2AMLogic/gf180-tmds-tx/signoff/README.md

# Signoff — the block's graded T1 verdict of record

This directory is this repo's **machine-graded** answer to "what is the gap
to T1", produced by `klt signoff --manifest` against the
[klayout-tools design-evidence tier ladder](https://github.com/2AMLogic/klayout-tools/blob/main/docs/design-evidence-tiers.md).
It replaces the hand-maintained checkbox list that used to live in gap-to-T1
tracker issue #17: that issue now points here, and the manifest graded in
`signoff/signoff.json` is the **verdict of record**. Per
`CLAUDE.md`'s evidence rule ("no claim without a testbench"), a prose
checklist nobody re-reads is not a verdict; this is.

## The current verdict (don't hand-transcribe — read the record)

`signoff/signoff.json` is the byte-for-byte stdout of

```bash
klt signoff --manifest signoff/manifest.json --format json
```

as emitted by the graded build pinned below. Exit code `3` is the tool's
documented "rendered but not T1" signal, not an error: `tier` is `null`
until every T1 item is met, which is the honest state for this block today.
As of this commit the grade is **17/22 T1 items met** (per-partition rows,
11 checklist items × `kind: mixed-signal`'s two partitions):

| met | why (the record's own reason, where unmet) |
| --- | --- |
| #3 DRC clean — analog + digital | `klt drc` `status: clean`, layout hash pinned, on both partitions |
| #4 LVS clean — analog + digital | `klt lvs` `status: match` (regenerated 2026-09-21 under the pinned build; identical 0-error verdicts), layout-hash pinned, `input_verified: true` |
| #8 characterization report — analog + digital | the hand-rolled `kind: "generic"` wrapper over `measurements/characterization.md`, its `content_hash` pinned in both the manifest and the envelope |
| #11 power delivery — analog | **`met`** (issue #210, after #207's `unmet` / `supply_not_continuous`). `11.analog` = `layout/erc_reports/gf180_tmds_pad_ring_assembly.erc.json` + the item-4 LVS report, both pinned to the assembly GDS hash. The DVDD ring strap now carries a `VDD` label at two Nwell taps and is tied to real devices (a `diode_pd2nw_06v0` VDD-side clamp per output pad); the ERC report has zero findings, `VDD` and `VSS` each one island, and both `nwell_vdd_tap` and `substrate_vss_tap` checked (none skipped); the LVS reference carries `VDD` and the report pairs it in `net_correspondence`. `VDD` stayed declared throughout — it was neither omitted nor relabelled to turn the row green; the row moved because the geometry and the reference now carry the supply. The ERC reports were produced by a newer `klt` than the pin (the pin cannot produce `well_layer: null` specs) and read by the pinned build; see `../layout/README.md`, "T1 item 11 (analog)" |
| #11 power delivery — digital | **`met`** (issue #206). `klt erc` on `layout/erc-supply-spec.json` now declares both well ties: `erc_finding_count 0`, `erc.missing_tie` for `nwell_vdd_tap` and `lvpwell_vss_tap` both checked and none skipped, pinned to the committed GDS hash. Branch that graded it: **no place-and-route citation, so the PDN branch is not selected** (`power_delivery.pdn: false`; this block's P&R is `flow/pnr_tmds_encoder.py` driving OpenROAD directly and has no `klt place-and-route` response to cite, and none is fabricated). The grader instead takes the ERC + LVS pair: the cited LVS report is the SPICE-reference `layout/lvs_reports/tmds_encoder.lvs.json` (`power_connectivity: unchecked`, but its reference carries `VDD`/`VSS`, `supply_nets` `["VDD","VSS"]`), which suffices on that branch. The gate-level `tmds_encoder_gate.lvs.json` (`match`) is not the cited report |
| #1 design sources — analog + digital | **`met`** via `klt signoff --attest 1` envelopes (`envelopes/item1-{analog,digital}.json`) pinning versioned inventories (`attest/item1-*.json`): each source is present and each derived netlist passes its freshness check. Analog: the xschem schematics/symbols and `design/netlist/*.spice`, stamped after `klt netlist --check` (xschem 3.4.4) matched. **Digital is weaker, and says so:** the encoder RTL and its `.synth.v`/`.pnr.v` netlists are hash-stamped, but Yosys/OpenROAD were *not* re-run (std-cell library absent on the stamping host); the pins rest on flow record `20260817-110611-37e197a`. `rtl/tmds_serializer.v`/`tmds_tx_lane.v` are listed sources with no synthesized netlist (DR-0014). See "Item 1 freshness" below |
| #2 layout — analog + digital | **`met`** via artifact-anchored generic envelopes bound to the committed GDS (`envelopes/item2-{analog,digital}.json`); the row stays `met` only while the stream re-hashes to its pin. **No regeneration claim is made** for either: re-running `gen_pad_ring_assembly.py` gives a different file hash (the GDS header carries a write timestamp) but an empty per-layer XOR; the digital merge step was not re-run (provenance is `layout/README.md`'s documented P&R determinism). The envelopes disclose this |
| #9 testbenches — analog + digital | **`met`** via `klt signoff --attest 9` (`envelopes/item9-{analog,digital}.json`): every `sim/*/testbench` fragment (resp. `verification/*` bench and negative control) is present, the cold-start command exits 0, and the PDK (`gf180mcuD` @ open_pdks `c6d73a35…`) and tool versions are pinned. The analog cold start is `sim/run_corners.py --list` (manifests load); the PVT sweeps need the PDK and ngspice and are **not** re-run — their results are the append-only `sim/*/records/` |
| #10 repo hygiene — analog + digital | **`met`** via `klt signoff --attest 10` (`envelopes/item10.json`, cited for both partitions): README, spec, LICENSE and CI workflow present; `lint.sh` (shellcheck + append-only required) and the two unit-test suites exit 0 |
| #5 corner verification — digital | **`met`** (issue #228). `flow/tmds_encoder/klt_sta.json` is one `klt sta` response over the committed routed DEF + post-route SPEF at all five 3.3 V corners (`pdk.corners`), 720p60 clock (13.4680 ns), zero I/O delay: every corner `timing_status: "constrained"`, setup WNS from +0.281 ns (`ss_125C_3v00`) up, hold WNS from +0.403 ns (`ff_n40C_3v60`) up, `input_verified: true`. Regenerate with `flow/klt_sta_tmds_encoder.py` (its docstring states the one path normalisation applied). Three disclosed limits: (1) `klt sta` cannot express `set_propagated_clock`, `set_driving_cell` or `set_load`, so it does not reproduce `flow/sta_tmds_encoder.py`'s full SDC; the slowest-corner setup slack nonetheless lands within 2 ps of that flow's record (+0.2799 ns); (2) its `spef_annotation` reports `annotation_complete: false` (0 of 377 design nets matched by name) — read the numbers with that in mind; (3) under `klt` 0.8.0 the grader takes several citations for item 5 and requires both kinds, so the zero-delay functional run (`flow/tmds_encoder/klt_fv_zero_delay.json`, 3/3 pass, generated by `flow/klt_fv_tmds_encoder.py`) is now cited alongside the `sta` report (it records no input hash, so the manifest pins its file only). Tool gaps filed as klayout-tools#3741 (one citation) and #3742 (sta constraints / annotation) |
| #7 post-layout — digital | `no_evidence`. `klt functional-verification` with `options.sdf` aborts `vvp` (`NULL handle passed to vpi_scan`) on this netlist + post-route SDF (zero-delay run of the same sources passes; the repo's own `$sdf_annotate` loader in `flow/gate_level_sim_tmds_encoder.py` also passes, but its Markdown record is not a `klt` envelope). Filed as klayout-tools#3740; nothing fabricated to fill the row |
| #6 statistical claims — digital | **`not_applicable`** (issue #296), not `met`: the digital partition has no statistical spec row. `klt` 0.8.0's recorded `not_applicable` form cites `signoff/digital-spec.json` (ratified rows from `spec/tmds-tx.md` §1, DR-0003, DR-0008/DR-0009 and DR-0016) and the statement `signoff/item6-digital-na.json` (one `{id, class, reason}` entry per row), both content-hash pinned in the manifest's `6.digital` entry. The grader's statistical scan passed without any row being reworded. Corner-bounded rows point at item 5.digital; functional rows at `verification/tmds_encoder`. Counted as `t1_not_applicable_count: 1`; `t1_met_count` unchanged |
| #5 (analog), #6 (analog), #7 (analog) | `no_evidence` — the analog corner/Monte-Carlo/post-layout evidence in `sim/` and `flow/` is committed as this repo's own Markdown evidence records, which are not `klt sim`/`klt yield`/`klt pex` JSON envelopes and are rejected by the grader regardless of how sound they are. The grading gap (not the engineering gap) is real and named: see "Why some genuinely-passed work grades unmet" below |

## Partition boundary (the `kind: "mixed-signal"` declaration)

Per `design-evidence-tiers.md`'s "Block kind" subsection, a mixed-signal
claim must state explicitly which silicon each partition's evidence covers:

- **analog partition** — the full-custom CML line driver and the pad ring:
  the driver core (xschem `design/cml_driver.sch` →
  `layout/gds/cml_driver_core.gds`) assembled with the production pad cells
  and `diode_nd2ps_06v0` / `diode_pd2nw_06v0` ESD clamps into
  `layout/gds/gf180_tmds_pad_ring_assembly.gds` — the artifact the
  `*.analog` citations grade. Per-cell signoffs (DRC/LVS/extract report
  pairs with negative controls) and the analog measurement records
  (`sim/cml-driver-*`, `sim/esd-*`) live under `layout/` and `sim/` as
  before.
- **digital partition (RTL flow)** — the synthesized `tmds_encoder`:
  `rtl/tmds_encoder.v` → Yosys → OpenROAD P&R →
  `layout/gds/tmds_encoder.gds`, verified by `verification/tmds_encoder/`
  and `flow/tmds_encoder/` — the artifact the `*.digital` citations grade.
  The `rtl/tmds_serializer.v` reduction stage is RTL in the same flow, with
  its own cocotb bench (`verification/tmds_serializer/`).
- **full-custom digital sub-case** — `tmds_final_mux` (DR-0003's custom
  final 2:1 DDR multiplexer) is *not* synthesized RTL: it is captured as a
  schematic and hand-composed GDS (`design/tmds_final_mux.sch` →
  `layout/gds/tmds_final_mux.gds`), exactly the "Full-custom digital
  sub-case" `design-evidence-tiers.md` defines — its artifacts satisfy the
  analog *column*'s shapes (schematic + GDS + DRC/LVS pairs with negative
  controls) while its silicon belongs to the digital side of the signal
  chain. The manifest's per-partition citations name each partition's
  top-level artifact (the assembled analog signal path, the routed
  encoder); the final mux's own committed signoff pair remains under
  `layout/` and — like every drawn cell's — is machine-checked by the lint
  job's `check_lvs_signoff.py` step on every push.

The partition boundary in the signal chain is the serializer → final-mux →
CML-driver handoff into the pad ring's OUTP/OUTN pair;
`spec/tmds-tx.md`'s decision records (DR-0009, DR-0003, DR-0002) are the
authoritative signal-path description. This manifest's job is narrower:
to state which committed evidence covers which silicon.

## Files

| file | what it is |
| --- | --- |
| `manifest.json` | The block manifest: `block` (fleet-rollup identity for 2AMLogic/2am#956, which consumes exactly this file), required `kind: "mixed-signal"`, and the per-item `evidence` citations with pinned `content_hash` on every one |
| `signoff.json` | The committed evidence record — `klt signoff --format json` output, byte-for-byte as the graded build emitted it |
| `characterization-envelope.json` | Item 8's `kind: "generic"` wrapper (the only T1 item with no `klt` verb), asserting `measurements/characterization.md`'s own verdict — **generated** by `gen_characterization_envelope.py`, never hand-edited |
| `attest/item{1,9}-{analog,digital}.json`, `attest/item10.json` | The versioned attestation inventories `klt signoff --attest` reads (schema `t1-attestation-inventory`); the envelope pins each inventory's raw-byte hash |
| `envelopes/item{1,9,10}*.json` | **Tool-produced** attestation envelopes (`klt signoff --attest N --inventory … -o …`). Never hand-edit |
| `envelopes/item2-{analog,digital}.json` | Artifact-anchored generic envelopes bound to each partition's committed GDS (no producer verb for item 2; written by hand, graded by re-hashing the stream) |
| `derived_stamps.py`, `derived-stamps.json` | The toolchain-free item-1 freshness tripwire (below) |
| `gen_characterization_envelope.py` | Regenerates that envelope deterministically from the committed report; `--check` is the CI mode (the same convention lint step 4 uses for generated DUTs) |
| `../layout/erc-supply-spec.json`, `../layout/drc_reports/`, `../layout/lvs_reports/`, `../layout/erc_reports/` | The cited envelopes. Every manifest citation pins the envelope's own recorded input `content_hash`, and the grader re-hashes the artifact where the envelope names a path (`input_verified: true` on the regenerated LVS citations) |

## The pinned grading build

`klt signoff --manifest`'s grading rules come from the running `klt`
binary, and the eleven-item checklist (item 11, "Power delivery
(structural)", was added 2026-09-17 by klayout-tools#2025) is only graded by
builds newer than the PyPI `0.5.0` release (`0.8.0` grades it). The record's `build` block names
the exact grading code, so the pin is auditable:

- **pin**: `klayout-tools==0.8.0` (PyPI; `klt 0.8.0`, tag `v0.8.0`, commit
  `c572046be644`, `build.is_release: true`; `grading_ruleset_id
  sha256:46c446d84423b7399ee1cf957b3d49801ae4f42a0bda53da92f435776cf977c4`).
  A release pin is preferred over a git pin: a git build reports a dev version
  and no longer satisfies `==0.8.0` (klayout-tools#2823). CI asserts
  `klt --version` prints `klt 0.8.0`. The artifact-anchored generic envelope
  (klayout-tools#2718) and `klt signoff --attest` (klayout-tools#2844) both
  need a build at least this new; the previous pins (a dev-commit
  build after 0.7.0, and before it `e8ca621a`) were git builds
- **Why not PyPI `0.5.0`?** Its bundled tier doc predates item 11, so it
  renders no item-11 row at all, and its grading engine lacks the compound
  erc/lvs/power rules item 11 needs. `--tiers-doc` plus `--describe-grader`
  (see klayout-tools `docs/cli/signoff.md`'s "Identifying the grading
  build") exist to make that divergence visible, but grading against a
  pinned build that actually knows all eleven items is the honest option.
- **Bumping the pin**: when klayout-tools ships a release that changes grading, update the pinned ref below (and in the CI job), re-run the
  regeneration command, and commit the fresh `signoff.json` in the same
  change so the record and the grader never disagree. CI (below) fails the
  build otherwise.

## Regenerating the record

```bash
python3 -m venv .venv-klt && .venv-klt/bin/pip install \
  "klayout-tools==0.8.0"
.venv-klt/bin/pip install -r verification/tmds_encoder/requirements.txt -r verification/tmds_serializer/requirements.txt
export PATH="$PWD/.venv-klt/bin:$PATH"
python3 signoff/gen_characterization_envelope.py   # if item 8's input changed
python3 signoff/derived_stamps.py --refresh        # if a design source/netlist moved (runs klt netlist --check)
klt signoff --attest 1  --inventory signoff/attest/item1-analog.json  -o signoff/envelopes/item1-analog.json    # and the other four
klt signoff --manifest signoff/manifest.json --format json > signoff/signoff.json
# exit 0 (T1) or 3 (rendered, not T1) are both fine; 1 means a malformed
# manifest — fix it, do not commit the error envelope.
```

If a regenerated envelope's recorded input hash moved, sync the manifest's
`content_hash` pin for that item to the new envelope's value in the same
change (a stale pin renders `stale_evidence`, never a false pass).

Run from the repo root: file-backed evidence paths resolve against the
invoking process's working directory (the same convention
klayout-tools `examples/signoff/` documents).

## CI: the record cannot rot

The `signoff` job in `.github/workflows/ci.yml` re-attests items 1, 9 and 10
(`klt signoff --attest N --inventory … --check <envelope>`, which re-runs every
declared command and exits 3 on any drift of an inventory, an inventoried file,
a check outcome or the envelope), runs `derived_stamps.py --check`, then
re-grades the manifest with `klt signoff --manifest … --check signoff/signoff.json`
against the committed record (that mode ignores the `build` block, which names
the install rather than the commit). Anything that would silently invalidate a
published verdict instead breaks the build:

- **a cited artifact changes** (a regenerated GDS, an edited LVS envelope) —
  either the citation's pinned `content_hash` no longer matches the
  envelope's (the item flips `met` → unmet, `stale_evidence`), or the
  envelope no longer matches the artifact on disk (`input_verified` flips
  to `false` in the record, the #2196 disclosure the grader re-hashes for
  native kinds); both change the record bytes, so the byte-compare fails;
- **`measurements/characterization.md` changes** — `klt signoff` never
  re-hashes a generic citation's input (its provenance field names are the
  author's choice by contract), so the same gate is enforced one link
  earlier and mechanically: `python3 signoff/gen_characterization_envelope.py
  --check` fails until the envelope is regenerated (which itself flips the
  item-8 pin to `stale_evidence` until the manifest follows, then the record);
- **the manifest cites something new or drops a citation** — the verdict
  rows themselves change, same failure;
- **the checklist or grader changes under the pin** — `source_doc_content_hash`
  and the `build` block change, same failure.

Fixing it is always the same sequence: regenerate the affected `klt`
envelope(s) under the pinned build (see `layout/README.md` for each cell's
commands), refresh the manifest's pins, re-run the regeneration command, and
commit record + evidence together. Never hand-edit `signoff/signoff.json` —
it is grader output or it is nothing.

## Item 1 freshness: what CI can and cannot prove

`attest/item1-*.json` declare, per derived netlist, a freshness `check`. CI has
no xschem, no PDK and no std-cell library, so that command is
`derived_stamps.py --check --only <row>`: a stdlib hash tripwire over
`derived-stamps.json`, which pins every source and derived file. It fails when
a source or netlist moves without a re-stamp. It does **not** prove the netlist
equals what its generator emits today; that is established when the stamp is
written, by each row's `check_argv` (`klt netlist --check` for the analog rows,
run by `derived_stamps.py --refresh`). The two digital rows have
`check_argv: null` (Yosys/OpenROAD could not be run on the stamping host), so
`--refresh` refuses to re-pin them without `--include-unverified`, and each
row's `basis` field says what its pin rests on. Re-stamp from a host that has
the toolchain and re-run the real flow before relying on those rows.

## Why some genuinely-passed work grades unmet

The grader only recognizes `klt`-native JSON envelopes. This repo's analog
evidence (per-corner sweeps, Monte Carlo, post-layout eye sims) is committed
as `sim/*/records/*.md` evidence records under the append-only
`sim/README.md` schema, and the digital pipeline's records live under
`flow/tmds_encoder/records/` — none of which are `klt sim`/`klt yield`/`klt
pex` envelopes. Items 5, 6 and 7 therefore read `no_evidence` here even
where the engineering is done and recorded. That is the gap being named, not
a verdict that the evidence is unsound: the record says "no `klt` envelope
backs this item", which is true. Closing those rows in *this* artifact means
producing the missing envelope kinds (e.g. a `klt pex` run for item 7) —
separately scoped work in the tracker, not a manifest edit.

## Provenance notes for the reader

- **DRC citations show `input_verified: null`.** The committed `klt drc`
  envelopes were produced by klt 0.2.0/0.3.0-era builds, which recorded the
  layout `content_hash` in `provenance.input` without a resolvable file
  path — the grader re-hashes only what an envelope names, so it reports
  "nothing was re-hashed" (`null`) rather than fabricating verification.
  The pinned layout hashes were verified against the committed GDS files at
  manifest-commit time and match (see the manifest pins; re-checkable with
  `sha256sum layout/gds/*.gds`).
- **LVS envelopes cited here were regenerated 2026-09-21** under the pinned
  build, because the previously committed envelopes (klt 0.3.0) recorded
  their input hash in `environment.layout_sha256` rather than
  `provenance.input`, which post-#1969 builds (and this manifest's pinned
  citations) require — a pinned citation against the old shape renders
  `unverifiable_provenance` no matter how sound the report is. The
  regeneration reproduced the committed verdicts exactly (`match`, 0 errors,
  the pad ring's same 2 warning-only topology findings; the encoder side
  0 findings). Envelope delta vs the committed pair is additive only:
  `provenance.input`, `power_connectivity` (`unchecked`, plain-element
  reference — "does not apply" per the grader's own note), `body_verification`,
  `supply_nets` echo. Deck `content_hash` moved
  `79e71a1e…` → `95c2eb91…` and the resolved KLayout engine reported
  `0.30.12` (the pinned build was tested against `0.30.10` — "verdict
  itself is unaffected" per the tool's own warning); both are tool-side
  churn, recorded here rather than left for the next reader to rediscover.
  The `_shorted`/`_negctl` negative-control reports are untouched and
  still guard the same verdicts via `layout/scripts/check_lvs_signoff.py`.
