2AMLogic/gf180-tmds-tx/design/esd-capacitance-budget.md

# ESD clamp sizing vs. the DR-0005/DR-0011 capacitance budget — a measurement study

Status: measurement study, originally for issue #12 (2026-08-14 operator
ruling on that issue), **redesigned and re-measured for issue #87**
(2026-08-19) against DR-0011's ratified pad/ESD strategy. **Not a decision
record and makes no change to `spec/`.** Per the original operator
guardrail (still honoured here — issue #87's own guardrails restate it: "no
spec edits"), this document reports whatever the real, measured numbers say
and does not revise DR-0005/DR-0011 to make them work; it happens that,
once a real-size pad and a real DR-0011-ratified diode clamp are actually
drawn and measured (Sec.9), the numbers close the budget on their own —
that is a measurement result, not a relaxation.

**2026-08-19 (issue #87) headline correction, read this first**: Sec.4b's
original "realistic 25×25 µm pad" figure below — reported as **6.36–7.13
pF**, driving the document's original **7.95 pF** total and its "no
intersection" verdict — carried a **units-label error**: the arithmetic
itself (in `aF`, the PDK tech file's own native unit) was correct, but its
final line divided by 1,000 (`aF`→`fF`) and then wrote the answer as
**`pF`** instead of `fF`, overstating every headline figure in Sec.4b/5 by
**exactly 1000×**. **Sec.9.1** below shows the correct arithmetic and an
independent, real `klt extract --parasitics` measurement against an
actually-drawn 25×25 µm Metal5 pad (not available when this document was
first written) that confirms the corrected value to within 0.02%: the real
figure is **6.36–7.13 fF** (0.00636–0.00713 pF), not pF — roughly three
orders of magnitude *under* the 2 pF budget, not 3.2–3.6× over it. Sections
0–8 below are preserved verbatim as the historical record of that
measurement study and its (mistaken) conclusion; they are superseded by
Sec.9's correction and redesign, not deleted, per this directory's
evidentiary conventions. **Sec.9 is this document's current, authoritative
verdict** — read it for the issue #87 redesign result.

## 0. What this document answers, and what it does not

DR-0005 (`spec/tmds-tx.md`) sets two targets and explicitly declines to
show they are simultaneously achievable:

- **ESD**: HBM ≥ 2 kV (JEDEC JS-001), CDM ≥ 500 V (JEDEC JS-002).
- **Pad capacitance**: ≤ 2 pF per data/clock pad, *"ESD diodes + pad
  parasitic combined"*.

The 2026-08-14 operator ruling on issue #12 narrows the original four-part
architect proposal to exactly this: size the ESD clamp **that is actually
drawn** on the real pad cell from issue #2
(`layout/gds/gf180_tmds_pad_min.gds`) against the HBM/CDM targets, measure
the resulting pad-node capacitance (clamp + real Metal5 pad) against the
2 pF budget, and report a verdict. The clamp on that cell is a
grounded-gate NMOS (GGNMOS), not the diode primitives DR-0005's original
text named — `spec/pad-ring-esd-survey.md` §4 explains why (`klt`'s
gf180mcu extraction deck has no diode device class,
[2AMLogic/klayout-tools#541](https://github.com/2AMLogic/klayout-tools/issues/541)),
and the operator ruling settles the device-family question directly from
the real, already-built cell rather than waiting on a separate
decision-record issue.

**Out of scope here** (per the ruling): a `gf180mcuC`-vs-`gf180mcuD` metal-
stack comparison curve, a formally uncertainty-budgeted pad-parasitic
estimate, and redesigning the clamp device family. This document does not
attempt any of those.

**Verdict, up front** (derived in §5): the ESD side of the budget is easy
to satisfy — a clamp sized generously past JEDEC JS-001's 2 kV target costs
well under 1 pF at every PVT corner measured. The budget is not closed by
the clamp. It is closed, decisively, by the **pad's own parasitic
capacitance once any realistic bond-pad size is used** — a plain Metal5
plate at the PDK's own established 25×25 µm bond-pad-opening size already
costs 6.4–7.1 pF, more than three times the entire 2 pF budget, before any
clamp capacitance is added. Under the literal as-drawn pad geometry (a
0.62×1.00 µm via-landing square, not a real bond pad — `spec/pad-ring-esd-
survey.md` §4 flags this explicitly), the two targets *do* coexist with
large margin. **The honest, realistic-pad-size reading is a "no
intersection" result, and per the guardrail it is reported here rather
than used to revise DR-0005.**

> **Superseded 2026-08-19 (issue #87) — this verdict was a units-label bug,
> not a real result.** "6.4–7.1 pF" above should read "6.4–7.1 **fF**"; see
> the header correction and Sec.9.1 for the arithmetic and an independent
> real-tool measurement confirming it. The realistic-pad-size reading is,
> correctly measured, a **large-margin PASS**, not a "no intersection" —
> Sec.9 is the current verdict.

## 1. Establishing the simulatable device (blocking step, per the issue)

### 1a. Sizing interpretation

The real pad cell's clamp is drawn at `L=0.4U W=2U`
(`layout/gds/gf180_tmds_pad_min.spice`, `layout/lvs/gf180_tmds_pad_min.ref.spice`)
— below the PDK's own `ESD.pl` rule, a 0.8 µm minimum gate length for a
"5V/6V gate NMOS" ESD device (`spec/pad-ring-esd-survey.md` §2, citing
`libs.tech/klayout/tech/drc/rule_decks/esd.drc`). The cell also draws no
`Dualgate` implant layer at all (`layout/scripts/gen_pad_min.py` only
touches `Comp`/`Poly2`/`Nplus`/`Contact`/`Metal1-5`) — i.e. as drawn today
it is a plain 3.3 V-core-device-scaled NMOS wired as a GGNMOS, not a real
5V/6V ESD-implant device at all. `ESD.pl` strictly speaking governs the
latter, not the former.

**Interpretation used here**: re-size the clamp freely (both `W` and `L`),
keeping its topology (drain=`PAD`, gate=source=body=`VSS`) and its device
family (3.3 V core NMOS — see §1b for why no 5/6V-implant alternative is
available), but **grow `L` to the `ESD.pl` floor (0.8 µm)** as the closest
available PDK guidance for an ESD-role NMOS gate length, even though this
device does not carry the ESD-implant layer that rule technically
addresses. This is the more conservative of the two readings the issue's
curated body offered (either is acceptable) — it does not just accept the
under-`ESD.pl` `L=0.4 µm` as-drawn value for the sizing exercise. Every
device swept in this study (§3) other than the literal as-drawn baseline
uses `L=0.8 µm` for this reason.

### 1b. Model-card mapping

`layout/gds/gf180_tmds_pad_min.spice`'s extracted netlist and
`layout/lvs/gf180_tmds_pad_min.ref.spice`'s LVS reference both call the
device model `nfet` — `klt`'s internal LVS device-class label, not a
citable ngspice model card.

**Mapping used here: `nfet` → `nfet_03v3`**
(`libs.tech/ngspice/sm141064.ngspice:47042`, the PDK's 3.3 V core NMOS
subcircuit). Rationale:

- The cell as drawn carries no `Dualgate` layer (§1a), so electrically it
  is built from 3.3 V core-device layers, not the PDK's 5V/6V devices
  (`nfet_05v0`/`nfet_06v0`, `sm141064.ngspice:47099`/`:47125`) — mapping it
  to the 3.3 V model is the mapping that matches what is actually drawn,
  not an arbitrary default.
- `design/netlist/cml_driver.spice` (issue #11) already uses `nfet_03v3` at
  a comparable `L` scale for this block's other custom silicon, so this is
  a reused mapping decision, not a new one.
- The PDK ships **no** dedicated ESD-implant/ESD-clamp SPICE model at all —
  confirmed by grepping `sm141064.ngspice` for `esd`/`ggnmos`/`clamp`/
  `snapback`/`trigger`: zero matches. There is no more-specific citable
  model to prefer over `nfet_03v3` even if the sizing interpretation in
  §1a had gone the other way.

This mapping decision, and the `ESD.pl`-floor gate length from §1a, are
what every simulated result in §3 is measured against — stated and sourced
before any sweep result, per the issue's blocking-step requirement.

## 2. ESD sizing, honestly bounded (design-margin estimate, not qualification)

**This section is a design-margin estimate, not an ESD qualification.**
This repo has no tester and no parts; `measurements/` stays empty by
design until tape-out, per CLAUDE.md and the issue's own framing. Every
number below is either cited to a file/line in the installed PDK or
explicitly marked as drawn from general ESD-design literature, not the
PDK.

### 2a. What the PDK's own sources say (and are silent on)

- `libs.tech/klayout/tech/drc/rule_decks/esd.drc`'s `ESD.*` rules
  (`spec/pad-ring-esd-survey.md` §2) are real, checkable geometry rules for
  an ESD-implant-based device (minimum implant width/area, gate length,
  overlaps) — but say nothing about failure current, breakdown voltage, or
  snapback/trigger behavior.
- `libs.tech/ngspice/sm141064.ngspice` (the PDK's ngspice model library)
  has zero ESD-specific device models or parameters (§1b). Its BSIM4
  `nfet_03v3` model cards do carry a gate-oxide thickness
  (`toxe=8e-9` m, `sm141064.ngspice:795` in the `nfet_03v3.0` bin) usable
  for an order-of-magnitude gate-oxide-rupture estimate (§2c), but no
  drain-junction avalanche/secondary-breakdown current-density data, no
  TLP (transmission-line-pulse) I-V data, and no parasitic-BJT
  snapback/holding-voltage parameters — all of which a real GGNMOS ESD
  sizing exercise needs and which this PDK does not provide.
- **The PDK source is silent on ESD device failure behavior.** This
  extends explicitly to the GGNMOS clamp actually in use, per this issue's
  plan.

### 2b. HBM sizing (quantitative, current-density-based)

**Network**: JEDEC JS-001 human-body-model network — 100 pF charged to the
target voltage, discharged through a 1500 Ω series resistor into the DUT.
**Not sourced from the gf180mcu PDK** (which defines no ESD test networks
at all) — this is the JEDEC JS-001 standard's own fixed network, external
to this PDK.

**Peak current** (first-order estimate): `I_pk = V_HBM / R = 2000 V /
1500 Ω = 1.333 A`. This is the standard textbook first-order estimate
(peak of the idealized double-exponential HBM discharge waveform); a real
tester's waveform typically peaks somewhat below `V/R` because of finite
rise time, so `V/R` is the more conservative (larger, hence larger
required clamp width) of the two figures a first-order analysis would
produce.

**Failure threshold / current density**: the gf180mcu PDK is silent on
this (§2a). **Explicitly unsourced from the PDK**: this document adopts a
commonly cited range from general ESD-design literature for a salicided-
drain grounded-gate NMOS *without* a dedicated ESD implant — roughly
**2–6 mA/µm of drain width** HBM failure-current density (a range
frequently cited in ESD-design references such as Amerasekera & Duvvury,
*ESD in Silicon Integrated Circuits*, and Voldman, *ESD: Circuits and
Devices*; no specific edition/page is cited here because this document has
no access to page-level citation and is deliberately marking this as an
external, not-PDK-sourced assumption rather than presenting it as if it
had one). The clamp as drawn carries no ESD implant (§1a), so the
lower-robustness end of this range (without the ESD-implant improvement a
real `ESD.*`-compliant device would add) is the more defensible one to
design against.

**Required width**: `W = I_pk / density`:

| Assumed density | Required total width `W` |
|---|---|
| 6 mA/µm (favorable end) | 222 µm |
| 3 mA/µm (mid-range) | 444 µm |
| 2 mA/µm (conservative end) | 667 µm |

§3 simulates capacitance at 222 µm and 444 µm directly and reports 667 µm
by linear extrapolation (the simulated curve is effectively linear in
width — see §3c) rather than re-running the matrix a third time.

### 2c. Secondary constraint: clamping voltage (qualitative)

A complete first-order sizing also has to check that the clamp's *on-state
voltage drop* during the 1.33 A HBM pulse keeps the pad below the
breakdown voltage of whatever it protects (here: the gate oxide of any
other device tied to the same pad net). This requires the clamp's
on-resistance/holding-voltage during ESD conduction (parasitic-BJT
snapback behavior) — data this PDK does not provide (§2a). As an
order-of-magnitude cross-check only: `nfet_03v3`'s own `toxe=8 nm` gate
oxide, combined with a commonly cited SiO2 breakdown field of roughly
8–10 MV/cm (**general dielectric-breakdown literature, not the gf180mcu
PDK**), implies a rupture voltage on the order of 6.4–8 V for a directly
stressed gate — comfortably above a well-sized GGNMOS's typical few-volt
snapback holding voltage, but this document cannot verify the actual
clamping voltage without on-resistance/holding-voltage data the PDK does
not supply. **Marked explicitly as an unverified design-margin note, not a
result.**

### 2d. CDM — a turn-on/di-dt requirement, not a second peak-current number

Per the issue's plan, CDM 500 V (JEDEC JS-002) is treated as a different
kind of problem: a fast (sub-nanosecond), package- and tester-dependent
discharge that stresses the clamp's **turn-on speed** (how fast the
parasitic-BJT snapback triggers) far more than its average current
handling. A GGNMOS's CDM robustness is governed by trigger voltage and
turn-on delay, which require either TLP characterization or mixed-mode
TCAD data — neither of which the open gf180mcu PDK provides (§2a: zero
snapback/trigger parameters in `sm141064.ngspice`; no `ESD.*` electrical
data, only geometry rules, in the DRC deck). **This document reports no
CDM-driven width number.** "The source is silent" is the finding here,
exactly as the issue's plan anticipated as a legitimate outcome.

## 3. Clamp capacitance vs. size, at 0 V and at the TMDS operating bias, full PVT

### 3a. Testbench

`sim/esd-clamp-cv/testbench/esd_clamp_cv.spice` (manifest:
`sim/esd-clamp-cv/testbench/tb.json`). Twelve independent branches — six
device sizes × two DC bias states — each its own AC voltage source driving
its own `nfet_03v3` instance (drain=probed node, gate=source=body=`VSS`),
so one ngspice invocation per PVT point measures the whole curve with no
cross-loading between branches.

**Devices simulated**:

| Label | `L` | Total `W` | `nf` (finger count) | Note |
|---|---|---|---|---|
| `base` | 0.4 µm | 2 µm | 1 | as-drawn today, verbatim `AS`/`AD`/`PS`/`PD` from `layout/lvs/gf180_tmds_pad_min.ref.spice` |
| `w2` | 0.8 µm | 2 µm | 1 | `ESD.pl`-floor `L`, as-drawn `W` |
| `w20` | 0.8 µm | 20 µm | 10 | |
| `w100` | 0.8 µm | 100 µm | 50 | |
| `w222` | 0.8 µm | 222 µm | 111 | 6 mA/µm HBM-density estimate (§2b) |
| `w444` | 0.8 µm | 444 µm | 222 | 3 mA/µm HBM-density estimate (§2b) |

Every device's per-finger width is held at 2 µm (matching the drawn cell)
so every device sits in the same BSIM4 model bin (`nfet_03v3.9`, `L`
∈[0.5,1.2) µm × `W` ∈[1.2,10) µm, `sm141064.ngspice`) across the whole
sweep — this avoids a bin-boundary discontinuity artifact in the curve and
keeps every finger inside the model's own characterized width range
(`wmax`=100 µm per bin; a naive single-finger `W=444 µm` instance is
outside every bin and ngspice refuses to resolve a model for it — confirmed
directly by trying it before adopting the multi-finger form).
`AS`/`AD`/`PS`/`PD` scale linearly with total width from the drawn cell's
own per-µm source/drain diffusion depth (1 µm): `AS=AD=W×1µm`,
`PS=PD=2×(W+1µm)` — i.e. total diffusion area/perimeter as one equivalent
non-fingered strip, not a specific real many-finger layout (a real
interdigitated layout could read higher or lower than this depending on
how much source/drain diffusion adjacent fingers share — this is a
reasonable first-order estimate, not a layout deliverable, and is not
claimed to be a bound in either direction).

**Bias**: `DC=0` is the "easy to quote" reference point on every device.
`DC='vdd_val'` reuses the harness's own supply-tolerance PVT axis
(2.97/3.30/3.63 V) as the TMDS operating-bias proxy. This is a direct,
sourced choice, not an arbitrary stand-in: DR-0006 (`spec/tmds-tx.md`)
already establishes that this driver's DC-coupled, open-drain-to-`AVCC`
topology makes the pad's common-mode voltage track the supply rail at
approximately 1:1 (confirmed directly against `design/cml-driver-
sizing.md` §8 and `sim/cml-driver-eye/records/20260810-041436-a2c358b.md`'s
own `vcm_avcclo`/`vcm_avcchi` columns) — so sweeping `vdd_val` across the
mandated ±10 % supply corners *is* sweeping the pad's real operating bias
across its DR-0006-ratified 2.711–3.384 V envelope (which itself brackets
DR-0002's nominal 2.8–3.3 V window), at every PVT point, using the same
grid axis the harness already runs for every other record.

**Extraction method**: small-signal AC analysis, single point at 100 MHz
(`ac lin 1 100meg 100meg`), `C = |Im(I)| / (2π·f·1V)` from each branch's
1 V AC probe current. 100 MHz is far below any intrinsic RC pole of these
devices — `klt`'s own extracted parasitic resistance for the drawn cell's
`PAD` net is 0.145 Ω (§4a), and even the largest simulated capacitance
(≈0.93 pF) against gate/diffusion resistances of order tens of ohms
implies a pole in the multi-GHz range, so the measured value is the
device's incremental capacitance, not a frequency-dependent artifact.

### 3b. Results (full PVT matrix)

Record: `sim/esd-clamp-cv/records/20260814-193222-dd48630.md`. Corner
matrix: process ∈ {tt, ff, ss, fs, sf} (the `mos` corner set — same subset
choice `sim/cml-driver-eye`'s record for issue #11 already used as its
"full PVT matrix" reading; see that record's own "Corner matrix run"
field) × temperature ∈ {−40, 27, 125} °C × supply ∈ {2.97, 3.30, 3.63} V —
45 points, 45/45 `ok`. All twelve measurements at every corner in the
record; summarized here:

| Device | 0 V, min–max (binding corner) | Operating bias, min–max (binding corner) |
|---|---|---|
| `base` (as-drawn) | 3.856–4.544 fF (min `ff_-40c`, max `ss_125c`) | 2.416–2.748 fF (min `ff_-40c_3.63v`, max `ss_125c_2.97v`) |
| `w2` | 3.856–4.540 fF | 2.416–2.748 fF |
| `w20` | 35.85–42.41 fF | 21.87–24.92 fF |
| `w100` | 178.1–210.7 fF | 108.4–123.4 fF |
| `w222` | 394.9–467.4 fF | 240.2–273.7 fF |
| `w444` | 789.6–934.4 fF | 480.2–547.1 fF |

**Binding corner (worst-case, i.e. largest capacitance) across every
device and both bias points: `ss` process, 125 °C, 2.97 V supply**
(`ss_125c_2.97v`) — slow/high-temperature widens junction capacitance, and
the lowest supply corner minimizes the operating-bias device's reverse
bias, both pushing capacitance up together. This is the single corner-id
this document cites for every "worst-case" number below.

**Which bias point the budget is graded on, and why**: the operating-bias
number, not the 0 V number. DR-0005's 2 pF budget exists *"to preserve
742.5 Mbps eye margin"* — i.e. it is a constraint on the capacitance the
driver's edges see while driving data, which is the pad sitting near its
DR-0006 operating common-mode point, not near 0 V. 0 V would only be
physically relevant to an actual ESD strike transient, a completely
separate regime this document does not model (§2). Every "the clamp costs
X pF" figure in §5's verdict uses the operating-bias, `ss_125c_2.97v`
column.

### 3c. Linear extrapolation to the 2 mA/µm (667 µm) HBM case

The curve above is effectively linear in total width (junction area,
perimeter, and gate overlap all scale linearly with a fixed per-finger
geometry replicated `nf` times) — confirmed directly: `w444`'s
operating-bias worst-case value (547.1 fF) is `444/222 = 2.0×` `w222`'s
(273.7 fF) to within 0.03 %. Linearly extrapolating `w444`'s worst-case
values by `667/444 = 1.502×`:

- 0 V, worst case: 934.4 fF × 1.502 ≈ **1.404 pF** (extrapolated, not simulated).
- Operating bias, worst case: 547.1 fF × 1.502 ≈ **0.822 pF** (extrapolated, not simulated).

Both remain under the entire 2 pF budget on their own, at the most
pessimistic HBM-density assumption in §2b's range.

## 4. Pad parasitic capacitance

DR-0005's 2 pF budget is *"ESD diodes + pad parasitic combined"* — §3
covers the clamp; this section covers the Metal5 pad itself, separately.

### 4a. Literal drawn geometry — `klt`-extracted (not an analytic estimate)

**Correction to the issue's own inherited framing**: the original
architect proposal text (preserved at the bottom of issue #12) states
*"Parasitic extraction is not available in the toolchain today"* and
`spec/pad-ring-esd-survey.md` §7/§8 (written for issue #2) likewise
describes no such capability. **That is no longer accurate against the
installed `klt` 0.2.0** — `klt extract --parasitics` (added by
`2AMLogic/klayout-tools#217`, closed 2026-08-01, before this issue's own
2026-08-14 curation pass) exists and works against this exact cell:

```
$ klt extract --deck gf180mcu --parasitics --pdk gf180mcuD \
    layout/gds/gf180_tmds_pad_min.gds --format json
...
"parasitics": {
  "nets": [
    {"net": "PAD", "resistance_ohm": 0.1452, "capacitance_ff": 0.146356},
    {"net": "VSS", "resistance_ohm": 43.466, "capacitance_ff": 0.534782}
  ]
}
```

**The real, `klt`-extracted `PAD`-net parasitic capacitance of the literal
as-drawn cell is 0.146 fF (0.000146 pF)** — negligible against the 2 pF
budget, five orders of magnitude below it, regardless of process corner.
This is a first-order lumped estimate (`klt`'s own curated sheet-
resistance/capacitance table), not a full field solve, but it is a real
tool-measured number against the real drawn geometry, not the analytic
estimate the issue anticipated might be necessary. `spec/pad-ring-esd-
survey.md` §4 is explicit that this shape — `0.62×1.00 µm`, the via-landing
square only — is *"sized generously above every rule `klt`'s gf180mcu deck
checks... not proving area efficiency"* and is **not a real bond-pad
footprint**; that caveat is restated here in full per the issue's explicit
instruction not to report this number without it.

**Cross-check**: computing the same quantity by hand from the PDK's own
`libs.tech/magic/gf180mcuD.tech` `defaultareacap`/`defaultperimeter`
coefficients for Metal1 (the layer dominating this tiny via-stack's
capacitance to substrate, being the closest layer: nominal corner
`29.304 aF/µm²` area, `39.431 aF/µm` perimeter — file citation, "taken
directly from the source document PDS_035_03, in units of aF/um^2 for area
caps and aF/um for perimeter and sidewall caps" per that file's own header
comment at line 3175) against the drawn `0.62×1.00 µm` footprint:
`0.62×1.00×29.304 + 2×(0.62+1.00)×39.431 ≈ 18.2 + 127.8 = 146.0 aF` —
**0.146 fF, matching the `klt`-extracted value to within 0.3 %.** This
agreement is a real, independent cross-validation of both methods, and is
why §4b below reuses the same magic-tech-file coefficients (rather than a
fresh, unvalidated method) for the case `klt` cannot extract directly.

### 4b. Realistic bond-pad-sized assumption — analytic (PDK-cited coefficients)

`klt` can only extract capacitance from geometry that is actually drawn;
`gf180_tmds_pad_min.gds` draws only the tiny via-landing square, not a real
bond pad, so there is no larger real-pad geometry to run `klt` against
without drawing new layout (out of scope for this measurement-only issue —
see the issue's explicit exclusion of "a separate, formally-uncertainty-
budgeted analytic estimate," which this is not: it is a single,
PDK-cited coefficient lookup against one stated, precedented area, not a
new uncertainty model).

**Area assumption**: 25×25 µm² — the gf180mcu_fd_io I/O library's own
established bond-pad opening size (`spec/pad-ring-esd-survey.md` §1, citing
`libs.ref/gf180mcu_fd_io/lef/gf180mcu_fd_io__bi_t.lef`'s `PAD` pin: `RECT
25.000 20.000 50.000 45.000`). This is explicitly the **stated realistic
bond-pad-sized assumption** option the issue's curated body names as
acceptable (as an alternative to the literal drawn shape), cited directly
to the PDK's own shipped library rather than invented.

**Method**: the same `defaultareacap`/`defaultperimeter` Metal5
coefficients validated in §4a, applied to a 25×25 µm² (625 µm² area,
100 µm perimeter) Metal5-only plate — a **lower bound** for a real bond
pad, since the PDK's own reference bond-pad structure
(`Bondpad_5LM`, `spec/pad-ring-esd-survey.md` §1) is a redundant
Metal1-through-Metal5 via lattice, not a Metal5-only plate; the lower
metals in a real structure sit much closer to substrate (Metal1's own
area-cap coefficient is over 5× Metal5's, per §4a) and would only add
capacitance, not remove it. **Explicitly marked analytic, not extracted**,
per `libs.tech/magic/gf180mcuD.tech`'s three named process corners:

| Corner (`gf180mcuD.tech` block) | Metal5 area coeff. | Metal5 perimeter coeff. | 25×25 µm² pad capacitance |
|---|---|---|---|
| Minimum (`hrlc`/`lrlc`) | 5.414 aF/µm² | 29.752 aF/µm | 625×5.414 + 100×29.752 = 6358.95 aF ≈ **6.36 pF** |
| Nominal | 5.798 aF/µm² | 30.386 aF/µm | 625×5.798 + 100×30.386 = 6662.9 aF ≈ **6.66 pF** |
| Maximum (`hrhc`/`lrhc`) | 6.240 aF/µm² | 32.259 aF/µm | 625×6.240 + 100×32.259 = 7125.9 aF ≈ **7.13 pF** |

**A realistic 25×25 µm bond pad on Metal5 alone costs 6.4–7.1 pF** —
**3.2–3.6× the entire 2 pF DR-0005 budget, before adding any clamp
capacitance at all**, and this is a lower bound against the PDK's own
reference multi-layer bond-pad structure.

> **Correction, 2026-08-19 (issue #87): units-label error, not a real
> result.** Every number in the table and the paragraph above is
> mislabelled by exactly 1000×. The arithmetic is right *in `aF`* — e.g.
> "625×5.798 + 100×30.386 = 6662.9 aF" is correct — but the line then
> divides by 1,000 (the correct `aF`→`fF` step) and writes the result as
> **`pF`**. `6662.9 aF ÷ 1000 = 6.6629 **fF**` (0.0066629 pF), not "6.66
> pF". The same slip repeats for all three corners and for the "6.4–7.1
> pF"/"3.2–3.6×" summary above: it should read **6.4–7.1 fF**, roughly
> **300×  *under*** the 2 pF budget, not 3.2–3.6× over it. Confirmed two
> independent ways in Sec.9.1: by re-deriving the same `aF`→`fF` arithmetic
> `klt` used correctly one paragraph earlier in Sec.4a's own cross-check
> (which this table's final line failed to copy), and by an actual
> `klt extract --parasitics` run against a real, drawn 25×25 µm Metal5
> square (not available to draw against when this section was first
> written, since no realistic-size pad geometry existed yet) —
> `6.66235 fF`, matching the corrected nominal-corner hand figure to
> 0.02%.

## 5. Budget split and verdict

Total pad-node capacitance = clamp (§3, operating-bias-graded,
`ss_125c_2.97v` binding corner) + pad parasitic (§4).

Clamp figures below span the §2b HBM-sizing window (222–667 µm total
width, i.e. the 6/3/2 mA/µm density range), operating-bias-graded,
`ss_125c_2.97v` binding corner throughout: **0.240 pF** (222 µm, best-case
corner low end) up to **0.822 pF** (667 µm extrapolated, worst-case corner
high end). The as-drawn `base` device (2 µm, which does not come close to
meeting HBM ≥ 2 kV — that is the entire reason to grow it) costs an
even smaller 0.00242–0.00275 pF and is not part of the sizing window.

| Pad-area reading | Clamp (§3, 222–667 µm HBM window) | Pad parasitic (§4) | Total (worst case) | vs. 2 pF budget |
|---|---|---|---|---|
| Literal drawn (0.62×1.00 µm) | 0.240–0.822 pF | 0.000146 pF | 0.822 pF | **Fits, large margin (1.18 pF headroom, 59 %)** |
| Realistic bond pad (25×25 µm) | 0.240–0.822 pF | 6.36–7.13 pF | 7.95 pF | **Fails by 5.95 pF (4.0× over budget)** |

**Verdict: the ESD and capacitance targets do not coexist under any
realistic bond-pad size, and this document reports that shortfall rather
than revising DR-0005, per the operator's guardrail.**

The two readings above are both computed honestly and both cited; they
disagree by roughly four orders of magnitude in the pad term because the
literal drawn geometry is not a real bond pad (§4a explicitly restates this
caveat) and the realistic reading is. Per the issue's own framing, *"a
positive result obtained by... measuring the pad's literal 0.62×1.00 µm
via-landing shape as if it were a real bond pad, is not"* a valid outcome
— so the literal-geometry row is reported for completeness and cross-
validation, but the **graded, honest verdict is the realistic-bond-pad
row: no intersection.**

This is a materially different finding than DR-0005's original framing
anticipated. DR-0005 frames the tension as *"larger ESD diodes buy more
HBM/CDM margin at the cost of capacitance that closes the eye"* — i.e. a
clamp-sizing trade-off. §3 shows the clamp side of that trade-off is not
actually tight: even the most conservative HBM-density assumption in this
document's range costs under 0.85 pF, leaving over 1 pF of the 2 pF budget
unused by the clamp alone. **The budget is closed by the pad's own
parasitic capacitance, not by clamp sizing** — a different problem than
the one DR-0005 poses, and one this document recommends the operator weigh
directly: DR-0005's ≤2 pF figure may need to be revisited against what a
real bond pad actually costs, independent of any ESD-clamp trade-off,
rather than as a clamp-vs-capacitance trade-off. That recommendation is
offered here as input; per the guardrail, this document does not act on it.

> **Correction, 2026-08-19 (issue #87): the "Fails by 5.95 pF" row above
> inherits Sec.4b's units-label bug.** With the pad-parasitic term corrected
> to fF (Sec.4b's callout, Sec.9.1), the realistic-bond-pad row's total is
> **0.240–0.822 pF** (dominated entirely by the clamp; the pad-parasitic
> term, 0.0000064–0.0000071 pF, is negligible against it) — comfortably
> *inside* the 2 pF budget, with 1.18–1.76 pF of headroom (59–88%), not a
> "no intersection". The two DR-0005 targets *do* coexist at a realistic
> pad size, on this GGNMOS clamp's own already-real, already-PVT-swept
> numbers (Sec.3) — no clamp resizing or GGNMOS-vs-diode substitution
> needed to reach that conclusion; §3's own numbers already supported it,
> it was Sec.4b's arithmetic-label error alone that hid it. Sec.9 re-derives
> this cleanly against the issue #87 redesign (a real 25×25 µm pad, DR-0011's
> ratified diode clamp instead of this GGNMOS, and a real substrate tap) and
> is this document's authoritative, current verdict.

## 6. `klt` coverage limitations relevant to this result

Restated here per the issue's requirement that a verdict's blind spots
travel with it, not be left to the reader:

- **`klt drc --deck gf180mcu` implements none of the `ESD.*` rules**
  (`spec/pad-ring-esd-survey.md` §5) — the curated deck's own module
  docstring describes itself as covering poly2/comp/contact/metal1
  (extended to metal2/3/5/metaltop and the MiM stack) plus one Nwell and
  one BJT rule, explicitly not Pplus/Nplus implant rules, LVPWELL/DNWELL,
  or any 5V/6V/dualgate/ESD-implant variant. A "DRC-clean" result against
  this deck for an ESD-implant-based device (not applicable to the clamp
  actually in use, which carries no ESD implant at all — §1a) would not
  mean clean against the PDK's real ESD design rules.
- **`klt extract --deck gf180mcu` has no diode device class**
  (`spec/pad-ring-esd-survey.md` §7 item 2,
  [2AMLogic/klayout-tools#541](https://github.com/2AMLogic/klayout-tools/issues/541)) —
  irrelevant to this document's GGNMOS clamp directly, but is *why* the
  clamp is a GGNMOS rather than DR-0005's originally named diode
  primitives in the first place, so it is load-bearing context for every
  number in this document.
- **`klt extract --parasitics` (§4a) is a first-order lumped-RC estimate**
  (one series R + one ground C per net, from a curated sheet-resistance/
  capacitance table), not a full field solve — appropriate for the
  order-of-magnitude cross-check this document uses it for, but not a
  signoff-grade parasitic extraction. It also only ever measures geometry
  that is actually drawn; it cannot answer the §4b realistic-bond-pad
  question directly, which is why that number is analytic instead (and
  explicitly marked as such).
- **No PDK/tool source in this repository's reach characterizes ESD
  failure current density, breakdown voltage, or snapback/trigger
  behavior for any device family** (§2a) — every number in §2 is either a
  PDK-geometry citation or an explicitly external, not-PDK-sourced
  literature assumption. No new `2AMLogic/klayout-tools` issue is filed
  for this: it is a PDK/model-content gap, not a `klt` tool gap (§2a).

## 7. Links

- Design doc: this file.
- Sizing/HBM inputs: `spec/pad-ring-esd-survey.md` §1–§3, §8; `spec/tmds-
  tx.md` DR-0002, DR-0005, DR-0006.
- Real pad cell: `layout/gds/gf180_tmds_pad_min.gds`,
  `layout/scripts/gen_pad_min.py`, `layout/lvs/gf180_tmds_pad_min.ref.spice`.
- Clamp capacitance testbench: `sim/esd-clamp-cv/testbench/esd_clamp_cv.spice`,
  `sim/esd-clamp-cv/testbench/tb.json`.
- Clamp capacitance record: `sim/esd-clamp-cv/records/20260814-193222-dd48630.md`.
- Eye-margin precedent (cited, not re-derived): `design/cml-driver-
  sizing.md` §5/§7/§8, `sim/cml-driver-eye/records/20260810-041436-a2c358b.md`.
- Model-card mapping precedent: `design/netlist/cml_driver.spice`.
- Friction-protocol citations: `2AMLogic/klayout-tools#541` (diode device
  class), `2AMLogic/klayout-tools#217` (parasitics capability this
  document uses and which corrects the issue's inherited "not available"
  framing).

## 8. Guardrail compliance

**No file under `spec/` is touched by this change.** The verdict in §5 is
a "no intersection under a realistic pad-size assumption" result, reported
with its full evidence per the operator's 2026-08-14 guardrail ruling on
issue #12. This document does not revise DR-0005, does not open a new
decision-record issue on its own authority, and explicitly recommends (§5)
that the pad-vs-clamp trade-off this finding implies be routed back to the
operator as input, not decided here.

*(Sections 0–8 above are the original issue-#12 measurement study and are
preserved verbatim as historical evidence, per this repository's
append-only-evidence convention — corrected in place only where a callout
is inserted, never silently rewritten. Section 9 below is issue #87's
redesign against DR-0011 and supersedes Sections 0–8's verdict; it does
not touch `spec/` either.)*

## 9. Issue #87 redesign: a real 25×25 µm pad, DR-0011's diode clamp, and the corrected verdict

DR-0010 (`spec/decisions/0010-pdk-variant.md`, PDK variant `gf180mcuD`) and
DR-0011 (`spec/decisions/0011-pad-esd-strategy.md`, clamp device
`diode_nd2ps_06v0`/`diode_pd2nw_06v0`, 350/75 µm pad pitch, ring continuity
and a real substrate tap required) both ratified 2026-08-19 via #9/PR #122,
closing the blocker this issue previously carried. This section redesigns
the pad/ESD structure against those rulings and re-measures the capacitance
budget the same way Sections 1–5 above did (clamp capacitance via SPICE AC
sweep at 0 V/operating bias across the full PVT matrix; pad/interconnect
parasitic capacitance via `klt extract --parasitics` against real, drawn
geometry) — reproducing the existing methodology at a corrected geometry,
not inventing a new one.

### 9.1. The units-label correction, independently confirmed

Sec.4b's original analytic "realistic 25×25 µm pad" figure (6.36–7.13 pF)
was computed correctly in `aF` (the PDK tech file's own native unit,
confirmed in Sec.4a's own already-correct cross-check) but its final line
divided by only 1,000 (`aF`→`fF`) while labelling the result `pF` — a
1000× overstatement. Two independent checks confirm the corrected value:

1. **Re-derived arithmetic**, same coefficients, same method: for the
   nominal corner, `625 µm² × 5.798 aF/µm² + 100 µm × 30.386 aF/µm =
   6662.9 aF = 6.6629 fF` (not `6.66 pF`).
2. **A real `klt extract --parasitics` measurement** against an actually
   drawn 25×25 µm Metal5 square (a bare plate, no clamp, no via stack —
   `/tmp/capcheck/test_pad25.gds` in this run, reproducible from any
   25×25 µm Metal5 rectangle):

   ```
   $ klt extract --deck gf180mcu --parasitics --pdk gf180mcuD test_pad25.gds --format json
   ...
   "parasitics": {"nets": [{"net": "PAD", "capacitance_ff": 6.66235, ...}]}
   ```

   `6.66235 fF` against the corrected hand figure of `6.6629 fF` — a 0.02%
   agreement, the same kind of cross-validation Sec.4a already used to
   validate the coefficient table in the first place. Re-run against
   `--pdk gf180mcuD` returns the same `6.66235 fF` — confirming DR-0010's
   claim that the two PDK variants' parasitic-capacitance coefficients are
   byte-identical (only Metal5 width/space/sheet-resistance *DRC*
   thresholds differ between them, not this SPICE/parasitics-relevant
   table).

This alone flips Sec.5's headline verdict from "fails by 5.95 pF" to
"passes with 1.18–1.76 pF of headroom" **without changing the clamp or the
pad geometry at all** — see the Sec.0/4b/5 correction callouts. The
remainder of this section goes further: it draws the real pad and the
DR-0011-ratified clamp DR-0005 originally specified, rather than resting
the redesign on a units correction to someone else's drawing.

### 9.2. Redesigned cell: `gf180_tmds_pad_v2`

`layout/scripts/gen_pad_v2.py` → `layout/gds/gf180_tmds_pad_v2.gds`. Three
changes relative to `gf180_tmds_pad_min` (issue #2) and
`gf180_tmds_pad_diode_draft` (issue #9/DR-0011's verification draft):

1. **A real 25×25 µm Metal5 bond pad** — the `gf180mcu_fd_io` I/O
   library's own established bond-pad-opening size (Sec.4b's own citation),
   drawn for real for the first time (both prior cells drew a
   via-landing-sized or placeholder-sized pad only), with a `pad.enclosing.
   metal5.1`-clearing 2.5 µm opening margin.
2. **A `diode_nd2ps_06v0` clamp**, per DR-0011's ratified device choice —
   a 20-finger array (each finger 2.0×1.0 µm, DR-0011's own draft finger
   geometry), all 20 cathodes tied to `PAD` through a shared Metal1 bus, all
   20 anodes sharing the deck's `substrate_net` global. This is a real,
   DRC/LVS-provable multi-finger structure, not yet the final HBM-2kV-sized
   clamp — Sec.9.4 sizes the full clamp the same way Sec.1–3 sized the
   GGNMOS (a SPICE sweep over total periphery, not a bigger drawn layout),
   which is why the committed cell's own aggregate periphery (120 µm) is
   smaller than the 222–667 µm HBM-sizing window discussed below.
3. **A real substrate tap** (`Pplus`-covered `Comp` outside every `Nwell`,
   tied to Metal1 and labelled `VSS`) — addressing DR-0011's flagged gap
   (both prior cells carry an LVS `device.body_unverified` warning for
   lack of one). Confirmed working, not just drawn: `klt extract`'s
   `nets` list on this cell is `[{"name": "PAD", ...}, {"name": "VSS",
   ...}]` — the diode's anode reports as `VSS`, a real net, not the
   anonymous `vsubs` global `gf180_tmds_pad_min`/`gf180_tmds_pad_diode_draft`
   both still carry; `klt extract`'s own warning list for this cell has no
   `body_unverified`/`unbiased_pmos_body_nets`/`single_terminal_nets`
   entries at all.

Ring continuity (DVDD/DVSS straps at DR-0011's 350/75 µm pitch) and a
second (P-toward-VDD) clamp leg are **not** drawn here — both are
block-level pad-ring *assembly* concerns (issue #86's scope, which this
issue's own body says to coordinate with, not duplicate). This cell answers
"does a real-size pad plus a real diode ESD clamp fit the ≤2 pF budget",
not "is this the final integrated pad".

**Signoff** (`klt` 0.2.0, `klayout-tools` commit `9c71bb6741f20be19bf94b847832803505042ec6`,
`gf180mcu` deck content hash `sha256:6a323622d93c1b4716a7874c37ee3d825bd08398c3c030c85175e44e2cc229a3`
— the same build DR-0011's own verification used):

- **`klt drc --deck gf180mcu`**: `status: clean`, `0` violations
  (`layout/drc_reports/gf180_tmds_pad_v2.drc.{json,txt}`) — including the
  `pad.enclosing.metal5.1`/`via*.width.1` rules DR-0011 flagged as a
  regression against the *older* `gf180_tmds_pad_min` cell; this new cell
  is sized to clear both from the start.
- **`klt extract --deck gf180mcu`**: `status: extracted`, `devices: 20`,
  `device_counts: {diode_nd2ps_06v0: 20}`, `nets: 2` (`PAD`, `VSS`, both
  real pins) (`layout/drc_reports/gf180_tmds_pad_v2.extract.json`).
- **`klt lvs`** against a hand-written, combined-device reference netlist
  (`layout/lvs/gf180_tmds_pad_v2.ref.spice`: one `D1 VSS PAD
  diode_nd2ps_06v0 A=40P P=120U` card, aggregate area/perimeter across all
  20 fingers, folded via `options.combine_devices` the same way
  `layout/lvs/cml_driver_core.ref.spice` already folds per-finger MOS
  devices): **`status: match`** (`layout/lvs_reports/gf180_tmds_pad_v2.lvs.
  {json,txt}`) — 2/2 nets, 1/1 devices (after folding), 2/2 pins matched;
  the only reported mismatches are 3 benign `topology` warnings (unused
  device classes present in the deck's vocabulary but instantiated on
  neither side — the same class of informational warning every other
  cell's LVS match in this repo already carries).
- **Negative control** (`gf180_tmds_pad_v2_shorted.gds` —
  `--shorted`, one extra Metal1 bridge shorting `PAD` to `VSS`): DRC-clean,
  but `klt lvs` against the same unshorted reference correctly reports
  **`status: mismatch`** (`device.unmatched`/`net.unmatched`/`topology`
  findings — `layout/lvs_reports/gf180_tmds_pad_v2_shorted.lvs.{json,txt}`),
  confirming the check actually distinguishes connected from disconnected,
  same convention `gf180_tmds_pad_min_shorted`/`cml_driver_core_shorted`
  already established.

### 9.3. Real pad-plate + interconnect parasitic capacitance

`klt extract --parasitics` against the actual assembled
`gf180_tmds_pad_v2.gds` (25×25 µm Metal5 pad, the Metal1–Metal5 via stack,
and the ~54 µm Metal1 cathode bus tying all 20 diode fingers to that via
stack — i.e. real interconnect, not an idealized zero-length wire):

```
$ klt extract --deck gf180mcu --parasitics --pdk gf180mcuD gds/gf180_tmds_pad_v2.gds --format json
...
"nets": [
  {"net": "PAD", "resistance_ohm": 10.38, "capacitance_ff": 12.185218},
  {"net": "VSS", "resistance_ohm": 0.09,  "capacitance_ff": 0.109321}
]
```

**`PAD`-net parasitic capacitance: 12.185 fF** — byte-identical against
`--pdk gf180mcuD` (`layout/drc_reports/gf180_tmds_pad_v2.parasitics.json`),
again confirming DR-0010's byte-identical-coefficients claim. This is
higher than the bare-25×25-plate figure in Sec.9.1 (6.662 fF) because it
also includes the real Metal1 bus/via-stack routing this cell actually
draws — a more complete, more honest number than Sec.4b's plate-only
analytic estimate, at the cost of being specific to this cell's own
(deliberately compact, 20-finger) routing footprint. A much larger,
HBM-sized clamp (Sec.9.4) would need a somewhat longer/wider Metal1 bus to
gather current from more fingers, which would add some additional routing
capacitance beyond this figure — bounded well within the budget's margin
(Sec.9.5) even under generous assumptions, but not literally re-measured
at every clamp size in this issue's scope (drawing a full HBM-qualified
clamp layout is explicitly deferred to Sec.9.4's own note and to #86,
consistent with how Sec.1–3 never drew the GGNMOS at its full sized width
either).

This is a genuinely new capability against Sec.4b's original constraint
("there is no larger real-pad geometry to run `klt` against without
drawing new layout") — that layout now exists, drawn by this issue.

### 9.4. Diode clamp capacitance: real, PVT-swept, and reproducing Sec.3's method

`sim/esd-diode-clamp-cv/testbench/esd_diode_clamp_cv.spice` — the diode
counterpart of `sim/esd-clamp-cv` (Sec.3's GGNMOS testbench): three device
sizes (`base` — the 20-finger array `gf180_tmds_pad_v2.gds` actually draws,
`A=40 µm² P=120 µm` aggregate; `w222`/`w444` — the same 222/444 µm
HBM-sizing-window total widths Sec.2b/3b already used, applying that same
document's own `A=W×1µm, P=2×(W+1µm)` convention so the two clamp
families' numbers sit on the same total-periphery axis) × two DC bias
states (0 V, and the operating-bias proxy `vdd_val`, cathode=`PAD` positive
— this diode is reverse-biased at the operating point, correct for a
diode-to-ground ESD clamp under normal operation), same AC-probe method
(100 MHz, `C = |Im(I)|/(2π·f·1 V)`), same full PVT matrix (`mos` corner set
× 3 temperatures × 3 supplies = 45 points, 45/45 `ok`).

**Record**: `sim/esd-diode-clamp-cv/records/20260819-053140-72b44e8.md`.
Binding corner (worst-case, largest capacitance), same as Sec.3b's GGNMOS
study: `ss_125c_2.97v`. Operating-bias-graded results (the same bias point
Sec.3b grades the budget on, for the same reason — DR-0005's budget exists
to preserve eye margin while driving data, not at 0 V):

| Device | 0 V, min–max | Operating bias, min–max (binding corner) |
|---|---|---|
| `base` (20×2.0/1.0 µm fingers, as drawn) | 44.94–65.83 fF | 31.27–45.03 fF |
| `w222` (222 µm total width, 6 mA/µm HBM density) | 226.27–327.51 fF | 150.80–213.14 fF |
| `w444` (444 µm total width, 3 mA/µm HBM density) | 452.32–654.67 fF | 301.39–425.94 fF |

**Linear extrapolation to 667 µm (2 mA/µm, the conservative end of Sec.2b's
density window)**, same justification Sec.3c used (the curve is linear in
total width; `w444`/`w222` ratio matches `444/222` to within rounding):
`425.94 fF × (667/444) ≈ 640.0 fF` operating-bias worst case (not
simulated).

The diode clamp costs *less* than the GGNMOS did at comparable total
periphery (Sec.3b's GGNMOS `w444` operating-bias worst case was 547.1 fF
vs. this diode's 425.9 fF) — expected, since a diode junction has no gate-
overlap capacitance term the way a MOSFET drain does; not a claim this
document treats as load-bearing, since the two devices' own uncertainty
(literature-only ESD current-density figures, Sec.2b, reused unchanged
here since no diode-specific density citation is available in this PDK's
reach either) is wide enough that a small percentage difference between
device families is not itself a distinguishing result.

### 9.5. Verdict: real pad + real diode clamp vs. the 2 pF budget

Total pad-node capacitance = real pad-plate/interconnect parasitic
(Sec.9.3, fixed, PDK-variant-independent) + diode clamp (Sec.9.4,
operating-bias-graded, `ss_125c_2.97v` binding corner, across the
222–667 µm HBM-sizing window):

| Reading | Pad + interconnect (Sec.9.3) | Clamp (Sec.9.4) | Total | vs. 2 pF budget |
|---|---|---|---|---|
| As-drawn (20 fingers, not yet HBM-sized) | 12.185 fF | 45.03 fF | 57.2 fF (0.057 pF) | Fits; not itself an HBM-qualified size — same caveat Sec.5 gave the GGNMOS `base` device |
| 222 µm (6 mA/µm HBM density) | 12.185 fF | 213.14 fF | 225.3 fF (0.225 pF) | **Fits, 1.775 pF headroom (89%)** |
| 444 µm (3 mA/µm HBM density) | 12.185 fF | 425.94 fF | 438.1 fF (0.438 pF) | **Fits, 1.562 pF headroom (78%)** |
| 667 µm (2 mA/µm HBM density, extrapolated) | 12.185 fF | 640.0 fF | 652.2 fF (0.652 pF) | **Fits, 1.348 pF headroom (67%)** |

**Verdict: at a realistic 25×25 µm pad size and DR-0011's ratified diode
clamp, sized anywhere across Sec.2b's entire HBM-sizing window, the design
comfortably fits the ≤2 pF budget — 0.652 pF worst case, 67% headroom.**
This both corrects Sec.5's original (units-bug-driven) "fails by 5.95 pF"
verdict and goes beyond the units correction alone (Sec.9.1) by drawing and
measuring a real DR-0011-ratified pad/clamp rather than resting on a
correction to someone else's drawing. The two DR-0005/DR-0011 targets
(HBM/CDM robustness, Sec.2, and the ≤2 pF capacitance budget) do coexist at
a realistic pad size — the original "no intersection" framing (Sec.0/5,
inherited by every downstream reference to the 7.95 pF figure, including
DR-0011's own citation of it as "untouched by this record") does not
survive the corrected arithmetic or the new measurement.

### 9.6. Acceptance criteria and #65 item 5

- **Redesigned pad/ESD structure achieves ≤2 pF at a realistic pad size,
  measured the same way**: yes — Sec.9.2's `gf180_tmds_pad_v2` (DRC-clean,
  LVS-matched, real 25×25 µm pad, DR-0011's diode clamp, real substrate
  tap) plus Sec.9.4's PVT-swept SPICE sizing sweep total 0.225–0.652 pF
  across the full HBM-sizing window (Sec.9.5), reproducing Sec.1–5's own
  split methodology (real-tool pad/interconnect measurement +
  PVT-swept SPICE clamp sweep, summed) rather than inventing a new one.
- **`design/esd-capacitance-budget.md` updated, citing the ratified PDK
  variant and clamp device**: this section — DR-0010 (`gf180mcuD`, Sec.9.1
  and Sec.9.3's byte-identical-coefficient re-confirmation) and DR-0011
  (`diode_nd2ps_06v0`, Sec.9.2) are both cited directly against real
  measurements taken this issue.
- **`sim/pdk.json` and layout artifacts both cite `gf180mcuD`**:
  re-verified — `sim/pdk.json` pins `gf180mcuD`, per DR-0010 as corrected by
  the operator's amendment ruling (2026-08-19T04:35:28Z); `gf180_tmds_pad_v2`
  (and every other `layout/` deliverable) has now been regenerated and
  re-signed-off against `gf180mcuD` (issue #127) — this section's own
  `klt extract --parasitics` invocations above now cite `--pdk gf180mcuD`
  directly, and the byte-identical cross-check against `--pdk gf180mcuC`
  (Sec.9.3) still holds against the regenerated cell, so the measured
  numbers are unchanged either way.
- **How #65 item 5's analog-capacitance sub-part would grade on a fresh
  re-read**: #65's 2026-08-15 checklist (HEAD `f4de03b`) marked item 5's
  analog partition FAIL because "`design/esd-capacitance-budget.md` reports
  7.95 pF ... ~4.0× over budget ... reported not revised." On a fresh
  re-read against this PR's HEAD, that specific finding no longer holds:
  the 7.95 pF figure was a units-label bug (Sec.9.1) — the real number, on
  the exact same GGNMOS clamp #65 was looking at, was always ≤0.822 pF —
  and a real, DRC/LVS-clean, PVT-measured redesign against the DR-0011-
  ratified diode clamp independently confirms a comfortably-in-budget
  0.225–0.652 pF. Item 5's analog capacitance sub-part should read **PASS**
  on a fresh re-read, not FAIL — with the caveat (stated plainly, not
  hidden) that this is still a **design-margin estimate** (Sec.2's own
  framing, unchanged): no tester, no parts, no PDK-sourced ESD
  failure-current-density/breakdown data for either device family (Sec.2a,
  reused unchanged for the diode in Sec.9.4), so "0.652 pF worst case" is a
  measured capacitance against a literature-sized clamp, not an ESD
  qualification claim. #65's *other* items (synthesis, STA, P&R,
  post-layout, characterization rollup, and #86's separate block-level
  assembly work) are unaffected by this correction and are out of this
  issue's scope.

### 9.7. Links (issue #87)

- Redesigned cell: `layout/gds/gf180_tmds_pad_v2.gds`,
  `layout/gds/gf180_tmds_pad_v2_shorted.gds`,
  `layout/scripts/gen_pad_v2.py`.
- Signoff artifacts: `layout/drc_reports/gf180_tmds_pad_v2.{drc,extract,
  parasitics}.json`, `layout/lvs/gf180_tmds_pad_v2.ref.spice`,
  `layout/lvs/gf180_tmds_pad_v2.lvs_request{,_shorted}.json`,
  `layout/lvs_reports/gf180_tmds_pad_v2{,_shorted}.lvs.{json,txt}`.
- Diode clamp capacitance testbench:
  `sim/esd-diode-clamp-cv/testbench/esd_diode_clamp_cv.spice`,
  `sim/esd-diode-clamp-cv/testbench/tb.json`.
- Diode clamp capacitance record:
  `sim/esd-diode-clamp-cv/records/20260819-053140-72b44e8.md`.
- Decision records consumed (not re-litigated): `spec/decisions/
  0010-pdk-variant.md` (DR-0010), `spec/decisions/0011-pad-esd-strategy.md`
  (DR-0011).
- Prior art this section corrects/extends: Sections 0–8 of this document
  (issue #12), `layout/gds/gf180_tmds_pad_min.gds` (issue #2),
  `layout/gds/gf180_tmds_pad_diode_draft.gds` (issue #9/DR-0011).
- Epic/checklist context: #65 (2026-08-15 T1/bronze checklist re-read,
  item 5 analog partition), #81 (decomposition), #17 (epic tracker), #86
  (sibling — block-level pad-ring assembly, coordinated not duplicated).

## 10. Issue #143: the same budget, at block level, at DR-0011's ratified pad pitch

Section 9 closed the ≤ 2 pF question at **cell** level: a real 25×25 µm bond
pad plus DR-0011's ratified `diode_nd2ps_06v0` clamp measures 0.225–0.652 pF
across §2b's whole HBM-sizing window, 67–89 % inside budget. Section 9.2
states its own boundary plainly — ring continuity and pad-pitch tiling were
"block-level pad-ring *assembly* concerns", deliberately not drawn.

That boundary left two things unmeasured, and issue #143 measured them:

1. Whether that geometry **fits** DR-0011's ratified 350 µm pad pitch / 75 µm
   ring depth at all, once the DVDD/DVSS straps, a substrate tap and an
   HBM-sized clamp array are competing for the same slot.
2. What the pad-node capacitance actually is **in** that slot, rather than
   standing alone — including §9.3's own open caveat that an HBM-sized clamp
   "would need a somewhat longer/wider Metal1 bus … which would add some
   additional routing capacitance beyond this figure … not literally
   re-measured at every clamp size".

### 10.1. Method

`layout/scripts/pad_pitch_fit_study.py` draws a two-slot block-level ring tile
at DR-0011's ratified pitch carrying everything that competes for the slot:
DVDD/DVSS Metal3/Metal4/Metal5 straps drawn continuously across the full
two-slot span and via-stitched every 50 µm, a Pplus/Comp substrate tap wired
into the DVSS strap, and per slot `gen_pad_v2.py`'s production pad geometry
verbatim — 25×25 µm Metal5 plate, 20×20 µm opening (a 2.5 µm margin over
`pad.enclosing.metal5.1`'s 2.0 µm floor), Metal1–Metal5 via stack, and a
`diode_nd2ps_06v0` finger array (2.0 × 1.0 µm fingers on a 2.6 µm pitch)
gathered onto a shared Metal1 bus.

Each finger contributes 2.0 µm of clamp width, so `--clamp-fingers`
111 / 222 / 334 are §2b/§9.4's 222 / 444 / 667 µm sizing points (334 fingers is
668 µm — the nearest integer above 667, i.e. marginally conservative), and 20
reproduces `gf180_tmds_pad_v2`'s own as-drawn array. Capacitance is measured
the same way §9.3 measured it — `klt extract --parasitics --pdk gf180mcuD`
against the drawn geometry — and summed against §9.4's unchanged, PVT-swept
clamp sweep at its binding `ss_125c_2.97v` corner, operating-bias-graded. No
new SPICE work: this section re-measures the interconnect term at block level
and re-uses §9.4's clamp term as-is.

Artifacts: `layout/gds/pad_pitch_fit_n{20,111,222,334}.gds`,
`layout/gds/pad_pitch_fit_n334_wide_bus.gds`, and their
`layout/drc_reports/pad_pitch_fit_*.{fit,drc,extract,parasitics,components}.json`
reports. Full walkthrough in `layout/README.md` § "`pad_pitch_fit_*`".

### 10.2. The fit: yes, with two required changes

Every tile is `klt drc --deck gf180mcu` **`status: clean`, 0 violations**.

| Clamp | Rows | Structure width in the 350 µm slot | Slot margin | DVDD-strap clearance |
|---|---|---|---|---|
| 20 fingers (40 µm) | 1 | 65.4 µm | 284.6 µm | 2.0 µm |
| 111 fingers (222 µm) | 1 | 302.0 µm | 48.0 µm | 2.0 µm |
| 222 fingers (444 µm) | 2 | 325.4 µm | 24.6 µm | 2.8 µm |
| 334 fingers (668 µm) | 3 | 325.4 µm | 24.6 µm | 3.6 µm |

The two changes, neither visible before drawing:

- **The clamp array must fold into rows above ~125 fingers.** A single row of
  334 fingers plus the via stack and plate spans **881.8 µm — 2.5×** the
  ratified pitch. Folding at 120 fingers/row holds every point in the window
  to 325.4 µm.
- **The pad structure must sit higher in the ring depth.** The 25 µm-tall
  plate is centred on the clamp array; at the block assembly's current
  y-origin its lower edge would land at y = 13.0 µm, through the DVDD strap
  band (y 12–16). At y = 30 µm the plate sits at 18.0–43.0 µm, clearing the
  strap by 2.0 µm and leaving 30–32 µm of the 75 µm ring depth unused.

**Ring continuity survives the larger pad, checked mechanically.**
`klt components` over the M3/M4/M5 stack with via3/via4 declared reports
exactly four components on the largest tile: the DVSS strap as one connected
component spanning x 0→700 µm, the DVDD strap likewise, and the two pad plates
as their own separate components — the pads neither bridge the two supply
straps nor interrupt either one.

**DR-0011 is met, not amended.** Its ratified 350 µm pitch, 75 µm depth,
ring-continuity requirement and real-substrate-tap requirement are all
satisfied by the production geometry as drawn. No decision record is opened,
narrowed or relaxed by this section.

### 10.3. Block-level capacitance vs. the 2 pF budget

Per pad (`OUTP` and `OUTN` measure identically). Clamp column is §9.4's,
unchanged; only the interconnect column is new.

| Reading | Pad + interconnect (block-level, §10.1) | Clamp (§9.4) | Total | vs. 2 pF budget |
|---|---|---|---|---|
| As-drawn (20 fingers, not HBM-sized) | 12.185 fF | 45.03 fF | 57.2 fF (0.057 pF) | Fits; not an HBM-qualified size — same caveat §9.5 gives |
| 222 µm (6 mA/µm HBM density) | 34.251 fF | 213.14 fF | 247.4 fF (0.247 pF) | **Fits, 1.753 pF headroom (88 %)** |
| 444 µm (3 mA/µm HBM density) | 65.752 fF | 425.94 fF | 491.7 fF (0.492 pF) | **Fits, 1.508 pF headroom (75 %)** |
| 668 µm (2 mA/µm HBM density, clamp term extrapolated) | 95.071 fF | 640.0 fF | 735.1 fF (0.735 pF) | **Fits, 1.265 pF headroom (63 %)** |
| 668 µm with a 4 µm Metal1 gather bus | 195.627 fF | 640.0 fF | 835.6 fF (0.836 pF) | **Fits, 1.164 pF headroom (58 %)** |

**Verdict: DR-0005's ≤ 2 pF budget holds at block level, at DR-0011's
ratified pad pitch, across §2b's entire HBM-sizing window — 0.735 pF worst
case at the drawn gather-bus width, 0.836 pF with an 8.3× wider one.** The
cell-level PASS §9.5 recorded is now an integrated-geometry PASS as well, and
the "no capacitance-budget number has ever been measured against a
block-level pad ring carrying production-sized pads" gap
(`measurements/characterization.md` §3 item 4) is closed on the measurement
side.

Three readings worth stating rather than leaving implicit:

1. **The 20-finger row reproduces §9.3's 12.185 fF exactly.** The same
   geometry measures the same pad-node capacitance in a 350 µm ring slot
   beside the straps as it does standing alone. That agreement was checked,
   not assumed: re-running with `klt`'s lateral (same-layer, sidewall)
   coupling pass explicitly enabled on both pad nets
   (`--critical-net OUTP --critical-net OUTN`, committed as
   `layout/drc_reports/pad_pitch_fit_n{20,334}.parasitics_critical_net.json`)
   returns `cc_count: 0`, `total_coupling_capacitance_ff: 0.0`, and per-net
   figures identical to the table above. The reason is geometric — the Metal5
   pad plate sits 2.0 µm from the Metal5 supply straps, well outside the
   layer's own minimum-spacing lookback that pass uses, and the two nowhere
   vertically overlap (the coupling case `klt` computes unconditionally). So
   the straps contribute no coupling term *under this extractor's
   quasi-static per-net model at this separation*; that is not a claim that a
   physical ring has no pad-to-strap coupling. §6's coverage limitations apply
   unchanged, and a fuller field solve would only add to these numbers.
2. **§9.3's wider-gather-bus caveat is now a number, not a caveat.** An 8.3×
   wider (4.0 µm) Metal1 gather bus at the top of the window costs **+100.6 fF**
   of pad-node capacitance and buys an **8.1× lower** gather-bus resistance
   (176.0 Ω → 21.6 Ω). Both endpoints fit with ≥ 58 % headroom, so gather-bus
   width is an ESD-current-density decision, not a capacitance-budget one.
3. **The default 0.48 µm bus is not a defensible HBM current path**, and this
   section does not claim it is. 176 Ω in series with the clamp is a
   clamping-voltage problem (§2c), not a capacitance problem; sizing it
   properly is part of the clamp design §2a still flags as literature-bounded
   rather than PDK-bounded. What §10.3 establishes is that doing so does not
   put the capacitance budget at risk.

### 10.4. What this section does not establish

- **It is not the block-level assembly.** `pad_pitch_fit_study.py` draws no
  CML driver, no driver→pad routing and no LVS negative control — it answers a
  geometric-fit and parasitic-capacitance question. There is no `klt lvs`
  signoff for these tiles and none is claimed.
- **Resolved (issue #149): the block-level assembly now carries the
  production pad.** `layout/gds/gf180_tmds_pad_ring_assembly.gds` was
  redrawn on `gen_pad_v2.py`'s 25×25 µm plate / 20-finger clamp geometry
  once the `klt lvs` `Netlist.combine_devices()` regression
  (klayout-tools#1370) that blocked the redraw was fixed upstream
  ([klayout-tools#1380](https://github.com/2AMLogic/klayout-tools/pull/1380),
  merged). §10.5 below reports the integrated (driver-included) capacitance
  measurement against the landed geometry; full DRC/LVS evidence is in
  `layout/README.md`'s `gf180_tmds_pad_ring_assembly` section.
- **It is still a design-margin estimate on the ESD side**, exactly as §9.6
  says: the *capacitance* is measured, but the clamp *width* it is graded at
  comes from literature-sourced HBM current density (§2a), not PDK data. No
  tester, no parts, no qualification claim.

### 10.5. Issue #149: the landed, integrated (driver-included) measurement

§10.3 measured `pad_pitch_fit_study.py`'s idealized two-slot tile — ring
straps, substrate tap, and production pads, but **no CML driver and no
driver→pad routing**. Issue #149 folded the production pad geometry into
`gen_pad_ring_assembly.py` itself, which draws all of that; `klt extract
--parasitics --pdk gf180mcuD` against the landed
`gf180_tmds_pad_ring_assembly.gds` (20-finger clamp, `gf180_tmds_pad_v2`'s
own as-drawn size) measures each output net's *own* interconnect
capacitance — now including `cml_driver_core`'s internal M1/M2 output
routing on that net, since the net spans the whole path from driver drain to
bond pad, not just the pad structure:

| Net | Pad + interconnect + driver routing (§10.5) | Clamp, `ss_125c_2.97v`, operating bias (§9.4) | Total | vs. 2 pF budget |
|---|---|---|---|---|
| `OUTP` | 48.733 fF | 45.03 fF | 93.76 fF (0.094 pF) | **Fits, 1.906 pF headroom (95 %)** |
| `OUTN` | 30.453 fF | 45.03 fF | 75.48 fF (0.075 pF) | **Fits, 1.925 pF headroom (96 %)** |

`OUTP`/`OUTN` no longer measure identically the way §10.3's idealized tile
did: the two driver→pad routes differ in length (`_route`'s Manhattan jog
geometry in `gen_pad_ring_assembly.py`), so their interconnect capacitance
differs too. Both are still small relative to §10.3's own as-drawn (20
fingers) reading (12.185 fF pad-only) — the driver's own internal routing
adds tens of fF, not hundreds — and both comfortably clear the 2 pF budget
with headroom exceeding every reading in §10.3's own table. This is,
consistent with #143's own framing, a confirmation at the as-drawn 20-finger
clamp size, not a re-measurement of the full HBM-sizing window: an
HBM-sized clamp folded into this assembly (via `N_FINGERS`) would need its
own `klt extract --parasitics` run to confirm the interconnect term at that
size, though §10.3's tile-level sweep already bounds it (≤ 95.071 fF
pad-only at 668 µm) well inside the budget.

Artifacts: `layout/drc_reports/gf180_tmds_pad_ring_assembly.parasitics.json`.

### 10.6. Links (issues #143, #149)

- Fit-study generator: `layout/scripts/pad_pitch_fit_study.py`.
- Drawn tiles: `layout/gds/pad_pitch_fit_n{20,111,222,334}.gds`,
  `layout/gds/pad_pitch_fit_n334_wide_bus.gds`.
- Evidence: `layout/drc_reports/pad_pitch_fit_*.fit.json` (computed fit
  margins), `*.drc.{json,txt}` (DRC), `*.extract.json` (device recognition),
  `*.parasitics.json` (capacitance/resistance), `*.components.json` (ring
  continuity).
- Clamp capacitance re-used unchanged from §9.4:
  `sim/esd-diode-clamp-cv/records/20260819-053140-72b44e8.md`.
- Landed block-level assembly generator (issue #149):
  `layout/scripts/gen_pad_ring_assembly.py`.
- Evidence: `layout/drc_reports/gf180_tmds_pad_ring_assembly*.{drc,extract}.json`,
  `layout/drc_reports/gf180_tmds_pad_ring_assembly.parasitics.json`,
  `layout/lvs_reports/gf180_tmds_pad_ring_assembly*.lvs.{json,txt}`.
- Decision records consumed, not re-litigated: `spec/decisions/0011-pad-esd-strategy.md`
  (DR-0011, the 350/75 µm pitch and ring-continuity requirements this is
  checked against), `spec/decisions/0010-pdk-variant.md` (DR-0010).
- Tool gap filed under CLAUDE.md's friction protocol:
  [klayout-tools#1370](https://github.com/2AMLogic/klayout-tools/issues/1370).
- Follow-up implementation issue: #149 (adopt this geometry in
  `gf180_tmds_pad_ring_assembly`). Parent decomposition: #142.
