2AMLogic/gf180-tmds-tx/WORK_PLAN.md

# Work Plan

This document is regenerated automatically by the Guide triage agent from
current GitHub label state. The region between the markers below is
machine-generated and is overwritten wholesale on each update; nothing
outside the markers is touched. See `.claude/skills/loom-guide/guide.md`
for the generation logic.

<!-- guide:plan-body:start -->
## Operator Attention: Merge-Risk-Hold Pileup

Judge-approved PRs under a hold (`loom:blocked` or `loom:operator`) — only a human merge decision is missing.

_None._

## Very Important

`loom:very-important` (one counts per workspace); every stage takes these first.

_None._

## Important

`loom:important`; taken before unlabelled work.

- **#222**: Re-run post-layout eye records and measure pd2nw clamp C-V after VDD-side clamp (#210)

## Ready

Human-approved issues ready for implementation (`loom:issue`).

_None._

## In Progress

Issues currently being built (`loom:building`).

_None._

## PRs Awaiting Review

PRs waiting on Judge (`loom:review-requested`).

_None._

## Approved (Awaiting Merge)

PRs that passed review and are queued for Champion auto-merge (`loom:pr`).

_None._

## Proposed

Issues carrying `loom:curated`.

- **#158**: Champion: Merge-Risk Hold Digest *(curated)*
- **#222**: Re-run post-layout eye records and measure pd2nw clamp C-V after VDD-side clamp (#210) *(curated)*
- **#229**: T1 items 5 and 6 (analog): klt sim envelopes per spec row and a klt yield report for the mismatch campaign *(curated)*
- **#254**: Adopt the common artifact store for sim evidence (manifests in git, bytes via klt artifact) *(curated)*

## Proposed (Architect / Hermit)

_None._

## Epics

_None._

## Backlog Balance

| Bucket | Count |
|---|---|
| Operator merge-risk holds | 0 |
| Very important | 0 |
| Important | 1 |
| Ready (`loom:issue`) | 0 |
| In Progress (`loom:building`) | 0 |
| PRs awaiting review | 0 |
| Approved PRs awaiting merge | 0 |
| Curated | 4 |
| Architect / Hermit proposals | 0 |
| Active epics | 0 |
<!-- guide:plan-body:end -->
