2AMLogic/gf180-tmds-tx/sim/esd-diode-clamp-cv/records/20260819-053140-72b44e8.md

# Record 20260819-053140-72b44e8

- **Record ID**: 20260819-053140-72b44e8
- **Claim**: spec/decisions/0011-pad-esd-strategy.md -- the <=2 pF/pad budget (ESD clamp + pad parasitic combined, carried forward unrelaxed from DR-0005), specifically the diode clamp's own junction-capacitance contribution as a function of clamp size, at both 0 V and the DR-0002/DR-0006 2.8-3.3 V operating bias.
- **Netlist provenance**: schematic (`sim/esd-diode-clamp-cv/testbench/esd_diode_clamp_cv.spice`) — **taken against a dirty working tree** at commit `72b44e89c161307701f43c05cf0942fd5091a374`; not citable as a clean-tree result
- **Corner matrix run**:
  - Process: tt, ff, ss, fs, sf
  - Temperature: -40 °C, 27 °C, 125 °C
  - Supply: 2.97 V, 3.30 V, 3.63 V
  - 45 point full-factorial grid (process × temperature × supply), 45 completed
  - Full PVT matrix per CLAUDE.md (−40/27/125 °C, ±10 % supply, process corners).
- **Statistical convention**: N/A (corner-matrix claim, not a distribution claim)
- **Result**:

  | corner-id | cap_base_0v | cap_base_opv | cap_w222_0v | cap_w222_opv | cap_w444_0v | cap_w444_opv | pass/fail |
  |---|---|---|---|---|---|---|---|
  | `tt_-40c_2.97v` | 4.993477e-14 | 3.581510e-14 | 2.514067e-13 | 1.734684e-13 | 5.025796e-13 | 3.467068e-13 | PASS |
  | `tt_-40c_3.30v` | 4.993477e-14 | 3.524981e-14 | 2.514067e-13 | 1.703529e-13 | 5.025796e-13 | 3.404760e-13 | PASS |
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
  | `sf_-40c_3.63v` | 4.993477e-14 | 3.474164e-14 | 2.514067e-13 | 1.675527e-13 | 5.025796e-13 | 3.348756e-13 | PASS |
  | `sf_27c_2.97v` | 5.396000e-14 | 3.811761e-14 | 2.702180e-13 | 1.828642e-13 | 5.401700e-13 | 3.654676e-13 | PASS |
  | `sf_27c_3.30v` | 5.396000e-14 | 3.752386e-14 | 2.702180e-13 | 1.795951e-13 | 5.401700e-13 | 3.589296e-13 | PASS |
  | `sf_27c_3.63v` | 5.396000e-14 | 3.699152e-14 | 2.702180e-13 | 1.766646e-13 | 5.401700e-13 | 3.530688e-13 | PASS |
  | `sf_125c_2.97v` | 5.984764e-14 | 4.093673e-14 | 2.977330e-13 | 1.937607e-13 | 5.951530e-13 | 3.872173e-13 | PASS |
  | `sf_125c_3.30v` | 5.984764e-14 | 4.031018e-14 | 2.977330e-13 | 1.903167e-13 | 5.951530e-13 | 3.803297e-13 | PASS |
  | `sf_125c_3.63v` | 5.984764e-14 | 3.975078e-14 | 2.977330e-13 | 1.872423e-13 | 5.951530e-13 | 3.741813e-13 | PASS |

  Spread across the grid:

  | measurement | min | max | mean | spread % | limits |
  |---|---|---|---|---|---|
  | `cap_base_0v` | 4.494130e-14 (`ff_-40c_2.97v`) | 6.583240e-14 (`ss_125c_2.97v`) | 5.458080e-14 | 38.2756 | — |
  | `cap_base_opv` | 3.126748e-14 (`ff_-40c_3.63v`) | 4.503040e-14 (`ss_125c_2.97v`) | 3.771525e-14 | 36.4917 | — |
  | `cap_w222_0v` | 2.262661e-13 (`ff_-40c_2.97v`) | 3.275062e-13 (`ss_125c_2.97v`) | 2.731192e-13 | 37.0681 | — |
  | `cap_w222_opv` | 1.507974e-13 (`ff_-40c_3.63v`) | 2.131367e-13 (`ss_125c_2.97v`) | 1.802019e-13 | 34.5942 | — |
  | `cap_w444_0v` | 4.523216e-13 (`ff_-40c_2.97v`) | 6.546683e-13 (`ss_125c_2.97v`) | 5.459675e-13 | 37.062 | — |
  | `cap_w444_opv` | 3.013881e-13 (`ff_-40c_3.63v`) | 4.259391e-13 (`ss_125c_2.97v`) | 3.601392e-13 | 34.5841 | min=0, max=5.000000e-11 |

  - **Overall: PASS**
- **Links**:
  - Testbench: `sim/esd-diode-clamp-cv/testbench/esd_diode_clamp_cv.spice`, `sim/esd-diode-clamp-cv/testbench/tb.json`
  - Netlist snapshot: `sim/esd-diode-clamp-cv/netlist-snapshots/20260819-053140-72b44e8.spice`
  - Raw logs: `sim/esd-diode-clamp-cv/corners/20260819-053140-72b44e8/`
- **Timestamp / author**: 2026-08-19T05:31:40+00:00, ubuntu
- **Supersedes**: (none)

## Environment

Everything needed to re-run this record:

- PDK: gf180mcuC @ open_pdks `c6d73a35f524070e85faff4a6a9eef49553ebc2b` (/home/ubuntu/.volare/gf180mcuC, found via search_root:~/.volare)
- ngspice: ngspice-46 : Circuit level simulation program
- Harness: sim/harness 0.1.0, python 3.12.3
- git: `72b44e89c161307701f43c05cf0942fd5091a374` on `feature/issue-87` (dirty)
- Testbench netlist sha256: `922b3a1a3b562c23ba008089aca7751ace369cbf64d601dcb028d01a7b44a410`
- Manifest sha256: `04760a6ff16deaf252a735143a310a9812d860b14038498474c5c82f6e899cf9`
- Wall time: 0.35 s

Per-corner model sections used:

- `tt`: typical res_typical bjt_typical diode_typical moscap_typical mimcap_typical
- `ff`: ff res_ff bjt_ff diode_ff moscap_ff mimcap_ff
- `ss`: ss res_ss bjt_ss diode_ss moscap_ss mimcap_ss
- `fs`: fs res_typical bjt_typical diode_typical moscap_typical mimcap_typical
- `sf`: sf res_typical bjt_typical diode_typical moscap_typical mimcap_typical

---

Written by `sim/run_corners.py`. Append-only: never edit or delete this
file — a re-run or correction mints a new record-id and points back here
via **Supersedes** (see `sim/README.md`).
