2AMLogic/gf180-tmds-tx/flow/tmds_encoder/records/20260817-105608-049c240.md

# Record 20260817-105608-049c240

- **Record ID**: 20260817-105608-049c240
- **Claim**: A block-level digital place-and-routed layout for `tmds_encoder`
  exists (DEF + merged GDS), built against the gate-level netlist issue #82
  produced (`flow/tmds_encoder/netlist/tmds_encoder.synth.v`, unmodified) and
  the gf180mcu `gf180mcu_fd_sc_mcu9t5v0` standard-cell library at the `tt_025C_3v30`
  corner (spec/tmds-tx.md DR-0003's synthesized-domain corner, same as #82).
  Addresses #65 item 2 (layout) on the digital partition.
- **Scope**: Place-and-route, now including clock-tree synthesis and post-CTS
  hold repair (issue #100 step 2) -- floorplan, tap/endcap, PDN, placement,
  CTS, hold repair, routing, filler insertion. No standalone timing-closure
  *verdict* is made here -- that remains `flow/sta_tmds_encoder.py`'s job,
  re-run against this record's DEF -- but `repair_timing -hold` here actively
  fixes any hold violation CTS itself introduces. See
  `flow/pnr_tmds_encoder.py`'s "Clock-tree synthesis" section.
- **Tool versions**:
  - OpenROAD: `26Q3-1278-g4421880472` (run via the `openroad/orfs:latest`
    Docker image -- see `flow/README.md`'s "Pinned toolchain")
  - `klayout` PyPI package (`klayout.db`, GDS merge step only, in-process --
    never a `klayout` subprocess): `0.30.10`
  - gf180mcu PDK: variant `gf180mcuD`, open_pdks `c6d73a35f524070e85faff4a6a9eef49553ebc2b` (via GF180_PDK_PATH)
- **P&R configuration**:
  - Site: `GF018hv5v_green_sc9` (9-track, matching `gf180mcu_fd_sc_mcu9t5v0`)
  - Floorplan: `initialize_floorplan -utilization 35 -aspect_ratio 1 -core_space 4`
  - Placement: `global_placement -density 0.45`, then `detailed_placement` + `optimize_mirroring`
  - Tap/endcap: `tapcell -distance 100` (`gf180mcu_fd_sc_mcu9t5v0__filltie` / `gf180mcu_fd_sc_mcu9t5v0__endcap`)
  - PDN: `flow/tmds_encoder/pnr/pdn.tcl` (Metal1 followpins + Metal4/Metal5
    stripes, the same grid strategy OpenROAD-flow-scripts' own gf180 9-track
    platform config uses)
  - Clock-tree synthesis (issue #100): `create_clock -period 13.4680`
    (`spec/tmds-tx.md` §2's 720p60 target), `clock_tree_synthesis -buf_list
    {gf180mcu_fd_sc_mcu9t5v0__clkbuf_1 gf180mcu_fd_sc_mcu9t5v0__clkbuf_2 gf180mcu_fd_sc_mcu9t5v0__clkbuf_3 gf180mcu_fd_sc_mcu9t5v0__clkbuf_4 gf180mcu_fd_sc_mcu9t5v0__clkbuf_8 gf180mcu_fd_sc_mcu9t5v0__clkbuf_12 gf180mcu_fd_sc_mcu9t5v0__clkbuf_16 gf180mcu_fd_sc_mcu9t5v0__clkbuf_20} -sink_clustering_enable`, then `detailed_placement`
    to legalize the inserted buffers.
  - Hold repair (issue #100): `repair_timing -hold -hold_margin 0.25`
    after CTS, then another `detailed_placement` to legalize whatever it
    inserts. The `0.25` ns margin is not cosmetic -- see
    `flow/pnr_tmds_encoder.py`'s `HOLD_MARGIN_NS` docstring for the measured
    estimate-vs-extracted-parasitics gap it pads against. Run at the
    `tt_025C_3v30` corner this script's liberty uses; the quantitative
    post-CTS/post-repair hold verdict across all five 3.3 V corners is
    `flow/sta_tmds_encoder.py`'s job, re-run against this record's DEF, not
    this record's own claim.
  - Routing: `global_route` + `detailed_route` (TritonRoute), Metal2-Metal5
    (IO pins on Metal3/Metal4)
  - Filler: `filler_placement gf180mcu_fd_sc_mcu9t5v0__fill_*`
- **Result metrics** (from the captured OpenROAD log): {'core_area_um2': '33834.931', 'instances_area_um2': '12300.019', 'effective_utilization': '0.364', 'instance_count': '342', 'total_wire_length_um': '14686', 'via_count': '2172'}
- **Preprocessing** (mechanical, zero-semantic-impact, applied only to an
  in-memory/`flow/build/`-scratch copy fed to OpenROAD's simplified Verilog
  reader -- the committed `tmds_encoder.synth.v` is never modified): see
  `flow/pnr_tmds_encoder.py`'s "Two mechanical ... preprocessing steps".
- **Known limitations (disclosed, not silently worked around)**:
  1. **No standalone timing-closure verdict** -- CTS and hold repair now run
     (see "Scope" above), but the quantitative multi-corner setup/hold
     verdict remains `flow/sta_tmds_encoder.py`'s job, re-run separately
     against this record's DEF.
  1a. **DRC/LVS reports not re-run against this record's GDS (disclosed, not
     silently stale)**: `layout/drc_reports/tmds_encoder.drc.json`/`.txt` and
     `layout/lvs_reports/tmds_encoder.lvs.json`/`.txt` (items 2/3 below) were
     generated against the *pre-#100* GDS (no CTS, no hold repair). Placement
     and routing both change once CTS/hold-repair buffers are inserted, so
     those reports describe a superseded layout, not this record's GDS.
     Re-running `klt drc`/`klt extract`/`klt lvs` against the new GDS is
     outside issue #100's scope (digital timing closure, not physical
     verification) and is left as an explicit, disclosed follow-up rather
     than silently re-asserting stale numbers here.
  2. **DRC** (pre-#100 GDS, see 1a): `klt drc` reports `status: violations` against the merged GDS
     (188 violations, all `mim.space.1`, none attributed to a
     `source_cell`) -- see `layout/drc_reports/tmds_encoder.drc.json`/`.txt`
     and `layout/README.md`'s `tmds_encoder` section. Filed as
     [#1033](https://github.com/2AMLogic/klayout-tools/issues/1033): the
     curated gf180mcu deck's `mim.space.1` rule is a general
     Metal4-to-Metal4 spacing check (its own violation `description` says
     so) that cannot distinguish a real MiM capacitor's bottom plate from
     ordinary Metal4 PDN stripes/routing -- this design has zero capacitor
     devices anywhere.
  3. **LVS** (pre-#100 GDS, see 1a): `klt lvs` reports `status: mismatch` (10 topology mismatches;
     281/281 nets and 25/25 pins otherwise match) -- see
     `layout/lvs_reports/tmds_encoder.lvs.json`/`.txt`. All 10 are P&R-inserted
     filler/tap/endcap standard-cell *types* (`gf180mcu_fd_sc_mcu9t5v0__fill_*`,
     `__filltie`, `__endcap`) that carry no logic and that the pre-P&R
     reference netlist (built from the synthesized netlist, which never
     instantiates them) has no counterpart for -- see
     `layout/scripts/filter_pnr_utility_cells.py`'s own docstring for the
     full accounting.
  4. **Two real, fixed defects, not currently-open ones**: an earlier
     version of this driver's GDS merge step (a) silently dropped most
     Via1/Via2 cut geometry due to a DBU mismatch between
     OpenROAD-flow-scripts' bundled gf180 KLayout tech file
     (`<dbu>0.001</dbu>`) and this design's own tech LEF
     (`DATABASE MICRONS 2000`), and (b), once (a) was fixed, corrupted the
     merged standard-cell geometry's real-world scale by naively merging the
     cell library (native DBU `0.001`) straight into the now-differently-scaled
     top-level layout -- see `flow/pnr_tmds_encoder.py`'s "GDS streamout"
     section for the full root-cause finding for both, the klayout-tools
     issues filed for (a)
     ([#1029](https://github.com/2AMLogic/klayout-tools/issues/1029),
     [#1032](https://github.com/2AMLogic/klayout-tools/issues/1032)), why an
     earlier, now-superseded issue
     ([#1031](https://github.com/2AMLogic/klayout-tools/issues/1031))
     carried the wrong initial diagnosis for (a), and why (b) was not filed
     upstream (a caller-side integration bug in this driver's own first fix
     attempt, not a `klt`/`klayout.db` defect). This driver now corrects
     both before every merge, so the GDS this record cites does not carry
     either defect -- TritonRoute's own internal DRC pass on the routed
     design (see `20260817-105608-049c240.pnr.log`) independently reported zero violations
     throughout, corroborating that the P&R itself was always sound and
     only the merge step was ever at fault.
- **Reproducibility**: working tree clean at commit `049c240a9ee976b888643ff92e8689dbe4e237e8`.
- **Links**:
  - Netlist (input, unmodified): `flow/tmds_encoder/netlist/tmds_encoder.synth.v`
  - Routed DEF: `flow/tmds_encoder/pnr/tmds_encoder.def`
  - Merged GDS: `layout/gds/tmds_encoder.gds`
  - OpenROAD script: `flow/tmds_encoder/reports/20260817-105608-049c240.pnr.tcl`
  - Full OpenROAD log: `flow/tmds_encoder/reports/20260817-105608-049c240.pnr.log`
  - GDS merge log: `flow/tmds_encoder/reports/20260817-105608-049c240.gds_merge.log`
- **Timestamp / author**: 2026-08-17 10:56:08 UTC, `flow/pnr_tmds_encoder.py` (agent-run)
