2AMLogic/gf180-tmds-tx/flow/tmds_encoder/records/20260817-105709-049c240.md

# Record 20260817-105709-049c240

- **Record ID**: 20260817-105709-049c240
- **Claim**: A back-annotated SDF (real per-cell and per-net delays) and its
  underlying extracted-parasitics SPEF exist for the post-route digital
  layout issue #115 produced (routed DEF `flow/tmds_encoder/pnr/tmds_encoder.def`,
  record `20260817-105608-049c240`, git commit `049c240a9ee976b888643ff92e8689dbe4e237e8`) -- the four-stage (DR-0009)
  netlist, place-and-routed through the timing-driven-synthesis + CTS +
  timing-repair machinery issue #100 built and issue #115 extended -- built against the gf180mcu
  `gf180mcu_fd_sc_mcu9t5v0` standard-cell library at the `tt_025C_3v30` corner
  (spec/tmds-tx.md DR-0003's synthesized-domain corner, same as #82/#84/#100).
  Addresses #65 item 7 (post-layout verification) on the digital partition.
- **Scope**: SDF/SPEF extraction only -- delay computation from liberty +
  extracted RC parasitics. No SDC/clock-period constraint is read or assumed
  (see `flow/sdf_tmds_encoder.py`'s "No SDC" section); `report_checks
  -unconstrained` is used only to log the worst-case combinational delay
  found, not to render a setup/hold pass/fail verdict -- that is issue #83's
  (STA) job, not this one's.
- **P&R revision cited**: issue #115's evidence record `20260817-105608-049c240`
  (`flow/tmds_encoder/records/20260817-105608-049c240.md`), routed DEF
  `flow/tmds_encoder/pnr/tmds_encoder.def`, git commit `049c240a9ee976b888643ff92e8689dbe4e237e8`.
- **Tool versions**:
  - OpenROAD/OpenSTA: `26Q3-1278-g4421880472` (run via the `openroad/orfs:latest`
    Docker image -- see `flow/README.md`'s "Pinned toolchain")
  - gf180mcu PDK: variant `gf180mcuD`, open_pdks `c6d73a35f524070e85faff4a6a9eef49553ebc2b` (via GF180_PDK_PATH)
- **RC extraction**:
  - Rule deck: OpenROAD-flow-scripts' bundled gf180 platform typical-corner
    deck, `gf180mcu_1p5m_1tm_9k_sp_smim_OPTB_typ.rules` (config.mk's own
    `TC_RCX_RULES`, RC corner label `FuncRCtyp`) -- see
    `flow/sdf_tmds_encoder.py`'s "RC extraction corner" section for why
    pairing this with the `tt_025C_3v30` liberty corner is not a
    mismatch.
  - Result: 375 nets, 1635 rsegs, 1635 caps, 2388 coupling caps.
- **Worst-case unconstrained combinational delay observed**: 5.18 ns
  (primary input to first register stage, `report_checks -unconstrained`;
  no clock/SDC applied, so this is a delay measurement, not a setup/hold
  verdict -- see "Scope" above).
- **Known limitations (disclosed, not silently worked around)**:
  1. **No SDC / no timing-closure verdict** -- see "Scope" above; issue #83
     owns that question.
  2. **Interconnect (net) delays are 0.000 ns throughout** the extracted
     SDF -- not an extraction failure: this design's core is a compact
     ~158 x 138 um die (see #84's evidence record), so per-net wire RC
     delay genuinely rounds to 0.000 at 3-decimal SDF precision for every
     net checked; corroborated independently by `report_checks` showing
     identical worst-path timing with and without parasitics extracted.
- **Reproducibility**: working tree DIRTY (uncommitted changes outside flow/tmds_encoder/ at run time -- re-run against a clean checkout before trusting this record) at commit `049c240a9ee976b888643ff92e8689dbe4e237e8`.
- **Links**:
  - Routed DEF (input, unmodified): `flow/tmds_encoder/pnr/tmds_encoder.def`
  - SDF: `flow/tmds_encoder/sta/tmds_encoder.sdf`
  - SPEF: `flow/tmds_encoder/sta/tmds_encoder.spef`
  - OpenSTA script: `flow/tmds_encoder/reports/20260817-105709-049c240.sta.tcl`
  - Full OpenSTA log: `flow/tmds_encoder/reports/20260817-105709-049c240.sta.log`
- **Timestamp / author**: 2026-08-17 10:57:09 UTC, `flow/sdf_tmds_encoder.py` (agent-run)
