2AMLogic/gf180-tmds-tx/flow/tmds_encoder/records/20260817-110422-37e197a.md

# Record 20260817-110422-37e197a

- **Record ID**: 20260817-110422-37e197a
- **Claim**: The digital gate-level testbench (`verification/tmds_encoder/
  test_tmds_encoder.py`, unmodified except for its own DR-0009 four-clock-
  latency update -- see that update's own commit for the rationale) passes
  when run against the post-route, SDF-back-annotated gate-level netlist for
  `tmds_encoder` (four-stage (DR-0009) synthesized netlist issue #115
  produced, `flow/tmds_encoder/netlist/tmds_encoder.synth.v`, unmodified,
  timing-annotated via Icarus Verilog's `$sdf_annotate` from the
  back-annotated SDF issue #115's own `flow/sdf_tmds_encoder.py` extracted).
  Addresses #65 item 7 (post-layout verification) on the digital partition,
  and is the check that the DR-0009 restructure -- which changed the
  encoder's internal structure, not just where its registers sit -- still
  encodes correctly once real post-route delays are annotated, rather than
  only in zero-delay RTL simulation.
- **P&R revision cited**: issue #115's evidence record
  `20260817-105608-049c240`
  (`flow/tmds_encoder/records/20260817-105608-049c240.md`), routed DEF
  `flow/tmds_encoder/pnr/tmds_encoder.def`, git commit `37e197aba3dba52bae6601c1cd490c5fc5eedb55`.
- **SDF extraction tool/version cited**: `flow/sdf_tmds_encoder.py`'s own
  evidence record (issue #115, this same issue) -- see that record for the
  OpenROAD/OpenSTA version, RC extraction rule deck, and the worst-case
  unconstrained combinational delay this driver's own `CLOCK_PERIOD_NS`
  margins against (see this module's docstring, "Test clock period").
- **Re-simulation outcome**: PASS -- 3 of 3 cocotb test(s) passed, 0 failed.
- **Simulator**: Icarus Verilog (via cocotb's Python runner API,
  `cocotb_tools.runner`), `-g2005 -gspecify` (specify-block/SDF timing
  enabled; Icarus does not support SDF `TIMINGCHECK` enforcement -- see
  "Known limitations" below).
- **Test clock period**: 50 ns -- not an operating-frequency
  claim; see this module's docstring, "Test clock period", for the full
  margin rationale against the worst-case combinational delay
  `flow/sdf_tmds_encoder.py`'s own record measured for this four-stage
  (DR-0009) revision -- comfortably inside this driver's margin, as it was
  for the DR-0008 (13.27 ns) and pre-pipeline (18.30 ns) revisions before
  it.
- **Known limitations (disclosed, not silently worked around)**:
  1. **Two Icarus Verilog 13.0 parser/runtime limitations required
     mechanical, documented preprocessing** (`ifnone` + edge-sensitive
     specify paths unsupported; `-ginterconnect` could not resolve net
     paths for this plain-`wire` design) -- see
     `flow/gate_level_sim_tmds_encoder.py`'s docstring for the full
     mechanism and why both preprocessing steps preserve the delay
     information that actually matters for this design (per-cell IOPATH
     delays, which dominate this design's timing entirely; extracted
     net-interconnect delays are independently confirmed 0.000 ns
     throughout by `flow/sdf_tmds_encoder.py`'s own evidence record).
  2. **SDF `TIMINGCHECK` (`$setup`/`$hold`) is not enforced by Icarus** --
     a too-tight clock period would not show as a hard violation the way a
     full SDF-aware simulator's `notifier`-driven X-forcing would; this is
     why `CLOCK_PERIOD_NS` above carries an explicit, generous margin
     rather than relying on the simulator to catch a too-tight choice.
  3. **No formal setup/hold timing-closure verdict is made here** -- this
     driver demonstrates functional equivalence under real back-annotated
     delays at a deliberately conservative test clock; a formal
     timing-closure / achievable-operating-frequency claim is issue #83's
     (STA) job, not this one's.
- **Reproducibility**: working tree clean at commit `37e197aba3dba52bae6601c1cd490c5fc5eedb55`.
- **Links**:
  - Gate-level netlist (input, unmodified): `flow/tmds_encoder/netlist/tmds_encoder.synth.v`
  - Back-annotated SDF (input, unmodified): `flow/tmds_encoder/sta/tmds_encoder.sdf`
  - Test module (input, unmodified): `verification/tmds_encoder/test_tmds_encoder.py`
  - Build log: `flow/tmds_encoder/reports/20260817-110422-37e197a.gl_sim.build.log`
  - Test log: `flow/tmds_encoder/reports/20260817-110422-37e197a.gl_sim.test.log`
  - Driver: `flow/gate_level_sim_tmds_encoder.py`
- **Timestamp / author**: 2026-08-17 11:04:22 UTC, `flow/gate_level_sim_tmds_encoder.py` (agent-run)
