2AMLogic/gf180-tmds-tx/flow/tmds_encoder/records/20260817-110611-37e197a.md

# Record 20260817-110611-37e197a

- **Record ID**: 20260817-110611-37e197a
- **Claim**: Static timing analysis (setup **and** hold) has been re-run
  (issue #115, following #83's original pre-timing-driven-synthesis,
  pre-CTS record `20260816-172539-930e864`, #100's post-timing-driven-
  synthesis/CTS record `20260817-001614-064d550`, and #110's DR-0008
  single-pipeline-register record `20260817-012556-7d9130d`) on the
  four-stage gate-level netlist issue #115 produced -- `rtl/tmds_encoder.v`
  is now the four-stage pipeline `spec/tmds-tx.md` DR-0009 specifies
  (S1 popcount/threshold, S2 parallel-prefix transition-minimized word,
  S3 accumulator-independent DC-balance candidates, S4 decision +
  accumulator recurrence), run through the timing-driven-synthesis + CTS +
  timing-repair machinery issue #100 built and issue #115 extended
  (sequential-overhead-corrected ABC delay target, two-corner P&R timing
  view with explicit CTS root/tree buffers and placement-stage layer RC, and
  a `repair_timing -setup` pass -- every one of which constrains the design
  *more* tightly, not less; see DR-0009's "Consequences") -- as physically
  realized by issue #115's own routed layout with issue #115's own
  re-extracted post-route parasitics back-annotated, across all five 3.3 V
  liberty corners the `gf180mcu_fd_sc_mcu9t5v0` library ships, at both of
  `spec/tmds-tx.md` §2's pixel-clock rates. Addresses #65 item 5 (full
  corner verification vs. the ratified spec) on the digital partition, and
  supplies the measurement DR-0007 (which resolved DR-0003's open item to
  "an architecture change is needed"), DR-0008 (the first such change) and
  DR-0009 (this one) require -- this record specifically measures whether
  DR-0009 closed the 720p60 setup violations DR-0008's own record still had
  at `ss_125C_3v00` and `ss_n40C_3v00`.
- **Verdict (setup, 720p60 target, 74.25 MHz)**: **PASS** -- setup met at every corner.
- **Verdict (setup, 480p fallback, 27.000 MHz)**: **PASS** -- setup met at every corner.
- **Verdict (hold, all corners and both targets)**: **PASS** -- hold met at every corner, at both targets
  (hold is clock-period-independent, so both targets give the same answer).
- **Measured Fmax**: **75.83 MHz** worst-corner, 148.96 MHz typical
  (whole design, i.e. including the input-port-to-register path); the
  register-to-register subset alone reaches 75.83 MHz worst-corner.
  This is exact rather than extrapolated -- nothing is re-synthesized between
  constraints, so path delays are constraint-independent and `period - slack` is
  the true critical-path requirement.
- **Netlist revision analyzed** (the exact revision, verified, not just cited):
  - Netlist: `flow/tmds_encoder/netlist/tmds_encoder.synth.v`, issue #115's four-stage
    (DR-0009), timing-driven synthesis evidence record `20260817-105547-049c240` --
    SHA-256 `dea60b1b9d296a9467c60f9174737167b0ec160332e9b2f7745252ef09a719a6`
  - Routed DEF: `flow/tmds_encoder/pnr/tmds_encoder.def`, issue #115's CTS/timing-repair
    record `20260817-105608-049c240` -- SHA-256 `5a887d9a2bdcc15699340192b7568f41dcc01909b4f707e6110ecfbec502c890`
  - Parasitics (SPEF): `flow/tmds_encoder/sta/tmds_encoder.spef`, issue #115's
    post-CTS extraction record `20260817-105709-049c240` -- SHA-256 `e4c394358b7dc448186a6f1dcf6d39b850117feb41bc64bea0db98f761cd1e1e`
  - Netlist/DEF consistency **checked mechanically**, not assumed: all
    342 netlist instances are present in the routed DEF with matching
    cell *functions*; the DEF's only additional components are the
    970 physical-only cells P&R inserts (filler/tap/endcap) and
    27 cells clock-tree synthesis / timing repair inserted
    (DEF `SOURCE TIMING`-marked -- issue #100 introduced this CTS/hold-repair
    machinery, reused here; these have no netlist counterpart by
    design, since the netlist predates CTS). See
    `assert_def_matches_netlist` in `flow/sta_tmds_encoder.py`.
  - **Instances `repair_timing -setup` resized** (3, enumerated rather
    than counted -- issue #115; a drive-strength difference is the *only*
    netlist-vs-DEF cell difference this driver accepts, and it re-checks that
    the logic function is unchanged for every one of them):
    - `_278_: gf180mcu_fd_sc_mcu9t5v0__oai21_1 -> gf180mcu_fd_sc_mcu9t5v0__oai21_2`
    - `_322_: gf180mcu_fd_sc_mcu9t5v0__oai31_1 -> gf180mcu_fd_sc_mcu9t5v0__oai31_2`
    - `_339_: gf180mcu_fd_sc_mcu9t5v0__oai31_1 -> gf180mcu_fd_sc_mcu9t5v0__oai31_2`
- **Tool versions**:
  - OpenSTA: bundled in OpenROAD `26Q3-1278-g4421880472` (run via the `openroad/orfs:latest`
    Docker image -- see `flow/README.md`'s "Pinned toolchain")
  - gf180mcu PDK: variant `gf180mcuD`, open_pdks `c6d73a35f524070e85faff4a6a9eef49553ebc2b` (via GF180_PDK_PATH)
- **Corners checked** (5, every 3.3 V corner the library ships --
  `gf180mcu_fd_sc_mcu9t5v0__<corner>.lib`):
  - `tt_025C_3v30` -- typical process, 25 C, 3.30 V (DR-0003's corner; #82/#84/#85's)
  - `ss_125C_3v00` -- slow process, 125 C, 3.00 V (worst case for setup)
  - `ss_n40C_3v00` -- slow process, -40 C, 3.00 V
  - `ff_125C_3v60` -- fast process, 125 C, 3.60 V
  - `ff_n40C_3v60` -- fast process, -40 C, 3.60 V (worst case for hold)
- **Corner reconciliation** (carried over from #85's own test plan, which asked
  its successor to confirm the SDF corner matches this analysis's): reconciled,
  no mismatch. The re-extracted SDF/SPEF (issue #115, record `20260817-105709-049c240`)
  were built at `tt_025C_3v30`, one of the five corners analyzed here; the other
  four re-time the same extracted parasitics against a different liberty corner
  (see "Known limitations" 2).
- **Constraints applied** (`flow/tmds_encoder/sta/tmds_encoder.sdc`, generated by the
  driver; per-run copies at `flow/tmds_encoder/reports/20260817-110611-37e197a.sta_<target>.sdc`):
  - `create_clock -period 13.4680` (720p60, 74.25 MHz) and
    `-period 37.0370` (480p fallback, 27 MHz), both from
    `spec/tmds-tx.md` §2 -- not invented here.
  - `set_input_delay 0` / `set_output_delay 0`: no ratified block-boundary budget
    exists, so none is assumed. This is the *most optimistic* legal choice, so a
    violation reported under it is a real violation, not a budgeting artifact.
  - `set_driving_cell gf180mcu_fd_sc_mcu9t5v0__inv_1` on inputs, `set_load 0.027252` (4x that
    cell's own 0.006813 pF input capacitance) on outputs -- stated
    assumptions, not measurements.
  - `set_propagated_clock`, `set_clock_uncertainty 0`: `flow/pnr_tmds_encoder.py`
    now runs CTS (issue #100), so the real, CTS-balanced clock net's delay is
    propagated; no margin beyond what `clock_tree_synthesis` itself targets is
    layered on. See "Known limitations" 1.

## Results -- 720p60 target (74.25 MHz pixel clock, 13.4680 ns)

| Corner | Setup (whole design) | Setup (reg-to-reg) | Hold (whole design) | Setup TNS | Clock skew | Fmax |
|---|---|---|---|---|---|---|
| `tt_025C_3v30` | PASS +6.7550 ns (0 viol. endpoints) | PASS +6.7550 ns | PASS +0.4811 ns (0 viol. endpoints) | +0.00 ns | 0.0080 ns | 148.96 MHz |
| `ss_125C_3v00` | PASS +0.2799 ns (0 viol. endpoints) | PASS +0.2799 ns | PASS +0.9115 ns (0 viol. endpoints) | +0.00 ns | 0.0162 ns | 75.83 MHz |
| `ss_n40C_3v00` | PASS +4.2895 ns (0 viol. endpoints) | PASS +4.2895 ns | PASS +0.6566 ns (0 viol. endpoints) | +0.00 ns | 0.0099 ns | 108.95 MHz |
| `ff_125C_3v60` | PASS +7.9050 ns (0 viol. endpoints) | PASS +7.9050 ns | PASS +0.3815 ns (0 viol. endpoints) | +0.00 ns | 0.0071 ns | 179.76 MHz |
| `ff_n40C_3v60` | PASS +9.5244 ns (0 viol. endpoints) | PASS +9.5244 ns | PASS +0.2703 ns (0 viol. endpoints) | +0.00 ns | 0.0067 ns | 253.58 MHz |

## Results -- 480p fallback (27 MHz pixel clock, 37.0370 ns)

| Corner | Setup (whole design) | Setup (reg-to-reg) | Hold (whole design) | Setup TNS | Clock skew | Fmax |
|---|---|---|---|---|---|---|
| `tt_025C_3v30` | PASS +30.3240 ns (0 viol. endpoints) | PASS +30.3240 ns | PASS +0.4811 ns (0 viol. endpoints) | +0.00 ns | 0.0080 ns | 148.96 MHz |
| `ss_125C_3v00` | PASS +23.8489 ns (0 viol. endpoints) | PASS +23.8489 ns | PASS +0.9115 ns (0 viol. endpoints) | +0.00 ns | 0.0162 ns | 75.83 MHz |
| `ss_n40C_3v00` | PASS +27.8585 ns (0 viol. endpoints) | PASS +27.8585 ns | PASS +0.6566 ns (0 viol. endpoints) | +0.00 ns | 0.0099 ns | 108.95 MHz |
| `ff_125C_3v60` | PASS +31.4740 ns (0 viol. endpoints) | PASS +31.4740 ns | PASS +0.3815 ns (0 viol. endpoints) | +0.00 ns | 0.0071 ns | 179.76 MHz |
| `ff_n40C_3v60` | PASS +33.0934 ns (0 viol. endpoints) | PASS +33.0934 ns | PASS +0.2703 ns (0 viol. endpoints) | +0.00 ns | 0.0067 ns | 253.58 MHz |

- **Worst setup path (all runs)**: +0.2799 ns at corner
  `ss_125C_3v00`, 720p60 target -- startpoint `_592_ (rising edge-triggered flip-flop clocked by clk)`,
  endpoint `_599_ (rising edge-triggered flip-flop clocked by clk)`, data arrival 13.9254 ns.
- **Worst hold path (all runs)**: +0.2703 ns at corner
  `ff_n40C_3v60`.
- **DR-0003's flagged intermediate rate (371.25 MHz, 5x pixel clock)**:
  not met by this netlist (75.83 MHz worst-corner Fmax, 0.20x the required rate). That rate belongs
  to the not-yet-written 10:1->2:1 serializer, not to this encoder, so this is not
  a violation of anything this block promises -- but it is the first *measurement*
  against DR-0003's open item, and it says the ceiling is well below 5x pixel rate
  for area-mapped logic of this depth.

## Known limitations (disclosed, not silently worked around)

1. **Post-CTS hold verdict, but at a single P&R corner.** `flow/pnr_tmds_encoder.py`
   now runs clock-tree synthesis and `repair_timing -hold` (issue #100) at the
   `tt_025C_3v30` corner its own liberty uses -- so this record's hold verdict,
   unlike #83's original pre-CTS one, reflects real CTS-inserted buffer/skew and
   real hold-repair delay cells. It is not, however, a hold repair run *per
   corner*: CTS/hold-repair ran once, against one corner's timing, and this
   analysis then re-times that one fixed physical implementation at all five
   corners. A hold violation that only manifests at a corner CTS/hold-repair did
   not optimize against would not have been caught by `repair_timing`, though it
   would still be caught and reported here, since this driver re-checks hold at
   every corner independently of what corner produced the layout.
2. **One RC corner, five liberty corners.** The post-CTS re-extraction (issue
   #115, record `20260817-105709-049c240`) used the gf180 platform's typical
   (`FuncRCtyp`) RCX deck only, same as every earlier extraction in this
   chain; this analysis reuses that single SPEF at all five liberty
   corners. #85 established that post-route net delays on this die round to
   0.000 ns at 3-decimal precision, so the liberty corner dominates -- but
   this is an approximation, and re-extraction per RC corner is the right
   thing to do once interconnect matters.
3. **Timing-driven synthesis maps against one worst-case corner's liberty, not
   an on-chip-variation-derated multi-corner target.** Issue #100's
   `flow/synth_tmds_encoder.py` targets ABC's `-D` delay constraint using the
   `ss_125C_3v00` liberty specifically (per #83's own record, the worst setup
   corner of the five checked) rather than a formal multi-corner sign-off flow;
   issue #115 reuses this unchanged for the four-stage RTL, with the ABC
   delay target now corrected for sequential overhead (DR-0009). This is
   disclosed reasoning, not an unstated assumption (see that script's
   docstring), and this record's own multi-corner re-check is exactly the
   verification step that confirms (or does not confirm) it actually
   worked -- see the Results tables above for the corner-by-corner outcome.
4. **The 720p60 setup margin at the worst corner is small.** It is met at every corner, but the worst of them (ss_125C_3v00) has +0.2799 ns of it against a 13.4680 ns period -- 2.1%. That is a genuine pass under this record's own (deliberately pessimistic, see 'Constraints applied') boundary assumptions, and it is not a comfortable one: it leaves little room for a later netlist change, a floorplan change, or on-chip variation derating this flow does not yet model. Treat 720p60 as closed but margin-limited, not as closed with headroom.
5. **`repair_timing -setup` upsizes existing instances, so the routed DEF can
   name a different drive strength than the committed netlist** (issue #115).
   Every such resize is enumerated by name above, and this driver re-checks
   that the logic *function* is identical for each; a function change, a
   missing instance, or an unexplained component still fails the run. The
   gate-level re-simulation (`flow/gate_level_sim_tmds_encoder.py`) simulates
   the committed netlist's cell types with this layout's extracted SDF
   annotated onto it -- the same additive approximation that flow already
   makes for CTS/hold-repair-inserted buffers, and a smaller one, since a
   drive-strength variant has identical pins, identical function, and
   identical `specify` paths.

- **Reproducibility**: working tree clean at commit `37e197aba3dba52bae6601c1cd490c5fc5eedb55`.
- **Links**:
  - Netlist (input, unmodified): `flow/tmds_encoder/netlist/tmds_encoder.synth.v`
  - Routed DEF (input, unmodified): `flow/tmds_encoder/pnr/tmds_encoder.def`
  - Parasitics (input, unmodified): `flow/tmds_encoder/sta/tmds_encoder.spef`
  - Constraints: `flow/tmds_encoder/sta/tmds_encoder.sdc`
  - Per-run OpenSTA scripts / logs:
    `flow/tmds_encoder/reports/20260817-110611-37e197a.sta_<corner>_<target>.tcl` / `.log`
- **Timestamp / author**: 2026-08-17 11:06:11 UTC, `flow/sta_tmds_encoder.py` (agent-run)
