2AMLogic/gf180-tmds-tx/layout/lvs_reports/gf180_tmds_pad_ring_assembly.lvs.txt

layout: ../gds/gf180_tmds_pad_ring_assembly.gds
reference: gf180_tmds_pad_ring_assembly.ref.spice
top: gf180_tmds_pad_ring_assembly
reference top: GF180_TMDS_PAD_RING_ASSEMBLY
engine: klayout
status: match
mismatches: 2
errors: 0
  nets: layout=8  reference=8  matched=8
  devices: layout=8  reference=8  matched=8
  pins: layout=8  reference=7  matched=8
power_connectivity: unchecked
  (reference.form is 'plain-element', whose reference netlist carries its own power/ground pins and nets -- they take part in the ordinary compare, so this check (which exists to cover the signal-only 'gate-level-verilog' form) does not apply)

category_counts:
  topology: 2

[warning] topology  (layout)  device class has no counterpart on the other side, but no devices of this class were extracted either -- not a real topology mismatch
[warning] topology  (layout)  device class has no counterpart on the other side, but no devices of this class were extracted either -- not a real topology mismatch
