2AMLogic/gf180-tmds-tx/layout/lvs_reports/gf180_tmds_pad_ring_assembly_shorted.lvs.txt

layout: ../gds/gf180_tmds_pad_ring_assembly_shorted.gds
reference: gf180_tmds_pad_ring_assembly_shorted.ref.spice
top: gf180_tmds_pad_ring_assembly_shorted
reference top: GF180_TMDS_PAD_RING_ASSEMBLY_SHORTED
engine: klayout
status: mismatch
mismatches: 7
errors: 5
  nets: layout=6  reference=7  matched=3
  devices: layout=6  reference=6  matched=4
  pins: layout=6  reference=6  matched=8

category_counts:
  device.unmatched: 2
  net.merged: 2
  net.split: 1
  topology: 2

[error] device.unmatched  (reference)  device has no counterpart on the other side
[error] device.unmatched  (reference)  device has no counterpart on the other side
[error] net.merged  (reference)  multiple reference nets were collapsed into one layout net
[error] net.merged  (reference)  multiple reference nets were collapsed into one layout net
[error] net.split  (layout)  a reference net's role is divided across multiple layout nets
[warning] topology  (layout)  device class has no counterpart on the other side, but no devices of this class were extracted either -- not a real topology mismatch
[warning] topology  (layout)  device class has no counterpart on the other side, but no devices of this class were extracted either -- not a real topology mismatch
