2AMLogic/gf180-tmds-tx/layout/drc_reports/gf180_tmds_pad_ring_assembly.drc.txt

file: gds/gf180_tmds_pad_ring_assembly.gds
deck: gf180mcu
dbu_um: 0.001
status: clean
violations: 0
unchecked layers in stream: 5
