2AMLogic/gf180-tmds-tx/measurements/characterization.md

# Block characterization report

This is the single aggregated, current summary of what this block's recorded
evidence actually substantiates against the ratified spec
(`spec/tmds-tx.md`), per spec row. It is written for Epic #17's T1
sim-validated (bronze) evidence-tier ladder: one artifact, citing every
evidence record against the specific spec row it verifies, and naming what
is not yet covered explicitly rather than leaving it to be inferred from
silence.

Per CLAUDE.md ("Verification is the product: no claim without a
testbench... recorded results are append-only evidence"), every verdict
below cites a specific evidence record — `sim/*/records/*.md` for the analog
CML-driver partition (§1), `flow/tmds_encoder/records/*.md` plus
`verification/tmds_encoder/` for the digital encoder partition (§2). This
document makes no claim beyond what those records already state — it is a
index and rollup, not new measurement work. `measurements/` itself stays
otherwise empty until tape-out (see `measurements/README.md`), consistent
with this being a design/simulation-stage rollup, not a silicon
characterization.

**Convention**: this document is not append-only in the `sim/` sense — it is
expected to be revised in place as evidence accumulates (a new record lands,
a coverage gap closes). Each cited record itself remains the append-only
source of truth; this document only ever needs to be re-pointed at the
latest one.

## 1. Spec-row coverage

`spec/tmds-tx.md` §1's target parameter table and its decision records
(DR-0001 through DR-0006) are the rows below. Only rows with a recorded
`sim/` evidence record are listed as "covered" — a row not listed here has
no simulation evidence at all yet.

### DR-0002 — driver topology and supply (swing, common mode, device stress)

| Sub-claim | Verdict | Evidence record | Notes |
|---|---|---|---|
| Single-ended swing 400–600 mV into 50 Ω/leg, ~10 mA tail | **PASS** | [`sim/cml-driver-eye/records/20260810-041436-a2c358b.md`](../sim/cml-driver-eye/records/20260810-041436-a2c358b.md) | Full PVT × both rates (90 points). Measured 481.2–518.9 mV across every pad-cap point (0/1/2 pF) and both rates — see `design/cml-driver-sizing.md` §7's summary table. |
| Common mode 2.8–3.3 V at nominal AVCC = 3.3 V | **PASS** | same record | 3.041–3.054 V across the full PVT × rate × pad-cap grid at nominal supply. |
| Common mode across the ±10 % supply-corner sweep | **PASS, against DR-0006's qualified reading** | same record | At AVCC = 2.97 V/3.63 V, common mode reaches 2.711 V / 3.384 V — outside DR-0002's original flat 2.8–3.3 V window taken literally, but DR-0006 (`spec/tmds-tx.md` §4) ratifies the window as a nominal-AVCC-3.3 V figure with this measured 1:1 supply-tracking as the explicit qualifier. Graded against DR-0006, every row in this record PASSes; graded against DR-0002's original unqualified text, the supply-corner rows do not. Both readings are stated here, per DR-0006's own correction of `design/cml-driver-sizing.md`'s earlier framing. |
| `Vgs`/`Vgd`/`Vds` margin against the 3.3 V core devices' rated limit (deferred to driver design work by DR-0002) | **PASS** | same record | Worst measured stress 2.761 V (`vds_sw_max`, `ss_-40c_2.97v`) against the adopted 3.63 V rated ceiling — positive margin at every corner. |
| Remaining (serializer+driver+board) jitter allocation, ≤ 0.15 UI p-p (spec/tmds-tx.md §2) | **PASS** | same record | Driver's own deterministic-jitter contribution measured ≤ 3.56×10⁻⁵ UI at 2 pF pad load (full PVT, both rates) — several thousand times inside the 0.15 UI budget. This measures the driver stage only. The DR-0003 final multiplexer's own contribution (mux-plus-driver, not driver-alone) is now also measured — see the "DR-0002 — driver rows re-measured with the real DR-0003 mux" subsection below (issue #159, full 5-corner grid landed by issue #163): ≤ 5.79×10⁻⁵ UI across the complete `tt`/`ff`/`ss`/`fs`/`sf` process-corner grid, still several thousand times inside budget (see §3 below). |
| Tail-current tolerance (this cell's own derived requirement, §2 of `design/cml-driver-sizing.md`, not a `spec/tmds-tx.md` row) | **PASS** (informative, not spec-bound) | same record | 9.822–10.327 mA across the full PVT matrix, inside the design's own derived 8–12 mA tolerance. |

#### DR-0002, post-layout (extracted) corroboration

[`sim/cml-driver-eye/records/20260815-072956-34e5253.md`](../sim/cml-driver-eye/records/20260815-072956-34e5253.md)
re-runs **the same testbench deck, manifest, measurements and checks** as the
schematic record above — same 90-point PVT × rate grid — against the
layout-extracted netlist of the DRC/LVS-signed-off cell
(`layout/gds/cml_driver_core.gds` → `layout/gds/cml_driver_core.spice` →
`layout/sim/cml_driver_core_dut.spice`, issue #22 / issue #34). Every row in
the schematic table above holds against the extracted netlist too:

| Sub-claim | Schematic record | Extracted record | Verdict |
|---|---|---|---|
| Single-ended swing, 400–600 mV | 481.2–518.9 mV | 481.2–519.0 mV | **PASS**, unchanged |
| Common mode at nominal AVCC | 3.041–3.054 V | 3.041–3.054 V | **PASS**, unchanged |
| Common mode at ±10 % supply | 2.711 V / 3.384 V | 2.711 V / 3.384 V | same DR-0006 qualified reading as above |
| Worst device stress vs. the 3.63 V ceiling | 2.761 V (`vds_sw_max`, `ss_-40c_2.97v`) | 2.757 V (`vds_sw_max`, `ss_-40c_2.97v`) | **PASS**, unchanged |
| Driver's own deterministic jitter, ≤ 0.15 UI p-p | ≤ 3.56×10⁻⁵ UI at 2 pF | ≤ 5.79×10⁻⁵ UI at 2 pF | **PASS**, unchanged |
| Tail current, 8–12 mA derived tolerance | 9.822–10.327 mA | 9.822–10.327 mA | **PASS**, unchanged |

**The measured deltas, and why they are what they are.** The corner-by-corner
comparison is computed, not transcribed —
`python3 sim/compare_records.py cml-driver-eye 20260810-041436-a2c358b 20260815-072956-34e5253`
reproduces the full 46-measurement table; **no corner changed verdict**. The
deltas fall into three groups:

1. **DC operating point: unchanged to within 0.01 %.** Swing ≤ +0.010 %,
   common mode ≤ 0.001 %, tail current ≤ 0.001 %, single-ended output
   resistance ≤ 0.11 %, worst-case device stress ≤ 0.73 % (`vgs_sw_max`) —
   all far below any corner-to-corner variation. This is the expected
   result and it is the useful one: the drawn cell's total device widths,
   channel lengths and the 1:20 mirror ratio come out of the layout equal
   to the sized schematic's, so the bias point the swing/common-mode claim
   rests on is a property of the drawn geometry, not of the schematic's
   idealisation of it.
2. **Edge rate at the unloaded pad point: +2 to +4.4 %, from junction
   capacitance.** `trise_c0`/`tfall_c0` (0 pF pad) move by up to +4.39 %
   (41.2 → 43.0 ps at `ff_-40c_3.30v_270mbps`), with `vpp_c0` following at
   up to +1.35 %. The same measurement at the 1 pF and 2 pF pad points moves
   by ≤ 0.58 %. That ratio is the signature of a small fixed capacitance
   added at the output node: fitting rise time against the swept pad
   capacitance gives an unloaded output-node capacitance of **≈ 404 fF
   (schematic) vs. ≈ 418 fF (extracted) — about +14 fF, ~3.5 %**. The cause
   is the difference between xschem's folded-device `AS`/`AD`/`PS`/`PD`
   estimate for `nf=64`/`m=20` devices and the extractor's per-finger
   measurement of the *drawn* diffusion shapes (338 separate finger
   devices, shared diffusions split between neighbours). It is a real
   post-layout effect, it is small, and it is bounded: at the ≥ 1 pF pad
   loading DR-0005's budget actually contemplates it is under 0.6 %.
3. **Deterministic jitter: at the measurement's own resolution floor.**
   The `dj_ui_*` relative deltas look enormous (up to +3700 %) purely
   because the baseline is near zero. In absolute terms the worst delta is
   **+4.23×10⁻⁵ UI** and the worst extracted value is 5.79×10⁻⁵ UI, against
   a 0.15 UI allocation — three to four orders of magnitude inside it. For
   scale, one `.tran` print step (10 ps) is 7.4×10⁻⁶ UI at 742.5 Mbps and
   2.7×10⁻⁶ UI at 270 Mbps, i.e. the deltas are a handful of print steps on
   a crossing-time difference. The same reasoning covers `ioff_dc`'s
   +5057 % worst relative delta: that is a sub-nanoamp leakage figure
   (2.1×10⁻¹⁰ A at the corner in question) and the worst *absolute* change
   anywhere on the grid is −1.5×10⁻⁷ A.

**What this post-layout run does and does not model** (stated here as well as
in the record's own **Claim** field, per the coverage-honesty requirement in
§3 below — a post-layout label is worth nothing if the reader has to guess
what was extracted):

- **Modelled**: the drawn device geometry of the real cell — 338 extracted
  per-finger `nfet` devices, each carrying its own drawn `W`/`L` and its own
  drawn source/drain junction area and perimeter (`AS`/`AD`/`PS`/`PD`), with
  shared diffusions split between neighbouring fingers — plus the drawn
  intra-cell connectivity, DRC-clean and LVS-matched against the sized
  schematic (issue #22's reports under `layout/drc_reports/`,
  `layout/lvs_reports/`).
- **Not modelled — interconnect parasitic R/C.** The source extraction is
  *schematic-equivalent* (devices + connectivity); `klt extract --parasitics`
  was **not** used. Intra-cell metal resistance, coupling capacitance and
  wiring capacitance to ground are absent. **This is therefore device-level
  post-layout evidence, not parasitic-RC post-layout evidence** — see §3
  item 2 for what remains open because of it.
- **Not modelled — diffusion sheet resistance.** The extraction carries no
  `NRD`/`NRS`, so `nfet_03v3`'s zero defaults apply; the schematic DUT states
  them (1.406 mΩ/sq-count on the switches, 9 mΩ on the mirror).
- **Not modelled — substrate resistance.** gf180mcu has no distinct
  substrate-tap layer, so `klt` ties every device body to a single
  deck-synthesized global net `vsubs` regardless of the drawn tap geometry
  (`klt lvs` reports this as its own `device.body_unverified` warning). The
  DUT wrapper ties `vsubs` to `VSS` — the sized schematic's own intended tie
  for this NMOS-only cell in the common p-substrate — so the *topology* is
  right but the resistance between taps is not represented.
- **Not modelled — anything outside the core cell.** No pad, no ESD clamp,
  no package and no board. Pad capacitance is still swept in-deck at
  0/1/2 pF and the 50 Ω/leg termination is still the testbench's ideal load,
  exactly as in the schematic record.
- **PDK-variant caveat.** The layout and its extraction were produced against
  `gf180mcuC`; this simulation uses the `gf180mcuD` models `sim/pdk.json`
  pins (same open_pdks revision). That discrepancy is the same one §3 item 1
  describes and is owned by issue #9 — it is not resolved by this record.

The record sets **Supersedes**: `20260810-041436-a2c358b`, which
`sim/README.md` designates for "a post-layout extracted re-run that reports a
schematic-vs-extracted delta against the schematic-level record". That is a
pointer for the delta, **not** a statement that the schematic record was
wrong: nothing in the schematic record is corrected here, and both remain
citable (the schematic record is the one that states `NRD`/`NRS`; this one is
the one taken against the drawn geometry).

#### DR-0002, block-level (assembly, extracted-with-parasitics) corroboration

[`sim/cml-driver-eye/records/20260905-193624-231b75c.md`](../sim/cml-driver-eye/records/20260905-193624-231b75c.md)
(issue #154 / Epic #542 Phase 3A, landed 2026-09-05) runs **the same
testbench deck, manifest, measurements and checks** as the two records
above, against a third, strictly larger-coverage DUT: the **assembled**
driver+pad-ring/ESD block
([`layout/gds/gf180_tmds_pad_ring_assembly.gds`](../layout/gds/gf180_tmds_pad_ring_assembly.gds),
issue #86/#149), extracted **with interconnect parasitic R/C**
(`klt extract --deck gf180mcu --parasitics`), bound to a simulatable form
by `layout/scripts/gen_pad_ring_assembly_dut.py` →
`layout/sim/gf180_tmds_pad_ring_assembly_dut.spice`. This is the first
electrical/PVT record of the assembled block — until this record, only its
structural DRC/LVS signoff existed (§3 item 2's stated gap). The full
5-corner `mos` corner-set is now landed for this DUT/testbench pair, across
four additional appended records (issue #161) that each run the identical
deck, manifest, measurements and checks against one more process corner:

- `tt` — [`sim/cml-driver-eye/records/20260905-193624-231b75c.md`](../sim/cml-driver-eye/records/20260905-193624-231b75c.md) (issue #154, PASS)
- `ff` — [`sim/cml-driver-eye/records/20260905-213837-a2b1051.md`](../sim/cml-driver-eye/records/20260905-213837-a2b1051.md) (issue #161, PASS)
- `ss` — [`sim/cml-driver-eye/records/20260905-222410-a2b1051.md`](../sim/cml-driver-eye/records/20260905-222410-a2b1051.md) (issue #161, PASS)
- `fs` — [`sim/cml-driver-eye/records/20260905-225202-a2b1051.md`](../sim/cml-driver-eye/records/20260905-225202-a2b1051.md) (issue #161, PASS)
- `sf` — [`sim/cml-driver-eye/records/20260905-232931-a2b1051.md`](../sim/cml-driver-eye/records/20260905-232931-a2b1051.md) (issue #161, PASS)

All five corners report **Overall: PASS** in their own **Result** field — 90
of 90 mandated `mos` corner-set × rate points now have electrical/PVT
evidence for the assembled block. Each record's own **Corner matrix run**
field still discloses that it individually covers one process corner (per
`sim/README.md`'s subset-reason convention) — the full-matrix claim below is
the union of all five, not any single record's own scope.

| Sub-claim | Verdict | Notes |
|---|---|---|
| Single-ended swing 400–600 mV | **PASS** | 480.5–517.8 mV across all five corners' grids below (0/1/2 pF pad cap, both rates) — worst-case low at `ss_125c_2.97v_742p5mbps`, worst-case high at `ff_-40c_3.63v_742p5mbps` |
| Common mode 2.8–3.3 V at nominal AVCC | **PASS** | 3.0403–3.0543 V across all five corners |
| Common mode across the ±10 % supply-corner sweep | **PASS, against DR-0006's qualified reading** | 2.7108–2.7245 V / 3.3704–3.3840 V at AVCC = 2.97 V/3.63 V across all five corners — same DR-0006 supply-tracking qualification as the core-cell records above |
| Worst device stress vs. the 3.63 V rated ceiling | **PASS** | Worst measured 2.75438 V (`vds_sw_max`, `ss_-40c_2.97v_742p5mbps`) — 0.876 V of margin to the 3.63 V ceiling, consistent with the core-extracted record's own 2.757 V worst case |
| Driver's own deterministic jitter, ≤ 0.15 UI p-p | **PASS** | ≤ 1.0395×10⁻⁴ UI worst case (2 pF pad, `ff` corner) — three orders of magnitude inside budget |
| Tail-current tolerance (8–12 mA, informative) | **PASS** | 9.823–10.329 mA across all five corners |

**Full matrix landed, subset caveat dropped.** The `tt`-only record's
original disclosure (minted under load average 50+ from unrelated
concurrent jobs, per `sim/README.md`'s subset-reason convention) is
unchanged and still stands as evidence for the `tt` corner on its own — the
four follow-up records (issue #161) close the remaining `ff`/`ss`/`fs`/`sf`
gap it named, each landed one corner at a time (`-j` reduced and per-point
timeout raised after an initial `-j8`/300 s attempt mostly timed out under
host contention) for the same reason the original record gave for not
attempting the full matrix in one invocation.

**What this newly models, relative to the core-only post-layout record
above** (stated per the coverage-honesty requirement, same as that
record's own disclosure):

- **The real diode-clamp ESD structure** (`diode_nd2ps_06v0`, 40 fingers —
  20 per pad), previously simulated only in isolation
  (`sim/esd-diode-clamp-cv`), now in circuit with the driver.
- **Real interconnect parasitic R/C** (`klt extract --parasitics`) — the
  gap the core-only record's own disclosure names by name ("no interconnect
  parasitic R/C"): 338 extracted per-finger `nfet_03v3` devices plus ~1400
  parasitic resistors and 10 coupling/ground capacitors, DR-0005's own
  budget-measurement extraction (`design/esd-capacitance-budget.md` §10.5).
- **The real drawn 25×25 µm bond pad**, not an idealized in-deck
  capacitance sweep standing in for it — the testbench's own 0/1/2 pF
  `c0`/`c1`/`c2` copies now stack on top of this DUT's real on-die parasitic
  (≈0.094 pF `OUTP` / 0.075 pF `OUTN`, §1's DR-0005 table above), rather
  than approximating the whole pad as they did against the bare-core DUT.

**What this does not add** (same two limits the core-only record's own
disclosure already names, unaffected by this record): no package, no board,
no bond wire; no HBM/CDM ESD pulse event (the clamp diodes are in the
small-signal/operating-point circuit only, issue #145's separate,
structurally-unaddressable pre-silicon gap).

This record's own netlist was **taken against a dirty working tree** (its
own **Netlist provenance** field states this) — the same caveat several
earlier records in this table carry (e.g. `sim/esd-clamp-cv`'s own record);
not citable as a clean-tree result on its own, but nothing about the DUT
translation itself is tree-state-dependent (`sim/tests/test_pad_ring_assembly_dut.py`'s
25 tests assert the translation mechanically, independent of any particular
commit).

#### DR-0002, Monte Carlo device-mismatch corroboration

[`sim/cml-driver-mismatch/records/20260815-044555-9e8a33a.md`](../sim/cml-driver-mismatch/records/20260815-044555-9e8a33a.md)
(issue #23, landed 2026-08-15) adds **statistical** evidence on top of the
deterministic corner sweep above: gf180mcu's own Pelgrom-law local
(intra-die) mismatch injection (`nfet_03v3_dss` with `sw_stat_mismatch=1`) on
all four transistors of the CML driver, **N = 30 independent samples per
process corner × 5 process corners = 150 statistical points**, plus one
`mismatch=0` reference per corner and one deterministic negative control
(156 ngspice invocations, all completed).

| Sub-claim | Verdict | Evidence record | Notes |
|---|---|---|---|
| Single-ended swing 400–600 mV under local device mismatch | **PASS** | [`sim/cml-driver-mismatch/records/20260815-044555-9e8a33a.md`](../sim/cml-driver-mismatch/records/20260815-044555-9e8a33a.md) | Worst observed sample across all 150 points: **456.8 mV** (`ss`) to **485.3 mV** (`ff`) — inside the window at every sample, with 56.8 mV of margin to the 400 mV floor. Per-corner 1σ ≤ 1.32 mV. |
| Common mode 2.8–3.3 V under local device mismatch | **PASS** | same record | Worst observed sample: **3.0573 V** (`ff`) to **3.0716 V** (`ss`) — inside the window at every sample. Per-corner 1σ ≤ 0.66 mV. |

**How it is graded, and why that matters.** The PASS/FAIL roll-up uses the
**observed min/max across the N samples**, not a σ-projection from the
per-corner mean — so a heavy-tailed sample cannot be hidden behind a Gaussian
assumption. Per-corner σ is reported alongside, but is not what the verdict
rests on.

**Reproducibility.** Every sample's seed is derived deterministically —
base seed `20260814`, sample `i` at process-corner index `k` uses
`.option seed = 20260814 + k*1000 + i` — so any individual sample is
independently re-runnable, not just the aggregate.

**Negative control** (`tt_mcneg_27c_3.30v`, excluded from the statistics and
from the roll-up): the same unmodified vendor mismatch mechanism is driven
with `par_tail_val=0.0001` on the tail-mirror device, which scales only the
Pelgrom-law area term the mismatch σ is drawn against — not the transistor's
real electrical `w`/`l`/`nf`/`m`. Measured **swing 117.3 mV — FAILS** the
400–600 mV window (vcm 3.2414 V still passes). The pass/fail check therefore
demonstrably fires; the PASS above is not vacuous.

**What this record does not cover**, stated rather than left to be inferred:

- **Temperature and supply are held at nominal** (27 °C, 3.30 V); the swept
  axis is process corner × sample count. This is a deliberate subset of the
  DR-0013 PVT matrix, justified in the record's own **Corner matrix run**
  field: `sim/cml-driver-eye` already carries this driver's swing/common-mode
  claim deterministically across the full −40/27/125 °C × ±10 % supply ×
  process grid (90 points, both rates), and re-running that T×V grid × N=30
  is a 9× cost multiplier that adds no new axis. Read the two records
  together — statistical evidence **combined with**, not replacing, the
  corner sweep, which is exactly what the T1 ladder's Monte Carlo item asks
  for.
- **Schematic-level, not extracted.** No layout-extracted Monte Carlo run
  exists. The mismatch DUT's `nfet_03v3_dss` wrapper also adds small, real
  routing-resistance parasitics the un-wrapped `nfet_03v3` omits, so the
  `mismatch=0` reference rows are *comparable* to the `cml-driver-eye`
  deterministic rows but not numerically identical to them.
- **N = 30 per corner** is enough to bound the observed spread at the σ
  magnitudes measured here (σ ≈ 1 mV against a 200 mV-wide window), not to
  substantiate a parts-per-million tail claim. No yield number is claimed
  anywhere in this repository.
- **Swing and common mode only** — no statistical claim is made about jitter,
  device stress, or tail current, and none is made about any other spec row.

### DR-0003 — final multiplexer real-cell verification (issue #159, process axis extended issue #163, re-verified against issue #169's RL fix by issue #173)

Every `sim/cml-driver-eye*` record above models the DR-0003 custom final 2:1
multiplexer's output as an **ideal** differential source (stated explicitly
in each testbench's own header). `design/tmds_final_mux.sch` (issue #159)
draws that cell for the first time, sized per
`design/tmds-final-mux-sizing.md`, and
[`sim/tmds-final-mux-eye/records/20260905-220011-6434eba.md`](../sim/tmds-final-mux-eye/records/20260905-220011-6434eba.md)
(`tt` process corner) is the first measurement of what it actually delivers,
driving a real `cml_driver` instance's gate load rather than the lumped
capacitor or ideal source every prior record assumed. Issue #163 closed
the disclosed "1 of 5 process corners" gap that record left open, landing
the remaining four corners across four more records against the
**pre-#169** geometry —
[`ss`](../sim/tmds-final-mux-eye/records/20260906-011450-6a24db4.md),
[`ff`](../sim/tmds-final-mux-eye/records/20260906-051639-cef4040.md),
[`fs`](../sim/tmds-final-mux-eye/records/20260906-051904-cef4040.md), and
[`sf`](../sim/tmds-final-mux-eye/records/20260906-052053-cef4040.md) — each
sweeping the same full temperature × supply × rate matrix, completing the
mandated 90-point grid. `ss` was the corner this cell's own design
derivation had already flagged as the most plausible worst case for full
current-steering commutation (`design/tmds-final-mux-sizing.md` §4.2); that
flag was directionally correct but incomplete — **both `ss` and `sf`
disclosed genuine, narrow `vswing_m`/`vswing_s` FAILs**, while `tt`, `ff`,
and `fs` were clean PASSes at all 18 points each. **Issue #169 fixed the
`ss` FAIL** (`design/tmds_final_mux.sch`'s `RLP`/`RLN` widened
5.66 µm → 5.90 µm, re-verified 18/18 PASS at the `ss` corner). **Issue
#173 has since re-run all four remaining corners (`tt`/`ff`/`fs`/`sf`)
against that same widened `RL`** —
[`tt`](../sim/tmds-final-mux-eye/records/20260906-084639-fdb10c5.md),
[`ff`](../sim/tmds-final-mux-eye/records/20260906-084713-fdb10c5.md),
[`fs`](../sim/tmds-final-mux-eye/records/20260906-084753-fdb10c5.md), and
[`sf`](../sim/tmds-final-mux-eye/records/20260906-084830-fdb10c5.md) — and
**the `sf` FAIL (issue #171) is now resolved**: 18/18 PASS at every
corner, closing the mandated 90-point grid for the current, post-#169
geometry. See below.

| Sub-claim | Verdict | Evidence record | Notes |
|---|---|---|---|
| `design/cml-driver-sizing.md` §4.1's input-swing assumption (levied on this cell): single-ended `vih = 0.85×VDD`, `vil = 0.55×VDD`, common mode `0.70×VDD` | **PASS, within a few % across the full 5-corner grid** | [`ss` fix](../sim/tmds-final-mux-eye/records/20260906-070531-94be115.md), [`tt`](../sim/tmds-final-mux-eye/records/20260906-084639-fdb10c5.md), [`ff`](../sim/tmds-final-mux-eye/records/20260906-084713-fdb10c5.md), [`fs`](../sim/tmds-final-mux-eye/records/20260906-084753-fdb10c5.md), [`sf`](../sim/tmds-final-mux-eye/records/20260906-084830-fdb10c5.md) | `vih_m_frac` 0.8408–0.8678, `vil_m_frac` 0.5054–0.6015, `vcm_m_frac` 0.6731–0.7345 (targets 0.85 / 0.55 / 0.70) — full `tt`/`ff`/`ss`/`fs`/`sf` grid against the current (post-#169) geometry, both rates, clock-alternating stimulus. No check in `tb.json` grades this row numerically (it is an assumption cited for context, not a pass/fail column); the two floor/ceiling rows below are the columns `tb.json` actually checks. |
| §4.2's derived ≥ 0.8 V differential full-commutation floor, clock-alternating stimulus (`vswing_m`) | **PASS at all five process corners — `ss` fixed by issue #169, `sf` fixed by the same change (confirmed by issue #173)** | same five records | Pre-fix, the `ss` corner disclosed `vswing_m` = 0.799954 V / 0.798554 V (under the 0.8 V floor by 46 µV / 1.446 mV), and `sf` disclosed a worse shortfall — 0.796899 V / **0.790067 V** (9.9 mV under, the largest violation). Widening `RLP`/`RLN` (`r_length` 5.66 µm → 5.90 µm, +4.24 %, `design/tmds_final_mux.sch`) raises `vswing_m` by ≈ the same +4.24 % at every corner, since `swing = I_tail * RL` and `I_tail` does not depend on `RL`. Re-verified against the **full 5-corner matrix (90/90 points)** on the current geometry: **PASS everywhere**. `ss`: 0.830797–1.16330 V (previous low 0.798554 V, now +30.8 mV clear). `sf`: **0.821563–1.16822 V** (previous low 0.790067 V, now +31.5 mV clear — the corner issue #171 tracked is resolved). `tt`: 0.87574–1.21733 V. `ff`: 0.896693–1.26639 V. `fs`: 0.923118–1.26313 V. Combined 90-point grid: **0.821563 V (`sf_125c_2.97v_270mbps`) – 1.26639 V (`ff_-40c_3.63v_742p5mbps`)**, every point above the 0.8 V floor. |
| Same floor, word-alternating stimulus (`vswing_s`) | **PASS at all five process corners — `sf`'s single-point FAIL (issue #171) also resolved** | same five records | Pre-fix, `sf`'s worst point failed both stimuli together (`vswing_s` 0.793148 V, 6.85 mV under) — the only point in the whole pre-#169 grid where both copies failed simultaneously. Post-fix, that same point (`sf_125c_2.97v_270mbps`) measures **0.824519 V** (+24.5 mV clear). Combined 90-point grid: 0.824519 V (`sf`) – 1.28528 V (`fs_-40c_3.63v_742p5mbps`), every point above the 0.8 V floor. At `ss`'s two originally-failing points, `vswing_s` PASSes with more margin post-fix (0.834727–0.834766 V). |
| Device stress (`vgs_mu_max`, `vds_mu_max`, `vds_mt_max`) against the 3.63 V rated ceiling | **PASS** | same five records | Worst measured across the full post-#169 90-point grid: `vgs_mu_max` 1.76774 V (`sf_125c_3.63v_742p5mbps`, ≈51 % margin), `vds_mu_max` 1.39829 V (`ss_-40c_3.63v_270mbps`, ≈61 % margin), `vds_mt_max` 0.935734 V (`fs_-40c_3.63v_270mbps`, ≈74 % margin) — comparable to the pre-fix worst (1.758 V `vgs_mu_max`), confirming the small `RL` change does not meaningfully move device stress. |
| **Coverage**: 90 of 90 PVT points (full `tt`/`ff`/`ss`/`fs`/`sf` process-corner grid, full −40/27/125 °C × ±10 % supply × both-rate matrix each) | **Complete against the current (post-#169) geometry** | all five records' own **Corner matrix run** / **Justification** fields | Issue #163 completed the mandated 90-point grid for the pre-#169 geometry, disclosing genuine, narrow `vswing_m`/`vswing_s` shortfalls at `ss` and `sf`'s low-supply extremes (issues #169, #171) rather than hiding them by loosening `tb.json`'s checks. Issue #169 fixed and re-verified `ss`; issue #173 re-ran `tt`/`ff`/`fs`/`sf` against the same widened `RLP`/`RLN` and found the grid **90/90 PASS** — `sf`'s FAIL (issue #171) is resolved by the same fix, not a separate one. All records taken against a dirty working tree (same disclosed limitation `sim/esd-clamp-cv`'s and `sim/smoke-cml-pair`'s own records carry) — not citable as a clean-tree result on their own. |

**What this does not cover**: schematic-level only (no post-layout run);
`design/tmds-final-mux-sizing.md` §7's own non-goals (no isolated
clock-pair commutation sweep, no dedicated bandwidth analysis — both
folded into this end-to-end measurement instead); the reduction stage
(`rtl/tmds_serializer.v`/DR-0014) upstream of this cell's `D0`/`D1` inputs
is still modelled as an ideal source (`design/tmds-final-mux-sizing.md` §5),
not the real reduction-stage output. See §3 below for the full accounting
of what remains, including the `vswing_m` finding.

### DR-0002 — driver rows re-measured with the real DR-0003 mux (issue #159, process axis extended issue #163, re-verified against issue #169's RL fix by issue #173)

[`sim/cml-driver-eye-realmux/records/20260905-223322-6434eba.md`](../sim/cml-driver-eye-realmux/records/20260905-223322-6434eba.md)
(`tt`) is the second half of the same measurement: `sim/cml-driver-eye`'s own
graded DR-0002/§2 rows, re-run with the ideal differential source those
records substitute for the DR-0003 final multiplexer replaced by the real
`tmds_final_mux` cell driving the same `cml_driver` instance. Jitter here is
still referenced to the ideal half-rate clock, so `dj_ui_c0`/`c1`/`c2` is
the **mux-plus-driver** contribution, strictly harder than (and not
comparable one-for-one with) `sim/cml-driver-eye`'s driver-only jitter row.
Issue #163 completed the full 5-corner process axis against the **pre-#169**
geometry:
[`ss`](../sim/cml-driver-eye-realmux/records/20260906-020818-6a24db4.md),
[`ff`](../sim/cml-driver-eye-realmux/records/20260906-051647-cef4040.md),
[`fs`](../sim/cml-driver-eye-realmux/records/20260906-051904-cef4040.md), and
[`sf`](../sim/cml-driver-eye-realmux/records/20260906-052053-cef4040.md) —
**18/18 PASS at every one of the four**, including at every supply/rate/
temperature point where the companion `tmds-final-mux-eye` bench's own
`vswing_m`/`vswing_s` checks FAIL at the `ss` and `sf` corners (see the
DR-0003 subsection above and §3 item 6 below): the multiplexer's marginal
output shortfall at those four points does not propagate into an
observable DR-0002 spec-row violation at the driver's own output, at any
process corner measured. This bench was already **90/90 PASS across the
full mandated grid** on the pre-#169 geometry. Issue #169's `RLP`/`RLN`
widening (5.66 µm → 5.90 µm) that fixed the companion `tmds-final-mux-eye`
bench's `ss`-corner FAIL also changes this bench's upstream mux input;
re-verified against the full `ss`-corner matrix,
[`sim/cml-driver-eye-realmux/records/20260906-072026-94be115.md`](../sim/cml-driver-eye-realmux/records/20260906-072026-94be115.md)
confirmed **18/18 PASS unchanged** (`swing_c0`/`c1`/`c2` 0.4695–0.5070 V,
still inside the DR-0002 window) — no regression from the mux-side sizing
change. **Issue #173 has since re-run `tt`/`ff`/`fs`/`sf` against the same
geometry too** —
[`tt`](../sim/cml-driver-eye-realmux/records/20260906-084909-fdb10c5.md),
[`ff`](../sim/cml-driver-eye-realmux/records/20260906-085007-fdb10c5.md),
[`fs`](../sim/cml-driver-eye-realmux/records/20260906-085134-fdb10c5.md), and
[`sf`](../sim/cml-driver-eye-realmux/records/20260906-085308-fdb10c5.md) —
confirming **90/90 PASS unchanged across the full grid**: as with `ss`, the
mux-side `RL` widening (and the `sf`-corner FAIL it closes on the companion
bench) does not move this bench's own DR-0002 rows outside their windows at
any of the four remaining corners.

| Sub-claim | Verdict | Evidence record | Notes |
|---|---|---|---|
| DR-0002 single-ended swing 400–600 mV, 0/1/2 pF pad, real mux input | **PASS** | [`ss` fix](../sim/cml-driver-eye-realmux/records/20260906-072026-94be115.md), [`tt`](../sim/cml-driver-eye-realmux/records/20260906-084909-fdb10c5.md), [`ff`](../sim/cml-driver-eye-realmux/records/20260906-085007-fdb10c5.md), [`fs`](../sim/cml-driver-eye-realmux/records/20260906-085134-fdb10c5.md), [`sf`](../sim/cml-driver-eye-realmux/records/20260906-085308-fdb10c5.md) | `swing_c0`/`c1`/`c2` 0.469493–0.518481 V across the full 5-corner grid against the current (post-#169) geometry — comfortably inside the 0.4–0.6 V window at every pad-cap point; the low-supply corners (`ss`, `sf`) narrow the low-end margin relative to `tt`/`ff`/`fs` but do not approach it. Essentially unchanged from the pre-#169 grid, as expected — this bench's swing is set by the driver's own tail current/load resistor, not the mux's. |
| DR-0002 common mode 2.8–3.3 V, 0/1/2 pF pad, real mux input | **PASS** | same five records | `vcm_c0`/`c1`/`c2` 3.0408–3.05354 V across the full grid. |
| DR-0002 swing/common mode under a deliberate 1 pF leg-to-leg pad-capacitance mismatch, real mux input | **PASS** | same five records | `swing_cmis` 0.469462–0.516316 V across the full grid. |
| spec/tmds-tx.md §2 remaining-jitter row, ≤ 0.15 UI p-p — **mux-plus-driver**, 0/1/2 pF pad | **PASS** | same five records | `dj_ui_c0`/`c1`/`c2` max 5.346×10⁻⁵ UI (`ss_-40c_2.97v_742p5mbps`, 2 pF) — ≈ 2805× inside budget; `ss` remains the worst corner across the full grid (`tt`/`ff`/`fs`/`sf` do not exceed it). |
| Same jitter row under the leg-mismatch copy | **PASS** | same five records | `dj_ui_cmis` max 1.00×10⁻³ UI (`ss_125c_2.97v_742p5mbps`) — the largest jitter figure across the full grid (as expected, the deliberately harder configuration), still ≈ 150× inside budget. |
| Tail-current tolerance (design's own derived 8–12 mA window) | **PASS** | same five records | `itail_dc` 9.853–10.305 mA across the full grid — no measurable steering shortfall even at the process corners where the upstream mux itself previously showed (and, post-fix, no longer shows) a narrow shortfall. |
| Device stress (`vgs_sw_max`, `vgd_sw_max`, `vds_sw_max`, `vgs_tail_max`, `vds_tail_max`) against the 3.63 V rated ceiling | **PASS** | same five records | Worst measured 2.66183 V (`vds_sw_max`, `ss_-40c_3.63v_742p5mbps` region), positive margin (0.968 V) across the full post-#169 grid — comparable to the pre-#169 worst (2.653 V), confirming no material stress regression from the mux-side `RL` change. |
| **Coverage**: 90 of 90 PVT points (full `tt`/`ff`/`ss`/`fs`/`sf` process-corner grid) | **Complete against the current (post-#169) geometry** | all five records' own **Corner matrix run** / **Justification** fields | Every point PASSes, both before and after issue #169's mux-side `RL` widening; this bench's own checks were unaffected by the two narrow `vswing_m`/`vswing_s` shortfalls the companion `tmds-final-mux-eye` bench disclosed at `ss`/`sf` pre-fix (issues #169, #171), and remain unaffected now that both are fixed. All records taken against the same dirty working tree. |

Together with the `tmds-final-mux-eye` record above, this closes the gap
`measurements/characterization.md`'s own DR-0002 jitter row previously
named ("the serializer/mux stage upstream of this driver has not itself
been captured yet") — now across the full `tt`/`ff`/`ss`/`fs`/`sf`
process-corner grid and the full temperature/supply/rate matrix (issue
#163, closed).

### DR-0013 row 6 — passing-eye criterion (combined swing+jitter eye mask)

[`sim/cml-driver-eye-mask/records/20260825-040412-4b0c9f6.md`](../sim/cml-driver-eye-mask/records/20260825-040412-4b0c9f6.md)
(issue #144) closes the gap §3 item 5 previously named: DR-0013 row 6
(`spec/decisions/0013-operating-conditions.md`) grades a single combined
criterion — eye height >= 200 mV **and** eye width >= 0.75 UI, measured
simultaneously at the eye's widest opening, no fixed sampling instant
assumed — and until this record, no testbench in this repository evaluated
it directly. This bench drives a genuine PRBS7 (ITU-T O.150, period 127)
pattern, long enough to develop real inter-symbol interference, unlike
`sim/cml-driver-eye`'s fixed single-transition measurements (rows 1 and 4
above).

| Sub-claim | Verdict | Evidence record | Notes |
|---|---|---|---|
| DR-0013 row 6: eye height >= 200 mV AND eye width >= 0.75 UI, simultaneously, at the eye's widest opening | **PASS** | same record | Full PVT (5 process corners x 3 temperatures x 3 supply points) x both rates x 0/1/2 pF pad cap (90 points). Worst-case per-window (0.75 UI) minimum vertical opening ("eyemask_margin"): **0.871–1.033 V** at 2 pF pad (the tightest load), **0.958–1.033 V** at 1 pF, **0.962–1.033 V** at 0 pF — every measured point clears the 0.2 V floor by >= 4x. Worst single corner: `ss_125c_2.97v_742p5mbps` at 2 pF pad, 0.871 V (still 4.4x the floor). |

**Methodology, briefly** (full derivation in
`sim/cml-driver-eye-mask/gen_testbench.py`'s module docstring). Each of the
127 measured PRBS7 bits is preceded by a 20-bit rolling-history prefix (the
sequence's own tail) so no measured bit starts from an arbitrary settle-in
state. Each unit interval is tiled into 8 equal phase bins; per bin, the
worst-case vertical opening is (minimum sampled level over every measured
"1" bit at that phase) minus (maximum sampled level over every measured "0"
bit at that phase) — the standard worst-case-ISI eye-height construction. A
6-of-8-bin (0.75 UI) sliding window is then scanned across every start
offset, and the largest per-window minimum height is the eyemask margin:
the tallest box that fits the width floor somewhere in the open eye, which
is exactly DR-0013 row 6's test — no fixed sampling instant is assumed.

**What this does not cover**, stated rather than left to be inferred:

- **`mos` corner set only** (tt/ff/ss/fs/sf), matching `sim/cml-driver-eye`'s
  own precedent — row 6's claim does not depend on resistor/BJT device-
  family parameters, so the resistor/BJT skew corners are not required for
  this claim.
- **No statistical (Monte Carlo) eye-mask claim.** The driver's Monte Carlo
  evidence above (swing/common mode under local device mismatch) does not
  extend to a combined eye-mask construction; none is made here.
- **8 phase bins (12.5 % UI resolution)**, chosen for runtime rather than
  rigor — a finer grid did not double runtime when doubled, it took a
  single PVT point from ~4 s to over 180 s. Given every measured margin
  above clears the 0.2 V floor by >= 4x, a finer grid is very unlikely to
  change the verdict; see the generator's own docstring for the full
  reasoning.

#### DR-0013 row 6, post-layout (extracted) corroboration

[`sim/cml-driver-eye-mask/records/20260905-222646-a2b1051.md`](../sim/cml-driver-eye-mask/records/20260905-222646-a2b1051.md)
(issue #160) closes the gap the paragraph above left open: it re-runs **the
same testbench deck, manifest, measurements and checks** as the schematic
record above — same 90-point PVT × rate × pad-cap grid — against
`layout/sim/gf180_tmds_pad_ring_assembly_dut.spice`, the same extracted
driver+pad-ring+ESD assembly DUT issue #154's `cml-driver-eye` post-layout
record uses. This extraction is a **full parasitic-RC extraction**
(`klt extract --parasitics`), not merely a device-level LVS-clean netlist,
and includes the real `diode_nd2ps_06v0` ESD clamp array and the real drawn
bond pad in circuit with the driver. It is also this experiment's **first
citable clean-tree record** — the schematic record above was taken against a
dirty working tree and states so in its own **Netlist provenance** field.

| Sub-claim | Schematic record | Extracted (assembly) record | Verdict |
|---|---|---|---|
| Eyemask margin, 0 pF pad | 0.962–1.033 V | 0.962–1.033 V | **PASS**, unchanged (< 0.03 % worst delta) |
| Eyemask margin, 1 pF pad | 0.958–1.033 V | 0.955–1.033 V | **PASS**, unchanged (0.34 % worst delta) |
| Eyemask margin, 2 pF pad | 0.871–1.033 V | 0.859–1.033 V | **PASS**, unchanged (1.47 % worst delta) |

**The measured deltas, and why they are what they are.** The corner-by-corner
comparison is computed, not transcribed —
`python3 sim/compare_records.py cml-driver-eye-mask 20260825-040412-4b0c9f6 20260905-222646-a2b1051`
reproduces the full 30-measurement table; **no corner changed verdict**. The
worst-case eyemask margin across the whole grid moves from 0.871 V
(schematic, `ss_125c_2.97v_742p5mbps` at 2 pF pad) to 0.859 V (extracted,
same corner and pad point) — still **4.29× the 0.2 V floor**. The pattern
matches `sim/cml-driver-eye`'s own device-level-vs-extracted delta (above):
the heaviest-loaded, most process/temperature-stressed corner (`ss`, 125 °C,
low supply) at the largest pad capacitance shows the largest movement,
because that is exactly the corner/load combination where the extracted
interconnect parasitics (not present in the schematic's ideal wires) add the
most delay/loading relative to the signal's own settling budget. The
unloaded (0 pF) points barely move (< 0.03 %) because there is little
interconnect capacitance for the extraction to add on top of an already-tiny
load.

**What this adds beyond the schematic-level result above, and what it still
does not cover:**

- **Post-layout, full parasitic-RC, real ESD clamp and pad — now covered.**
  The schematic-level gap flagged above is closed.
- **Not modelled** (per the record's own **Claim** field, and
  `layout/sim/gf180_tmds_pad_ring_assembly_dut.spice`'s own header):
  package, board, or bond-wire parasitics (only the drawn on-die pad), and
  any HBM/CDM ESD pulse event (the clamp diodes sit in the small-signal/
  operating-point circuit only — issue #145, separate).
- **Same `mos` corner set, no Monte Carlo eye-mask claim, same 8-phase-bin
  resolution** as the schematic-level record — none of those scope limits
  are narrowed or widened by this re-run.

### DR-0005 — pad cell and ESD strategy (clamp capacitance)

| Sub-claim | Verdict | Evidence record | Notes |
|---|---|---|---|
| ESD clamp capacitance vs. size, at 0 V and at the DR-0002/DR-0006 operating bias, full PVT | **Measured, reported — no simple PASS/FAIL against the ≤ 2 pF budget** | [`sim/esd-clamp-cv/records/20260814-193222-dd48630.md`](../sim/esd-clamp-cv/records/20260814-193222-dd48630.md) | Full PVT (45 points, process × temp × supply). The record itself is a corner-matrix capacitance-vs-width sweep, not a spec pass/fail claim — its own **Claim** field cites DR-0005 without asserting a verdict. The verdict synthesis lives in `design/esd-capacitance-budget.md` (see next row), which combines this record with the pad's own parasitic capacitance. Taken against a dirty working tree (see the record's own **Netlist provenance** field); not citable as a clean-tree result on its own, but `sim/README.md`'s cold-start reproducibility audit (issue #25) re-ran this experiment from a clean checkout and got a bit-for-bit match — the underlying data is not in question. |
| DR-0005's ≤ 2 pF/pad budget (clamp + pad parasitic combined), against the real drawn pad cell | **PASS at a realistic 25×25 µm pad — 0.225–0.652 pF across the full HBM-sizing window (67–89 % headroom)** | [`design/esd-capacitance-budget.md` §9](../design/esd-capacitance-budget.md) (§9.3 pad/interconnect, §9.4 clamp PVT sweep, §9.5 verdict), backed by [`sim/esd-diode-clamp-cv/records/20260819-053140-72b44e8.md`](../sim/esd-diode-clamp-cv/records/20260819-053140-72b44e8.md) and `layout/drc_reports/gf180_tmds_pad_v2.parasitics.json` | **§9 supersedes §5; this row previously reported §5's "7.95 pF worst case, 4.0× over budget" FAIL and no longer does.** §5's verdict fell on two independent grounds, both established by issue #87 / PR #124 (2026-08-19): (a) §4b's analytic "realistic bond pad" figure carried a **1000× units-label bug** — the `aF` arithmetic was right but the result was divided by 1,000 (`aF`→`fF`) and then labelled `pF`, so the real bare-25×25 µm-Metal5-plate figure is **6.66 fF, not 6.66 pF** (§9.1, confirmed twice: re-derived arithmetic at 6.6629 fF and an independent `klt extract --parasitics` measurement at 6.66235 fF, 0.02 % agreement); and (b) rather than rest on that correction, §9 draws the pad for real — `gf180_tmds_pad_v2` (`layout/gds/gf180_tmds_pad_v2.gds`), a 25×25 µm Metal5 bond pad with DR-0011's ratified `diode_nd2ps_06v0` clamp and a real substrate tap, DRC-clean (0 violations) and LVS-matched with its `_shorted` negative control correctly mismatching. Measured: **12.185 fF** pad-plate + via-stack + Metal1 bus parasitic (§9.3, `klt extract --parasitics` against the drawn cell, byte-identical across `gf180mcuC`/`gf180mcuD`) plus a full-PVT diode-clamp CV sweep (§9.4, 45/45 points, binding corner `ss_125c_2.97v`, operating-bias-graded) over §2b's HBM-sizing window: **0.225 pF at 222 µm, 0.438 pF at 444 µm, 0.652 pF at 667 µm** (the last linearly extrapolated, §9.4). DR-0005 is met, not relaxed — the operator's 2026-08-14 guardrail on issue #12 is satisfied by correcting the measurement, not the budget. **Two caveats, stated rather than hidden**: the *capacitance* is measured but the *clamp width* it is graded at still comes from literature-sourced HBM current density, not PDK data (§2a — see the next row); and `gf180_tmds_pad_v2` is a standalone proof-of-concept cell, so this particular row's numbers are a cell-level result. The block-level half of that second caveat is now measured — see the next row. |
| DR-0005's ≤ 2 pF/pad budget **at block level**, at DR-0011's ratified 350 µm pad pitch | **PASS — 0.247–0.836 pF across the full HBM-sizing window (58–88 % headroom), drawn and DRC-clean at pitch** | [`design/esd-capacitance-budget.md` §10](../design/esd-capacitance-budget.md) (§10.2 fit, §10.3 budget), backed by `layout/drc_reports/pad_pitch_fit_*.{fit,drc,parasitics,components}.json` and, for the clamp term, the same [`sim/esd-diode-clamp-cv/records/20260819-053140-72b44e8.md`](../sim/esd-diode-clamp-cv/records/20260819-053140-72b44e8.md) §9.4 uses | Issue #143 answered the question §3 item 4 previously named as open: **`gf180_tmds_pad_v2`'s production 25×25 µm pad geometry does fit DR-0011's ratified 350 µm pitch / 75 µm ring depth**, tiled two-up alongside the DVDD/DVSS Metal3/4/5 straps, a real substrate tap and an HBM-sized clamp array — drawn, not estimated: `klt drc` `status: clean`, 0 violations, at every clamp size from the as-drawn 20-finger array up to 334 fingers (668 µm of clamp width, the top of §2b's HBM window). Ring continuity is checked mechanically, not by eye: `klt components` over the M3/M4/M5 stack reports each supply strap as **one** connected component spanning the full two-slot span, with the pad plates as separate components — the larger pads neither bridge nor interrupt either strap. Two changes are required and are recorded as such (§10.2): the clamp array must **fold into rows** above ~125 fingers (a single 334-finger row is 881.8 µm, 2.5× the ratified pitch), and the pad structure must sit ~5 µm higher in the ring depth so the 25 µm-tall Metal5 plate clears the DVDD strap band. Measured pad-node interconnect capacitance at block level: 12.185 fF (20 fingers — reproducing §9.3's cell-level figure exactly), 34.251 fF (222 µm), 65.752 fF (444 µm), 95.071 fF (668 µm), 195.627 fF (668 µm with an 8.3× wider Metal1 gather bus, which also closes §9.3's own open "an HBM-sized clamp needs a wider bus" caveat with a number: +100.6 fF for an 8.1× resistance reduction). Summed with §9.4's PVT-swept clamp term at its binding `ss_125c_2.97v` corner: **0.247 / 0.492 / 0.735 / 0.836 pF**, all inside 2 pF. **DR-0011 is met, not amended** — no decision record is opened or relaxed. **Three caveats, stated rather than hidden**: (a) the exact agreement with the cell-level figure was checked rather than assumed — re-running with lateral coupling explicitly enabled on both pad nets (`--critical-net OUTP --critical-net OUTN`) returns `cc_count: 0` and identical figures, because the Metal5 plate and the Metal5 straps are 2.0 µm apart (outside the layer's minimum-spacing lookback) and nowhere vertically overlap; that is a statement about this extractor's quasi-static per-net model at this separation, not a claim that a physical ring has no pad-to-strap coupling (`design/esd-capacitance-budget.md` §6's coverage limits apply unchanged); (b) the clamp *width* is still literature-sized, same as every row above; (c) **resolved (issue #149)** — these were dedicated fit-study tiles, not the block assembly itself; the production geometry is now landed in the block assembly (see the next row). See §3 item 4. |
| DR-0005's ≤ 2 pF/pad budget, **landed block assembly** (issue #149) | **PASS — 0.094 pF (`OUTP`) / 0.075 pF (`OUTN`), 95–96 % headroom, at the as-drawn 20-finger clamp size** | [`design/esd-capacitance-budget.md` §10.5](../design/esd-capacitance-budget.md) (§10.5 landed/integrated measurement), backed by `layout/drc_reports/gf180_tmds_pad_ring_assembly.parasitics.json`, `layout/lvs_reports/gf180_tmds_pad_ring_assembly*.lvs.{json,txt}`, and the same [`sim/esd-diode-clamp-cv/records/20260819-053140-72b44e8.md`](../sim/esd-diode-clamp-cv/records/20260819-053140-72b44e8.md) §9.4 clamp term | Issue #149 folded the production 25×25 µm pad / 20-finger `diode_nd2ps_06v0` clamp geometry into `layout/scripts/gen_pad_ring_assembly.py` (`layout/gds/gf180_tmds_pad_ring_assembly.gds`) itself, replacing the row above's dedicated fit-study tiles with the actual block assembly `klt drc`/`klt lvs`/`klt extract --parasitics` are run against: `klt drc` `status: clean` (0 violations, both the assembly and its `_shorted` negative control), `klt lvs` `status: match` (2 warning-only findings) for the assembly and `status: mismatch` (5 error-severity findings) for the negative control — the pair invariant `layout/scripts/check_lvs_signoff.py` enforces. Because the assembly draws the CML driver and its output routing (unlike the fit-study tiles above), `OUTP`/`OUTN` no longer measure identically: `klt extract --parasitics --pdk gf180mcuD` gives 48.733 fF (`OUTP`) / 30.453 fF (`OUTN`) pad-node interconnect capacitance, including the driver's own internal M1/M2 output routing on that net. Summed with §9.4's 20-finger clamp term (45.03 fF, `ss_125c_2.97v`, operating bias): **93.76 fF / 75.48 fF — 0.094 pF / 0.075 pF, 95–96 % headroom against the 2 pF budget.** This is a confirmation at the as-drawn 20-finger clamp size, consistent with the row above's own finding across the full HBM-sizing window; an HBM-sized clamp folded into the assembly (via `N_FINGERS`) would need its own `klt extract --parasitics` re-run to confirm the interconnect term at that size. |
| HBM ≥ 2 kV / CDM ≥ 500 V ESD qualification | **Not evidenced — design-margin estimate only, explicitly not a qualification. Accepted as a permanent pre-silicon limitation (DR-0015); does not block T1/bronze** | `design/esd-capacitance-budget.md` §2; [`spec/decisions/0015-esd-hbm-cdm-qualification-tracking.md`](../spec/decisions/0015-esd-hbm-cdm-qualification-tracking.md) | No PDK source (SPICE models or DRC deck) characterizes ESD failure current density, breakdown voltage, or snapback/trigger behavior for any device family in gf180mcu (§2a of that document). The HBM sizing figures (222/444/667 µm clamp widths) are order-of-magnitude estimates from general ESD-design literature, explicitly marked as not PDK-sourced. CDM is reported as "the source is silent" — no CDM-driven width number exists. This repo has no tester and no fabricated parts (`measurements/` stays empty by design, per CLAUDE.md); real ESD qualification cannot happen until silicon exists. DR-0015 (issue #145) resolves the tracker disposition this row previously left open: the design-margin estimate above is accepted evidence, the row does **not** block this block's T1/bronze tier, and the requirement itself (HBM >= 2 kV / CDM >= 500 V) stays ratified and unrelaxed. Re-opens only on real silicon/ESD-tester data or a PDK-sourced ESD electrical dataset. |

### Harness/machinery self-verification (not a spec-row claim)

| Sub-claim | Verdict | Evidence record | Notes |
|---|---|---|---|
| Analog sim harness transient/rate-axis machinery, at both #1 operating points | **PASS** | [`sim/smoke-cml-pair/records/20260808-032312-430859a.md`](../sim/smoke-cml-pair/records/20260808-032312-430859a.md) | Full PVT × both rates (90 points), on a bare 3.3 V NMOS differential pair with the DR-0002 load topology — explicitly **not** a CML driver design deliverable (`sim/README.md`'s own framing). This record's own **Claim** field states "None — harness self-verification"; it is listed here for completeness (it is the first evidence this repo produced) but substantiates no spec row on its own. Taken against a dirty working tree, so it is not citable as a clean-tree result even for its own harness-proof purpose. |

## 2. Digital partition

This section indexes the `tmds_encoder` synthesis/P&R/STA/verification
pipeline under `flow/tmds_encoder/` and `verification/tmds_encoder/` against
DR-0003 (`spec/tmds-tx.md`'s digital encoder/serializer row) and against the
`klayout-tools/docs/design-evidence-tiers.md` T1 checklist items each result
addresses. Every result below is now a PASS; item 5 (LVS) was a
**disclosed FAIL** until issue #142 and its row records what changed and
why, rather than quietly flipping. Per CLAUDE.md's "Verification is the
product" and this document's own coverage-honesty convention, each row also
states the *scope* of what it verifies, not just its verdict.

| # | Item | Verdict | Evidence record | Notes |
|---|---|---|---|---|
| 1 | RTL-level functional verification (three-leg plan: exhaustive golden-model equivalence, invariants, negative control) | **PASS** | [`verification/tmds_encoder/`](../verification/tmds_encoder/), convention documented in [`verification/README.md`](../verification/README.md) | Cold-start re-run (`pip install -r requirements.txt && python3 runner.py`) reproduces cleanly: real DUT passes, negative-control DUT correctly fails, per issue #65's 2026-08-15 T1 re-read (item 9, "fresh cold-start re-run ... reproduces cleanly"). This bench uses its own convention (`verification/README.md`), distinct from `sim/`'s analog evidence-record format, so it is cited by directory + convention doc rather than a single dated record file. |
| 2 | Synthesis (gate-level netlist) | **PASS** | [`flow/tmds_encoder/records/20260816-033153-e2d0580.md`](../flow/tmds_encoder/records/20260816-033153-e2d0580.md) | 266 cell instances (17 sequential, 249 combinational), 0 unmapped cells, `gf180mcu_fd_sc_mcu9t5v0` library at `tt_025C_3v30` (DR-0003's synthesized-domain corner). Area-oriented mapping only — no `.sdc`/clock-period constraint applied at this stage, every cell drive strength 1; this matters for reading the STA result below. |
| 3 | Place & route (block-level digital layout exists) | **PASS** | [`flow/tmds_encoder/records/20260816-063442-def7827.md`](../flow/tmds_encoder/records/20260816-063442-def7827.md) | `layout/gds/tmds_encoder.gds`, 266 instances placed and routed (11184 µm total wire length, 1684 vias), 35% target / 36.1% effective utilization. No CTS, no SDC — scope disclosed in the record itself. |
| 4 | DRC | **PASS** | same record (`layout/drc_reports/tmds_encoder.drc.json`) | `status: clean`, 0 violations. Historical note: an earlier read of this row reported a disclosed FAIL (188 violations, all rule `mim.space.1`, a Metal4-to-Metal4 spacing check the curated gf180mcu deck could not distinguish from a real MiM capacitor's bottom plate on a design with zero capacitor devices — filed generically upstream as [klayout-tools#1033](https://github.com/2AMLogic/klayout-tools/issues/1033)); that finding no longer reproduces as of the DRC report regenerated by PR #133 (issue #127), and upstream #1033 was closed 2026-08-16, three days before that regeneration. |
| 5 | LVS | **PASS** | same record (`layout/lvs_reports/tmds_encoder.lvs.json`), negative controls `layout/lvs_reports/tmds_encoder_negctl.lvs.json` and `layout/lvs_reports/tmds_encoder_shorted.lvs.json` | `status: match`, **0 mismatches**; nets `{layout: 384, reference: 384}`, pins `{layout: 25, reference: 25}`. **This row was a disclosed FAIL (18 topology mismatches) until issue #142.** The cause was never a layout defect: the reference netlist was derived from the *pre*-P&R synthesized netlist, which by construction contains none of the 17 cell types place-and-route inserts (`FILL_1/2/4/8/16/32/64`, `FILLTIE`, `ENDCAP`, CTS's `CLKBUF_12/16` and `CLKINV_2`, hold-repair's `DLYC_1`/`INV_3`/`INV_4`, and setup-repair's resized `OAI21_2`/`OAI31_2`), so each appeared as a layout-only type, plus one top-level rollup. The reference is now derived from the post-P&R netlist (`flow/gen_pnr_netlist.py` -> `tmds_encoder.pnr.v` -> `gen_tmds_encoder_ref.py --from-pnr`), read out of the same committed routed DEF the GDS was streamed from. No layout, netlist or P&R setting changed — only what the layout is graded against. **Scope of the claim, stated rather than inflated**: this verifies the DEF -> GDS -> extraction path preserved connectivity (a step with two real, found-and-fixed DBU defects in its history), *not* that P&R preserved the synthesized netlist's intent — that is item 6's SDF-back-annotated re-simulation and `flow/sta_tmds_encoder.py`'s `assert_def_matches_netlist`. **Two negative controls, kept side by side (issue #146)**: `tmds_encoder_negctl` compares the same unchanged layout netlist against a reference carrying one deliberate fault (`ctrl[0]` merged into `data[3]`) and correctly reports `status: mismatch`, 3 error-severity findings — but breaks the *reference*, not the layout, so it never runs `klt extract --abstract-cells`. `tmds_encoder_shorted` is the layout-side twin every other cell in this repo ships: a real Metal4 bridge shorting the same `ctrl[0]`/`data[3]` pair, drawn into the GDS by `layout/scripts/gen_tmds_encoder_shorted.py` (geometry derived from the routed DEF's own `PINS` block, not hardcoded) and extracted for real — `status: mismatch`, 2 error-severity findings (`net.merged`, `topology`). Restoring this twin was blocked on [klayout-tools#1366](https://github.com/2AMLogic/klayout-tools/issues/1366) (a `klt` 0.3.0 regression that mis-bound abstracted-cell pins on this design badly enough that a layout-side control built on top of it could not be trusted), now fixed upstream (PR #1374); the fixed build was re-verified to reproduce the previously-committed 0.2.0-era extraction byte-for-byte before either the intact `match` above or the new `_shorted` `mismatch` was trusted — see `layout/README.md`'s `tmds_encoder` section. |
| 6 | Post-layout verification (SDF-back-annotated gate-level re-simulation) | **PASS, scope-limited** | [`flow/tmds_encoder/records/20260816-080228-185a5d3.md`](../flow/tmds_encoder/records/20260816-080228-185a5d3.md) (SDF extraction), [`flow/tmds_encoder/records/20260816-080524-185a5d3.md`](../flow/tmds_encoder/records/20260816-080524-185a5d3.md) (re-simulation) | The unmodified `verification/tmds_encoder/test_tmds_encoder.py` bench, run against the SDF-annotated post-route netlist: 3/3 tests PASS. SDF extracted at a single corner (`tt_025C_3v30`, OpenRCX), no PVT sweep, no CTS/SDC. No formal setup/hold timing-closure verdict is made at this stage — that is item 7/8 below. |
| 7 | Static timing analysis — setup, 720p60 target (74.25 MHz) | **PASS** | [`flow/tmds_encoder/records/20260817-110611-37e197a.md`](../flow/tmds_encoder/records/20260817-110611-37e197a.md) | Setup **met at all 5** 3.3 V liberty corners (`tt_025C_3v30`, `ss_125C_3v00`, `ss_n40C_3v00`, `ff_125C_3v60`, `ff_n40C_3v60`). Measured Fmax: **75.83 MHz worst-corner** (`ss_125C_3v00`), 148.96 MHz typical. Setup at the 480p fallback (27.000 MHz) also PASSes at all 5 corners. **Supersedes** the earlier pre-timing-driven-synthesis/pre-CTS record ([`20260816-172539-930e864.md`](../flow/tmds_encoder/records/20260816-172539-930e864.md)), which reported setup FAIL at 4/5 corners and 22.70 MHz worst-corner Fmax against an unconstrained, CTS-free netlist — that gap is now closed by issue #100's timing-driven-synthesis/CTS/timing-repair machinery combined with issue #115's DR-0009 four-stage pipeline restructuring (S1 popcount/threshold, S2 parallel-prefix transition-minimized word, S3 accumulator-independent DC-balance candidates, S4 decision + accumulator recurrence). The worst-corner margin is narrow (+0.2799 ns, 2.1 % of the 13.4680 ns period, at `ss_125C_3v00`) — closed, not closed with headroom. |
| 8 | Static timing analysis — hold, all corners, both targets | **PASS** | same record | Hold met at every one of the 5 corners, at both the 720p60 and 480p targets (hold is clock-period-independent, so both targets give the same answer). Worst hold margin +0.2703 ns (`ff_n40C_3v60`). |

**What this means.** The digital partition's RTL-level functional
verification, synthesis, layout existence, DRC, post-layout gate-level
re-simulation, and setup/hold timing closure at the 720p60 target are clean
PASSes (items 1–4, 6–8 above). **LVS (item 5) is now a PASS too**: its 18
mismatches were an artifact of grading a routed layout against a pre-P&R
reference netlist that could not contain P&R-inserted cells
(fill/tap/endcap/CTS buffers/hold-repair/resized gates), and issue #142
closed it by deriving the reference from the post-P&R netlist read out of
the committed routed DEF instead. Read that row for what the resulting
`status: match` does and does not establish — it verifies the DEF -> GDS ->
extraction path, not P&R's fidelity to synthesis, which item 6 covers. It
ships with a negative control that correctly fails. DRC's
earlier disclosed FAIL (188 `mim.space.1` violations, a deck-level
klayout-tools false-positive — [#1033](https://github.com/2AMLogic/klayout-tools/issues/1033))
no longer reproduces against the current evidence record; that upstream
issue was closed 2026-08-16. Timing closure
was achieved by issue #100's timing-driven-synthesis/CTS/timing-repair
machinery plus issue #115's DR-0009 four-stage pipeline; this rollup's job
is to report the current, disclosed state, not to re-derive it. Per
CLAUDE.md's "720p60 is the target" scope discipline, this closes what was
previously the single most load-bearing fact in this section — 720p60
setup timing is now met at every corner — though the worst-corner margin
(2.1 % of the period) is narrow, not comfortable.

## 3. What is not yet covered (named explicitly)

Per the coverage-honesty requirement this document exists to meet, the
following gaps are stated by name rather than left as silent omissions:

1. **PVT matrix — now ratified.** `sim/README.md`'s own working PVT matrix
   (−40/27/125 °C, ±10 % supply tolerance, the 5 classic MOS process
   corners plus `res_ff`/`res_ss`/`bjt_ff`/`bjt_ss` for resistor/BJT-
   dependent claims, both bit-rate targets) is **ratified**:
   [`spec/decisions/0013-operating-conditions.md`](../spec/decisions/0013-operating-conditions.md)
   (**Accepted**, 2026-08-18) ratifies the existing working-default matrix
   verbatim and unchanged — a tightening/formalizing move, not a new
   requirement, so no existing evidence in §1 above is invalidated or needs
   re-running. Issue #9 (closed, merged via PR #122) is the issue that
   originally opened this question; DR-0013 is its resolution, landed under
   a renumbered decision-record slot (see that record's own "Numbering
   note"). Every PASS verdict in §1 above is now graded against a
   spec-derived requirement, not a working default. The PDK-variant
   discrepancy this item previously flagged (`sim/` pinned `gf180mcuD`,
   `layout/` produced against `gf180mcuC`) is likewise resolved: DR-0010
   (Accepted) ratifies `gf180mcuD`, and every `layout/` artifact has since
   been regenerated and re-signed off against it (#127, closed) — per
   DR-0010's own survey, no numeric result recorded in this repository
   changes value as a result. DR-0013 also ratifies an 11-row
   verifiable-spec-row table (its own §3); at ratification time two of
   those rows were genuine open gaps: row 6 (combined swing+jitter
   eye-mask criterion) had no testbench yet, and row 11 (ESD HBM/CDM
   qualification) is not yet independently simulated — and per §1's
   DR-0005 table, structurally cannot be, pre-silicon. Row 10
   (pad-capacitance budget, ≤ 2 pF) was listed here as a third gap,
   **FAILing at ~4× over budget** against a realistic 25×25 µm bond pad;
   **that is no longer the state** — the figure behind it was a
   units-label bug, and a real drawn pad now measures 0.225–0.652 pF
   against the 2 pF budget (§1's DR-0005 table above,
   `design/esd-capacitance-budget.md` §9). Row 10 is closed at cell
   level, and since issue #143 also at block level, at DR-0011's ratified
   350 µm pad pitch (0.247–0.836 pF, `design/esd-capacitance-budget.md`
   §10, §1's block-level DR-0005 row above); what remains for it is
   adopting that geometry in the block assembly itself, item 4 below.
   **Row 6 is likewise no longer a gap**: `sim/cml-driver-eye-mask/records/
   20260825-040412-4b0c9f6.md` (issue #144) grades it directly and
   **PASSes** across the full PVT matrix, both rates, 0/1/2 pF pad cap —
   see §1's new DR-0013 row 6 subsection above and item 5 below. **A
   post-layout (full parasitic-RC extracted) re-run against the
   driver+pad-ring+ESD assembly now exists too**:
   `sim/cml-driver-eye-mask/records/20260905-222646-a2b1051.md` (issue
   #160) — same PASS verdict, worst-case margin still >= 4x the 0.2 V
   floor (see §1's new "post-layout (extracted) corroboration"
   subsection). **Row 11 remains the one open gap** of the original two,
   tracked as issue #145.
   They were previously listed here as tracked by Epic #17's own T1
   checklist item 5; #17 closed COMPLETED on 2026-08-21, so that pointer no
   longer resolves to anything open and has been replaced by the two live
   issues — row 6's (#144) now resolved by this update, row 11's (#145)
   still open.
2. **Post-layout re-simulation — device-level done, parasitic RC not.**
   The DR-0002 rows in §1 now carry a **Netlist provenance: extracted**
   record as well as the schematic one
   ([`20260815-072956-34e5253`](../sim/cml-driver-eye/records/20260815-072956-34e5253.md),
   issue #34, on the layout landed by issue #22), so "no post-layout
   evidence at all" is no longer the gap. **The remaining gap is narrower
   and must not be read as closed**: that extraction is
   *schematic-equivalent* — devices, their drawn geometry, and connectivity
   — with **no interconnect parasitic R/C**, because
   `klt extract --parasitics` was not used. Nothing recorded in this repo
   yet bounds intra-cell metal resistance or wiring/coupling capacitance,
   and the +14 fF of extra output-node junction capacitance the device-level
   run does show (§1) is a lower bound on the post-layout capacitance story,
   not the whole of it. Two further scope limits are equally unclosed by
   that record: it covers **the core driver cell only** — no pad, no ESD
   clamp, no package, no board. The layout-vs-simulation PDK-variant
   question (item 1 above) is now resolved (DR-0010, `layout/` regenerated
   against `gf180mcuD`). The driver-plus-pad/ESD assembled cell itself now
   exists:
   [`layout/gds/gf180_tmds_pad_ring_assembly.gds`](../layout/gds/gf180_tmds_pad_ring_assembly.gds)
   (#86, landed 2026-08-19) integrates the driver core cell with two
   diode-clamped bond pads and DR-0011's pad-ring/ESD structure, and is
   itself DRC-clean (0 violations) and LVS-matched (`status: match`, 2
   warning-only findings) — so "no pad/ESD post-layout evidence because the
   cell doesn't exist yet" is no longer the gap. **Electrical/PVT
   simulation of the assembled cell has now landed for the full mandated
   `mos` corner-set (issues #154 and #161)** —
   [`sim/cml-driver-eye/records/20260905-193624-231b75c.md`](../sim/cml-driver-eye/records/20260905-193624-231b75c.md) (`tt`),
   [`sim/cml-driver-eye/records/20260905-213837-a2b1051.md`](../sim/cml-driver-eye/records/20260905-213837-a2b1051.md) (`ff`),
   [`sim/cml-driver-eye/records/20260905-222410-a2b1051.md`](../sim/cml-driver-eye/records/20260905-222410-a2b1051.md) (`ss`),
   [`sim/cml-driver-eye/records/20260905-225202-a2b1051.md`](../sim/cml-driver-eye/records/20260905-225202-a2b1051.md) (`fs`), and
   [`sim/cml-driver-eye/records/20260905-232931-a2b1051.md`](../sim/cml-driver-eye/records/20260905-232931-a2b1051.md) (`sf`)
   (§1's new "block-level (assembly, extracted-with-parasitics)
   corroboration" subsection above), extracted **with** interconnect
   parasitic R/C (`klt extract --parasitics`), closing both this item's
   "no electrical/PVT simulation" gap and the parasitic-RC gap, for the
   assembled block, across all 5 `mos` corners × both rates — 90 of 90
   points, all PASS. **What remains outstanding**: a parasitic-RC re-run of
   the *bare* driver core cell in isolation (as opposed to the assembly)
   remains separately unaddressed, though the assembly record set now
   covers a strict superset of that cell's own circuitry.
3. **Monte Carlo evidence — landed for the driver's swing/common mode;
   nothing else carries a distribution claim.** This item previously stated
   that *"no record in `sim/` today carries a **Statistical convention**
   field with a seed, sample count, and a deterministic negative control"*
   and that issue #23 *"has not landed as of this document"*. **Both were
   false**, and had been since 2026-08-15:
   [`sim/cml-driver-mismatch/records/20260815-044555-9e8a33a.md`](../sim/cml-driver-mismatch/records/20260815-044555-9e8a33a.md)
   (issue #23, closed COMPLETED 2026-08-15) carries exactly that field —
   base seed `20260814` with a per-sample derivation, N = 30 samples × 5
   process corners, and a deterministic negative control that correctly
   FAILs — and it is now indexed in §1 above under DR-0002, where it
   belongs. The T1 ladder's Monte Carlo item asks for mismatch evidence
   *combined with* (not replacing) the process-corner sweep for the driver's
   swing/common mode; that is what the two records together are, and that
   item is **met**. Lint step 7 (`sim/check_record_citations.py`) now fails
   the build if any tracked `sim/*/records/*.md` is missing from this
   document, so this particular class of omission cannot recur silently.

   **What is still not covered statistically** — the genuine remainder of
   this item, as distinct from the stale claim above: every *other* verdict
   in §1 and §2 is a corner-matrix claim (`Statistical convention: N/A`),
   not a distribution claim. There is no Monte Carlo evidence for jitter,
   device stress, tail current, the ESD clamp's capacitance, or anything in
   the digital partition; the mismatch run is schematic-level, with no
   extracted-netlist Monte Carlo counterpart; and it holds temperature and
   supply at nominal (see §1's own statement of that record's limits). No
   yield or parts-per-million claim is made anywhere in this repository, and
   none of the above is required by the T1 ladder — they are named here so
   the coverage boundary is explicit rather than inferred from the single
   PASS in §1.
4. **Pad-ring integration of the budget-passing pad geometry — measured,
   and now landed in the block assembly (issue #149).** This item
   previously read "not done", and named two distinct gaps: (a) no
   capacitance-budget number had ever been measured against a block-level
   pad ring carrying production-sized pads, and (b) whether
   `gf180_tmds_pad_v2`'s 25×25 µm pad can be tiled at DR-0011's ratified
   350 µm pitch with ring continuity intact was **unchecked**. Issue #143
   closed both, by drawing rather than estimating — see §1's block-level
   DR-0005 (fit-study) row and
   [`design/esd-capacitance-budget.md` §10](../design/esd-capacitance-budget.md):
   the production geometry fits at pitch (DRC-clean at every clamp size in
   §2b's HBM window, ring continuity confirmed mechanically by
   `klt components`), it needs a row fold above ~125 clamp fingers and a
   ~5 µm higher pad placement, and it measures 0.247–0.836 pF against the
   2 pF budget.

   **What remained open, and how it closed.** Issue #143's measurement was
   taken against dedicated fit-study tiles (`layout/gds/pad_pitch_fit_*.gds`,
   `layout/scripts/pad_pitch_fit_study.py`), not against the block assembly
   this design would tape out.
   [`layout/gds/gf180_tmds_pad_ring_assembly.gds`](../layout/gds/gf180_tmds_pad_ring_assembly.gds)
   (#86) carried `gen_pad_diode_draft.py`'s 2×2 µm pad opening, which
   `layout/README.md` used to call "DRC-legal but not a production
   wire-bond target". Adopting the production geometry there was **#149**,
   blocked for a time on the tool rather than the design: under `klt`
   `0.3.0+g634e074ff484` (KLayout 0.30.10) that cell's committed `klt lvs`
   `status: match` stopped reproducing at all — 40 of 40 fresh runs
   returned `mismatch` carrying `device.combine_incomplete`, against the
   *unchanged, committed* GDS, with `klt lvs --rerun --check` confirming
   every input hash still `[OK]`. Landing a redraw under that condition
   would have meant committing an LVS pair whose intact half and whose
   `_shorted` negative control both said `mismatch` — a defeated control,
   exactly what `layout/scripts/check_lvs_signoff.py`
   (§ "Every LVS signoff is a pair") exists to catch. Filed generically
   under CLAUDE.md's friction protocol as
   [klayout-tools#1370](https://github.com/2AMLogic/klayout-tools/issues/1370),
   **resolved** by the merged
   [klayout-tools#1380](https://github.com/2AMLogic/klayout-tools/pull/1380).
   With the fix in hand, `gen_pad_ring_assembly.py` was redrawn on the
   production 25×25 µm pad / 20-finger clamp geometry: `klt drc`
   `status: clean` (0 violations, both the assembly and its `_shorted`
   twin), `klt lvs` `status: match` (assembly) / `status: mismatch`, 5
   error-severity findings (`_shorted` twin, correctly failing), 15/15
   repeated `klt lvs` runs against the intact assembly agreeing `match` (no
   flakiness observed under the fixed build). See §1's new "landed block
   assembly" DR-0005 row and
   [`design/esd-capacitance-budget.md` §10.5](../design/esd-capacitance-budget.md)
   for the integrated (driver-included) capacitance measurement: **0.094 pF
   (`OUTP`) / 0.075 pF (`OUTN`)**, 95–96% headroom against the 2 pF budget at
   the as-drawn 20-finger clamp size. Full evidence in `layout/README.md`'s
   `gf180_tmds_pad_ring_assembly` section, including the historical record
   of the now-resolved regression.
5. **Eye-mask criterion (DR-0013 row 6) — now evidenced.** Item 1 above
   previously named this as one of DR-0013's two live gaps; it no longer
   is. `sim/cml-driver-eye-mask/records/20260825-040412-4b0c9f6.md`
   (issue #144) drives a genuine PRBS7 pattern, builds the eye by tiling
   each UI into phase bins and scanning every 0.75 UI window position for
   the worst-case vertical opening, and grades it directly against row 6's
   own wording (height >= 200 mV AND width >= 0.75 UI, simultaneously, no
   fixed sampling instant assumed): **PASS**, full PVT matrix, both rates,
   0/1/2 pF pad cap, worst-case margin 0.871 V (>= 4x the 0.2 V floor).
   See §1's new "DR-0013 row 6" subsection above for the full table and
   this record's own stated coverage limits. **A post-layout (full
   parasitic-RC extracted) re-run against the driver+pad-ring+ESD assembly
   now exists too** (issue #160):
   `sim/cml-driver-eye-mask/records/20260905-222646-a2b1051.md` — same
   PASS verdict, same 90-point PVT × rate × pad-cap grid, worst-case margin
   0.859 V (still >= 4.29x the 0.2 V floor); see §1's new "post-layout
   (extracted) corroboration" subsection for the full delta. **What this
   does not cover**: no Monte Carlo/mismatch eye-mask claim (the driver's
   Monte Carlo evidence, item 3 above, covers swing/common mode only, not a
   combined eye construction), and the post-layout record does not model
   package/board/bond-wire parasitics or an HBM/CDM ESD pulse event (same
   scope limit as `sim/cml-driver-eye`'s own assembly record above). Row 11
   (ESD HBM/CDM qualification) remains DR-0013's one other open gap,
   unaffected by this record, tracked as issue #145.
6. **DR-0003 final multiplexer — real-cell evidence now landed at all five
   process corners; both the `ss` (issue #169) and `sf` (issue #171)
   `vswing_m`/`vswing_s` FAILs are fixed and re-verified (issue #173).**
   Until issue #159, every `sim/cml-driver-eye*` record modelled
   the DR-0003 custom final 2:1 multiplexer's output as an ideal source
   (stated in each testbench's own header) — "the serializer/mux stage
   upstream of this driver has not itself been captured yet" was §1's own
   DR-0002 jitter-row caveat. That gap is now measured: at the nominal `tt`
   process corner,
   [`sim/tmds-final-mux-eye/records/20260905-220011-6434eba.md`](../sim/tmds-final-mux-eye/records/20260905-220011-6434eba.md)
   (this cell's own output against `design/cml-driver-sizing.md` §4.1/§4.2's
   targets) and
   [`sim/cml-driver-eye-realmux/records/20260905-223322-6434eba.md`](../sim/cml-driver-eye-realmux/records/20260905-223322-6434eba.md)
   (the driver's own DR-0002 rows, re-measured with the real mux) both
   **PASS**. Issue #163 then closed the disclosed process-corner gap,
   landing the remaining four corners across four more record pairs:
   [`ss`](../sim/tmds-final-mux-eye/records/20260906-011450-6a24db4.md) /
   [`ss` driver-side](../sim/cml-driver-eye-realmux/records/20260906-020818-6a24db4.md),
   [`ff`](../sim/tmds-final-mux-eye/records/20260906-051639-cef4040.md) /
   [`ff` driver-side](../sim/cml-driver-eye-realmux/records/20260906-051647-cef4040.md),
   [`fs`](../sim/tmds-final-mux-eye/records/20260906-051904-cef4040.md) /
   [`fs` driver-side](../sim/cml-driver-eye-realmux/records/20260906-051904-cef4040.md),
   and
   [`sf`](../sim/tmds-final-mux-eye/records/20260906-052053-cef4040.md) /
   [`sf` driver-side](../sim/cml-driver-eye-realmux/records/20260906-052053-cef4040.md)
   — each sweeping the full temperature (−40/27/125 °C) × supply (±10 %) ×
   bit-rate matrix, **completing the mandated 90-point grid for both
   benches**.

   `ss` — the corner `design/tmds-final-mux-sizing.md` §4.2 and issue
   #163's own analysis had already flagged as the most plausible worst case
   for full current-steering commutation — **originally disclosed a
   genuine `vswing_m` FAIL at 2 of its 18 points**
   (`ss_-40c_2.97v_270mbps`: 0.799954 V, 46 µV under the 0.8 V floor;
   `ss_125c_2.97v_270mbps`: 0.798554 V, 1.446 mV under); `vswing_s` PASSed
   at both. `ff` and `fs` were clean 18/18 PASSes. `sf` **disclosed a worse
   shortfall**: `vswing_m` FAILs at 2 points (`sf_125c_2.97v_742p5mbps`:
   0.796899 V, 3.1 mV under; `sf_125c_2.97v_270mbps`: 0.790067 V, 9.9 mV
   under — the largest margin violation of the four), and at the worst
   point `vswing_s` also FAILs (0.793148 V, 6.85 mV under) — the first
   point where *both* stimulus copies fail together. Neither check was
   loosened to force a pass, per this repo's "agents do not relax the
   ratified spec to make results pass" rule; each was filed as its own
   decision-record-worthy finding — **issue #169** (`ss`) and **issue
   #171** (`sf`), the latter noting the two findings likely share a root
   cause (`design/tmds-final-mux-sizing.md` §3's self-biased reference not
   fully cancelling residual process-corner mobility/Vt shift) but manifest
   at opposite temperature extremes (`ss` cold, `sf` hot).

   **Issue #169 has since fixed the `ss` finding.** Root cause: exactly the
   residual §3 names — the resistor-ratio self-bias cancels the *resistor*
   sheet-rho process axis but not `nfet_03v3`'s own `ss`-corner
   mobility/Vt shift, and the shortfall showed up at the lowest-swing
   (2.97 V) supply extreme where there is the least headroom to begin
   with. Fix: `design/tmds_final_mux.sch`'s load resistors `RLP`/`RLN`
   widened `5.66 µm → 5.90 µm` (`r_length`, +4.24 %) — since `swing =
   I_tail * RL` and `I_tail` is set entirely by the `RC`/`RREF` self-bias
   loop (independent of `RL`), this raises `vswing_m` by very nearly the
   same +4.24 % at every corner. Re-verified against the **full `ss`-corner
   matrix**:
   [`sim/tmds-final-mux-eye/records/20260906-070531-94be115.md`](../sim/tmds-final-mux-eye/records/20260906-070531-94be115.md)
   is **18/18 PASS**, `vswing_m` now 0.830797–1.16330 V (previous low
   0.798554 V) — both previously-failing points now clear the floor by
   +30.8 mV / +32.0 mV. The companion driver-side bench was re-checked too:
   [`sim/cml-driver-eye-realmux/records/20260906-072026-94be115.md`](../sim/cml-driver-eye-realmux/records/20260906-072026-94be115.md)
   confirms **18/18 PASS unchanged** after the mux-side change. See
   `design/tmds-final-mux-sizing.md`'s new "Issue #169" subsection for the
   full root-cause/fix/verification writeup.

   **Issue #173 has since re-run `tt`/`ff`/`fs`/`sf` against that same
   fix and confirms `sf` is resolved too.** The `+4.24 %` scaling argument
   that fixed `ss` was a first-principles prediction, not a measurement,
   until this re-run: all four remaining corners —
   [`tt`](../sim/tmds-final-mux-eye/records/20260906-084639-fdb10c5.md) /
   [`tt` driver-side](../sim/cml-driver-eye-realmux/records/20260906-084909-fdb10c5.md),
   [`ff`](../sim/tmds-final-mux-eye/records/20260906-084713-fdb10c5.md) /
   [`ff` driver-side](../sim/cml-driver-eye-realmux/records/20260906-085007-fdb10c5.md),
   [`fs`](../sim/tmds-final-mux-eye/records/20260906-084753-fdb10c5.md) /
   [`fs` driver-side](../sim/cml-driver-eye-realmux/records/20260906-085134-fdb10c5.md),
   and
   [`sf`](../sim/tmds-final-mux-eye/records/20260906-084830-fdb10c5.md) /
   [`sf` driver-side](../sim/cml-driver-eye-realmux/records/20260906-085308-fdb10c5.md)
   — are now **18/18 PASS each** on the current (post-#169) geometry. At
   `sf`'s previously worst point (`sf_125c_2.97v_270mbps`), `vswing_m`
   measures **0.821563 V** (was 0.790067 V, a 9.9 mV FAIL — now +21.6 mV
   clear) and `vswing_s` measures **0.824519 V** (was 0.793148 V, a
   6.85 mV FAIL — now +24.5 mV clear); the prediction held, within
   measurement noise, at the corner it mattered most for. **Issue #171 is
   therefore resolved by the same fix as issue #169**, not by a separate
   change — both `tmds-final-mux-eye` and `cml-driver-eye-realmux` are now
   **90/90 PASS across the complete grid** against the netlist currently
   committed. The companion driver-side records at all four corners remain
   **18/18 PASS each** too — the marginal mux-output shortfall that used to
   exist at `ss`/`sf` never propagated into an observable DR-0002 spec-row
   violation at the driver's own output, at any process corner measured,
   before or after the fix. See §1's two updated subsections above for the
   full numbers.

   **Layout now exists and is DRC/LVS-signed-off (issue #177).**
   `layout/scripts/gen_tmds_final_mux.py` draws this cell against the sized
   schematic above (`mos_array`/`res_array` composition, mirroring
   `cml_driver_core`'s issue #22 generator pattern); `klt drc --deck
   gf180mcu` reports `status: clean` and `klt lvs` reports `status: match`
   against a hand-written reference netlist (`status: mismatch` for the
   required `_shorted` negative control) — see `layout/README.md`'s
   `## tmds_final_mux` section for the full signoff record.

   **What is not yet covered**: no Monte Carlo/mismatch claim on this cell
   (out of scope for a corner-matrix bench); **the post-layout
   re-simulation itself remains open** — re-running `sim/tmds-final-mux-eye`
   / `sim/cml-driver-eye-realmux` against the newly-extracted layout
   netlist (rather than this schematic) has not been done, so every number
   in this section is still schematic-level, not post-layout; no isolated
   clock-pair commutation sweep in isolation from the end-to-end
   measurement; and the 10:1→2:1 reduction stage upstream of this cell's
   `D0`/`D1` inputs is still modelled as an ideal source (the reduction
   stage's own real analog output — synthesized at 480p per DR-0014, custom
   at 720p60 — has not itself been captured). Both the `ss` (#169) and `sf`
   (#171) design-margin findings are now closed by the same `RLP`/`RLN`
   widening, independent of issue #163 (closed for the corner-completion
   slice of this work) and issue #173 (closed for the re-verification
   slice).

No other spec row beyond those listed in §1 has any recorded `sim/`
evidence at all. The encoder/serializer digital domain (DR-0003) is verified
by a separate `flow/tmds_encoder/records/` and `verification/tmds_encoder/`
evidence trail (cocotb, Yosys, OpenROAD — not the `sim/` analog harness §1
indexes); that trail is already folded into this rollup, as §2 above, rather
than left out of it. The PLL interface (§2 of `spec/tmds-tx.md`, DR-0004) is
a requirement levied on a sibling canary block and has no evidence to cite
here by design (DR-0001/CLAUDE.md scope discipline).

## 4. Links

- Ratified spec: [`spec/tmds-tx.md`](../spec/tmds-tx.md)
- Evidence-record convention: [`sim/README.md`](../sim/README.md)
- Driver sizing derivation (cites `sim/cml-driver-eye`):
  [`design/cml-driver-sizing.md`](../design/cml-driver-sizing.md)
- ESD/capacitance measurement study (cites `sim/esd-clamp-cv`):
  [`design/esd-capacitance-budget.md`](../design/esd-capacitance-budget.md)
- Post-layout DUT derivation and its stated limits:
  [`layout/README.md`](../layout/README.md) § "Post-layout simulation of this
  cell", generated by `layout/scripts/gen_cml_driver_core_dut.py`
- Record-to-record delta tool used in §1: `sim/compare_records.py`
- Digital evidence-record convention: [`flow/README.md`](../flow/README.md)
- Digital verification convention (three-leg plan): [`verification/README.md`](../verification/README.md)
- Digital timing-closure follow-up (§2 items 7/8's disclosed setup FAIL): #100
- Coverage self-check for this document (lint step 7): `sim/check_record_citations.py`
- Gap to T1 sim-validated (bronze): originally Epic #17 (**closed COMPLETED
  2026-08-21**), continued by #142; the individually-dispatchable remainder
  was #145 (whether ESD HBM/CDM qualification is schedulable work or a
  permanent pre-silicon limitation, §1's DR-0005 table) — **resolved by
  DR-0015**: accepted as a permanent pre-silicon limitation, and this row
  does **not** block the T1/bronze tier. #149 (adopt the
  production pad geometry in the block assembly, §3 item 4 — the
  investigation that scoped it, #143, is closed) is also closed — the
  `klt lvs` regression that blocked it (klayout-tools#1370) was fixed
  upstream (klayout-tools#1380) and the production geometry landed. #146
  (restore a layout-side `_shorted` LVS negative control for
  `tmds_encoder`, §2 item 5) is closed — klayout-tools#1366 was fixed
  upstream and the layout-side twin restored.
