2AMLogic/gf180-tmds-tx/layout/sim/gf180_tmds_pad_ring_assembly_dut.spice

* gf180_tmds_pad_ring_assembly_dut.spice -- post-layout DUT fragment for sim/cml-driver-eye
* (assembled driver+pad-ring+ESD block, issue #154 / Epic #542 Phase 3)
*
* GENERATED by layout/scripts/gen_pad_ring_assembly_dut.py -- do not edit.
* source        : layout/gds/gf180_tmds_pad_ring_assembly.spice
* source sha256 : c101245de42e21906c0d26cd46f4d498cf0ec93ca055b2ae68eac94e017f3ab7
* devices       : 338 extracted X-card devices (nfet_03v3 + diode_nd2ps_06v0 / diode_pd2nw_06v0 ESD clamps), already PDK-bound
*
* Unlike gen_cml_driver_core_dut.py's input (the bare core cell), this
* extraction is already bound to real PDK subcircuits and already carries
* full parasitic R/C (klt extract --parasitics) -- see this script's own
* module docstring for what that does and does not add relative to the
* existing sim/cml-driver-eye schematic/core-extracted records. The one
* mechanical step needed is a pin-order wrapper:
*   a wrapper presenting the schematic cell boundary (cml_driver OUTP OUTN INP INN IBIAS VSS),
*   so sim/cml-driver-eye's testbench runs unchanged against this DUT too.
*
* The assembly's VDD ring net (VDD-side clamp cathodes and Nwell tap,
* issue #210) is held at the testbench core rail vdd_val by an ideal source
* inside the wrapper, since the six-pin schematic boundary has no VDD pin.
*
* NOT modelled here (state this in any record taken against this netlist):
*   - no package, no board, no bond wire -- only the drawn on-die pad;
*   - no HBM/CDM ESD pulse event -- the clamp diodes are in the
*     small-signal/operating-point circuit only (issue #145, separate).

.subckt cml_driver OUTP OUTN INP INN IBIAS VSS
* gf180_tmds_pad_ring_assembly pin order is the extraction's own (alphabetical, plus the
* promoted internal nodes TAIL, VDD).
vvdd_rail VDD 0 dc {vdd_val}
xcore IBIAS INN INP OUTN OUTP TAIL VDD VSS gf180_tmds_pad_ring_assembly
.ends

* extracted by klt extract --deck gf180mcu
* parasitic model (--parasitics):
* - capacitance: net-to-ground for every net's own (non-coupled) area/perimeter, plus net-to-net for the vertical-overlap coupling `coupling` describes below -- a coupled net pair gets a direct capacitor between their two hub nodes, not just capacitors to the deck's ground/substrate net
* - coupling: vertical overlap (crossover) unconditionally -- where one net's conductor on an adjacent metal level sits directly over another *distinct* net's conductor, that overlap area is charged between the two nets instead of to ground (issue #760) -- plus lateral (same-layer, sidewall) coupling, but only for a net pair naming one of the caller's declared `--critical-net` nets (issue #976): facing-edge length within that layer's own minimum-spacing lookback is charged between the two nets, *additively* (not deducted from either net's substrate fringe term, unlike the vertical case -- a known simplification). Any same-layer pair with neither side named `--critical-net`, and fringe shielding in general, are still not modelled
* - resistance: single lumped series resistance per net, distributed as a star across that net's device terminals (issue #592) -- not a per-segment, distributed RC ladder, *unless* `--distributed-rc` names this net via `--critical-net` (issue #977, Epic #709 Phase 2b): then the net's terminals are ordered along their approximate physical spread and its total R/C is broken into a chain of per-segment resistors (segment length proportional to inter-terminal distance) with a ground capacitor at each terminal node (proportional to its adjacent segment length/2), instead of one star hub -- still an approximation (terminal position is a device-placement proxy, not true per-segment routing geometry), but a strictly finer-grained one than the single-hub star
* - frequency: quasi-static -- one frequency-independent R and C per net; no skin effect, no distributed transmission-line behavior
.GLOBAL vsubs
* cell gf180_tmds_pad_ring_assembly
* pin IBIAS
* pin INN
* pin INP
* pin OUTN
* pin OUTP
* pin TAIL
* pin VDD
* pin VSS
.SUBCKT gf180_tmds_pad_ring_assembly IBIAS INN INP OUTN OUTP TAIL VDD VSS
* device instance $1 r0 *1 326.925,-28.18 nfet
X$1 TAIL__t169 IBIAS__t86 VSS__t147 VSS__t349 nfet_03v3 L=0.5U W=2U AS=0.42P
+ AD=0.42P PS=2.42U PD=2.42U
* device instance $2 r0 *1 327.845,-28.18 nfet
X$2 VSS__t44 IBIAS__t85 TAIL__t270 VSS__t350 nfet_03v3 L=0.5U W=2U AS=0.42P
+ AD=0.42P PS=2.42U PD=2.42U
* device instance $3 r0 *1 328.765,-28.18 nfet
X$3 TAIL__t182 IBIAS__t111 VSS__t160 VSS__t351 nfet_03v3 L=0.5U W=2U AS=0.42P
+ AD=0.42P PS=2.42U PD=2.42U
* device instance $4 r0 *1 329.685,-28.18 nfet
X$4 VSS__t60 IBIAS__t118 TAIL__t286 VSS__t352 nfet_03v3 L=0.5U W=2U AS=0.42P
+ AD=0.42P PS=2.42U PD=2.42U
* device instance $5 r0 *1 330.605,-28.18 nfet
X$5 TAIL__t186 IBIAS__t119 VSS__t164 VSS__t353 nfet_03v3 L=0.5U W=2U AS=0.42P
+ AD=0.42P PS=2.42U PD=2.42U
* device instance $6 r0 *1 331.525,-28.18 nfet
X$6 VSS__t61 IBIAS__t120 TAIL__t287 VSS__t354 nfet_03v3 L=0.5U W=2U AS=0.42P
+ AD=0.42P PS=2.42U PD=2.42U
* device instance $7 r0 *1 332.445,-28.18 nfet
X$7 TAIL__t187 IBIAS__t121 VSS__t165 VSS__t355 nfet_03v3 L=0.5U W=2U AS=0.42P
+ AD=0.42P PS=2.42U PD=2.42U
* device instance $8 r0 *1 333.365,-28.18 nfet
X$8 VSS__t62 IBIAS__t122 TAIL__t288 VSS__t356 nfet_03v3 L=0.5U W=2U AS=0.42P
+ AD=0.42P PS=2.42U PD=2.42U
* device instance $9 r0 *1 334.285,-28.18 nfet
X$9 TAIL__t188 IBIAS__t123 VSS__t166 VSS__t357 nfet_03v3 L=0.5U W=2U AS=0.42P
+ AD=0.42P PS=2.42U PD=2.42U
* device instance $10 r0 *1 335.205,-28.18 nfet
X$10 VSS__t63 IBIAS__t124 TAIL__t289 VSS__t358 nfet_03v3 L=0.5U W=2U AS=0.42P
+ AD=0.42P PS=2.42U PD=2.42U
* device instance $11 r0 *1 336.125,-28.18 nfet
X$11 TAIL__t178 IBIAS__t105 VSS__t156 VSS__t359 nfet_03v3 L=0.5U W=2U AS=0.42P
+ AD=0.42P PS=2.42U PD=2.42U
* device instance $12 r0 *1 337.045,-28.18 nfet
X$12 VSS__t55 IBIAS__t106 TAIL__t281 VSS__t360 nfet_03v3 L=0.5U W=2U AS=0.42P
+ AD=0.42P PS=2.42U PD=2.42U
* device instance $13 r0 *1 337.965,-28.18 nfet
X$13 TAIL__t179 IBIAS__t107 VSS__t157 VSS__t361 nfet_03v3 L=0.5U W=2U AS=0.42P
+ AD=0.42P PS=2.42U PD=2.42U
* device instance $14 r0 *1 338.885,-28.18 nfet
X$14 VSS__t51 IBIAS__t99 TAIL__t277 VSS__t362 nfet_03v3 L=0.5U W=2U AS=0.42P
+ AD=0.42P PS=2.42U PD=2.42U
* device instance $15 r0 *1 339.805,-28.18 nfet
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
+ AD=0.42P PS=2.42U PD=2.42U
* device instance $157 r0 *1 286.445,-28.18 nfet
X$157 TAIL__t214 IBIAS__t185 VSS__t196 VSS__t305 nfet_03v3 L=0.5U W=2U AS=0.42P
+ AD=0.42P PS=2.42U PD=2.42U
* device instance $158 r0 *1 287.365,-28.18 nfet
X$158 VSS__t95 IBIAS__t186 TAIL__t317 VSS__t306 nfet_03v3 L=0.5U W=2U AS=0.42P
+ AD=0.42P PS=2.42U PD=2.42U
* device instance $159 r0 *1 288.285,-28.18 nfet
X$159 TAIL__t215 IBIAS__t187 VSS__t197 VSS__t307 nfet_03v3 L=0.5U W=2U AS=0.42P
+ AD=0.42P PS=2.42U PD=2.42U
* device instance $160 r0 *1 289.205,-28.18 nfet
X$160 VSS__t96 IBIAS__t188 TAIL__t318 VSS__t308 nfet_03v3 L=0.5U W=2U AS=0.42P
+ AD=0.42P PS=2.42U PD=2.42U
* device instance $161 r0 *1 290.125,-28.18 nfet
X$161 TAIL__t216 IBIAS__t189 VSS__t198 VSS__t309 nfet_03v3 L=0.5U W=2U AS=0.42P
+ AD=0.42P PS=2.42U PD=2.42U
* device instance $162 r0 *1 291.045,-28.18 nfet
X$162 VSS__t97 IBIAS__t190 TAIL__t319 VSS__t310 nfet_03v3 L=0.5U W=2U AS=0.42P
+ AD=0.42P PS=2.42U PD=2.42U
* device instance $163 r0 *1 291.965,-28.18 nfet
X$163 TAIL__t217 IBIAS__t191 VSS__t199 VSS__t311 nfet_03v3 L=0.5U W=2U AS=0.42P
+ AD=0.42P PS=2.42U PD=2.42U
* device instance $164 r0 *1 292.885,-28.18 nfet
X$164 VSS__t77 IBIAS__t148 TAIL__t303 VSS__t312 nfet_03v3 L=0.5U W=2U AS=0.42P
+ AD=0.42P PS=2.42U PD=2.42U
* device instance $165 r0 *1 293.805,-28.18 nfet
X$165 TAIL__t168 IBIAS__t84 VSS__t146 VSS__t313 nfet_03v3 L=0.5U W=2U AS=0.42P
+ AD=0.42P PS=2.42U PD=2.42U
* device instance $166 r0 *1 294.725,-28.18 nfet
X$166 VSS__t43 IBIAS__t83 TAIL__t269 VSS__t314 nfet_03v3 L=0.5U W=2U AS=0.42P
+ AD=0.42P PS=2.42U PD=2.42U
* device instance $167 r0 *1 295.645,-28.18 nfet
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
