2AMLogic/gf180-tmds-tx/layout/gds/gf180_tmds_pad_ring_assembly.spice

* extracted by klt extract --deck gf180mcu
* parasitic model (--parasitics):
* - capacitance: net-to-ground for every net's own (non-coupled) area/perimeter, plus net-to-net for the vertical-overlap coupling `coupling` describes below -- a coupled net pair gets a direct capacitor between their two hub nodes, not just capacitors to the deck's ground/substrate net
* - coupling: vertical overlap (crossover) unconditionally -- where one net's conductor on an adjacent metal level sits directly over another *distinct* net's conductor, that overlap area is charged between the two nets instead of to ground (issue #760) -- plus lateral (same-layer, sidewall) coupling, but only for a net pair naming one of the caller's declared `--critical-net` nets (issue #976): facing-edge length within that layer's own minimum-spacing lookback is charged between the two nets, *additively* (not deducted from either net's substrate fringe term, unlike the vertical case -- a known simplification). Any same-layer pair with neither side named `--critical-net`, and fringe shielding in general, are still not modelled
* - resistance: single lumped series resistance per net, distributed as a star across that net's device terminals (issue #592) -- not a per-segment, distributed RC ladder, *unless* `--distributed-rc` names this net via `--critical-net` (issue #977, Epic #709 Phase 2b): then the net's terminals are ordered along their approximate physical spread and its total R/C is broken into a chain of per-segment resistors (segment length proportional to inter-terminal distance) with a ground capacitor at each terminal node (proportional to its adjacent segment length/2), instead of one star hub -- still an approximation (terminal position is a device-placement proxy, not true per-segment routing geometry), but a strictly finer-grained one than the single-hub star
* - frequency: quasi-static -- one frequency-independent R and C per net; no skin effect, no distributed transmission-line behavior

* cell gf180_tmds_pad_ring_assembly
* pin IBIAS
* pin INN
* pin INP
* pin OUTN
* pin OUTP
* pin TAIL
* pin VSS
.SUBCKT gf180_tmds_pad_ring_assembly IBIAS INN INP OUTN OUTP TAIL VSS
* device instance $1 r0 *1 326.925,-28.18 nfet
X$1 TAIL__t186 IBIAS__t118 VSS__t163 VSS__t349 nfet_03v3 L=0.5U W=2U AS=0.42P
+ AD=0.42P PS=2.42U PD=2.42U
* device instance $2 r0 *1 327.845,-28.18 nfet
X$2 VSS__t60 IBIAS__t117 TAIL__t286 VSS__t350 nfet_03v3 L=0.5U W=2U AS=0.42P
+ AD=0.42P PS=2.42U PD=2.42U
* device instance $3 r0 *1 328.765,-28.18 nfet
X$3 TAIL__t197 IBIAS__t140 VSS__t174 VSS__t351 nfet_03v3 L=0.5U W=2U AS=0.42P
+ AD=0.42P PS=2.42U PD=2.42U
* device instance $4 r0 *1 329.685,-28.18 nfet
X$4 VSS__t68 IBIAS__t133 TAIL__t294 VSS__t352 nfet_03v3 L=0.5U W=2U AS=0.42P
+ AD=0.42P PS=2.42U PD=2.42U
* device instance $5 r0 *1 330.605,-28.18 nfet
X$5 TAIL__t193 IBIAS__t132 VSS__t170 VSS__t353 nfet_03v3 L=0.5U W=2U AS=0.42P
+ AD=0.42P PS=2.42U PD=2.42U
* device instance $6 r0 *1 331.525,-28.18 nfet
X$6 VSS__t67 IBIAS__t131 TAIL__t293 VSS__t354 nfet_03v3 L=0.5U W=2U AS=0.42P
+ AD=0.42P PS=2.42U PD=2.42U
* device instance $7 r0 *1 332.445,-28.18 nfet
X$7 TAIL__t192 IBIAS__t130 VSS__t169 VSS__t355 nfet_03v3 L=0.5U W=2U AS=0.42P
+ AD=0.42P PS=2.42U PD=2.42U
* device instance $8 r0 *1 333.365,-28.18 nfet
X$8 VSS__t74 IBIAS__t145 TAIL__t300 VSS__t356 nfet_03v3 L=0.5U W=2U AS=0.42P
+ AD=0.42P PS=2.42U PD=2.42U
* device instance $9 r0 *1 334.285,-28.18 nfet
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
+ AD=0.42P PS=2.42U PD=2.42U
* device instance $170 r0 *1 298.405,-28.18 nfet
X$170 VSS__t70 IBIAS__t137 TAIL__t296 VSS__t318 nfet_03v3 L=0.5U W=2U AS=0.42P
+ AD=0.42P PS=2.42U PD=2.42U
* device instance $171 r0 *1 299.325,-28.18 nfet
X$171 TAIL__t195 IBIAS__t136 VSS__t172 VSS__t319 nfet_03v3 L=0.5U W=2U AS=0.42P
+ AD=0.42P PS=2.42U PD=2.42U
* device instance $172 r0 *1 300.245,-28.18 nfet
X$172 VSS__t69 IBIAS__t135 TAIL__t295 VSS__t320 nfet_03v3 L=0.5U W=2U AS=0.42P
+ AD=0.42P PS=2.42U PD=2.42U
* device instance $173 r0 *1 301.165,-28.18 nfet
X$173 TAIL__t194 IBIAS__t134 VSS__t171 VSS__t321 nfet_03v3 L=0.5U W=2U AS=0.42P
+ AD=0.42P PS=2.42U PD=2.42U
* device instance $174 r0 *1 302.085,-28.18 nfet
X$174 VSS__t61 IBIAS__t119 TAIL__t287 VSS__t322 nfet_03v3 L=0.5U W=2U AS=0.42P
+ AD=0.42P PS=2.42U PD=2.42U
* device instance $175 r0 *1 303.005,-28.18 nfet
X$175 TAIL__t179 IBIAS__t103 VSS__t156 VSS__t323 nfet_03v3 L=0.5U W=2U AS=0.42P
+ AD=0.42P PS=2.42U PD=2.42U
* device instance $176 r0 *1 303.925,-28.18 nfet
X$176 VSS__t48 IBIAS__t92 TAIL__t274 VSS__t324 nfet_03v3 L=0.5U W=2U AS=0.42P
+ AD=0.42P PS=2.42U PD=2.42U
* device instance $177 r0 *1 304.845,-28.18 nfet
X$177 TAIL__t178 IBIAS__t102 VSS__t155 VSS__t325 nfet_03v3 L=0.5U W=2U AS=0.42P
+ AD=0.42P PS=2.42U PD=2.42U
* device instance $178 r0 *1 305.765,-28.18 nfet
X$178 VSS__t52 IBIAS__t101 TAIL__t278 VSS__t326 nfet_03v3 L=0.5U W=2U AS=0.42P
+ AD=0.42P PS=2.42U PD=2.42U
* device instance $179 r0 *1 306.685,-28.18 nfet
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
