2AMLogic/gf180-tmds-tx/layout/gds/gf180_tmds_pad_ring_assembly_shorted.spice

* extracted by klt extract --deck gf180mcu

* cell gf180_tmds_pad_ring_assembly_shorted
* pin IBIAS
* pin INN
* pin INP
* pin OUTN
* pin OUTP,VSS
* pin TAIL
.SUBCKT gf180_tmds_pad_ring_assembly_shorted IBIAS INN INP OUTN OUTP|VSS TAIL
* device instance $1 r0 *1 326.925,-28.18 nfet
M$1 TAIL IBIAS OUTP|VSS OUTP|VSS nfet L=0.5U W=2U AS=0.42P AD=0.42P PS=2.42U
+ PD=2.42U
* device instance $2 r0 *1 327.845,-28.18 nfet
M$2 OUTP|VSS IBIAS TAIL OUTP|VSS nfet L=0.5U W=2U AS=0.42P AD=0.42P PS=2.42U
+ PD=2.42U
* device instance $3 r0 *1 328.765,-28.18 nfet
M$3 TAIL IBIAS OUTP|VSS OUTP|VSS nfet L=0.5U W=2U AS=0.42P AD=0.42P PS=2.42U
+ PD=2.42U
* device instance $4 r0 *1 329.685,-28.18 nfet
M$4 OUTP|VSS IBIAS TAIL OUTP|VSS nfet L=0.5U W=2U AS=0.42P AD=0.42P PS=2.42U
+ PD=2.42U
* device instance $5 r0 *1 330.605,-28.18 nfet
M$5 TAIL IBIAS OUTP|VSS OUTP|VSS nfet L=0.5U W=2U AS=0.42P AD=0.42P PS=2.42U
+ PD=2.42U
* device instance $6 r0 *1 331.525,-28.18 nfet
M$6 OUTP|VSS IBIAS TAIL OUTP|VSS nfet L=0.5U W=2U AS=0.42P AD=0.42P PS=2.42U
+ PD=2.42U
* device instance $7 r0 *1 332.445,-28.18 nfet
M$7 TAIL IBIAS OUTP|VSS OUTP|VSS nfet L=0.5U W=2U AS=0.42P AD=0.42P PS=2.42U
+ PD=2.42U
* device instance $8 r0 *1 333.365,-28.18 nfet
M$8 OUTP|VSS IBIAS TAIL OUTP|VSS nfet L=0.5U W=2U AS=0.42P AD=0.42P PS=2.42U
+ PD=2.42U
* device instance $9 r0 *1 334.285,-28.18 nfet
M$9 TAIL IBIAS OUTP|VSS OUTP|VSS nfet L=0.5U W=2U AS=0.42P AD=0.42P PS=2.42U
+ PD=2.42U
* device instance $10 r0 *1 335.205,-28.18 nfet
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
M$212 TAIL INP OUTP|VSS OUTP|VSS nfet L=0.28U W=2U AS=0.42P AD=0.42P PS=2.42U
+ PD=2.42U
* device instance $213 r0 *1 432.635,-28.18 nfet
M$213 OUTP|VSS INP TAIL OUTP|VSS nfet L=0.28U W=2U AS=0.42P AD=0.42P PS=2.42U
+ PD=2.42U
* device instance $214 r0 *1 433.335,-28.18 nfet
M$214 TAIL INP OUTP|VSS OUTP|VSS nfet L=0.28U W=2U AS=0.42P AD=0.42P PS=2.42U
+ PD=2.42U
* device instance $215 r0 *1 434.035,-28.18 nfet
M$215 OUTP|VSS INP TAIL OUTP|VSS nfet L=0.28U W=2U AS=0.42P AD=0.42P PS=2.42U
+ PD=2.42U
* device instance $216 r0 *1 434.735,-28.18 nfet
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
