2AMLogic/gf180-tmds-tx/sim/cml-driver-eye-mask/testbench/cml_driver_eye_mask.spice

* cml-driver-eye-mask -- GENERATED by sim/cml-driver-eye-mask/gen_testbench.py
* DO NOT HAND-EDIT. Re-run the generator and re-commit instead.
*
* Netlist FRAGMENT (sim/harness/README.md convention): the harness supplies
* the title, gf180mcu model .include/.lib, .temp, the DUT .include
* (cml_driver_dut.spice, shared with sim/cml-driver-eye/), .control/.endc/.end,
* and vdd_val/vdd_nom/temp_c/rate_val. See tb.json's "dut" key.
*
* METHODOLOGY: see this directory's gen_testbench.py module docstring for the
* full derivation. Summary: a PRBS7 (period 127, ITU-T O.150 x^7+x^6+1, all-ones
* seed) stimulus, preceded by a 20-bit rolling-history prefix (the
* sequence's own tail) so the measured 127-bit period starts fully settled, in
* turn preceded by a fixed 3-bit 1-0-1 calibration lead-in (ui_ref's
* reference, independent of the PRBS's own leading bits -- see gen_testbench.py).
* 150 bits driven in total, only the last 127 measured.
* Each UI is tiled into 8 equal phase bins (no fixed sampling instant
* assumed); per bin, the worst-case vertical eye opening is the gap between the
* minimum sampled level over every measured "1" bit and the maximum sampled
* level over every measured "0" bit, at that phase. DR-0013 row 6's combined
* height/width criterion is graded as a sliding 6-bin (0.75 UI) window
* eye-mask test in tb.json's measure section (eyemask_margin_c0/c1/c2).
*
* WHICH RAIL THE MANDATED +/-10 % SUPPLY AXIS IS APPLIED TO / INPUT MODEL:
* identical to sim/cml-driver-eye/testbench/cml_driver_eye.spice -- see that
* file's header for the full rationale (vdd_val is the on-chip 3.3 V core rail
* driving the DR-0003 final multiplexer's ideal-source model; avcc is the
* receiver's separate termination rail, held at nominal here since this
* bench's claim is row 6 only -- avcc sensitivity is sim/cml-driver-eye's job).

.param tbit_s   = '1e-6/rate_val'
.param avcc_nom = 3.3
.param rterm    = 50
.param iref     = 500u
.param vih      = '0.85*vdd_val'
.param vil      = '0.55*vdd_val'
.param tedge    = 80p

* ---- rails ---------------------------------------------------------------
vavcc   avcc   0 dc {avcc_nom}

* ---- stimulus: PRBS7 (see header) -----------------------------------------
vinp inp 0 PWL(0 '{vih}'
+ '{1*tbit_s}' '{vih}'
+ '{1*tbit_s+tedge}' '{vil}'
+ '{2*tbit_s}' '{vil}'
+ '{2*tbit_s+tedge}' '{vih}'
+ '{3*tbit_s}' '{vih}'
+ '{3*tbit_s+tedge}' '{vil}'
+ '{4*tbit_s}' '{vil}'
+ '{4*tbit_s+tedge}' '{vih}'
+ '{5*tbit_s}' '{vih}'
+ '{5*tbit_s+tedge}' '{vih}'
+ '{6*tbit_s}' '{vih}'
+ '{6*tbit_s+tedge}' '{vih}'
+ '{7*tbit_s}' '{vih}'
+ '{7*tbit_s+tedge}' '{vil}'
+ '{8*tbit_s}' '{vil}'
+ '{8*tbit_s+tedge}' '{vih}'
+ '{9*tbit_s}' '{vih}'
+ '{9*tbit_s+tedge}' '{vih}'
+ '{10*tbit_s}' '{vih}'
+ '{10*tbit_s+tedge}' '{vih}'
+ '{11*tbit_s}' '{vih}'
+ '{11*tbit_s+tedge}' '{vil}'
+ '{12*tbit_s}' '{vil}'
+ '{12*tbit_s+tedge}' '{vil}'
+ '{13*tbit_s}' '{vil}'
+ '{13*tbit_s+tedge}' '{vih}'
+ '{14*tbit_s}' '{vih}'
+ '{14*tbit_s+tedge}' '{vih}'
+ '{15*tbit_s}' '{vih}'
+ '{15*tbit_s+tedge}' '{vil}'
+ '{16*tbit_s}' '{vil}'
+ '{16*tbit_s+tedge}' '{vil}'
+ '{17*tbit_s}' '{vil}'
+ '{17*tbit_s+tedge}' '{vih}'
+ '{18*tbit_s}' '{vih}'
+ '{18*tbit_s+tedge}' '{vil}'
+ '{19*tbit_s}' '{vil}'
+ '{19*tbit_s+tedge}' '{vih}'
+ '{20*tbit_s}' '{vih}'
+ '{20*tbit_s+tedge}' '{vil}'
+ '{21*tbit_s}' '{vil}'
+ '{21*tbit_s+tedge}' '{vih}'
+ '{22*tbit_s}' '{vih}'
+ '{22*tbit_s+tedge}' '{vil}'
+ '{23*tbit_s}' '{vil}'
+ '{23*tbit_s+tedge}' '{vih}'
+ '{24*tbit_s}' '{vih}'
+ '{24*tbit_s+tedge}' '{vih}'
+ '{25*tbit_s}' '{vih}'
+ '{25*tbit_s+tedge}' '{vih}'
+ '{26*tbit_s}' '{vih}'
+ '{26*tbit_s+tedge}' '{vih}'
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
+ '{149*tbit_s}' '{vil}'
+ '{149*tbit_s+tedge}' '{vih}'
+ '{150*tbit_s}' '{vih}'
+ r=0 td=0)

* Differential input probe (VCVS workaround -- v(a,b) does not parse inside a
* meas TRIG/TARG expression; confirmed while developing sim/smoke-cml-pair).
einref inref 0 inp inn 1
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
