2AMLogic/gf180-tmds-tx/layout/lvs/tmds_encoder.pnr_signal_only.v

module tmds_encoder (clk,
    de,
    rst,
    ctrl,
    data,
    tmds);
 input clk;
 input de;
 input rst;
 input [1:0] ctrl;
 input [7:0] data;
 output [9:0] tmds;

 wire _001_;
 wire _002_;
 wire _003_;
 wire _004_;
 wire _005_;
 wire _006_;
 wire _007_;
 wire _008_;
 wire _009_;
 wire _010_;
 wire _011_;
 wire _012_;
 wire _013_;
 wire _014_;
 wire _015_;
 wire _016_;
 wire _017_;
 wire _018_;
 wire _019_;
 wire _020_;
 wire _021_;
 wire _022_;
 wire _023_;
 wire _024_;
 wire _025_;
 wire _026_;
 wire _027_;
 wire _028_;
 wire _029_;
 wire _030_;
 wire _031_;
 wire _032_;
 wire _033_;
 wire _034_;
 wire _035_;
 wire _036_;
 wire _037_;
 wire _038_;
 wire _039_;
 wire _040_;
 wire _041_;
 wire _042_;
 wire _043_;
 wire _044_;
 wire _045_;
 wire _046_;
 wire _047_;
 wire _048_;
 wire _049_;
 wire _050_;
 wire _051_;
 wire _052_;
 wire _053_;
 wire _054_;
 wire _055_;
 wire _056_;
 wire _057_;
 wire _058_;
 wire _059_;
 wire _060_;
 wire _061_;
 wire _062_;
 wire _063_;
 wire _064_;
 wire _065_;
 wire _066_;
 wire _067_;
 wire _068_;
 wire _069_;
 wire _070_;
 wire _071_;
 wire _072_;
 wire _073_;
 wire _074_;
 wire _075_;
 wire _076_;
 wire _077_;
 wire _078_;
 wire _079_;
 wire _080_;
 wire _081_;
 wire _082_;
 wire _083_;
 wire _084_;
 wire _085_;
 wire _086_;
 wire _087_;
 wire _088_;
 wire _089_;
 wire _090_;
 wire _091_;
 wire _092_;
 wire _093_;
 wire _094_;
 wire _095_;
 wire _096_;
 wire _097_;
 wire _098_;
 wire _099_;
 wire _100_;
 wire _101_;
 wire _102_;
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
 gf180mcu_fd_sc_mcu9t5v0__inv_3 clkload4 (.I(clknet_3_4__leaf_clk));
 gf180mcu_fd_sc_mcu9t5v0__clkbuf_12 clkload5 (.I(clknet_3_6__leaf_clk));
 gf180mcu_fd_sc_mcu9t5v0__inv_4 clkload6 (.I(clknet_3_7__leaf_clk));
 gf180mcu_fd_sc_mcu9t5v0__dlyc_1 hold1 (.I(ctrl[0]),
    .Z(net1));
 gf180mcu_fd_sc_mcu9t5v0__dlyc_1 hold10 (.I(data[3]),
    .Z(net10));
 gf180mcu_fd_sc_mcu9t5v0__dlyc_1 hold11 (.I(data[4]),
    .Z(net11));
 gf180mcu_fd_sc_mcu9t5v0__dlyc_1 hold2 (.I(ctrl[1]),
    .Z(net2));
 gf180mcu_fd_sc_mcu9t5v0__dlyc_1 hold3 (.I(de),
    .Z(net3));
 gf180mcu_fd_sc_mcu9t5v0__dlyc_1 hold4 (.I(data[1]),
    .Z(net4));
 gf180mcu_fd_sc_mcu9t5v0__dlyc_1 hold5 (.I(data[7]),
    .Z(net5));
 gf180mcu_fd_sc_mcu9t5v0__dlyc_1 hold6 (.I(data[5]),
    .Z(net6));
 gf180mcu_fd_sc_mcu9t5v0__dlyc_1 hold7 (.I(data[2]),
    .Z(net7));
 gf180mcu_fd_sc_mcu9t5v0__dlyc_1 hold8 (.I(data[6]),
    .Z(net8));
 gf180mcu_fd_sc_mcu9t5v0__dlyc_1 hold9 (.I(data[0]),
    .Z(net9));
endmodule
