2AMLogic/gf180-tmds-tx/(commit log)

2026-08-05 Initial commit: TMDS transmitter on gf180mcu
    Scaffolds the block: spec, encoder/serializer RTL and verification, analog
    design and sim for the CML driver, and klayout-tools-driven layout signoff
    including the custom pad cell.
    720p60 is the target, 480p the fallback, 1080p60 a stretch. The PLL comes
    from a sibling block; this repo specifies the interface to it. The custom
    pad ring is the block's central risk and the reason it was opened.
    Apache-2.0. Nothing designed yet.
    Claude-Session: https://claude.ai/code/session_018EY36KFUPii3rDqjw7fkrU
2026-08-05 docs: ratify TMDS TX target spec with decision records (#3)
    * docs: ratify TMDS TX target spec into spec/ with decision records
    Replaces the DRAFT parameter table in README.md with spec/tmds-tx.md,
    which ratifies the target spec and adds five ADR-style decision
    records covering the resolution ladder, driver topology/supply,
    serialization/clocking boundary, the numeric PLL interface (reference
    frequency, output frequencies, jitter budget), and the pad-cell/ESD
    strategy. spec/README.md now documents the decision-record convention
    this establishes.
    * docs: fix bit-rate clock derivation annotation in PLL interface table
    The 720p60 bit-rate clock row annotated its derivation as
    27.000 MHz × 1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
2026-08-05 feat: draw and sign off a minimal custom gf180mcu pad cell (#5)
    Surveys the gf180mcu pad-ring/ESD facts the PDK actually provides
    (spec/pad-ring-esd-survey.md), then draws and DRC/LVS-signs off a
    minimal custom pad: a Metal5 bond pad wired through a Metal1-5 via
    stack to a grounded-gate NMOS ESD clamp, plus an LVS negative-control
    variant. Both klt drc and klt lvs report clean against the layout;
    the NMOS-clamp design was chosen specifically because klt's gf180mcu
    extraction deck has no diode device class, which a first diode-based
    draft hit directly.
    Files two klayout-tools issues surfaced along the way: #539 (klt
    extract/lvs drop device-less circuits entirely, even when labelled)
    and #541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
2026-08-05 docs: add flow/ directory for synthesis and P&R recipes (#7)
    This repo was scaffolded by hand before the canary generator added flow/
    as the standard home for synthesis and place-and-route recipes (Yosys,
    OpenROAD) driven through klt on mixed-signal blocks. Adding it now so the
    convention is in place before the digital half is synthesized.
    Closes #6
2026-08-08 feat: implement TMDS encoder RTL with exhaustive cocotb verification (#13)
    * feat: implement TMDS encoder RTL with exhaustive cocotb verification
    Adds rtl/tmds_encoder.v (DVI-mode transition-minimized, DC-balanced TMDS
    encoder, cited to DVI 1.0 Sec 3.3) and a three-leg cocotb verification
    harness under verification/tmds_encoder/: exhaustive equivalence against
    an independent Python golden model over the full reachable state space
    (9 accumulator states x 256 data words), invariant checks with observed
    values reported (transition bound, accumulator excursion, control/data
    distinguishability, round-trip decode, long-run cumulative disparity),
    and a negative-control DUT that the bench must fail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
    [runner.py, tmds_encoder.v, tmds_encoder_broken.v]
2026-08-08 feat(sim): bootstrap analog sim harness, PDK env, and evidence CI (#15)
    * feat: bootstrap analog sim harness, PDK env, and evidence CI
    Ports the gf180-bandgap sim/harness/ corner runner (single-rail, matching
    this repo's DR-0002/DR-0003 3.3 V domain) and adapts it for this block's
    high-speed transient claims: a first-class bit-rate axis cross-producted
    into the PVT grid and corner-id (742p5mbps / 270mbps, spec/tmds-tx.md #1's
    target and fallback rows), raw ngspice `meas` threshold-crossing
    measurements for rise/fall time, and Operating point / Transient settings
    record fields that sim/check_records.py enforces on every rate-bearing
    record -- including cross-checking the declared rate agains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
2026-08-10 feat(design): size and verify the CML output driver against DR-0002 (#18)
    * feat(design): capture and size the CML output driver (issue #11)
    One lane's DVI-mode TMDS CML output driver: a DC-coupled, current-mode,
    open-drain nfet_03v3 differential pair with an in-cell 1:20 current-mirror
    tail, sized to DR-0002's swing/common-mode targets with a full written
    derivation (tail-current tolerance, headroom inequality, switch-pair
    sizing, bandwidth vs. pad capacitance, device stress margin).
    Adds the sim/cml-driver-eye testbench (PVT x bit-rate x pad-cap matrix);
    the evidence record lands in a follow-up commit once this commit gives the
    harness a clean tree to run against.
    * test(sim): record fu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
    [cml_driver.sch]
2026-08-10 docs(spec): add DR-0006 ratifying DR-0002's common-mode window as a nominal-supply figure (#20)
    Issue #11's driver evidence shows DR-0002's 2.8-3.3 V common-mode target is
    met cleanly at nominal AVCC=3.3V but is structurally crossed at the +/-10%
    supply corners the PVT matrix mandates (2.711 V low, 3.384 V high), because
    the DC-coupled open-drain topology pins the off leg's output to AVCC
    almost 1:1. DR-0006 rules this is a nominal-supply figure with an explicit
    supply-tracking tolerance rather than a flat absolute window, and corrects
    design/cml-driver-sizing.md's now-inaccurate "no spec/ change was needed"
    line and its "not spec-bound" AVCC-sensitivity labeling accordingly.
    Co-authored-by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
2026-08-10 chore(repo-skills): install Repo Skills 0.10.0
    This repo had NO Repo Skills install at all — not a stale one. A third of the
    fleet was in that state, which reframes 2AMLogic/2am#56: that issue reads as
    "0.8.1 landed only in 2am", but nine repos had never had the tool, including
    canaries that carry the destructive-command guard the rest of the toolchain
    assumes is present.
    Committed straight to main rather than via a per-repo branch. The 0.8.1
    rollout used branch-per-repo and seven of those branches were abandoned
    mid-flight, leaving their repos parked off trunk and invisible —
    compute-drift.sh's axis 3 compares a checkout against its OWN branch, so a
    repo current with a stale branch rep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
2026-08-14 feat(design): validate DR-0005's ESD/capacitance tension on the real pad cell (issue #12) (#21)
    Size the GGNMOS clamp on layout/gds/gf180_tmds_pad_min.gds against HBM >= 2 kV /
    CDM >= 500 V, and measure the resulting pad-node capacitance against DR-0005's
    <= 2 pF budget across the full PVT matrix (sim/esd-clamp-cv, record
    20260814-193222-dd48630).
    Verdict: the ESD side is easy (a clamp sized past 2 kV costs well under 1 pF at
    every corner). The budget is closed by the pad's own parasitic capacitance once
    a realistic 25x25 um bond-pad size is used (6.4-7.1 pF, >3x the entire budget)
    -- not by clamp sizing. Per the operator's 2026-08-14 guardrail, this is
    reported as a quantified shortfall ra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
2026-08-15 docs(measurements): add block characterization report aggregating sim evidence (#29)
    * docs(measurements): add block characterization report aggregating sim evidence
    Adds measurements/characterization.md, a single rollup citing
    sim/smoke-cml-pair, sim/cml-driver-eye, and sim/esd-clamp-cv against the
    specific DR-0002/DR-0005 spec rows each substantiates, and naming what is
    not yet covered (PVT-vs-ratified-spec gated by #9, post-layout
    re-simulation, Monte Carlo evidence) explicitly rather than by omission.
    Closes #24
    * docs(measurements): name sibling layout/Monte Carlo issues in the coverage gap list
2026-08-15 feat(sim): add Monte Carlo mismatch sweep for the CML driver's swing/common-mode (#32)
    Adds sim/cml-driver-mismatch/, a bespoke (non-PVT-grid) ngspice experiment
    that layers gf180mcu's own local-mismatch device models (nfet_03v3_dss,
    sw_stat_mismatch=1) on the CML driver's DR-0002 swing/common-mode claim,
    combined with the mos process-corner set (tt/ff/ss/fs/sf) sim/cml-driver-eye
    already validates deterministically. Each corner gets N=30 independently
    seeded Monte Carlo samples plus a deterministic mismatch=0 reference point;
    a fixed-seed, deliberately amplified negative control (tt_mcneg) proves the
    pass/fail check actually fires before any record is written.
    Reuses sim/harness/pdk.py, si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
2026-08-15 docs(measurements): note esd-clamp-cv's dirty-tree caveat in characterization.md (#33)
    The two DR-0005 rows citing sim/esd-clamp-cv/records/20260814-193222-dd48630.md
    were missing the same dirty-working-tree provenance caveat that the
    smoke-cml-pair harness row already carries, despite the underlying record
    self-flagging the same issue. Add the caveat, cross-referencing
    sim/README.md's cold-start reproducibility audit (issue #25) which confirms
    the record reproduces cleanly on a clean checkout.
2026-08-15 feat(layout): lay out the CML driver core cell and sign off DRC/LVS (issue #22) (#31)
    * feat(layout): lay out the CML driver core cell and sign off DRC/LVS (issue #22)
    Draws the differential switch pair + tail current source + bias-mirror
    reference device from the sized schematic (design/cml_driver.sch,
    design/netlist/cml_driver.spice, issue #11) via klt gen's mos_array
    generator (one folded multi-finger NMOS per device) composed with klt
    gen-compose -- the first cell in this repo built through that generator
    machinery rather than hand-drawn klayout.db, per the issue's instruction
    to reuse a generator-tool-backed flow. Commits the GDS (clean cell + an
    OUTP-shorted-to-VSS LVS negative contro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
2026-08-15 refactor: dedupe parse_measurements in sim/cml-driver-mismatch/run_mc.py (#41)
    _MEAS_RE and parse_measurements() in run_mc.py were a byte-identical
    reimplementation of harness.runner's copy. Import parse_measurements
    from harness.runner instead, and drop the now-unused `import re`.
2026-08-15 refactor(sim): remove dead device_corner_id() and unused PvtPoint.index (#51)
    Neither symbol has a caller/reader anywhere in the repo. device_corner_id()
    was ported from gf180-bandgap for a future device-level testbench that
    doesn't exist yet; PvtPoint.index was written by build_grid() but never
    read (as_dict() doesn't serialize it, and runner.py tracks grid position
    independently via its own enumerate()).
    Also drops the now-dangling docstring cross-reference to
    corners.device_corner_id in report.py's device_log_header().
    Closes #48
2026-08-15 feat(sim): sweep the CML driver's PVT matrix on the extracted netlist (#52)
    * feat(layout): derive a simulatable DUT fragment from the extracted CML driver netlist
    layout/gds/cml_driver_core.spice is an LVS signoff artifact, not a
    simulatable deck: every device is an M-card naming klt's extraction-deck
    class label `nfet` (no PDK ships such a model), the cell boundary carries a
    deck-synthesized `vsubs` body pin plus the promoted internal node TAIL, and
    the pin order is the extractor's own.
    gen_cml_driver_core_dut.py mechanically resolves those three gaps -- model
    binding to the PDK's nfet_03v3 subcircuit carrying the extracted
    AS/AD/PS/PD through unchanged, the vsubs -> VSS body tie an NMOS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
2026-08-15 refactor(sim): consolidate compare_records._fmt into harness.report._fmt (#63)
    sim/compare_records.py::_fmt duplicated sim/harness/report.py::_fmt --
    both implement the same dynamic-notation scalar formatting rule
    (scientific notation below 1e-3 or at/above 1e5, else %.6g), differing
    only in their missing-value sentinel (None vs NaN).
    Extend report._fmt to treat NaN the same as None (both render "n/a"),
    then have compare_records.py import report._fmt via the same
    sys.path.insert(SIM_DIR) + `from harness.report import _fmt` pattern
    run_mc.py already uses, and delete compare_records.py's private copy.
    run_mc.py::_fmt (fixed .6f Monte Carlo stats formatting) is untouched
    -- different, intentio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
2026-08-15 refactor(sim): drop unused device_log_header and corner_id_rate_mbps (#71)
    Both helpers were dead: neither had a caller outside its own definition
    file, and `corner_id_rate_mbps` was exercised only by its own unit test.
    `device_log_header` was also actively misleading. run_mc.py's module
    docstring claimed it was "reused here unmodified", but run_mc.py never
    imported it -- it hand-rolls a richer banner inline (seed,
    sw_stat_mismatch, par_pair/par_tail/par_mirror, a real supply value), so
    the two formats had already diverged. Replace that claim, and the
    report.py comment block promising a shared header "kept here" for future
    reuse, with a statement of what is actually true: each device-level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
2026-08-16 flow: synthesize tmds_encoder to a gf180mcu gate-level netlist (#90)
    * flow: add Yosys synthesis driver for tmds_encoder
    Wires up the digital synthesis flow CLAUDE.md's Digital line names
    (Yosys against the gf180mcu standard-cell library) for rtl/tmds_encoder.v,
    per spec/tmds-tx.md DR-0003's synthesized-domain target
    (gf180mcu_fd_sc_mcu9t5v0, tt_025C_3v30 corner). Netlist and evidence
    record are generated by a follow-up commit so the record's
    reproducibility field can honestly report a clean tree.
    * flow: explain synthesis warnings mechanically in the evidence record
    Adds an explicit Warnings field to the evidence record that names and
    explains every distinct Warning: line the run's log c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
2026-08-16 flow: place-and-route tmds_encoder to a gf180mcu digital block-level GDS (#92)
    Adds an OpenROAD place-and-route driver (flow/pnr_tmds_encoder.py) that
    takes issue #82's synthesized netlist through floorplan, tap/endcap, PDN,
    placement, and routing, then merges the routed DEF into a block-level GDS
    in-process via the klayout PyPI package (never a klayout subprocess).
    Finds and fixes two real upstream DEF->GDS-merge defects along the way: a
    DBU mismatch between OpenROAD-flow-scripts' gf180 KLayout tech file and
    this design's own tech LEF that silently dropped most via-cut geometry, and
    a related DBU-mismatch corruption when merging the standard-cell GDS
    library afterward. Both are corrected i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
    [pnr_tmds_encoder.py]
2026-08-16 flow: extract back-annotated SDF and re-verify gate-level netlist against it (#93)
    * flow: extract back-annotated SDF and re-verify gate-level netlist against it
    Adds flow/sdf_tmds_encoder.py, an OpenSTA driver that extracts RC
    parasitics from the routed DEF (via OpenRCX, gf180's own typical-corner
    rule deck) and writes a back-annotated SDF plus its underlying SPEF at
    the same tt_025C_3v30 corner #82/#84 used.
    Adds flow/gate_level_sim_tmds_encoder.py, which re-runs the exact same,
    unmodified verification/tmds_encoder/test_tmds_encoder.py cocotb bench
    against the synthesized netlist with those real post-route delays
    back-annotated via Icarus Verilog's $sdf_annotate -- a fourth DUT variant
    o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
    [tmds_encoder.sdf]
2026-08-16 refactor: dedupe append-only guard across report.py's evidence writers (#98)
    Extract a shared _refuse_if_exists(path, message) helper and route
    write_netlist_snapshot, write_record, device_write_record, and
    write_device_netlist_snapshot through it. This removes three duplicated
    inline path.exists()/raise guards, closes a silent-overwrite gap in
    write_device_netlist_snapshot (it previously had no guard at all before
    its shutil.copyfile call), and fixes device_write_record to raise
    RecordExists instead of a bare RuntimeError, matching its sibling
    write_record.
    Adds a regression test in sim/tests/test_harness.py that forces the
    collision case for write_device_netlist_snapshot.
    Closes #95
    Co-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
2026-08-16 fix: remove unused import os in gate_level_sim_tmds_encoder.py (#99)
    Leftover from PR #93; ruff --select F401 confirmed it's unused.
    [gate_level_sim_tmds_encoder.py]
2026-08-16 flow: run multi-corner setup/hold STA on the tmds_encoder gate-level netlist (#101)
    * flow: add multi-corner OpenSTA setup/hold driver for tmds_encoder
    Adds flow/sta_tmds_encoder.py, the first driver in this flow that renders a
    timing-closure verdict. It runs OpenSTA over the committed gate-level netlist
    as physically realized by the routed DEF, with the committed post-route SPEF
    back-annotated, across all five 3.3 V liberty corners the
    gf180mcu_fd_sc_mcu9t5v0 library ships, at both of spec/tmds-tx.md's
    pixel-clock rates (74.25 MHz / 27.000 MHz).
    The driver generates the constraint file it analyses against rather than
    assuming one exists, mechanically asserts that the DEF realizes that exa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
2026-08-16 refactor: dedupe run_openroad() in sdf_tmds_encoder.py onto pnr_tmds_encoder (#104)
    sdf_tmds_encoder.py redefined an identical run_openroad() helper that
    flow/pnr_tmds_encoder.py already provides. Delete the local copy and call
    pnr.run_openroad() instead, via the module's existing `import
    pnr_tmds_encoder as pnr`. Drops the now-unused `subprocess` import.
2026-08-17 docs: fold digital-partition results into the block characterization rollup (#109)
    Adds a §2 'Digital partition' section to measurements/characterization.md,
    indexing the tmds_encoder synthesis/P&R/STA/verification pipeline (#82-#85)
    alongside the existing analog CML-driver rollup. Functional verification,
    synthesis, layout existence, and post-layout re-simulation are reported as
    PASS; DRC (188 mim.space.1 violations, klayout-tools#1033), LVS (10 P&R
    utility-cell mismatches), and setup timing closure at 720p60 (FAIL at 4/5
    corners, 22.70 MHz worst-corner Fmax vs. 74.25 MHz required) are reported as
    disclosed FAILs with named causes and follow-up (#100), per CLAUDE.md's
    'Verification is the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
2026-08-17 flow: timing-driven synthesis + CTS/hold-repair for tmds_encoder (#111)
    * flow: timing-driven synthesis + CTS/hold-repair for tmds_encoder (#100)
    Issue #83's multi-corner STA found setup failing at 4/5 corners at the
    720p60 pixel clock, on a netlist synthesized with no clock constraint
    at all (area-only, every cell forced to drive strength 1) and placed
    without clock-tree synthesis. This is steps 1+2 of #100's scope:
    - flow/synth_tmds_encoder.py: ABC now maps against an explicit delay
    target (spec/tmds-tx.md 74.25 MHz) using the worst setup corner's own
    liberty (ss_125C_3v00, per #83's record) rather than the nominal
    corner -- a netlist that meets the target there carries margin at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
    [tmds_encoder.sdf]
2026-08-17 refactor: dedupe run_openroad/openroad_version onto pnr_tmds_encoder (#114)
    flow/sta_tmds_encoder.py carried its own run_openroad() (identical to
    pnr_tmds_encoder.py's except for a redundant explicit script_path arg
    that every call site already derived as log_path.with_suffix(".tcl"))
    and its own openroad_version(), byte-for-byte identical to the copy in
    sdf_tmds_encoder.py. Neither had a canonical home in pnr_tmds_encoder.py.
    - Add openroad_version() to pnr_tmds_encoder.py (moved verbatim).
    - Delete both local defs from sta_tmds_encoder.py; call sites now use
    pnr.run_openroad(...) (dropping the now-redundant script_path local)
    and pnr.openroad_version(...). Drops the now-unused subproc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
2026-08-17 digital: pipeline tmds_encoder's stage1->stage2 boundary (DR-0008) (#116)
    Closes most of the residual 720p60 setup-timing deficit issue #100 left
    after timing-driven synthesis + CTS (spec/tmds-tx.md DR-0007): a pipeline
    register now sits between rtl/tmds_encoder.v's stage1 (transition-
    minimizing XOR/XNOR chain) and stage2 (DC-balancing disparity arithmetic),
    splitting the single combinational cone DR-0007 measured into two
    shallower ones. This changes tmds_encoder's latency contract from one
    clock to two (rst keeps its original one-cycle latency, per DR-0008's
    "Alternatives considered").
    Ratified spec/tmds-tx.md DR-0008 before landing the RTL change, per
    CLAUDE.md and DR-0007's own guardra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
    [tmds_encoder.sdf]
2026-08-17 digital: four-stage tmds_encoder pipeline closes 720p60 setup at all 5 corners (DR-0009) (#121)
    * spec: ratify DR-0009 -- tmds_encoder four-stage pipeline, four-clock latency
    DR-0008's single stage1->stage2 boundary register closed 720p60 setup at 3
    of 5 corners; ss_125C_3v00 (-13.5129 ns) and ss_n40C_3v00 (-5.0300 ns) still
    missed. DR-0009 specifies the follow-up architecture change DR-0008's own
    "Consequences" required be ratified before landing as RTL:
    - four pipeline stages (S1 popcount/threshold, S2 transition-minimized
    word, S3 accumulator-independent DC-balance candidates, S4 decision +
    accumulator recurrence), i.e. a four-clock input-to-tmds latency
    contract supersedi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
    [tmds_encoder.sdf]
2026-08-19 docs: ratify PDK variant, pad/ESD, PLL-interface, and PVT-matrix decision records (#122)
    Adds DR-0010 through DR-0013 (renumbered from issue #9's originally-drafted
    DR-0006-DR-0009, which collided with decisions ratified elsewhere while #9
    was open): pins gf180mcuC as the design/verification PDK variant, reaffirms
    the diode-based ESD clamp with a real klt LVS verification against a fresh
    diode-clamp draft, completes spec/tmds-tx.md §2's PLL interface contract,
    and ratifies the PVT matrix and operating-conditions spec rows already used
    as a working default throughout sim/ and flow/.
    Closes #9
2026-08-19 analog: redesign pad/ESD structure at real 25x25um pad, close DR-0005/DR-0011 capacitance budget (#87) (#124)
    design/esd-capacitance-budget.md's prior 7.95 pF "realistic pad" figure
    (Sec.4b) carried a units-label bug: the aF arithmetic was correct, but the
    final line divided by 1,000 (aF->fF) and then wrote the result as pF, a
    1000x overstatement. A real klt extract --parasitics measurement against
    an actually-drawn 25x25um Metal5 pad confirms the corrected value directly
    (6.66235 fF, matching the corrected hand figure to 0.02%, byte-identical
    between gf180mcuC/gf180mcuD per DR-0010).
    Beyond that correction, this issue draws and measures a real redesign:
    layout/gds/gf180_tmds_pad_v2.gds is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
2026-08-19 analog: assemble cml_driver_core + diode-clamped pad-ring block (DR-0011) (#125)
    * analog: assemble cml_driver_core + diode-clamped pad ring (DR-0011)
    Combines cml_driver_core.gds with two diode_nd2ps_06v0-clamped bond pads
    (OUTP/OUTN) at DR-0011's ratified 350um pad pitch, DVDD/DVSS Metal3/4/5
    ring straps (via-stitched for continuity), and an explicit substrate tap
    tied to the real VSS net. DRC-clean and LVS status:match (2 benign
    topology warnings, no device.body_unverified) for both the assembly and
    its OUTP-shorted-to-VSS negative control.
    * analog: regenerate pad-ring assembly LVS report pair from an agreeing run
    The committed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
2026-08-19 docs: correct DR-0010 and downstream citations to pin gf180mcuD (#128)
    DR-0010 (spec/decisions/0010-pdk-variant.md), merged via PR #122, pinned
    gf180mcuC -- but that PR raced a late-arriving operator amendment on issue
    #9 (posted 2026-08-19T04:35:28Z, six minutes before PR #122 merged, twenty
    seconds after PR #122 was opened) that supersedes the ruling and mandates
    gf180mcuD: wafer.space's GF180MCU shuttle runs (which this program's and
    TinyTapeout's GF shuttles both submit through) advertise the gf180mcuD
    stack.
    This is a citation-only correction across the 9 affected files: DR-0010's
    own Decision/Alternatives/Contingency/Consequences text, sim/pdk.json's
    variant field and inline comment,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
2026-08-19 layout: enforce LVS negative-control verdicts, re-sign-off gf180_tmds_pad_v2 (#130)
    * layout: enforce LVS negative-control verdicts, re-sign-off gf180_tmds_pad_v2
    An upstream gf180mcu extraction-deck drift (klayout-tools#1196) rebound
    diode_nd2ps_06v0's anode from gf180_tmds_pad_v2's real drawn VSS tap onto
    the deck's synthesized `vsubs` global. The substituted net size-matched the
    reference netlist's separate VSS, so the `_shorted` negative control flipped
    from the intended `mismatch` to `match` -- reporting a cell whose geometry
    still shorts PAD to VSS as a clean pass. Nothing here noticed, because the
    signoff verdicts are committed artifacts and `match` looks like good news.
    Reproduced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
2026-08-19 layout: regenerate and re-sign-off against gf180mcuD (DR-0010, issue #127) (#133)
    Regenerates and re-runs klt drc/extract/lvs for all 6 layout deliverables
    per DR-0010's operator-amended gf180mcuC -> gf180mcuD pin. Only
    cml_driver_core's generator resolves real PDK-checkout paths per variant
    (klt gen mos_array --pdk); the flip to DEFAULT_PDK = "gf180mcuD" is verified
    geometry-neutral by a full per-layer Region XOR between --pdk gf180mcuC and
    --pdk gf180mcuD builds (empty on every layer) rather than merely asserted.
    The four hand-drawn pad cells (gf180_tmds_pad_min, gf180_tmds_pad_diode_draft,
    gf180_tmds_pad_v2, gf180_tmds_pad_ring_assembly) take no --pdk argument at
    all and are geometry-inva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
2026-08-19 ci: prevent apt-get install hang on needrestart prompt (#131) (#134)
    The tmds-encoder-verification job's Install Icarus Verilog and Yosys
    step hung indefinitely (twice in a row) on ubuntu-latest runners.
    Suspected cause: apt-get install can trigger an interactive
    needrestart whiptail prompt with no TTY available in CI, blocking
    forever. Set DEBIAN_FRONTEND=noninteractive and NEEDRESTART_MODE=a on
    the step so apt-get cannot block on that prompt.
2026-08-21 docs: refresh characterization.md and README status for landed STA, DR-0013, pad-ring assembly (#138)
    measurements/characterization.md §2 now cites the post-CTS four-stage-pipeline
    STA record (setup PASS at all 5 corners, Fmax 75.83 MHz worst-corner),
    replacing the superseded pre-CTS record that had it backwards (FAIL at 4/5
    corners, 22.70 MHz). §3 reflects DR-0013's ratification of the PVT matrix and
    notes the pad-ring assembly (#86) now exists, DRC-clean/LVS-matched, though
    its own electrical simulation is still an open gap. README's Status line and
    maturity ladder drop the stale "not yet assembled" / "post-layout sim in
    progress" claims. Digital LVS mismatch and the eye-mask/pad-cap/ESD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
2026-08-21 docs: reconcile characterization.md §2 DRC/LVS rows with current JSON reports (#140)
    Row 4 (DRC) reported a 188-violation mim.space.1 FAIL that has been
    `status: clean, violation_count: 0` since PR #133 (issue #127); row 5
    (LVS) reported 10 mismatches / 281 nets against the JSON's current 18
    mismatches and {layout: 384, reference: 357, matched: 173} nets. Both
    rows, the intro sentence, and the "What this means" summary are updated
    to match layout/drc_reports/tmds_encoder.drc.json and
    layout/lvs_reports/tmds_encoder.lvs.json as they exist on disk.
2026-08-25 Fix stale pad-capacitance verdict and close the digital LVS mismatch (#142, streams 1-2) (#147)
    * docs: re-point pad-capacitance-budget verdict at esd-capacitance-budget.md §9
    `measurements/characterization.md`'s DR-0005 row still reported §5's
    "7.95 pF worst case, 4.0x over the 2 pF budget" FAIL. That verdict was
    retracted on 2026-08-19 by issue #87 / PR #124, which added §9 to
    `design/esd-capacitance-budget.md` explicitly superseding §5 on two
    independent grounds:
    1. §5's "realistic bond pad" figure carried a 1000x units-label bug -- the
    aF arithmetic was correct but the result was divided by 1,000 (aF->fF)
    and then labelled pF. The real bare-25x25 um Metal5 plate figure is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
    [gen_pnr_netlist.py, tmds_encoder.pnr.v]
2026-08-25 docs+lint: index the Monte Carlo record in characterization.md and enforce record coverage (#148)
    measurements/characterization.md describes itself as "one artifact, citing
    every evidence record". It cited five of six. The missing one was
    sim/cml-driver-mismatch/records/20260815-044555-9e8a33a.md -- the Monte
    Carlo device-mismatch record (T1 checklist item 6, landed 2026-08-15 by
    issue #23) -- and §3 item 3 did not merely omit it, it asserted that no
    record in sim/ carried a Statistical convention field and that #23 "has not
    landed as of this document". Both were false for ten days and survived five
    subsequent revisions of the file.
    - §1 gains a "DR-0002, Monte Carlo device-mismatch corro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
2026-08-25 Add eye-mask testbench grading DR-0013 row 6 (combined swing+jitter), full PVT (#151)
    sim/cml-driver-eye-mask/ closes the last genuinely-untested criterion in
    DR-0013's operating-conditions table: a combined eye-mask pass/fail (height
    >= 200 mV AND width >= 0.75 UI, simultaneously, at the eye's widest opening,
    no fixed sampling instant assumed), derived arithmetically from already-
    ratified rows 1 and 3, not a new invented criterion.
    The bench drives a genuine PRBS7 (ITU-T O.150, period 127) pattern -- long
    enough to develop real inter-symbol interference, unlike
    sim/cml-driver-eye's fixed single-transition measurements -- reusing that
    bench's cml_driver_dut.spice DUT wrapper and sim/run_co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
2026-08-25 Investigate: gf180_tmds_pad_v2's pad geometry fits DR-0011's 350 um pitch (#150)
    Answers issue #143: draws a two-slot block-level pad-ring tile at DR-0011's
    ratified 350 um pitch / 75 um depth carrying gf180_tmds_pad_v2's production
    25x25 um pad geometry, the DVDD/DVSS ring straps, a substrate tap, and a
    folded diode_nd2ps_06v0 clamp array across the full 222-668 um HBM-sizing
    window. Verdict: yes, with two required changes -- fold the clamp array
    into rows above ~125 fingers (an unfolded 334-finger row is 2.5x the
    ratified pitch), and raise the pad structure ~5 um higher in the ring depth
    so the Metal5 plate clears the DVDD strap band. klt drc is clean at every
    size, klt components confirms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
2026-08-25 feat: land production 25x25um pad geometry in the block-level pad ring (#153)
    Fold gf180_tmds_pad_v2's production 25x25um Metal5 bond pad and 20-finger
    diode_nd2ps_06v0 clamp array into gen_pad_ring_assembly.py, replacing the
    2x2um placeholder pad from gen_pad_diode_draft.py -- porting the row-fold
    and hard-error-guard arithmetic pad_pitch_fit_study.py already validated
    (issue #143). Raises PAD_STRUCT_OY_UM to 30.0um to clear the DVDD strap
    band, centers each pad structure in its own 350um slot, and lands the
    driver-to-pad Metal2 routes on each pad's row-0 Metal1 bus centre.
    The klt lvs regression that previously blocked this redraw
    (klayout-tools#1370) is resolved upstream (klayout-tools#1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
2026-09-05 feat(champion): standing authorization for design-evidence auto-merge (#6850)
    Operator ruling 2026-09-05: Judge-approved, green-CI PRs whose entire
    changed-file set lives in design/, sim/, layout/, measurements/,
    verification/, or docs/ auto-merge without the four-axis human hold.
    Rationale: canary design evidence is fully revertible with no fleet-infra
    blast radius, and the held-PR pattern (sky130-sar-adc#123 sat mergeable for
    days as the sole blocker of a layout chain) costs more than it protects
    here. spec/ and every tool surface fall outside the patterns, so the
    exact-subset rule keeps them on the four-axis judgment automatically.
    C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
2026-09-05 feat: PVT-verify the driver+pad-ring assembly and write the Challenge #5 proposal (#162)
    Closes #154
    Lands the first electrical/PVT simulation of the assembled
    driver+pad-ring/ESD block (gf180_tmds_pad_ring_assembly), closing the
    "no electrical/PVT simulation of its own yet" gap this repo's own
    README/characterization.md previously named:
    - layout/scripts/gen_pad_ring_assembly_dut.py + layout/sim/
    gf180_tmds_pad_ring_assembly_dut.spice: a simulatable DUT fragment
    mechanically derived from the parasitics-extracted GDS (klt extract
    --deck gf180mcu --parasitics), with a diode-parameter rename and a
    schematic-boundary wrapper. Asserted device-by-device and net-by-net
    against the LVS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
2026-09-05 feat(design,rtl,spec): serializer/final-mux stage — DR-0014, real analog verification (#164)
    Closes the loose end DR-0003 left open ("the 10:1->2:1 serializer ... is
    still unwritten and still unmeasured"): rtl/tmds_serializer.v implements
    the synthesized 10:1->2:1 reduction plus DR-0012 Decision 1's internal
    divide-by-two, verified against the real tmds_encoder's output
    (verification/tmds_serializer/, both operating points, plus a negative
    control) rather than hand-written stimulus.
    DR-0014 (spec/decisions/0014-serializer-rate-ceiling-and-microarchitecture.md)
    measures the open question directly from the vendored liberty file
    (flow/serializer_rate_feasibility.py): a register-to-register p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
    [tmds_final_mux.sch]
2026-09-06 feat: land the remaining ff/ss/fs/sf PVT corners for the pad-ring assembly (#165)
    Runs the existing cml-driver-eye testbench against the existing extracted
    gf180_tmds_pad_ring_assembly DUT for the four mos-set corners the tt-only
    record (issue #154) disclosed as an open subset -- ff, ss, fs, and sf --
    each landed as its own appended record (18 points, all PASS). All 5 mos
    corners now have electrical/PVT evidence for the assembled block (90/90
    points, all PASS). Updates measurements/characterization.md and
    docs/chipalooza/challenge-5-proposal.md to state the full-matrix result and
    drop the tt-only subset caveat, plus the same stale claim in README.md and
    layout/README.md.
    An initial -j8/300s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
2026-09-06 feat: post-layout eye-mask (DR-0013 row 6) record against the extracted pad-ring-assembly DUT (#166)
    Runs sim/cml-driver-eye-mask's existing PRBS7 eye-mask testbench against
    layout/sim/gf180_tmds_pad_ring_assembly_dut.spice (issue #154's extracted
    driver+pad-ring+ESD assembly), full PVT x rate x pad-cap grid (90/90 points,
    clean tree). Mints record 20260905-222646-a2b1051 (Supersedes the schematic/
    dirty-tree record 20260825-040412-4b0c9f6 -- this experiment's first citable
    clean-tree result), overall PASS, worst-case eyemask margin 0.859 V (>= 4.29x
    the 0.2 V floor). Folds the sim/compare_records.py delta into
    measurements/characterization.md's DR-0013 row 6 subsection and drops the
    "no pos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
2026-09-06 feat(sim): land the ss process corner for tmds-final-mux-eye and cml-driver-eye-realmux (#170)
    Part of #163
    Extends both benches' disclosed 18-of-90-point tt-only PVT subset (issue
    #159 / PR #164) with the ss (slow-NMOS/slow-PMOS/slow-passive) process
    corner, across the full temperature/supply/rate matrix -- 36 of the
    mandated 90 points now landed for each bench.
    - sim/tmds-final-mux-eye/records/20260906-011450-6a24db4.md: ss corner,
    18/18 points completed. Discloses a genuine, narrow vswing_m FAIL at 2
    points (ss_-40c_2.97v_270mbps: -46 uV under the 0.8 V floor;
    ss_125c_2.97v_270mbps: -1.446 mV under) -- the corner the design's own
    sizing derivation (design/tmds-final-mux-sizing.m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
2026-09-06 feat(sim): land ff/fs/sf process corners for tmds-final-mux-eye and cml-driver-eye-realmux (#172)
    Completes the full 5-corner (tt/ff/ss/fs/sf) PVT grid for both benches --
    90/90 points each -- picking up where PR #170 (ss) and PR #164 (tt) left
    off.
    - sim/tmds-final-mux-eye: ff and fs are clean 18/18 PASS. sf discloses a
    genuine, worse-than-ss vswing_m/vswing_s shortfall at 125C/2.97V (both
    rates fail vswing_m, the 270 Mbps point also fails vswing_s -- the first
    point where both stimulus copies fail together). Not loosened to force a
    pass, per this repo's "agents do not relax the ratified spec to make
    results pass" rule; filed as issue #171 (sibling to the existing ss
    finding, i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
2026-09-06 fix(design): widen tmds_final_mux RLP/RLN to close ss-corner vswing_m FAIL (issue #169) (#174)
    Root-causes the ss-corner, low-supply (2.97 V), 270 Mbps/lane vswing_m
    FAIL (-46 uV / -1.446 mV) to design/tmds-final-mux-sizing.md section 3's
    own disclosed residual: the resistor-ratio self-bias cancels the
    resistor sheet-rho process axis but not nfet_03v3's own ss-corner
    mobility/Vt shift. Fixes it by widening the load resistors RLP/RLN
    (r_length 5.66um -> 5.90um, +4.24%): since swing = I_tail * RL and
    I_tail is set entirely by the RC/RREF self-bias loop (independent of
    RL), this raises vswing_m by ~the same +4.24% at every corner without
    touching the current-setting loop or the switch-pair sizi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
    [tmds_final_mux.sch]
2026-09-06 feat(sim): re-verify tt/ff/fs/sf process corners for tmds-final-mux-eye and cml-driver-eye-realmux against issue #169's RL fix (#176)
    * feat(sim): re-verify tt/ff/fs/sf process corners for tmds-final-mux-eye and cml-driver-eye-realmux against issue #169's RL=5.90u fix (issue #173)
    Re-runs the four remaining process corners (tt/ff/fs/sf, 18/18 points
    each) for both sim/tmds-final-mux-eye and sim/cml-driver-eye-realmux
    against the current (post-#169) RLP/RLN=5.90u geometry, completing the
    90/90-point grid the ss-corner-only re-verification (issue #169, PR
    #174) left open.
    All eight new records PASS. In particular, the sf corner -- which
    carried the worse of the two pre-#169 vswing_m/vswing_s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
2026-09-11 feat: lay out and sign off tmds_final_mux DRC/LVS (#178)
    Adds layout/scripts/gen_tmds_final_mux.py (mos_array + res_array
    composition via klt gen/gen-compose, mirroring cml_driver_core's
    issue #22 generator pattern, extended with res_array for this cell's
    four ppolyf_u resistors and a two-pass compose merge for the cell's
    non-planar net graph), the generated GDS pair (intact + shorted
    negative control), extraction/DRC/LVS reports, a hand-written LVS
    reference netlist, and a test asserting the generator's device/port
    inventory against the sized schematic netlist.
    klt drc reports status: clean for both cells; klt lvs reports
    status: match for the intact cell (12/12 devices, 8 folded MOS +
    4 p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
2026-09-15 spec: add DR-0015, tracking ESD HBM/CDM qualification as pre-silicon limitation (#182)
    Resolves the routing question issue #145 raised: DR-0013 row 11 (HBM >= 2 kV
    / CDM >= 500 V) has no PDK-sourced electrical ESD data and no tester/parts to
    qualify against pre-silicon, so real qualification cannot happen until
    silicon exists. Per the operator's ruling, drafts the decision record
    (option 1: accepted pre-silicon limitation) rather than parking this as an
    operator decision.
    DR-0015 does not relax the ratified requirement — only how the row is
    tracked. Cross-references DR-0013 row 11 and characterization.md's
    ESD-qualification row / T1-bronze gap note back to the new record, and
    states expli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
2026-09-15 docs: fix mis-citation of pad-ring-esd-survey.md §8 in DR-0015 and esd-capacitance-budget.md (#184)
    §8 of spec/pad-ring-esd-survey.md covers pad pitch, ring continuity,
    ESD-topology preference, substrate taps, and LVS coverage gaps -- not
    electrical ESD characterization data. Three sites incorrectly cited it
    for the "PDK carries no electrical ESD-device data" claim. Drop the
    mis-citation at all three sites and rely on the already-correct local
    design/esd-capacitance-budget.md §2a citation, which fully substantiates
    the claim on its own. No change to the underlying ratified conclusion
    (DR-0013 row 11, DR-0015's disposition).
    Closes #183
    Co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
2026-09-15 spec: add DR-0016 (Proposed) keeping data islands outside the block boundary (#187)
    Records this repository's answer to the framing re-check issue #185 raised
    after 2AMLogic/product#16 decided the consuming dongle carries real HDMI
    audio on one chip.
    Recommends Option A: the block stays a DVI-mode TMDS transmitter. The
    data-island packet layer (audio samples, audio InfoFrame, ACR) and the
    character layer it needs (TERC4, guard bands, preambles, period state
    machine) both live outside this block and join it at the 10-bit character
    cut that already exists between rtl/tmds_encoder.v and
    rtl/tmds_serializer.v. Answers all three of the issue's questions
    explicitly, cites rather than re-derives t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
2026-09-21 feat: add klt signoff T1 manifest with CI-graded evidence record (#192)
    * feat: add klt signoff T1 manifest with CI-graded evidence record
    Commit signoff/manifest.json -- the klt signoff block manifest for this
    mixed-signal block (block id gf180-tmds-tx, the row identity the fleet
    roll-up consumes) -- plus signoff/signoff.json, the byte-for-byte graded
    T1-T4 tier record (currently 6/22 met: DRC and LVS clean on both
    partitions, the generic characterization citation; every other row unmet
    with a machine-readable reason, per the grader contract).
    Every citation pins a content_hash. The two intact-cell LVS envelopes
    were regenerated under the pinned klt build because their klt 0.3.0-era
    shape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
2026-09-21 feat: add gate-level LVS power-connectivity read for tmds_encoder (#193)
    Land the T1 item-11 digital-column power verdict as an additional
    `klt lvs` compare beside the existing SPICE-reference signoff pair:
    a `reference.form: "gate-level-verilog"` request whose reference is a
    signal-only view of the committed post-P&R netlist (970 empty-connection
    fill/tap/endcap instance lines removed by filter_pnr_utility_cells.py's
    new --form verilog mode, which aborts on any utility master that carries
    real content), graded with the absolute expected_nets power check against
    the existing committed extraction.
    Committed reports: signal status "match" (0 errors; the one warning is
    the disclosed in-report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
    [tmds_encoder.pnr_signal_only.v]
2026-10-01 chore: resync installed Loom surfaces
    resynced_by: fleet-resync
    invocation: fleet-resync.sh --fleet-only --push
    <!-- loom:provenance v1 build=unknown 19f4e67fd0a0afbd3d8b6606ca91ceac911377a3 clean prompts=none sweep=none story=none trace=78a5dfbdfd8c530aecd1bb436fd096df host=loom-worker-2 base=51b95abed62aa80cd95ffa0deb4e057a4f57aeb6 run=loom-run/v1:timer:loom-worker-2/fleet-resync:67c759f7ef3c43e38d3fa8d5f19a2dd1 installs=0.19.593 658650a4f0eff932ac66a8f690eaedf8123fc83b -->
    Loom-Story: none
    Loom-Trace-Id: 78a5dfbdfd8c530aecd1bb436fd096df
    Loom-Build: unknown 19f4e67fd0a0afbd3d8b6606ca91ceac911377a3 clean
2026-10-01 chore: resync installed Loom surfaces
    <!-- loom:provenance v1 build=unknown 56435bf476452911283e43940ecfd9a30f804af9 clean prompts=none sweep=none story=none trace=342405c5ebc99bdbf17afbd983c0c41c host=loom-worker-2 base=32102c9c4f812b18b3eaefe4112f4b46dee769b8 run=loom-run/v1:timer:loom-worker-2/fleet-resync:20c09f231d424cd5b57ca7991848dd8a installs=0.19.603 8c39bf7cde8a8c03d1aaee441f397c017b6a3a9e -->
    Loom-Trace-Id: 342405c5ebc99bdbf17afbd983c0c41c
    Loom-Build: unknown 56435bf476452911283e43940ecfd9a30f804af9 clean
    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
2026-10-01 chore: resync installed Loom surfaces
    <!-- loom:provenance v1 build=unknown f2868e6b4d60d11a8ab47d25cad9e248229d2f66 clean prompts=none sweep=none story=none trace=4e2766ed5160781df891476246a9be2e host=robb-studio base=7a2ef69fb711ff7e3774a6457251d6c112bab787 run=loom-run/v1:timer:robb-studio/fleet-resync:2d3851d5-1673-43ae-bcc6-e5c971b37f33 installs=0.19.603 74778a6aeea5d9e06b489400942b35f33c8bb766 -->
    Loom-Trace-Id: 4e2766ed5160781df891476246a9be2e
    Loom-Build: unknown f2868e6b4d60d11a8ab47d25cad9e248229d2f66 clean
    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
2026-10-01 chore: resync installed Loom surfaces
    <!-- loom:provenance v1 build=unknown d6714830391f7596338b8de40ee2d0f45dcd12f5 clean prompts=none sweep=none story=none trace=af273f717e759e690d07f372734e9278 host=robb-pro base=ad18d8743c777bf07bf846ef3608fb9db8a3d0f2 run=loom-run/v1:timer:robb-pro/fleet-resync:92e2f9ba-d083-411b-833b-ae52d169ef04 installs=0.19.605 6eb2b65a4496b7becb84ef1f944493a541fd01cd -->
    Loom-Trace-Id: af273f717e759e690d07f372734e9278
    Loom-Build: unknown d6714830391f7596338b8de40ee2d0f45dcd12f5 clean
    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
2026-10-01 chore: resync installed Loom surfaces
    <!-- loom:provenance v1 build=unknown 617257919edc1b9b9ee27532c5ec1b8a64523388 clean prompts=none sweep=none story=none trace=cb047565635d880cd4ae328b5cfaaf68 host=loom-worker-1 base=cf4858969111ba86b38fd55b4e2ab15670aa4086 run=loom-run/v1:script:loom-worker-1/fleet-resync:9973280a-d0de-4196-8cdb-f221825edc41 installs=0.19.609 ff30576dacc8c2734b1c7434bedd29c47122caeb -->
    Loom-Trace-Id: cb047565635d880cd4ae328b5cfaaf68
    Loom-Build: unknown 617257919edc1b9b9ee27532c5ec1b8a64523388 clean
    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
2026-10-01 chore: resync installed Loom surfaces
    <!-- loom:provenance v1 build=unknown 617257919edc1b9b9ee27532c5ec1b8a64523388 clean prompts=none sweep=none story=none trace=dbafe4f8526617aa07c890721298a080 host=robb-studio base=0ff0745b4b8308b779a557dcdfff7f007a263be2 run=loom-run/v1:timer:robb-studio/fleet-resync:1817df66-02cc-4b27-927d-a38485da550a installs=0.19.610 c94891dd526cf6db5ee02045424c6913be522048 -->
    Loom-Trace-Id: dbafe4f8526617aa07c890721298a080
    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
2026-10-01 chore: resync installed Loom surfaces
    <!-- loom:provenance v1 build=unknown a2a39ac2736eb2686e2c65412d939e67c0438a7d clean prompts=none sweep=none story=none trace=fc1a121767151aae5bd7427c683b7db6 host=robb-pro base=e540e98d3e7b91478bf29b2f42dd8200fbf40910 run=loom-run/v1:timer:robb-pro/fleet-resync:708eb7c8-469d-4783-80b7-bafe142df3c4 installs=0.19.612 d25614656adcf70162da95c5e1035e99a0639a1a -->
    Loom-Trace-Id: fc1a121767151aae5bd7427c683b7db6
    Loom-Build: unknown a2a39ac2736eb2686e2c65412d939e67c0438a7d clean
    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
2026-10-01 chore(tooling): update repo-skills to v0.19.5
    Fleet-wide Repo Skills rollout (2026-10-01). compute-drift's axis 6
    reported repo-skills at 11 different versions across the fleet's
    checkouts; this brings gf180-tmds-tx from v0.10.0 to v0.19.5 (rjwalters/repo
    @ ff282cd), staging only the installer's own surface.
    Loom-Trace-Id: 038dce5d677bceeeca3c111787ac5b68
    Loom-Build: unknown unknown unknown
    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
2026-10-01 chore: resync installed Loom surfaces
    <!-- loom:provenance v1 build=unknown 126c80914e42f913c4fc778d3ddce96daa2c7a77 clean prompts=none sweep=none story=none trace=15a20fbea7a00d0922b943088c80e19d host=loom-worker-1 base=c15eb0986e223a1c5288dfd1c97d813b117e2dbd run=loom-run/v1:script:loom-worker-1/fleet-resync:ecc423da-4625-49de-b25a-692fd669a029 installs=0.19.612 d47e0c57a6bea6f7b61ef9ce62632d70c39ef5d5 -->
    Loom-Trace-Id: 15a20fbea7a00d0922b943088c80e19d
    Loom-Build: unknown 126c80914e42f913c4fc778d3ddce96daa2c7a77 clean
    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
2026-10-01 chore: resync installed Loom surfaces
    <!-- loom:provenance v1 build=unknown 126c80914e42f913c4fc778d3ddce96daa2c7a77 clean prompts=none sweep=none story=none trace=a0a42bd10fcfa6d7cbcc9c021c406848 host=loom-worker-2 base=e5d5916a8296a594ee023b58c1812ddb55efda6d run=loom-run/v1:timer:loom-worker-2/fleet-resync:9e174e6bb0fa41d786e4a86e45632b6f installs=0.19.612 6f0871dc66e62b36d8382ced980d2805bfd97e50 -->
    Loom-Trace-Id: a0a42bd10fcfa6d7cbcc9c021c406848
    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
2026-10-01 chore: resync installed Loom surfaces
    <!-- loom:provenance v1 build=unknown 6f3411c8a63e68097dde01bce8a8422230f54218 clean prompts=none sweep=none story=none trace=9aa0a46bb352b9665fdaa5f5b3b85dd7 host=robb-pro base=80289cc363b9f26ff4212262d15fb06aaf01fe1a run=loom-run/v1:timer:robb-pro/fleet-resync:ca419e1d-6646-4678-ac7a-b263e4b5119e installs=0.19.612 7731400b3e3e1df39074564166edf656feb0999c -->
    Loom-Trace-Id: 9aa0a46bb352b9665fdaa5f5b3b85dd7
    Loom-Build: unknown 6f3411c8a63e68097dde01bce8a8422230f54218 clean
    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
2026-10-02 chore: resync installed Loom surfaces
    <!-- loom:provenance v1 build=unknown 13c0a3ef467a888520a6529ab34486ab8be826be clean prompts=none sweep=none story=none trace=41356080f367e491d5ff03f17bb98c27 host=loom-worker-2 base=e3936837c5fc6300083630b2c72c609e54752ab6 run=loom-run/v1:timer:loom-worker-2/fleet-resync:44455fbcbab745abb92cea192fafbb1d installs=0.19.614 3c79f7b1d0cc14723e049cff4250ff7330804326 -->
    Loom-Trace-Id: 41356080f367e491d5ff03f17bb98c27
    Loom-Build: unknown 13c0a3ef467a888520a6529ab34486ab8be826be clean
    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
2026-10-02 chore: resync installed Loom surfaces
    <!-- loom:provenance v1 build=unknown ea2dd21f2ba310ec007d047ddfecc6cd27d220ac clean prompts=none sweep=none story=none trace=f04a67f3922788d2ccdd66578c8d18f9 host=loom-worker-1 base=12e5cfe5fc2657b0d9f9f7d249fba58a46b5fe24 run=loom-run/v1:timer:loom-worker-1/fleet-resync:1c3b601dd998488595adc09040c007d4 installs=0.19.614 79f4897c5d3c78dbfc1b022f77d244838dbf4ccb -->
    Loom-Trace-Id: f04a67f3922788d2ccdd66578c8d18f9
    Loom-Build: unknown ea2dd21f2ba310ec007d047ddfecc6cd27d220ac clean
    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
2026-10-02 chore: resync installed Loom surfaces
    <!-- loom:provenance v1 build=unknown 6f3411c8a63e68097dde01bce8a8422230f54218 clean prompts=none sweep=none story=none trace=acb28d0049e0cc75536f96d503f6e814 host=robb-studio base=0f7e3558a0d203a2e5ea02f5b93adfef69d7d994 run=loom-run/v1:timer:robb-studio/fleet-resync:85d2b1b5-e81d-40c3-ab6a-9a00efbc4ee2 installs=0.19.616 d86523eeadb32b95777f3cd3a76dd2f72f0bf792 -->
    Loom-Trace-Id: acb28d0049e0cc75536f96d503f6e814
    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
2026-10-02 chore: resync installed Loom surfaces
    <!-- loom:provenance v1 build=unknown 2b50bd69eddd038dd738465aa58a9ebca11410ac clean prompts=none sweep=none story=none trace=324e4f607054d0396cfdf8fdc01e93ae host=robb-pro base=66c4a00f04cbeb540393df0fe1e8f4ce0c63949a run=loom-run/v1:timer:robb-pro/fleet-resync:a63799f1-2ad7-4946-b81d-2ec231bc2d2f installs=0.19.617 81cb2ad7e091b19d6a2b95d1add6938c2100d46b -->
    Loom-Trace-Id: 324e4f607054d0396cfdf8fdc01e93ae
    Loom-Build: unknown 2b50bd69eddd038dd738465aa58a9ebca11410ac clean
    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
2026-10-02 chore: resync installed Loom surfaces
    <!-- loom:provenance v1 build=unknown 00d92b326aed50280cd90dc116b7caec27668251 clean prompts=none sweep=none story=none trace=9a5d23cc82b6d3a1c83bfee47bd04970 host=loom-worker-2 base=8727f94f0ab36eb76bd20d9cad37d18c783accd5 run=loom-run/v1:timer:loom-worker-2/fleet-resync:12136a7a025d49f3a60b5edb04a3ff81 installs=0.19.619 4c0f505e4f0b76f8ccec07bda6d8b839030c077b -->
    Loom-Trace-Id: 9a5d23cc82b6d3a1c83bfee47bd04970
    Loom-Build: unknown 00d92b326aed50280cd90dc116b7caec27668251 clean
    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
2026-10-02 chore: resync installed Loom surfaces
    <!-- loom:provenance v1 build=unknown 456dad6d90259846313dc3bb80bf4e5471ef2d76 clean prompts=none sweep=none story=none trace=bb9688c03fb5211d06f48c8838a5505c host=robb-studio base=7d0d37b022db68efd8c6de5d68e65bcfc265519e run=loom-run/v1:timer:robb-studio/fleet-resync:e965c017-8ec7-485d-b46e-aeb399b81fb4 installs=0.19.620 0d28ba49f5a88fdb37271de9cb0144eb3442c6e3 -->
    Loom-Trace-Id: bb9688c03fb5211d06f48c8838a5505c
    Loom-Build: unknown 456dad6d90259846313dc3bb80bf4e5471ef2d76 clean
    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
2026-10-02 chore: resync installed Loom surfaces
    <!-- loom:provenance v1 build=unknown 6c6d2b6565dc13eff4c6811b9c670f452106516b clean prompts=none sweep=none story=none trace=539be979ae694d66ede516a7b5d17e41 host=robb-pro base=3fd554762b8ba8a5b9e633de2ae56d4b264508e3 run=loom-run/v1:timer:robb-pro/fleet-resync:9444d216-de08-442f-8352-ba59f6e81bb3 installs=0.19.621 a90dc1d794eb9ff70aaf939ebf495abe716f3bdd -->
    Loom-Trace-Id: 539be979ae694d66ede516a7b5d17e41
    Loom-Build: unknown 6c6d2b6565dc13eff4c6811b9c670f452106516b clean
    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
2026-10-02 chore: resync installed Loom surfaces
    <!-- loom:provenance v1 build=unknown f6d28134bfe476967e005d97424073085f55e8a3 clean prompts=none sweep=none story=none trace=27eb90670d441065f593e941066ee005 host=loom-worker-2 base=122702b48ca8d6c9f5de88ab24b6c989f8299667 run=loom-run/v1:timer:loom-worker-2/fleet-resync:04001bba930241cf9e325bf304a9270a installs=0.19.623 ccc19c2bbe2aa65328427730fa53f70eb56128c6 -->
    Loom-Trace-Id: 27eb90670d441065f593e941066ee005
    Loom-Build: unknown f6d28134bfe476967e005d97424073085f55e8a3 clean
    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
2026-10-02 chore: resync installed Loom surfaces
    <!-- loom:provenance v1 build=unknown bc461736314499b6c2c4c0ad51fb2294f60336f5 clean prompts=none sweep=none story=none trace=c3ea68717dd3a908dbbd60a35bc8b5d6 host=robb-studio base=554e29d512e76d06d3807d0aef89737396b047a6 run=loom-run/v1:timer:robb-studio/fleet-resync:8d4c49e2-3258-4080-b0c8-082499053654 installs=0.19.623 a50aaf70069f8897c41a64b7d90783c5ab8294e0 -->
    Loom-Trace-Id: c3ea68717dd3a908dbbd60a35bc8b5d6
    Loom-Build: unknown bc461736314499b6c2c4c0ad51fb2294f60336f5 clean
    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
2026-10-02 chore: resync installed Loom surfaces
    <!-- loom:provenance v1 build=unknown bc461736314499b6c2c4c0ad51fb2294f60336f5 clean prompts=none sweep=none story=none trace=8bee8a664bfc89e0bbfbb3c2de7342ba host=loom-worker-2 base=b078da21b5b2f7479eb417a4e24c7589f81e82d5 run=loom-run/v1:timer:loom-worker-2/fleet-resync:de2ceceb48ea4927a1334d08dc0082fe installs=0.19.624 5f49564fa78ae06f8c48d5224dae9ded04200bb7 -->
    Loom-Trace-Id: 8bee8a664bfc89e0bbfbb3c2de7342ba
    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
2026-10-02 spec: DR-0017 PLL sourcing — name gf180-pll, retarget to 135 MHz half-rate (480p first), defer 720p60 (#194)
    Loom-Story: 2AMLogic/gf180-tmds-tx#194
    Loom-Trace-Id: 8dd41d275188ef335105a5fd9bc6c05c
    Loom-Build: 0.19.624 5f49564fa78ae06f8c48d5224dae9ded04200bb7 clean
2026-10-03 chore: resync installed Loom surfaces
    <!-- loom:provenance v1 build=unknown 752d316233ed1a3da9e4f69ad760eb99bb477747 clean prompts=none sweep=none story=none trace=7851839b67c00a023e97cbdea1f580e1 host=robb-pro base=b0154a0ea7c6ddda477ec1846cfa48046dd4436d run=loom-run/v1:timer:robb-pro/fleet-resync:ae492b66-dca0-4da4-acab-8d26778f2d5c installs=0.19.624 121fac45f5006879bf58a18c951b9243d9099a18 -->
    Loom-Trace-Id: 7851839b67c00a023e97cbdea1f580e1
    Loom-Build: unknown 752d316233ed1a3da9e4f69ad760eb99bb477747 clean
    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
2026-10-03 chore: resync installed Loom surfaces
    <!-- loom:provenance v1 build=unknown b34a08286a42f47f917ec46647d4d167c1f5207c clean prompts=none sweep=none story=none trace=a8e453124b899b440f42c9d83837c7b6 host=loom-worker-2 base=e1cc2d09e898f4c8a387faa664f3227a63083880 run=loom-run/v1:timer:loom-worker-2/fleet-resync:f02dd5df715347fe90fe14b9353a1b66 installs=0.19.624 98c193cf0d12d68d3770edc1baad808c40bb5fd4 -->
    Loom-Trace-Id: a8e453124b899b440f42c9d83837c7b6
    Loom-Build: unknown b34a08286a42f47f917ec46647d4d167c1f5207c clean
    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
2026-10-03 chore: resync installed Loom surfaces
    <!-- loom:provenance v1 build=unknown 3437cece5ab759f772122f8d18a6d2f05d246cde clean prompts=none sweep=none story=none trace=1bd6b75d1c0daff2b433adf5999546a3 host=loom-worker-1 base=8dec106066989995ac007d7d7b61522b208587eb run=loom-run/v1:timer:loom-worker-1/fleet-resync:4c0abac1c29646eaa8502afa223bdd2b installs=0.19.624 0162badc662fb30c070e70611aa8ff74a8486d54 -->
    Loom-Trace-Id: 1bd6b75d1c0daff2b433adf5999546a3
    Loom-Build: unknown 3437cece5ab759f772122f8d18a6d2f05d246cde clean
    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
2026-10-03 chore: resync installed Loom surfaces
    <!-- loom:provenance v1 build=unknown 3437cece5ab759f772122f8d18a6d2f05d246cde clean prompts=none sweep=none story=none trace=bba21427f750636f851279cfae92b4e5 host=loom-worker-1 base=635755928fc60c0bd92e3df919a2a7c280e20fb1 run=loom-run/v1:timer:loom-worker-1/fleet-resync:9440cda9476f404caa282e360a81ee03 installs=0.19.636 e41edfbb52c13982f7d8b0577f42957427a6514c -->
    Loom-Trace-Id: bba21427f750636f851279cfae92b4e5
    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
2026-10-03 chore: resync installed Loom surfaces
    <!-- loom:provenance v1 build=unknown 28040ed11a4369e20f3b7b0154a3fb2a2c35d38c clean prompts=none sweep=none story=none trace=0cd87d01c45d97a2ee57a99363fc0db2 host=robb-studio base=bbc1381b7482c7740b4dedda5f327a867b1e383b run=loom-run/v1:timer:robb-studio/fleet-resync:74b93657-6b04-4ac5-bc77-e0a1682b0595 installs=0.19.636 e41edfbb52c13982f7d8b0577f42957427a6514c -->
    Loom-Trace-Id: 0cd87d01c45d97a2ee57a99363fc0db2
    Loom-Build: unknown 28040ed11a4369e20f3b7b0154a3fb2a2c35d38c clean
    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
2026-10-03 chore: resync installed Loom surfaces
    <!-- loom:provenance v1 build=unknown 388c7fe0cad997f7a887f70c9f2cfe8781a2d512 clean prompts=none sweep=none story=none trace=2046ffd42f138a06b914f34851de3440 host=loom-worker-2 base=3bca274cda22577f28a59d95f0427300dfbc4b48 run=loom-run/v1:timer:loom-worker-2/fleet-resync:17c9456bb1934c70a545b12081496cce installs=0.19.647 d1fe5dead4202be12a964ab891fd5980e7836170 -->
    Loom-Trace-Id: 2046ffd42f138a06b914f34851de3440
    Loom-Build: unknown 388c7fe0cad997f7a887f70c9f2cfe8781a2d512 clean
    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
2026-10-03 chore: resync installed Loom surfaces
    <!-- loom:provenance v1 build=unknown 8078c29e691123d91cd761a786f99cfd25f1809d clean prompts=none sweep=none story=none trace=45869a6374635c036a11a6f379fe31a4 host=robb-pro base=d71ef7f0e6ca71f7d6d541b2cad0e9af771dfe62 run=loom-run/v1:timer:robb-pro/fleet-resync:b0a94991-052d-4e7d-ba2b-78b971096849 installs=0.19.647 709ca4396e074e5a4d1c5e19721f6ddac7154ca2 -->
    Loom-Trace-Id: 45869a6374635c036a11a6f379fe31a4
    Loom-Build: unknown 8078c29e691123d91cd761a786f99cfd25f1809d clean
    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
2026-10-03 chore: resync installed Loom surfaces
    <!-- loom:provenance v1 build=unknown f9cba29b0602624a23daa17ae04d31d82e10fa91 clean prompts=none sweep=none story=none trace=754b3688f97b6c34894d8cfbf272b81a host=loom-worker-1 base=e048912016f303445ac3902edd6f3b9e4b6849d4 run=loom-run/v1:script:loom-worker-1/fleet-resync:11eb117a-9ff3-4411-88d4-fdd7d6748639 installs=0.19.649 6f2f13b1c31ce420e2250ae040d8e1050c0e761b -->
    Loom-Trace-Id: 754b3688f97b6c34894d8cfbf272b81a
    Loom-Build: unknown f9cba29b0602624a23daa17ae04d31d82e10fa91 clean
    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
2026-10-03 chore: resync installed Loom surfaces
    <!-- loom:provenance v1 build=unknown f9cba29b0602624a23daa17ae04d31d82e10fa91 clean prompts=none sweep=none story=none trace=544a028e3829d4020b8aaa144e5fa628 host=robb-studio base=9c8fb3d8b7014671802b66353b9eb04bca4987bd run=loom-run/v1:script:robb-studio/fleet-resync:5b5b8b83-7139-447d-88bd-417dcf375aa6 installs=0.19.649 6f2f13b1c31ce420e2250ae040d8e1050c0e761b -->
    Loom-Trace-Id: 544a028e3829d4020b8aaa144e5fa628
    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
2026-10-03 chore: resync installed Loom surfaces
    <!-- loom:provenance v1 build=unknown f9cba29b0602624a23daa17ae04d31d82e10fa91 clean prompts=none sweep=none story=none trace=1057aaaf811f6dd2d64a3bb6d4b3ac49 host=robb-pro base=d4a518ff50cc80f8016d4aa7624d26b72c489b8d run=loom-run/v1:timer:robb-pro/fleet-resync:785c1ea0-d7f2-4810-99e9-cd9368aebe0c installs=0.19.649 2118aabb5a925f1ec4669b4d3d31176a46d8f2a6 -->
    Loom-Trace-Id: 1057aaaf811f6dd2d64a3bb6d4b3ac49
    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
2026-10-03 chore: resync installed Loom surfaces
    <!-- loom:provenance v1 build=unknown 72f61d9aa0fe08f1ef59f1a97a314e474455801e clean prompts=none sweep=none story=none trace=577d2185973ec59f059fa15bf5b5e514 host=loom-worker-1 base=1ae9160e5d4b9917d92b1e2bd36656a665d4b8d7 run=loom-run/v1:script:loom-worker-1/fleet-resync:5728a930-137f-4d2f-a962-1cdd7a6a1d46 installs=0.19.652 235a64727b907d65529151af0a962b14f16462a0 -->
    Loom-Trace-Id: 577d2185973ec59f059fa15bf5b5e514
    Loom-Build: unknown 72f61d9aa0fe08f1ef59f1a97a314e474455801e clean
    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
2026-10-03 chore: resync installed Loom surfaces
    <!-- loom:provenance v1 build=unknown 72f61d9aa0fe08f1ef59f1a97a314e474455801e clean prompts=none sweep=none story=none trace=845aaa0eb340f80f12095e2e8b421ed1 host=robb-pro base=d31e7da1a52ef2b9d611e327d42a3cb9b982b19a run=loom-run/v1:script:robb-pro/fleet-resync:344add4b-df8a-49e8-8563-2765673acc76 installs=0.19.652 235a64727b907d65529151af0a962b14f16462a0 -->
    Loom-Trace-Id: 845aaa0eb340f80f12095e2e8b421ed1
    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
2026-10-03 chore: resync installed Loom surfaces
    <!-- loom:provenance v1 build=unknown 61870b40779d205c1555e801c6e1d95df083cdea clean prompts=none sweep=none story=none trace=cfd2c16d2cd3651ad0d068a28bbf62b8 host=loom-worker-1 base=82d7ecdc668be669a18bd4fd7efda4260dba347b run=loom-run/v1:timer:loom-worker-1/fleet-resync:fd27683751ca428cb28a8d58a04fc51a installs=0.19.652 235a64727b907d65529151af0a962b14f16462a0 -->
    Loom-Trace-Id: cfd2c16d2cd3651ad0d068a28bbf62b8
    Loom-Build: unknown 61870b40779d205c1555e801c6e1d95df083cdea clean
    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
2026-10-03 chore: resync installed Loom surfaces
    <!-- loom:provenance v1 build=unknown 61870b40779d205c1555e801c6e1d95df083cdea clean prompts=none sweep=none story=none trace=f8c6a615535e3729d749bc44ac28436c host=robb-studio base=bb5875497125932c1a9acdc00cee46d56c578f5a run=loom-run/v1:script:robb-studio/fleet-resync:66678e69-bbef-41df-8a24-1d1ac846c831 installs=0.19.652 235a64727b907d65529151af0a962b14f16462a0 -->
    Loom-Trace-Id: f8c6a615535e3729d749bc44ac28436c
    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
2026-10-03 chore: resync installed Loom surfaces
    <!-- loom:provenance v1 build=unknown 21130104346fe9c464ce8a3fdf82c1d3e9667639 clean prompts=none sweep=none story=none trace=36308fff5a3c323c3d1bf6fffb6cd122 host=robb-studio base=9b862927d364bd5a9f4e65d684616812989d1cf9 run=loom-run/v1:timer:robb-studio/fleet-resync:89972fbd-0774-4402-bbb7-26c33a851735 installs=0.19.652 fb69233bd8f1dfc2bdee37d8b934f99274dc0193 -->
    Loom-Trace-Id: 36308fff5a3c323c3d1bf6fffb6cd122
    Loom-Build: unknown 21130104346fe9c464ce8a3fdf82c1d3e9667639 clean
    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
2026-10-04 chore: resync installed Loom surfaces
    <!-- loom:provenance v1 build=unknown 61870b40779d205c1555e801c6e1d95df083cdea clean prompts=none sweep=none story=none trace=fb9213e215442932d2af05f3b14977de host=robb-pro base=2328ac82204b5e9f8cc7424ee8695b9b443ca85f run=loom-run/v1:timer:robb-pro/fleet-resync:4c70cd1d-08cd-4add-8e2a-9a75160d163f installs=0.19.655 36c39e3c6f56e1979647ec235b4bd19c77db22f3 -->
    Loom-Trace-Id: fb9213e215442932d2af05f3b14977de
    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
2026-10-04 chore: resync installed Loom surfaces
    <!-- loom:provenance v1 build=unknown 61870b40779d205c1555e801c6e1d95df083cdea clean prompts=none sweep=none story=none trace=baa6c2cfcae1a320917c00ff2eb8b630 host=loom-worker-2 base=8f3e8b9f2f01afbe0dd5c5d88c5980d723b6971c run=loom-run/v1:timer:loom-worker-2/fleet-resync:741a7f0f16df4fb1be4e657aeacd1244 installs=0.19.655 fc667a4faae1227f8a6837431f8a0c2d0aeaa7dd -->
    Loom-Trace-Id: baa6c2cfcae1a320917c00ff2eb8b630
    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
2026-10-04 chore: resync installed Loom surfaces
    <!-- loom:provenance v1 build=unknown b922acb2ac655cbccd71daa9e3f05a325a094ca5 clean prompts=none sweep=none story=none trace=833eeb34d4ca65c3f8c6f7824ddca3a3 host=robb-studio base=3ab217384ef955faabd026bfdebdca12d9916e5d run=loom-run/v1:timer:robb-studio/fleet-resync:0d44f6dc-6a62-4d43-b49d-7cfdd7dbd823 installs=0.19.663 0a51e373e7fe1be156c5774b2c827d4b745368a3 -->
    Loom-Trace-Id: 833eeb34d4ca65c3f8c6f7824ddca3a3
    Loom-Build: unknown b922acb2ac655cbccd71daa9e3f05a325a094ca5 clean
    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
2026-10-04 chore: resync installed Loom surfaces
    <!-- loom:provenance v1 build=unknown 746ecb5f9d7e64ba1d2526f1e997530ad4f3dd43 clean prompts=none sweep=none story=none trace=f09501431241df2ec5688e334ba43dfe host=loom-worker-2 base=2736a547e3a3baecea31d0366bcc89f9eeac8702 run=loom-run/v1:timer:loom-worker-2/fleet-resync:70797dad61fb4e21806716d54f1ce910 installs=0.19.669 59a1f84e3742827a8033bb153ebbedc1759bee72 -->
    Loom-Trace-Id: f09501431241df2ec5688e334ba43dfe
    Loom-Build: unknown 746ecb5f9d7e64ba1d2526f1e997530ad4f3dd43 clean
    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
2026-10-04 chore: resync installed Loom surfaces
    <!-- loom:provenance v1 build=unknown 8080d0485cc1312129ee642b084944c56d1be074 clean prompts=none sweep=none story=none trace=ed180bcab6828041123ad54d8ddb4037 host=robb-pro base=bd873308451a13946c951038a36d75ff927e338a run=loom-run/v1:timer:robb-pro/fleet-resync:e97b2f08-4ad9-4b66-a166-5b19820e2d1f installs=0.19.669 59a1f84e3742827a8033bb153ebbedc1759bee72 -->
    Loom-Trace-Id: ed180bcab6828041123ad54d8ddb4037
    Loom-Build: unknown 8080d0485cc1312129ee642b084944c56d1be074 clean
    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
2026-10-04 chore: resync installed Loom surfaces
    <!-- loom:provenance v1 build=unknown 83cb6647167ffc000d2c2f479b4e816b68f863f4 clean prompts=none sweep=none story=none trace=ccabffa1e1ba495895b262086030816c host=robb-studio base=dbb7e4affdf2a23c47b8fbfd130aa10090ac18ee run=loom-run/v1:timer:robb-studio/fleet-resync:88a78f1f-d978-47b5-99c3-2aabde811d17 installs=0.19.676 cd4f30bd892ea2595d8218b08150633504b0dd14 -->
    Loom-Trace-Id: ccabffa1e1ba495895b262086030816c
    Loom-Build: unknown 83cb6647167ffc000d2c2f479b4e816b68f863f4 clean
    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
2026-10-04 chore: resync installed Loom surfaces
    <!-- loom:provenance v1 build=unknown 32174d0f7e80508fa66c1a11a2c0fb28c515607e clean prompts=none sweep=none story=none trace=436d7c19b10cd5807625a7ce7190a82f host=loom-worker-2 base=e861144638f6803655ad86ac5d3ab607093ee1d3 run=loom-run/v1:timer:loom-worker-2/fleet-resync:19ae50771cc04d8db7b1403c1e66bbea installs=0.19.682 9eccfa110fa294fa32a62ffe8eff669cfcf1a3a6 -->
    Loom-Trace-Id: 436d7c19b10cd5807625a7ce7190a82f
    Loom-Build: unknown 32174d0f7e80508fa66c1a11a2c0fb28c515607e clean
    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
2026-10-04 chore: resync installed Loom surfaces
    <!-- loom:provenance v1 build=unknown 72290fa960e0773b2c50d74042e24914c7327637 clean prompts=none sweep=none story=none trace=f7b6952a649a174398a48b90b6ab4793 host=robb-pro base=76702a3120ae420a711b658690e67c524c74fe64 run=loom-run/v1:timer:robb-pro/fleet-resync:72f32482-5cc4-4b38-ab9e-4d2ef0b64e94 installs=0.19.684 bdb8fb331eb51c7def4cdd2c38b611af06f25f6d -->
    Loom-Trace-Id: f7b6952a649a174398a48b90b6ab4793
    Loom-Build: unknown 72290fa960e0773b2c50d74042e24914c7327637 clean
    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
2026-10-04 chore: resync installed Loom surfaces
    <!-- loom:provenance v1 build=unknown 76cda58637be0e74c4cb5b4c8dbc2000e2a9c3d4 clean prompts=none sweep=none story=none trace=614cbada5ce873c2b34a511816309cfc host=robb-studio base=6424bbae5e23acfffbe080ddfaf6cdf2371e9809 run=loom-run/v1:timer:robb-studio/fleet-resync:7e559a3b-ffdd-409b-8dd2-ae906a273b0a installs=0.19.692 d4974b9f5ff7843a3cfc06378ea2a69bc120e0f4 -->
    Loom-Trace-Id: 614cbada5ce873c2b34a511816309cfc
    Loom-Build: unknown 76cda58637be0e74c4cb5b4c8dbc2000e2a9c3d4 clean
    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
2026-10-04 chore: resync installed Loom surfaces
    <!-- loom:provenance v1 build=unknown f84bac5c232c093f83c1adc2533d8c75b021cda2 clean prompts=none sweep=none story=none trace=e687830614e4bd1c551ab6cf6186f8f3 host=loom-worker-2 base=d105897179674e452ee74fca3e9d59e69e7dfc5e run=loom-run/v1:timer:loom-worker-2/fleet-resync:2db2c4373ac24de1b7a364e69eaea1ca installs=0.19.695 b0d5b09f207fda439390ea1dd249ad10e7009dfc -->
    Loom-Trace-Id: e687830614e4bd1c551ab6cf6186f8f3
    Loom-Build: unknown f84bac5c232c093f83c1adc2533d8c75b021cda2 clean
    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
2026-10-04 chore: resync installed Loom surfaces
    <!-- loom:provenance v1 build=unknown ac5c275d1c616a9723e747f5a66de93dc80d3512 clean prompts=none sweep=none story=none trace=c777c3912bd31972e9aa3ccab712ae01 host=loom-worker-1 base=9fd320f67e17501a1edf37588948f6b20db1bf79 run=loom-run/v1:script:loom-worker-1/fleet-resync:b51a1b33-4958-4408-be36-166e12e8360b installs=0.19.697 ada83a5c7ff66b56b0060ef0be368c9fe56eb3c6 -->
    Loom-Trace-Id: c777c3912bd31972e9aa3ccab712ae01
    Loom-Build: unknown ac5c275d1c616a9723e747f5a66de93dc80d3512 clean
    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
2026-10-04 chore: resync installed Loom surfaces
    <!-- loom:provenance v1 build=unknown a19f642f5c09599c4c64827d81d228eb031be73e clean prompts=none sweep=none story=none trace=34a80e22764eb5055e37faec0eaf65fb host=robb-pro base=904671e21d5c57380375f33b09aacea3d93e67e9 run=loom-run/v1:script:robb-pro/fleet-resync:689be620-3ff2-4ff5-a2ce-f6825f6379e2 installs=0.19.697 ada83a5c7ff66b56b0060ef0be368c9fe56eb3c6 -->
    Loom-Trace-Id: 34a80e22764eb5055e37faec0eaf65fb
    Loom-Build: unknown a19f642f5c09599c4c64827d81d228eb031be73e clean
    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
2026-10-04 chore: resync installed Loom surfaces
    <!-- loom:provenance v1 build=unknown 693bdd794cb34afdefd7f0c4596824cd53078a61 clean prompts=none sweep=none story=none trace=7e7be58c80b40f1ac882b00139fb0ca0 host=robb-pro base=d29e670535dccafebc3d5b083ef97b3aada1e30e run=loom-run/v1:timer:robb-pro/fleet-resync:d64fbd6b-5d9b-491d-9e17-742b375bfba7 installs=0.19.698 aa619a1d07e36e8d90ac01fea63dc39285c93567 -->
    Loom-Trace-Id: 7e7be58c80b40f1ac882b00139fb0ca0
    Loom-Build: unknown 693bdd794cb34afdefd7f0c4596824cd53078a61 clean
    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
2026-10-04 chore: resync installed Loom surfaces
    <!-- loom:provenance v1 build=unknown 693bdd794cb34afdefd7f0c4596824cd53078a61 clean prompts=none sweep=none story=none trace=aa18f1ec102a98d77ffc51c9be6ffbb3 host=robb-studio base=d8d3078ec0e2bdab57df8ca9d17897d91ebb557c run=loom-run/v1:script:robb-studio/fleet-resync:3cb89ca8-62c2-4a69-8434-c4aaa3b64eaf installs=0.19.698 a58f00e0681c50d6bfc5089d0af4b3715198319f -->
    Loom-Trace-Id: aa18f1ec102a98d77ffc51c9be6ffbb3
    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
2026-10-04 chore: resync installed Loom surfaces
    <!-- loom:provenance v1 build=unknown 7a41c2e69ef89d60ed3bd190b94838021bf18d0f clean prompts=none sweep=none story=none trace=d0f04f38b507d85402723643fcf47197 host=loom-worker-1 base=b20d2171051fdd00ee607fdf1ea0f758766ec4eb run=loom-run/v1:script:loom-worker-1/fleet-resync:8fdc8c1c-f844-4c33-bc80-b424e5b4cf3d installs=0.19.703 89d5a428c652f957d7fad8a546589042d39911bc -->
    Loom-Trace-Id: d0f04f38b507d85402723643fcf47197
    Loom-Build: unknown 7a41c2e69ef89d60ed3bd190b94838021bf18d0f clean
    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
2026-10-05 chore: resync installed Loom surfaces
    <!-- loom:provenance v1 build=unknown ebb37db560de172930e261675a35bd52e429f650 clean prompts=none sweep=none story=none trace=a40e86a64366c7a1e36aea026901334f host=loom-worker-2 base=d5c77829f1252e54487387a19c45952814027d41 run=loom-run/v1:script:loom-worker-2/fleet-resync:90b6cd74-6cc0-4f58-98ee-6ede0ac6f50c installs=0.19.703 f63c3c82e6bf202f2ca7b205b532f681c5ebb2c8 -->
    Loom-Trace-Id: a40e86a64366c7a1e36aea026901334f
    Loom-Build: unknown ebb37db560de172930e261675a35bd52e429f650 clean
    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
2026-10-05 chore: resync installed Loom surfaces
    <!-- loom:provenance v1 build=unknown 7a41c2e69ef89d60ed3bd190b94838021bf18d0f clean prompts=none sweep=none story=none trace=fc04851db12f586b5d58155325131b6e host=robb-studio base=67ba111ce026cb5f3808a8132fc8c55ea8bf507b run=loom-run/v1:timer:robb-studio/fleet-resync:a7d5da6f-a896-4d6f-8d00-aebf47f9b266 installs=0.19.703 2ad9a08fb93de4d7dfac9d2b501d12c684c9c2cc -->
    Loom-Trace-Id: fc04851db12f586b5d58155325131b6e
    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
2026-10-05 chore: resync installed Loom surfaces
    <!-- loom:provenance v1 build=unknown afe7e99e397c242cc319fa80702fb3b23e23f5a7 clean prompts=none sweep=none story=none trace=e46782e1dd9c94461b4cf934ce05296b host=loom-worker-2 base=ad9cb86f2eb05e618652bd514285892951d10b3a run=loom-run/v1:timer:loom-worker-2/fleet-resync:caa89259b1fd414ebd2f07500621166d installs=0.19.703 972fe7321be6a9efe2653579379ea3bc40b899b2 -->
    Loom-Trace-Id: e46782e1dd9c94461b4cf934ce05296b
    Loom-Build: unknown afe7e99e397c242cc319fa80702fb3b23e23f5a7 clean
    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
2026-10-05 chore: resync installed Loom surfaces
    <!-- loom:provenance v1 build=unknown b44cb904ebb599db793066ccc631c846862abfbd clean prompts=none sweep=none story=none trace=9590fed7c1b1c9f549ccf3cba24292d7 host=robb-pro base=9edc431880fd405948c8da6c14ea375174129719 run=loom-run/v1:timer:robb-pro/fleet-resync:dbc6174e-403d-422d-98b6-73a4b6dbf44f installs=0.19.708 dc8faf1eae3143feda6301887c303b1ee45db7f4 -->
    Loom-Trace-Id: 9590fed7c1b1c9f549ccf3cba24292d7
    Loom-Build: unknown b44cb904ebb599db793066ccc631c846862abfbd clean
    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
2026-10-05 chore: resync installed Loom surfaces
    <!-- loom:provenance v1 build=unknown 4548905848fcb7cb875c1c0518f2fd88eb65818e clean prompts=none sweep=none story=none trace=aff5e139797705f6fa0811f102ecd103 host=loom-worker-1 base=e52d0dd03c5fc1b81b6550ac66c535e8426c8348 run=loom-run/v1:timer:loom-worker-1/fleet-resync:ba6a9e5686a64abaa842d71acaeae2ca installs=0.19.718 00d99344506bcf00e1aec7e910abe3d13df2d240 -->
    Loom-Trace-Id: aff5e139797705f6fa0811f102ecd103
    Loom-Build: unknown 4548905848fcb7cb875c1c0518f2fd88eb65818e clean
    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
2026-10-05 chore: resync installed Loom surfaces
    <!-- loom:provenance v1 build=unknown e7efbaa6e7b97a7d72da6032044c67525291f4d1 clean prompts=none sweep=none story=none trace=d74a33a6f35e329b3e795991e790ebfd host=robb-studio base=cce879dfc521a5b8865bde40e7e101064c82a89c run=loom-run/v1:timer:robb-studio/fleet-resync:304f49c8-5b3e-46a9-a557-945b9ae177f0 installs=0.19.718 00d99344506bcf00e1aec7e910abe3d13df2d240 -->
    Loom-Trace-Id: d74a33a6f35e329b3e795991e790ebfd
    Loom-Build: unknown e7efbaa6e7b97a7d72da6032044c67525291f4d1 clean
    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
2026-10-05 chore: resync installed Loom surfaces
    <!-- loom:provenance v1 build=unknown 347b71e65e709d9fd49aba75d3fb67877fc08818 clean prompts=none sweep=none story=none trace=f9653dd318724c98136e7cef63e551ed host=robb-pro base=906a3dd61c051c8939b5214e1e7817e88111c717 run=loom-run/v1:timer:robb-pro/fleet-resync:cdc95970-9fb1-49fa-a0e6-037a3fab2099 installs=0.19.728 991dcebf6f6b2de6571f1d3400bec083498c6438 -->
    Loom-Trace-Id: f9653dd318724c98136e7cef63e551ed
    Loom-Build: unknown 347b71e65e709d9fd49aba75d3fb67877fc08818 clean
    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
2026-10-05 chore: resync installed Loom surfaces
    <!-- loom:provenance v1 build=unknown 5c0d18101f48fecb656f10fa37afa9b09bf41631 clean prompts=none sweep=none story=none trace=ddcf49552af364cbf6e884bd59584c1f host=loom-worker-1 base=bf28da063a4a03326fa66d9676eb6f6dd50812ba run=loom-run/v1:timer:loom-worker-1/fleet-resync:5eb526a05f244f1985770579e7620ff1 installs=0.19.731 7484b71fce5179a025950e71a82855afaf6fd730 -->
    Loom-Trace-Id: ddcf49552af364cbf6e884bd59584c1f
    Loom-Build: unknown 5c0d18101f48fecb656f10fa37afa9b09bf41631 clean
    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
2026-10-05 chore: resync installed Loom surfaces
    <!-- loom:provenance v1 build=unknown 0b160514b6658e3ab26a71c6525791da25b46fcf clean prompts=none sweep=none story=none trace=311c3eb2c0ab9550d3de38df5523f3d7 host=robb-studio base=a11a0a0be93657d75d58ab15c6f1c8a44fa85ace run=loom-run/v1:timer:robb-studio/fleet-resync:e6dec631-b42b-4cf2-b854-cc363cfde6e0 installs=0.19.731 d6146becf339a3d4e55e26e8807ac4571213a00b -->
    Loom-Trace-Id: 311c3eb2c0ab9550d3de38df5523f3d7
    Loom-Build: unknown 0b160514b6658e3ab26a71c6525791da25b46fcf clean
    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
2026-10-05 chore: resync installed Loom surfaces
    <!-- loom:provenance v1 build=unknown 5c0d18101f48fecb656f10fa37afa9b09bf41631 clean prompts=none sweep=none story=none trace=f1e8d4c6e73b8eec3e87a8da52e10f2d host=robb-pro base=5a2086def0c3c5c14659e5ea6540613456e5e3f0 run=loom-run/v1:timer:robb-pro/fleet-resync:5518fd33-81cb-479f-93f0-287ea4b08876 installs=0.19.733 4e67131ce3a1317d8cb8904ec342541cc2f45665 -->
    Loom-Trace-Id: f1e8d4c6e73b8eec3e87a8da52e10f2d
    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
2026-10-05 chore: resync installed Loom surfaces
    <!-- loom:provenance v1 build=unknown ca170d11544ef499cc9500a45bbad152edacfbd1 clean prompts=none sweep=none story=none trace=6dcfc713b6a851b40932158c2eeb70af host=loom-worker-3 base=12b5479d73b63577f0490cfae4cacea569ed1353 run=loom-run/v1:timer:loom-worker-3/fleet-resync:20ce0908ea5a468a9e055470104047ed installs=0.19.734 7ba6ea50c36dfdd2b5e2922dd22c65560980a5a2 -->
    Loom-Trace-Id: 6dcfc713b6a851b40932158c2eeb70af
    Loom-Build: unknown ca170d11544ef499cc9500a45bbad152edacfbd1 clean
    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
2026-10-05 chore: resync installed Loom surfaces
    <!-- loom:provenance v1 build=unknown 03f1c42302d15f8a83425a84a4e36ca484f3f625 clean prompts=none sweep=none story=none trace=f1bc879f8aa652d550764ffcd36e27d1 host=loom-worker-1 base=dedbeafcb40007bf293fb336803d5e89d4aa3696 run=loom-run/v1:timer:loom-worker-1/fleet-resync:f302a3cc8558413492093df510b02418 installs=0.19.734 967abe71d019ce6606018b4e57dee0223b84d96f -->
    Loom-Trace-Id: f1bc879f8aa652d550764ffcd36e27d1
    Loom-Build: unknown 03f1c42302d15f8a83425a84a4e36ca484f3f625 clean
    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
2026-10-05 chore: resync installed Loom surfaces
    <!-- loom:provenance v1 build=unknown ce7557ba58624d48fedbca2bc037dfa8ce3943e7 clean prompts=none sweep=none story=none trace=e1f2558834c47835cd9a53ec8c9a2ffa host=loom-worker-3 base=407a9a0e2affd7a5806566e77822a8dae23e0452 run=loom-run/v1:timer:loom-worker-3/fleet-resync:50f5f0046e2c4890961b3221bd360247 installs=0.19.734 ba9edb650872e5265eaca0c47f75e3cb828ecad2 -->
    Loom-Trace-Id: e1f2558834c47835cd9a53ec8c9a2ffa
    Loom-Build: unknown ce7557ba58624d48fedbca2bc037dfa8ce3943e7 clean
    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
2026-10-05 chore: resync installed Loom surfaces
    <!-- loom:provenance v1 build=unknown f92eaec38470a7b0732e065f4864faec9a1905d6 clean prompts=none sweep=none story=none trace=07aa020a8179d52651250562e9808b98 host=robb-studio base=12136894af78f551b0ea08dc00bef180d195cbae run=loom-run/v1:timer:robb-studio/fleet-resync:3b3ebdf2-b5f7-48ed-b7bb-5fb945094061 installs=0.19.734 78f3e99c44d0af6d4598adf7577bb6676baf3e8f -->
    Loom-Trace-Id: 07aa020a8179d52651250562e9808b98
    Loom-Build: unknown f92eaec38470a7b0732e065f4864faec9a1905d6 clean
    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
2026-10-06 chore: resync installed Loom surfaces
    <!-- loom:provenance v1 build=unknown ca170d11544ef499cc9500a45bbad152edacfbd1 clean prompts=none sweep=none story=none trace=fca9c14d74d6d634726f5823c51bc62a host=loom-worker-2 base=863f5f07d10b59933a6ba95ba32051fa2eb180ca run=loom-run/v1:timer:loom-worker-2/fleet-resync:23a23f0878c1494cb720941baddfea81 installs=0.19.741 3cede3920c6b567d5400789187a904970d46b0fb -->
    Loom-Trace-Id: fca9c14d74d6d634726f5823c51bc62a
    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
2026-10-06 chore: resync installed Loom surfaces
    <!-- loom:provenance v1 build=unknown e38a22941348fd8e83d1f4b06130d2a214adfb50 clean prompts=none sweep=none story=none trace=a7fe3a9a1fedfce89846c20f2e98ac31 host=robb-pro base=b0aca9bb844057bc9a14acd6d70e8fb7190a9dc5 run=loom-run/v1:timer:robb-pro/fleet-resync:2d770a42-f0e7-4695-abfa-b912e75382e6 installs=0.19.744 8bc5bcce93c4d9721817387afe8b4b6d79f26054 -->
    Loom-Trace-Id: a7fe3a9a1fedfce89846c20f2e98ac31
    Loom-Build: unknown e38a22941348fd8e83d1f4b06130d2a214adfb50 clean
    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
2026-10-06 chore: resync installed Loom surfaces
    <!-- loom:provenance v1 build=unknown f66ea90ff1bdec51aa4c8dc3f4b2e8d26e3dfd2d clean prompts=none sweep=none story=none trace=66d96c3bb00b04fae967865ee02fc4de host=loom-worker-3 base=6e2b6529e21c5b4c27d14a6cbbb0a6ad8f072f5c run=loom-run/v1:timer:loom-worker-3/fleet-resync:eb2dceb410e848a19d58f96f678c995e installs=0.19.749 6135634b053dc30ef5aa8e6d733bfe79bb2ac734 -->
    Loom-Trace-Id: 66d96c3bb00b04fae967865ee02fc4de
    Loom-Build: unknown f66ea90ff1bdec51aa4c8dc3f4b2e8d26e3dfd2d clean
    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
2026-10-06 chore: resync installed Loom surfaces
    <!-- loom:provenance v1 build=unknown ade8a2c60cc8370d04d72f331141acb6fb32e121 clean prompts=none sweep=none story=none trace=6245fb88b5bdf9f7ccecb6b2168dc335 host=robb-studio base=4a2e94a055827c9ab9ec850c9ff7fee93746dfc7 run=loom-run/v1:timer:robb-studio/fleet-resync:b305aed2-1a25-4576-aca7-9b017ac4377e installs=0.19.755 8d97d322e1cb3723988504337089beca73d0511c -->
    Loom-Trace-Id: 6245fb88b5bdf9f7ccecb6b2168dc335
    Loom-Build: unknown ade8a2c60cc8370d04d72f331141acb6fb32e121 clean
    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
2026-10-06 chore: resync installed Loom surfaces
    <!-- loom:provenance v1 build=unknown 2489bb7d5203844b3fbe8efbe007f44aa074685d clean prompts=none sweep=none story=none trace=0b5c9263a55c09e6fbd870b2d9ff5d9b host=loom-worker-2 base=2285f25b4ab9e047332fa55d8cb9266fec44c0ce run=loom-run/v1:timer:loom-worker-2/fleet-resync:d3f5a5beb1144f72ac8be575767b3e03 installs=0.19.760 3a509582b179d91c2d5b5a65a7ba4650c3c08985 -->
    Loom-Trace-Id: 0b5c9263a55c09e6fbd870b2d9ff5d9b
    Loom-Build: unknown 2489bb7d5203844b3fbe8efbe007f44aa074685d clean
    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
2026-10-06 chore: resync installed Loom surfaces
    <!-- loom:provenance v1 build=unknown 986d16b700174622774ff68af4ef323e8d0e23ba clean prompts=none sweep=none story=none trace=cb518f1f5785c258556383940a46c461 host=loom-worker-1 base=7607c03aa5dba52396490fd0189994e86b3e66a3 run=loom-run/v1:timer:loom-worker-1/fleet-resync:97df92c5eca846de85e979810663a94b installs=0.19.765 c6cec65c4f320f11153c72e840e49a5d6a6f1afc -->
    Loom-Trace-Id: cb518f1f5785c258556383940a46c461
    Loom-Build: unknown 986d16b700174622774ff68af4ef323e8d0e23ba clean
    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
2026-10-06 chore: resync installed Loom surfaces
    <!-- loom:provenance v1 build=unknown 85e52221261264d7f7643251de706f00c8db289f clean prompts=none sweep=none story=none trace=a2434124d73d8cca0ca77230fc85adf5 host=robb-pro base=b68a8ffe1bafd414cecd6a2eda5d02fd3a431965 run=loom-run/v1:timer:robb-pro/fleet-resync:abffb067-59ed-4a6e-94b6-8cf3500c935c installs=0.19.768 c9f7ca975144d991bce40f492403b8292e8b7fae -->
    Loom-Trace-Id: a2434124d73d8cca0ca77230fc85adf5
    Loom-Build: unknown 85e52221261264d7f7643251de706f00c8db289f clean
    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
2026-10-06 chore: resync installed Loom surfaces
    <!-- loom:provenance v1 build=unknown 31b34ebfd7d4539094523eaa7b56a104bebe5fc0 clean prompts=none sweep=none story=none trace=16fac36f144dc183c71465eb36c89afc host=loom-worker-3 base=52cddccedeb9bd2d1d65b7ceb3aa6671de5efb5e run=loom-run/v1:timer:loom-worker-3/fleet-resync:c763e24590314b918c8ee8df5d2de1db installs=0.19.769 af995a5725fdadf708127f006aa8f248b482d7d7 -->
    Loom-Trace-Id: 16fac36f144dc183c71465eb36c89afc
    Loom-Build: unknown 31b34ebfd7d4539094523eaa7b56a104bebe5fc0 clean
    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
2026-10-06 chore: resync installed Loom surfaces
    <!-- loom:provenance v1 build=unknown 7bed309263b3785eae46a9cbc53b3b24a52b10d2 clean prompts=none sweep=none story=none trace=843adbd5eac450c43d3a2c43da1bf729 host=robb-studio base=0bb7b931ea575ac4340936786dc4b1f4a3fb71b4 run=loom-run/v1:timer:robb-studio/fleet-resync:f83d5ba4-81f7-479a-9768-6af33d4cc825 installs=0.19.783 a9b459e0c2b1916ceb116db33053e7eb0df57e7b -->
    Loom-Trace-Id: 843adbd5eac450c43d3a2c43da1bf729
    Loom-Build: unknown 7bed309263b3785eae46a9cbc53b3b24a52b10d2 clean
    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
2026-10-06 chore: resync installed Loom surfaces
    <!-- loom:provenance v1 build=unknown 07bc40ba9ab0f7dfe7cd0990377b7ac07a52d220 clean prompts=none sweep=none story=none trace=563f186108419cf03cef002a62c3b201 host=loom-worker-2 base=441749f86642fcba054d70c380c818bf34256253 run=loom-run/v1:timer:loom-worker-2/fleet-resync:944beccd157a4197b81feafdd19f443e installs=0.19.785 2f0a9dbb4f06053f747b8a5615a3519f8e30b527 -->
    Loom-Trace-Id: 563f186108419cf03cef002a62c3b201
    Loom-Build: unknown 07bc40ba9ab0f7dfe7cd0990377b7ac07a52d220 clean
    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
2026-10-06 chore: resync installed Loom surfaces
    <!-- loom:provenance v1 build=unknown 31b34ebfd7d4539094523eaa7b56a104bebe5fc0 clean prompts=none sweep=none story=none trace=ea6600df41a4b420b6d8e967f839ccfd host=loom-worker-3 base=c771078f97adaaf65a7672501bb78357652f5f76 run=loom-run/v1:timer:loom-worker-3/fleet-resync:c80415b48fd5404bbd599c4f6cc8a448 installs=0.19.793 7ceff96944c39d33e3c2f1141ca650c2c4c05679 -->
    Loom-Trace-Id: ea6600df41a4b420b6d8e967f839ccfd
    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
2026-10-06 chore: resync installed Loom surfaces
    <!-- loom:provenance v1 build=unknown 596a53e525683919daae1b43e6babe9bf847a02f clean prompts=none sweep=none story=none trace=b9c0cb42a5a72ecc21726229c957ef1f host=loom-worker-2 base=7d164ff7c5233f7a0d021595e98a053b0c473259 run=loom-run/v1:timer:loom-worker-2/fleet-resync:21d578f5cc0b4b7ba5f10759f5f30ae8 installs=0.19.801 524bdb33cb26c8355454d7550413c89e72c06fae -->
    Loom-Trace-Id: b9c0cb42a5a72ecc21726229c957ef1f
    Loom-Build: unknown 596a53e525683919daae1b43e6babe9bf847a02f clean
    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
2026-10-06 chore: resync installed Loom surfaces
    <!-- loom:provenance v1 build=unknown 40b591a33adb895d4f46977105f9b264d8a2599b clean prompts=none sweep=none story=none trace=e41c725fe0c176312eb412bc69fe5b01 host=robb-studio base=120b57f79fb06cc355c8cbcd15308257b73c449d run=loom-run/v1:timer:robb-studio/fleet-resync:37d704dd-4dfd-4341-adb4-6551637ad147 installs=0.19.802 72ce1f7385747dd773d1644408ec22072b8a5d20 -->
    Loom-Trace-Id: e41c725fe0c176312eb412bc69fe5b01
    Loom-Build: unknown 40b591a33adb895d4f46977105f9b264d8a2599b clean
    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
2026-10-06 chore: resync installed Loom surfaces
    <!-- loom:provenance v1 build=unknown 31b34ebfd7d4539094523eaa7b56a104bebe5fc0 clean prompts=none sweep=none story=none trace=5ad0480c4b21b80f9c852c448319e7a1 host=loom-worker-3 base=5b3a2b48cb43ea025490db4da85061a7f453f8a6 run=loom-run/v1:timer:loom-worker-3/fleet-resync:48e836f11f9547ddb96de5aa0d072a05 installs=0.19.810 933f828e779602e492e4e157812988a4b8128111 -->
    Loom-Trace-Id: 5ad0480c4b21b80f9c852c448319e7a1
    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
2026-10-07 chore: resync installed Loom surfaces
    <!-- loom:provenance v1 build=unknown f71cf25de9e75bae6060da4a599df8fbabe75890 clean prompts=none sweep=none story=none trace=64943e35511da4833bbd385cf288be8a host=loom-worker-2 base=131e9336b2cbf2b85eefd9cf59dfd7c19831f650 run=loom-run/v1:timer:loom-worker-2/fleet-resync:d69eb1b87d4849ae810a145b1b667d2f installs=0.19.822 1c6969ea8726c800a353c236d9f23456a5706f1a -->
    Loom-Trace-Id: 64943e35511da4833bbd385cf288be8a
    Loom-Build: unknown f71cf25de9e75bae6060da4a599df8fbabe75890 clean
    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
2026-10-07 chore: resync installed Loom surfaces
    <!-- loom:provenance v1 build=unknown 31b34ebfd7d4539094523eaa7b56a104bebe5fc0 clean prompts=none sweep=none story=none trace=cb192cb8f72cf6f2711f73f7ee12bebc host=loom-worker-3 base=f6c05559afac2cb9665553d0cbacecaa0560c5be run=loom-run/v1:timer:loom-worker-3/fleet-resync:c1e385c3607e43ad8bed9c7d29811c66 installs=0.19.830 a966f7b89b714704fa1225b96e2dbee50480a4c6 -->
    Loom-Trace-Id: cb192cb8f72cf6f2711f73f7ee12bebc
    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
2026-10-07 chore: resync installed Loom surfaces
    <!-- loom:provenance v1 build=unknown 8abdd34fddc879aff407380278baa713eca6b758 clean prompts=none sweep=none story=none trace=ea945665dad5ccb3880de51c4448e8b9 host=robb-pro base=df4ab9da1f7cb1a09af7666b880d8d9bfbd30054 run=loom-run/v1:timer:robb-pro/fleet-resync:1466e397-b80c-46ea-a42c-26a7fbd4e00e installs=0.19.831 61814c9c1912925cdff7418842ff3ea17cd56fe4 -->
    Loom-Trace-Id: ea945665dad5ccb3880de51c4448e8b9
    Loom-Build: unknown 8abdd34fddc879aff407380278baa713eca6b758 clean
    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
2026-10-07 chore: resync installed Loom surfaces
    <!-- loom:provenance v1 build=unknown 628be5bb140bcff803d159201bd61e1b868901b0 clean prompts=none sweep=none story=none trace=093df1dc315c5e78dcccfca9d699d5f5 host=loom-worker-2 base=db1c74217b502978f6d6e21b2412b5d2fdcc4575 run=loom-run/v1:timer:loom-worker-2/fleet-resync:0b0ea5e184c0429a9c431fcca6c791ad installs=0.19.832 1a0fc15974bf0575a9155fb8276f7529fc813542 -->
    Loom-Trace-Id: 093df1dc315c5e78dcccfca9d699d5f5
    Loom-Build: unknown 628be5bb140bcff803d159201bd61e1b868901b0 clean
    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
2026-10-07 chore: resync installed Loom surfaces
    <!-- loom:provenance v1 build=unknown 069e3b45d86c08f0d60c8fc2b0096de441e99bdc clean prompts=none sweep=none story=none trace=b1ba9d6b2b581e47827d9c099f717b04 host=loom-worker-1 base=0916f8485b93831bc29ea015d47b8356f798f20b run=loom-run/v1:timer:loom-worker-1/fleet-resync:aada8278bd4843bcaecce69fdf91251e installs=0.19.837 9504f1e9b05e05ce908dd5cffad2aae723621f63 -->
    Loom-Trace-Id: b1ba9d6b2b581e47827d9c099f717b04
    Loom-Build: unknown 069e3b45d86c08f0d60c8fc2b0096de441e99bdc clean
    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
2026-10-07 chore: resync installed Loom surfaces
    <!-- loom:provenance v1 build=unknown 31b34ebfd7d4539094523eaa7b56a104bebe5fc0 clean prompts=none sweep=none story=none trace=ef030e94bce76f728497f5927960865f host=loom-worker-3 base=c5b661b38655e81374f9037f316b3404cfb9d23c run=loom-run/v1:timer:loom-worker-3/fleet-resync:28ba4284bfa446c888b501714eda0509 installs=0.19.840 59b533a2a1ed5e186fbf8446b5acbe42d7231854 -->
    Loom-Trace-Id: ef030e94bce76f728497f5927960865f
    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
2026-10-07 chore: resync installed Loom surfaces
    <!-- loom:provenance v1 build=unknown bc59c70c3412a87b31a0dbe65cd6abf968744328 clean prompts=none sweep=none story=none trace=766033e4e881801f24971d664c490ea3 host=robb-studio base=77b2f81a3e39c4a8357b6928675bcd2bd7d73cf2 run=loom-run/v1:timer:robb-studio/fleet-resync:6b3b079a-890e-4a79-9c3a-0b4bb33ff7c4 installs=0.19.840 59b533a2a1ed5e186fbf8446b5acbe42d7231854 -->
    Loom-Trace-Id: 766033e4e881801f24971d664c490ea3
    Loom-Build: unknown bc59c70c3412a87b31a0dbe65cd6abf968744328 clean
    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
2026-10-07 chore: resync installed Loom surfaces
    <!-- loom:provenance v1 build=unknown a068938e7a6c13759bcb3943e408273a3d352257 clean prompts=none sweep=none story=none trace=76bec863c8f6aff2d49b3aa2be128619 host=robb-pro base=eaa7e34b30b3831cf4a2db4ce59801332e4e447a run=loom-run/v1:timer:robb-pro/fleet-resync:d9927fc6-ee80-4b6a-ba2b-f13576bd5f9b installs=0.19.846 837b14d7440b89ae8a2cec6d045483ac33659af5 -->
    Loom-Trace-Id: 76bec863c8f6aff2d49b3aa2be128619
    Loom-Build: unknown a068938e7a6c13759bcb3943e408273a3d352257 clean
    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
2026-10-07 chore: resync installed Loom surfaces
    <!-- loom:provenance v1 build=unknown 628be5bb140bcff803d159201bd61e1b868901b0 clean prompts=none sweep=none story=none trace=5a6f676b4652a1a750bbce1386c68d06 host=loom-worker-2 base=ab75336f5501152d7231d9fca78175d968c44e29 run=loom-run/v1:timer:loom-worker-2/fleet-resync:bd416e653be04ef4b13353430625e379 installs=0.19.850 3bb4bfc90603b6ad65cabca9b3eb42a59f1a9d3a -->
    Loom-Trace-Id: 5a6f676b4652a1a750bbce1386c68d06
    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
2026-10-07 chore: resync installed Loom surfaces
    <!-- loom:provenance v1 build=unknown 40215645df8a13508180b248b44244dc488bb078 clean prompts=none sweep=none story=none trace=29fde30615e6e47f39b41aa314c2c883 host=loom-worker-1 base=e94621c1e77335df64dba9050e42d29721d3e301 run=loom-run/v1:timer:loom-worker-1/fleet-resync:d1fbedfcc7824ae59233c0ea94dc4650 installs=0.19.853 2889d5ed585b4da0935543cb916381cc03b19746 -->
    Loom-Trace-Id: 29fde30615e6e47f39b41aa314c2c883
    Loom-Build: unknown 40215645df8a13508180b248b44244dc488bb078 clean
    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
2026-10-07 chore: resync installed Loom surfaces
    <!-- loom:provenance v1 build=unknown 31b34ebfd7d4539094523eaa7b56a104bebe5fc0 clean prompts=none sweep=none story=none trace=cdf49c615da3f5ce46e9fcda1a24f787 host=loom-worker-3 base=eb8a6c0c4fa734ea5caa63d15462c38136237365 run=loom-run/v1:timer:loom-worker-3/fleet-resync:cab31e05b8a24df09bc88f53ee3fb501 installs=0.19.857 7a0b529e6f57a79713f6924bf58d8392ff404259 -->
    Loom-Trace-Id: cdf49c615da3f5ce46e9fcda1a24f787
    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
2026-10-07 chore: resync installed Loom surfaces
    <!-- loom:provenance v1 build=unknown 4b44e7c5db0de1d2b5927de7de229120d546aad3 clean prompts=none sweep=none story=none trace=dfa656ee3483a044378501f49d36f812 host=robb-studio base=11003a57bf8addcf283afc717bc46fa528a5ae3e run=loom-run/v1:timer:robb-studio/fleet-resync:d80d6bc0-eb68-4a07-8226-2d947d328b3a installs=0.19.859 0aefebd79aba8ab33470f1af4b96847fc794bd0d -->
    Loom-Trace-Id: dfa656ee3483a044378501f49d36f812
    Loom-Build: unknown 4b44e7c5db0de1d2b5927de7de229120d546aad3 clean
    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
2026-10-07 chore: resync installed Loom surfaces
    <!-- loom:provenance v1 build=unknown b591c8cf436f0d4aa5870a9bc7cd5f7194e0e778 dirty prompts=none sweep=none story=none trace=6eca4b0c47205457aae7a3d721c17f17 host=robb-pro base=da61e3e99c07a470e631b8d1e513ea6f24182e42 run=loom-run/v1:timer:robb-pro/fleet-resync:64af20b3-58cb-47f2-b770-117197cb41e9 installs=0.19.864 128a7eba2bb5f7bcf8891ba284b14cb7ebf8dd3d -->
    Loom-Trace-Id: 6eca4b0c47205457aae7a3d721c17f17
    Loom-Build: unknown b591c8cf436f0d4aa5870a9bc7cd5f7194e0e778 dirty
    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
2026-10-07 chore: resync installed Loom surfaces
    <!-- loom:provenance v1 build=unknown b551219fd5b8347113c0cbc79ea416e81c39fa9d clean prompts=none sweep=none story=none trace=5ac7c8c62dad54841e21dd94f0920de3 host=loom-worker-2 base=aa506a058d79d866f040a4891fc43e8720b5c9ac run=loom-run/v1:timer:loom-worker-2/fleet-resync:d10fb10789e94930ab1af368c15a8f8b installs=0.19.864 128a7eba2bb5f7bcf8891ba284b14cb7ebf8dd3d -->
    Loom-Trace-Id: 5ac7c8c62dad54841e21dd94f0920de3
    Loom-Build: unknown b551219fd5b8347113c0cbc79ea416e81c39fa9d clean
    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
2026-10-07 chore: resync installed Loom surfaces
    <!-- loom:provenance v1 build=unknown 90fbd167e4e376894396e651676cf58fc9aa223a clean prompts=none sweep=none story=none trace=196876656e912171b28029ceca9f772d host=loom-worker-1 base=ab096c727867ca47eb847741cbfbb13ddef96009 run=loom-run/v1:timer:loom-worker-1/fleet-resync:7b46720ff3a84a8184f2f2b3bc039260 installs=0.19.868 ee904e1c151bc9cf15b0eb55dfe9d57ad6136cff -->
    Loom-Trace-Id: 196876656e912171b28029ceca9f772d
    Loom-Build: unknown 90fbd167e4e376894396e651676cf58fc9aa223a clean
    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
2026-10-08 chore: resync installed Loom surfaces
    <!-- loom:provenance v1 build=unknown 5a3df331a0612dee585ef905015af01d08e3467f clean prompts=none sweep=none story=none trace=5690fa95febe608e500a46dde8a6ee92 host=loom-worker-2 base=1bc591892fb75c5a24a48614a67f9bd4b7ec983f run=loom-run/v1:timer:loom-worker-2/fleet-resync:5c9c35d59b704bff9d8bf096ee7ba7be installs=0.19.876 b16d54e63fbbec4d7f15f13c1f43a5e5b38145ce -->
    Loom-Trace-Id: 5690fa95febe608e500a46dde8a6ee92
    Loom-Build: unknown 5a3df331a0612dee585ef905015af01d08e3467f clean
    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
2026-10-08 chore: resync installed Loom surfaces
    <!-- loom:provenance v1 build=unknown 134eb3ff06c1a86f49a911c6c17464f55e719736 clean prompts=none sweep=none story=none trace=c7df110d490314040dcd1347b2481843 host=loom-worker-1 base=332f72d3ccabcbcfc207628ae2aa7a8542a6dbf3 run=loom-run/v1:timer:loom-worker-1/fleet-resync:53d0cec2cd61484eb9a0f8fb1f24ac5e installs=0.19.879 c15619905bdd8a24506c3853f45490d26e8f1cad -->
    Loom-Trace-Id: c7df110d490314040dcd1347b2481843
    Loom-Build: unknown 134eb3ff06c1a86f49a911c6c17464f55e719736 clean
    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
2026-10-08 chore: resync installed Loom surfaces
    <!-- loom:provenance v1 build=unknown 8f86de23319d8f6cf049557dcc9cf2e321211d9d clean prompts=none sweep=none story=none trace=17de45f778fbfd714af8afad02c96375 host=loom-worker-3 base=fe2cca5484e7fd50b81c851dabda80223f913844 run=loom-run/v1:timer:loom-worker-3/fleet-resync:9e3e5d4a08824de3b7bc02940be2a0da installs=0.19.882 c9f85af3d967986cdd7a3f27e088a16f88712b05 -->
    Loom-Trace-Id: 17de45f778fbfd714af8afad02c96375
    Loom-Build: unknown 8f86de23319d8f6cf049557dcc9cf2e321211d9d clean
    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
2026-10-08 chore: resync installed Loom surfaces
    <!-- loom:provenance v1 build=unknown 4a5fb2b6276e17ff26ee1382acfe2ea7360ebea5 clean prompts=none sweep=none story=none trace=67857e1b7189785825a2dfc70921cf85 host=loom-worker-2 base=59fbf3a83ba38d1678f0e679fe2c44db2dd7f634 run=loom-run/v1:timer:loom-worker-2/fleet-resync:dd6a5f3dceff4d8d8602a07a1dc89c95 installs=0.19.892 ce93e8a919d79a6f027bab268846a52084f9d94e -->
    Loom-Trace-Id: 67857e1b7189785825a2dfc70921cf85
    Loom-Build: unknown 4a5fb2b6276e17ff26ee1382acfe2ea7360ebea5 clean
    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
2026-10-08 chore: resync installed Loom surfaces
    <!-- loom:provenance v1 build=unknown b591c8cf436f0d4aa5870a9bc7cd5f7194e0e778 dirty prompts=none sweep=none story=none trace=28e7ca5fdb768489aa38bf002407d5a5 host=robb-pro base=5863a16fbc749504d10ea0ba46b4e3ec0ad57989 run=loom-run/v1:timer:robb-pro/fleet-resync:eb5f838e-a774-4e20-8102-c37ee3ff31ca installs=0.19.895 9b30d293bcba1e79d49cabfc1c5bb5b6f4c0dc77 -->
    Loom-Trace-Id: 28e7ca5fdb768489aa38bf002407d5a5
    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
2026-10-08 feat: per-lane external 10-bit character input and select (DR-0018); ratify DR-0016
    Ratify DR-0016 (Option A) per the 2026-10-08 attended-session decision and
    index it. Add rtl/tmds_tx_lane.v and DR-0018, extend the serializer bench.
    Loom-Story: 2AMLogic/gf180-tmds-tx#186
    Loom-Trace-Id: 3848f21b9fcf62d36cb9a14c8682e704
    Loom-Build: 0.19.868 ee904e1c151bc9cf15b0eb55dfe9d57ad6136cff clean
2026-10-08 chore: resync installed Loom surfaces
    <!-- loom:provenance v1 build=unknown 5684fc8c8ac418d95ad66a002d001eaea1283c9a clean prompts=none sweep=none story=none trace=c864acd3b9a5dbb419fddd8bd2a6283b host=loom-worker-3 base=31a021656fb7926f225fdaf4c9d9bf2919221488 run=loom-run/v1:timer:loom-worker-3/fleet-resync:4771e7c630c34445b7f28539669d76e3 installs=0.19.898 3d55b9a1669c132d130d98f10a292c1325322c30 -->
    Loom-Trace-Id: c864acd3b9a5dbb419fddd8bd2a6283b
    Loom-Build: unknown 5684fc8c8ac418d95ad66a002d001eaea1283c9a clean
    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
2026-10-08 chore: resync installed Loom surfaces
    <!-- loom:provenance v1 build=unknown 04a1189116c7320def7d9ce357d2d9268405ae92 clean prompts=none sweep=none story=none trace=8e55b27fc60ffb045554bd413ad8f3c8 host=robb-pro base=1f57246f0e201d70d86d5d8cdea2949e34c19471 run=loom-run/v1:timer:robb-pro/fleet-resync:83b69005-7c5b-44b3-96f8-33f07bf82f4b installs=0.19.917 d3c1ea3a4c81e01ce5487dc3e4bbdd86534e677e -->
    Loom-Trace-Id: 8e55b27fc60ffb045554bd413ad8f3c8
    Loom-Build: unknown 04a1189116c7320def7d9ce357d2d9268405ae92 clean
    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
2026-10-08 feat(erc): declare well/LVPWELL ties in digital supply spec; item 11 digital now met (#206)
    Loom-Story: 2AMLogic/gf180-tmds-tx#206
    Loom-Trace-Id: 3b843362ff219ffe780f79fec3e28cce
    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
2026-10-08 chore: resync installed Loom surfaces
    <!-- loom:provenance v1 build=unknown d2a55ce217b3ad1793611a2c54946676bb55b512 clean prompts=none sweep=none story=none trace=459637e4e8503593bdf58360865a7524 host=robb-pro base=c1799bfb72d5fcacd0a8995bec0ab9bc1026df7c run=loom-run/v1:timer:robb-pro/fleet-resync:95b3cf92-9cd9-4c36-8bbd-bdcace7c3874 installs=0.19.935 d347079cd0bad2db2c11ee4f0b760f04b2601d21 -->
    Loom-Trace-Id: 459637e4e8503593bdf58360865a7524
    Loom-Build: unknown d2a55ce217b3ad1793611a2c54946676bb55b512 clean
    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
2026-10-08 feat: klt erc supply spec and report for pad-ring assembly; cite 11.analog (#207)
    Loom-Story: 2AMLogic/gf180-tmds-tx#207
    Loom-Trace-Id: 540fdabee738bcfaad6167db91caaa33
    Loom-Build: 0.19.898 3d55b9a1669c132d130d98f10a292c1325322c30 clean
2026-10-09 chore: resync installed Loom surfaces
    <!-- loom:provenance v1 build=unknown 05dba463c5b293d38f0ca071725983862498b3f3 clean prompts=none sweep=none story=none trace=14298316053024bcf5120bff695771ab host=robb-pro base=d90cd81470f91e23b85fe00f0416645b91f8aa4f run=loom-run/v1:timer:robb-pro/fleet-resync:2f384483-6d77-4ba2-9888-aa1e4b5be36c installs=0.19.953 b93d7a955d63411cb4c94b986fd5138d27dedb0f -->
    Loom-Trace-Id: 14298316053024bcf5120bff695771ab
    Loom-Build: unknown 05dba463c5b293d38f0ca071725983862498b3f3 clean
    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
2026-10-09 chore: resync installed Loom surfaces
    <!-- loom:provenance v1 build=unknown 7f06b288b150f2fe0a4b24c331a9b3ec093d709d clean prompts=none sweep=none story=none trace=a90c217ff3a3bd9e3a30282b8cadc24d host=robb-pro base=c373941801f60f556756dab8ca4ff22052bc95b5 run=loom-run/v1:timer:robb-pro/fleet-resync:6e5ec9f3-d6ef-4953-80f7-c93035e2d359 installs=0.19.966 9bed656320e53ba6c64305daa60613431a7ed02d -->
    Loom-Trace-Id: a90c217ff3a3bd9e3a30282b8cadc24d
    Loom-Build: unknown 7f06b288b150f2fe0a4b24c331a9b3ec093d709d clean
    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
2026-10-09 chore: resync installed Loom surfaces
    <!-- loom:provenance v1 build=unknown 30c7a7ee2f74a6a2b5bb0f19fd9f049ec8ae8b5c clean prompts=none sweep=none story=none trace=7bc5ba399ff199d049d83d711920a157 host=robb-pro base=0ed7140ce889e1c7ec31c83431e4b4ba60854f6a run=loom-run/v1:timer:robb-pro/fleet-resync:8e237160-c4d0-4ce3-85ac-c96aff5cf221 installs=0.19.982 2bc4cba624b9053535663441e6f0daf08a7acf2e -->
    Loom-Trace-Id: 7bc5ba399ff199d049d83d711920a157
    Loom-Build: unknown 30c7a7ee2f74a6a2b5bb0f19fd9f049ec8ae8b5c clean
    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
2026-10-10 chore: resync installed Loom surfaces
    <!-- loom:provenance v1 build=unknown 03c1cb521a10d5101bd8aa2c52a47cebfb0e795b clean prompts=none sweep=none story=none trace=09ccab293fce5c1a7b4aa907c7197bec host=robb-studio base=097494706300bddcebfd6b6a156799679c92e4bd run=loom-run/v1:timer:robb-studio/fleet-resync:ed2be6c5-20fe-4228-a206-940d35a4858f installs=0.19.996 0d2be7e9ae05753e2c9232a83b7399d45de5396e -->
    Loom-Trace-Id: 09ccab293fce5c1a7b4aa907c7197bec
    Loom-Build: unknown 03c1cb521a10d5101bd8aa2c52a47cebfb0e795b clean
    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
2026-10-10 chore: resync installed Loom surfaces
    <!-- loom:provenance v1 build=unknown a7d2b01d8eb7d09e597a4638e5cb3cdd8bab9156 clean prompts=none sweep=none story=none trace=35c1337ee84607e87ba2038523d63198 host=robb-pro base=1984ec8771e450c96af85c40a556bf0a5f08029f run=loom-run/v1:timer:robb-pro/fleet-resync:6bf32a81-6c4a-48c5-a51e-1ad65c6bedfd installs=0.19.999 20513e3064fa3a7c4b3f1c641d97a00446e9ba78 -->
    Loom-Trace-Id: 35c1337ee84607e87ba2038523d63198
    Loom-Build: unknown a7d2b01d8eb7d09e597a4638e5cb3cdd8bab9156 clean
    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
2026-10-10 chore: resync installed Loom surfaces
    <!-- loom:provenance v1 build=unknown c156f673e072832aaacb4cd1ec65b742e7f45867 clean prompts=none sweep=none story=none trace=9de99c124c651049199abe9a75070dc7 host=robb-pro base=18811661cb1b778958f04954346ea48f0eac2fd0 run=loom-run/v1:timer:robb-pro/fleet-resync:f790885c-7154-4b3d-acd9-71fd537cd20b installs=0.19.1010 d1d5fcecb79550fe39658555a4419f98cec060fb -->
    Loom-Trace-Id: 9de99c124c651049199abe9a75070dc7
    Loom-Build: unknown c156f673e072832aaacb4cd1ec65b742e7f45867 clean
    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
2026-10-10 chore: resync installed Loom surfaces
    <!-- loom:provenance v1 build=unknown 52f79668bb5f93c1828b7f1ea4f7013b917b847b clean prompts=none sweep=none story=none trace=7057f3175071f1f6e34b354fab40a0ce host=robb-studio base=4fcceced8ea057b45f247cad259d2632de575c4e run=loom-run/v1:timer:robb-studio/fleet-resync:d8918779-1625-4202-b151-71f64465e8cd installs=0.19.1010 d1d5fcecb79550fe39658555a4419f98cec060fb -->
    Loom-Trace-Id: 7057f3175071f1f6e34b354fab40a0ce
    Loom-Build: unknown 52f79668bb5f93c1828b7f1ea4f7013b917b847b clean
    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
2026-10-10 chore: resync installed Loom surfaces
    <!-- loom:provenance v1 build=unknown 525fe43b7b1b2a0271084bba444c934a1541a8d8 clean prompts=none sweep=none story=none trace=0d4424bd058cf912b74934ec0e7bf37e host=robb-pro base=90e4586a3cd9218c2928e1c241acc82edd92d046 run=loom-run/v1:timer:robb-pro/fleet-resync:4812047c-8b9b-4da2-a5dc-13e6f6420a04 installs=0.19.1018 13e54f1cfc513507a7ef84ec6908085638d9c187 -->
    Loom-Trace-Id: 0d4424bd058cf912b74934ec0e7bf37e
    Loom-Build: unknown 525fe43b7b1b2a0271084bba444c934a1541a8d8 clean
    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
2026-10-10 chore: resync installed Loom surfaces
    <!-- loom:provenance v1 build=unknown 525fe43b7b1b2a0271084bba444c934a1541a8d8 clean prompts=none sweep=none story=none trace=d4059def94f46d8d158946acddd4d602 host=robb-studio base=71204e9801122edd09f16db82b14b29802b64d6d run=loom-run/v1:timer:robb-studio/fleet-resync:4a4d1995-968e-44c5-b5fe-804b4d477795 installs=0.19.1019 febfc4335d0554865fadbecba718245cd88c6678 -->
    Loom-Trace-Id: d4059def94f46d8d158946acddd4d602
    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
2026-10-10 chore: resync installed Loom surfaces
    <!-- loom:provenance v1 build=unknown 5d5f41d89eef35adf478b92b96af06c6d86d27a6 clean prompts=none sweep=none story=none trace=05d2a40831b35ba1c48afada00c29519 host=robb-pro base=d59e8b0f762ece89cca2f538ec4d131d2c07ab74 run=loom-run/v1:timer:robb-pro/fleet-resync:c58bb82e-a213-439d-b829-04234e141de9 installs=0.19.1027 59bb53f01eb99187ce25f22be1a64da5c877d115 -->
    Loom-Trace-Id: 05d2a40831b35ba1c48afada00c29519
    Loom-Build: unknown 5d5f41d89eef35adf478b92b96af06c6d86d27a6 clean
    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
2026-10-10 chore: resync installed Loom surfaces
    <!-- loom:provenance v1 build=unknown aa536103d6239818bb974a51d2f7f268eff38bad clean prompts=none sweep=none story=none trace=126a1328a3664e2119a0978086db9bea host=robb-studio base=f32a1cc102767e4be6fef924bb28b11a9d869bc4 run=loom-run/v1:timer:robb-studio/fleet-resync:fbc4e361-e290-4d81-ae3a-8b5fde796815 installs=0.19.1031 286d609f09342e7c84f2e23771edbac5b1914659 -->
    Loom-Trace-Id: 126a1328a3664e2119a0978086db9bea
    Loom-Build: unknown aa536103d6239818bb974a51d2f7f268eff38bad clean
    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
2026-10-11 chore: resync installed Loom surfaces
    <!-- loom:provenance v1 build=unknown cf08873555e2eb95da295dcbee98b0dc34473381 clean prompts=none sweep=none story=none trace=67fbc483c3ca3e442d7928804c11ff06 host=robb-pro base=b57e05ec7cccfed6c215d889c789c96be0b75994 run=loom-run/v1:timer:robb-pro/fleet-resync:e3f97888-2b26-404a-bd47-86fd28a4eced installs=0.19.1041 b65c266b47d796bf37d1c04c6f616be0bc699056 -->
    Loom-Trace-Id: 67fbc483c3ca3e442d7928804c11ff06
    Loom-Build: unknown cf08873555e2eb95da295dcbee98b0dc34473381 clean
    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
2026-10-11 chore: resync installed Loom surfaces
    <!-- loom:provenance v1 build=unknown e91831edf7b55b29d3a2d88e266916fab9ce2563 clean prompts=none sweep=none story=none trace=f72dd67520a2c3802aa0495b80ac65a5 host=robb-studio base=10d1fd4a7ab5f98c86d13f9ab9c4a86be215dedc run=loom-run/v1:timer:robb-studio/fleet-resync:91d2434e-eae5-45de-9305-d78c43fc7c7a installs=0.19.1042 5b6ebdcc40bfccc9357e15196984061f1d5e6178 -->
    Loom-Trace-Id: f72dd67520a2c3802aa0495b80ac65a5
    Loom-Build: unknown e91831edf7b55b29d3a2d88e266916fab9ce2563 clean
    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
2026-10-11 chore: resync installed Loom surfaces
    <!-- loom:provenance v1 build=unknown 5ec729b9f7dd55a2082752611e4c4964f49661fb clean prompts=none sweep=none story=none trace=efc2abc8b72538df6d1a6ea9d329603d host=robb-pro base=6f0c225f7bdbcf522afd8156912a7e7c037beceb run=loom-run/v1:timer:robb-pro/fleet-resync:0d396c06-f26e-423e-97ac-6d3ac04a8e51 installs=0.19.1054 f6a73bc7fc942d7b297514b2e3f57a0ca2076010 -->
    Loom-Trace-Id: efc2abc8b72538df6d1a6ea9d329603d
    Loom-Build: unknown 5ec729b9f7dd55a2082752611e4c4964f49661fb clean
    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
2026-10-11 chore: resync installed Loom surfaces
    <!-- loom:provenance v1 build=unknown 745f69d0daad6c23e76cc006720fa4fbeaa3d887 clean prompts=none sweep=none story=none trace=3baabc4a039fd85029fff227a6ae690a host=robb-studio base=c0c041c750caff704ceae6f489c2f541de0bac97 run=loom-run/v1:timer:robb-studio/fleet-resync:3b3207d7-055d-49b5-a387-db375213668d installs=0.19.1058 00ceead491dd1ae20db00db16a650ea43dd0c09b -->
    Loom-Trace-Id: 3baabc4a039fd85029fff227a6ae690a
    Loom-Build: unknown 745f69d0daad6c23e76cc006720fa4fbeaa3d887 clean
    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
2026-10-11 chore: resync installed Loom surfaces
    <!-- loom:provenance v1 build=unknown b37a005ac1889262fb9e5338f7cff4e9ed4987da clean prompts=none sweep=none story=none trace=25c158d7e9591610b251780caaff1c5f host=robb-pro base=c8155638f62604a016a01642c45a345156445344 run=loom-run/v1:timer:robb-pro/fleet-resync:7f020bca-6920-47f7-a5e4-bbd5c82d9bb8 installs=0.19.1072 29b48db1ead9c4501304e0114a5c33310e1d589f -->
    Loom-Trace-Id: 25c158d7e9591610b251780caaff1c5f
    Loom-Build: unknown b37a005ac1889262fb9e5338f7cff4e9ed4987da clean
    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
2026-10-11 chore: resync installed Loom surfaces
    <!-- loom:provenance v1 build=unknown 81a6b4499cb57b3620785bc1625c300da34f0735 clean prompts=none sweep=none story=none trace=d08bbd290651d7bcbda8b216c0dfbcdf host=robb-studio base=b0392eac75869db01126050dae9b1dee5f49a04d run=loom-run/v1:timer:robb-studio/fleet-resync:71e05e3d-931c-46b4-b6d2-5f3f992c1e19 installs=0.19.1073 abb0872ba7d1d3f6f3a14f71f51a562e89308181 -->
    Loom-Trace-Id: d08bbd290651d7bcbda8b216c0dfbcdf
    Loom-Build: unknown 81a6b4499cb57b3620785bc1625c300da34f0735 clean
    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
2026-10-12 chore: resync installed Loom surfaces
    <!-- loom:provenance v1 build=unknown ddfb67ccf9a5115d62dd86924613a468b9328f44 clean prompts=none sweep=none story=none trace=772605234b9d8cafd6a4049200f7425c host=robb-pro base=57603129986f77d6c108d24349f080fce6b500dc run=loom-run/v1:timer:robb-pro/fleet-resync:1ef28ffc-0277-424f-9224-7ee6eca46377 installs=0.19.1081 be16cedf6a394661d3b1400531335927f5eb4519 -->
    Loom-Trace-Id: 772605234b9d8cafd6a4049200f7425c
    Loom-Build: unknown ddfb67ccf9a5115d62dd86924613a468b9328f44 clean
    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
2026-10-12 chore: resync installed Loom surfaces
    <!-- loom:provenance v1 build=unknown be358990895362019614bd207bcbe36bc9eeff2c clean prompts=none sweep=none story=none trace=f1dc643b95859c8f26e892ddb5e2c5d7 host=robb-studio base=02357350696c8e0f903f9f292602b9f1f97eb52b run=loom-run/v1:timer:robb-studio/fleet-resync:da486ca2-3e94-4a85-abd3-88707942489a installs=0.19.1086 d8cb20101a985145fb167c1933758075a14ce1ab -->
    Loom-Trace-Id: f1dc643b95859c8f26e892ddb5e2c5d7
    Loom-Build: unknown be358990895362019614bd207bcbe36bc9eeff2c clean
    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
2026-10-12 chore: resync installed Loom surfaces
    <!-- loom:provenance v1 build=unknown a579728c137cc11d08a48b178e0ff9aa21683e72 clean prompts=none sweep=none story=none trace=10832f2750dbcd63f6c6f301a6f4da9b host=loom-worker-2 base=bd278a2585a41db82eb3e6ae48cd32f4bad3b287 run=loom-run/v1:timer:loom-worker-2/fleet-resync:180f6d5054f0479ab3990b86ab4522a5 installs=0.19.1087 51ac271f990b317a52ebf27cc21f34561e1179fb -->
    Loom-Trace-Id: 10832f2750dbcd63f6c6f301a6f4da9b
    Loom-Build: unknown a579728c137cc11d08a48b178e0ff9aa21683e72 clean
    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
2026-10-12 chore: resync installed Loom surfaces
    <!-- loom:provenance v1 build=unknown 02ecafe7734bf5faa945ce88940589f00eca78e9 clean prompts=none sweep=none story=none trace=5f71c537126994dc4c45179122427514 host=robb-pro base=fb88ceb4399fafedb1f3cb34b45a0432934fea31 run=loom-run/v1:timer:robb-pro/fleet-resync:6293e6da-8a67-45aa-b277-c9ef85ddb810 installs=0.19.1101 27422582cd2d34d8ed5f60ce987007bc4bd61081 -->
    Loom-Trace-Id: 5f71c537126994dc4c45179122427514
    Loom-Build: unknown 02ecafe7734bf5faa945ce88940589f00eca78e9 clean
    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
2026-10-12 chore: resync installed Loom surfaces
    <!-- loom:provenance v1 build=unknown 5918da96dcd60c9a677a195737c86ea38972d215 clean prompts=none sweep=none story=none trace=49bb7a8942d6a23bf41754ca27ff2368 host=loom-worker-2 base=c75566d5524fdce09087600e210c0c8333c3185f run=loom-run/v1:timer:loom-worker-2/fleet-resync:2e973f04abd1447d8ee4b696c2e7d2b4 installs=0.19.1106 41ec9e3297a4d8c8f9f4462b3fbd02af5fc77138 -->
    Loom-Trace-Id: 49bb7a8942d6a23bf41754ca27ff2368
    Loom-Build: unknown 5918da96dcd60c9a677a195737c86ea38972d215 clean
    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
2026-10-12 chore: resync installed Loom surfaces
    <!-- loom:provenance v1 build=unknown 9885e6bbba36f53328e04be83140734c6eda9f58 clean prompts=none sweep=none story=none trace=72f34c4066d6ca844a10c33035a775bd host=loom-worker-1 base=d9220e4a4af1c2b35bd7ce4e95673f795b5353a3 run=loom-run/v1:timer:loom-worker-1/fleet-resync:8f5732bc51fd43379e17e0de51e86bae installs=0.19.1108 72427939d156341080a7006ae6fbb5ec96b2368e -->
    Loom-Trace-Id: 72f34c4066d6ca844a10c33035a775bd
    Loom-Build: unknown 9885e6bbba36f53328e04be83140734c6eda9f58 clean
    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
2026-10-12 chore: resync installed Loom surfaces
    <!-- loom:provenance v1 build=unknown 01467247f32c59822968bf02d3214d9a3d613452 clean prompts=none sweep=none story=none trace=0e97e9733eef09a33959cf96e6271f40 host=robb-studio base=44eb1f9012258d8ca3b10a2f6d4fb4fe795e754f run=loom-run/v1:timer:robb-studio/fleet-resync:53a4d390-3842-4216-9018-5dced9d0ea17 installs=0.19.1109 d9498fcd419776b2517e30b99c88e76bbe92d2f4 -->
    Loom-Trace-Id: 0e97e9733eef09a33959cf96e6271f40
    Loom-Build: unknown 01467247f32c59822968bf02d3214d9a3d613452 clean
    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
2026-10-12 chore: resync installed Loom surfaces
    <!-- loom:provenance v1 build=unknown acadc2b4b0e852f2d889ac9dec616e1548705802 clean prompts=none sweep=none story=none trace=a69edb348af7f0e67b3bc77bc33b1bfc host=loom-worker-2 base=4bca6d007c0eb38a090761b2a79d0c41aa46eab5 run=loom-run/v1:timer:loom-worker-2/fleet-resync:0923627ffda84cf69ec2486475772b10 installs=0.19.1126 7736d1276b6d01778fba3461114c858ef1bf5e2d -->
    Loom-Trace-Id: a69edb348af7f0e67b3bc77bc33b1bfc
    Loom-Build: unknown acadc2b4b0e852f2d889ac9dec616e1548705802 clean
    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
2026-10-12 chore: resync installed Loom surfaces
    <!-- loom:provenance v1 build=unknown 8d832cc8035d4ba07872510416468da0790332cd clean prompts=none sweep=none story=none trace=09a53bf60e96fc30a753caffd1de8c92 host=robb-studio base=7b134882d3361e3aaaf7e5fb22e73102d3f6c014 run=loom-run/v1:timer:robb-studio/fleet-resync:baf4c30c-65d9-4d4e-a740-f6a80cbb975c installs=0.19.1132 8695bdd2b7b963dca9b76f4643a9d7c744294426 -->
    Loom-Trace-Id: 09a53bf60e96fc30a753caffd1de8c92
    Loom-Build: unknown 8d832cc8035d4ba07872510416468da0790332cd clean
    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
2026-10-12 chore: resync installed Loom surfaces
    <!-- loom:provenance v1 build=unknown aa1ed0d7d5499d2705977d971673d919dbbbaf4e clean prompts=none sweep=none story=none trace=2522608826ef5d5e4a88a9667055aeb7 host=loom-worker-2 base=abd565374ef30d14d49b8bc6b37f5397dc11085d run=loom-run/v1:timer:loom-worker-2/fleet-resync:8f26b719c712455381744111c50e90b4 installs=0.19.1142 b91ae5d1b5204f499a1abb875a6cf5bffc1d90b1 -->
    Loom-Trace-Id: 2522608826ef5d5e4a88a9667055aeb7
    Loom-Build: unknown aa1ed0d7d5499d2705977d971673d919dbbbaf4e clean
    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
2026-10-12 chore: resync installed Loom surfaces
    <!-- loom:provenance v1 build=unknown 8b64614d017d6ce7491c3a2ac9da51e5e2901c97 clean prompts=none sweep=none story=none trace=66044c049ba635bcd6a4797c3a77e84b host=robb-pro base=e08899c6eed1ed580e22615314274b6d7f920a3d run=loom-run/v1:timer:robb-pro/fleet-resync:68f56594-05d0-4cc0-9c07-36263359d698 installs=0.19.1144 9e4381cbbd2386393e44c7a979583252948a3998 -->
    Loom-Trace-Id: 66044c049ba635bcd6a4797c3a77e84b
    Loom-Build: unknown 8b64614d017d6ce7491c3a2ac9da51e5e2901c97 clean
    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
2026-10-13 chore: resync installed Loom surfaces
    <!-- loom:provenance v1 build=unknown 98d08ab78cc223361354ee9947d996b1cb914b30 clean prompts=none sweep=none story=none trace=8b73addcdeaa8fbd65998649f42a8c50 host=loom-worker-2 base=1e8e25aed83ce3582fd4593b9d1c9a5247231518 run=loom-run/v1:timer:loom-worker-2/fleet-resync:3bfb13d52fca425f9cfced4541954cb6 installs=0.19.1148 1448fdfa79ac2dcab7fad6b95b72697b450f2a4a -->
    Loom-Trace-Id: 8b73addcdeaa8fbd65998649f42a8c50
    Loom-Build: unknown 98d08ab78cc223361354ee9947d996b1cb914b30 clean
    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
2026-10-13 chore: resync installed Loom surfaces
    <!-- loom:provenance v1 build=unknown d0bfbbc7ac309581d7abe02c4a269c7704010ee0 clean prompts=none sweep=none story=none trace=0ad6d167235000f3b5648cbd63d761ce host=robb-pro base=02c31d89d17f2b565bdd08151d134ee0716cddc3 run=loom-run/v1:timer:robb-pro/fleet-resync:4f7cbe22-40b6-49ff-8811-003ae8577c28 installs=0.19.1151 08ee0f8708464aa8e0768640d56955d7f4fcbc98 -->
    Loom-Trace-Id: 0ad6d167235000f3b5648cbd63d761ce
    Loom-Build: unknown d0bfbbc7ac309581d7abe02c4a269c7704010ee0 clean
    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
2026-10-13 chore: resync installed Loom surfaces
    <!-- loom:provenance v1 build=unknown 7916c4043a1b57e97a53bc5c111e74c5038a1091 clean prompts=none sweep=none story=none trace=20b27ffb08c4130dc9836ee8d9d97b97 host=loom-worker-2 base=de73fffa9413cf002f4582900e99e81142393f1d run=loom-run/v1:timer:loom-worker-2/fleet-resync:d34532ec625a4162ae8b58dde1a6738f installs=0.19.1151 f7d1deaab02a9c483fce1ced33fadb1af6d86f59 -->
    Loom-Trace-Id: 20b27ffb08c4130dc9836ee8d9d97b97
    Loom-Build: unknown 7916c4043a1b57e97a53bc5c111e74c5038a1091 clean
    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
2026-10-13 chore: resync installed Loom surfaces
    <!-- loom:provenance v1 build=unknown ac0bbcf6eda99918e88a0b8893d9762b106a2e45 clean prompts=none sweep=none story=none trace=8597ab8a51d68f9f8ee864fa71904bff host=robb-studio base=b959633f3871ecf30e0b993b6a73e1dc5f17f1d1 run=loom-run/v1:timer:robb-studio/fleet-resync:2ea9dd71-a6b2-4d0c-86aa-859a0728c9b3 installs=0.19.1151 f7d1deaab02a9c483fce1ced33fadb1af6d86f59 -->
    Loom-Trace-Id: 8597ab8a51d68f9f8ee864fa71904bff
    Loom-Build: unknown ac0bbcf6eda99918e88a0b8893d9762b106a2e45 clean
    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
2026-10-13 chore: resync installed Loom surfaces
    <!-- loom:provenance v1 build=unknown 7916c4043a1b57e97a53bc5c111e74c5038a1091 clean prompts=none sweep=none story=none trace=a48d70df8e7252b46c71b88e90ebed02 host=loom-worker-3 base=3c392a946533312d4490b1c9fc1e20b06fbcb839 run=loom-run/v1:timer:loom-worker-3/fleet-resync:08e4e415b6434bf1ba0456ba59477467 installs=0.19.1151 f7d1deaab02a9c483fce1ced33fadb1af6d86f59 -->
    Loom-Trace-Id: a48d70df8e7252b46c71b88e90ebed02
    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
2026-10-13 chore: resync installed Loom surfaces
    <!-- loom:provenance v1 build=unknown 7916c4043a1b57e97a53bc5c111e74c5038a1091 clean prompts=none sweep=none story=none trace=773e9e41a5730d2f79f2381ad2cde068 host=robb-pro base=f274d5edadedab3fafa97303b09d0ee3a781ec4c run=loom-run/v1:timer:robb-pro/fleet-resync:b7ca0d34-434e-4536-85b9-57adfa603a8d installs=0.19.1151 a885af872d054695b81e8458dfc7bd717cbddba8 -->
    Loom-Trace-Id: 773e9e41a5730d2f79f2381ad2cde068
    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
2026-10-13 chore: resync installed Loom surfaces
    <!-- loom:provenance v1 build=unknown f57244868aa20ef22c18aa8025972184aaea43e4 clean prompts=none sweep=none story=none trace=8e03b78fe6cb43a017c4a4823362ffa7 host=loom-worker-2 base=d873e2738bcd4cc2f40cecf36f26faa9c1235414 run=loom-run/v1:timer:loom-worker-2/fleet-resync:eb553d2fc2a54589aa37879f12b18ed5 installs=0.19.1151 4b3b3e77e5ef42971b3c0c3e68c000736a0c7c21 -->
    Loom-Trace-Id: 8e03b78fe6cb43a017c4a4823362ffa7
    Loom-Build: unknown f57244868aa20ef22c18aa8025972184aaea43e4 clean
    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
2026-10-13 chore: resync installed Loom surfaces
    <!-- loom:provenance v1 build=unknown 9cd23bf22bf48ed3837f643ea76ec2e5f01ae46a clean prompts=none sweep=none story=none trace=ab3a71ce89f6ba9ad4c2753c3377bcf1 host=loom-worker-1 base=0e08f69331b3cc80278212292532e337c307b87a run=loom-run/v1:timer:loom-worker-1/fleet-resync:79a3b089c6f54c91bd32db3274e8133c installs=0.19.1151 a9d9bfc13e966655d6d847cb6876af523bc4a4c4 -->
    Loom-Trace-Id: ab3a71ce89f6ba9ad4c2753c3377bcf1
    Loom-Build: unknown 9cd23bf22bf48ed3837f643ea76ec2e5f01ae46a clean
    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
2026-10-13 chore: resync installed Loom surfaces
    <!-- loom:provenance v1 build=unknown 6fe43c87955e02019c2bc8dfad4fbd160b89170c clean prompts=none sweep=none story=none trace=49a4590bf54e81899c26d965f682504c host=robb-studio base=67246677939f8da9828d46e2885a8534bf2324d8 run=loom-run/v1:timer:robb-studio/fleet-resync:459197b3-0050-4335-893e-e47b638eb819 installs=0.19.1151 4ec7e046f71ff70b92c88ed647cff72d6a9d1e85 -->
    Loom-Trace-Id: 49a4590bf54e81899c26d965f682504c
    Loom-Build: unknown 6fe43c87955e02019c2bc8dfad4fbd160b89170c clean
    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
2026-10-13 chore: resync installed Loom surfaces
    <!-- loom:provenance v1 build=unknown 5dc3a07d084d0ec4034f0782d572925dcad86af7 clean prompts=none sweep=none story=none trace=cbc11657acadf58858409fe543c342e1 host=robb-pro base=65bda72fa64d7e2c0e0e3569d98e6219c678fe77 run=loom-run/v1:timer:robb-pro/fleet-resync:be586137-d91e-4e2c-82d6-3164d43aa9de installs=0.19.1152 2d5fe17958dca799058f16bdd74a12336990bec0 -->
    Loom-Trace-Id: cbc11657acadf58858409fe543c342e1
    Loom-Build: unknown 5dc3a07d084d0ec4034f0782d572925dcad86af7 clean
    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
2026-10-13 chore: resync installed Loom surfaces
    <!-- loom:provenance v1 build=unknown 27a266d5a27885323290840d2a837d73fcf4bcc6 clean prompts=none sweep=none story=none trace=e77cdd5477ef6bfc65fba6cc233788e0 host=loom-worker-2 base=f9328cb070616678fd47fc10fc6743a4de1e7c8d run=loom-run/v1:timer:loom-worker-2/fleet-resync:7fac7d82f298441a91761382ac989183 installs=0.19.1152 43f03f1fe0988c7870431d6bba187c13018b4420 -->
    Loom-Trace-Id: e77cdd5477ef6bfc65fba6cc233788e0
    Loom-Build: unknown 27a266d5a27885323290840d2a837d73fcf4bcc6 clean
    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
2026-10-13 chore: resync installed Loom surfaces
    <!-- loom:provenance v1 build=unknown f2b62a2cf576d7d37092147b2281da809f8b5cf5 clean prompts=none sweep=none story=none trace=8adfa75521c72dded43e2932febb6329 host=loom-worker-3 base=3f31949b55d141e42b5d9388230d5d93acfd4ed5 run=loom-run/v1:timer:loom-worker-3/fleet-resync:8a8198f8f80e4703bc7365a5e10595e0 installs=0.19.1152 8d16eec5f10d705602ac4d1ab871c57266f1aa45 -->
    Loom-Trace-Id: 8adfa75521c72dded43e2932febb6329
    Loom-Build: unknown f2b62a2cf576d7d37092147b2281da809f8b5cf5 clean
    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
2026-10-13 chore: resync installed Loom surfaces
    <!-- loom:provenance v1 build=unknown 84d11f248d368cae5e04a2255f6897a406c50089 clean prompts=none sweep=none story=none trace=8e50b4ccc3dc58f709a732f69d58fd44 host=robb-studio base=0e0000b35614eb81117533704a0a2bce7bf77285 run=loom-run/v1:timer:robb-studio/fleet-resync:05c9f3b1-eee2-412f-8996-5fbf02793d9e installs=0.19.1153 d8429a4fabdc955107af1cbc22c548e23eecf9b1 -->
    Loom-Trace-Id: 8e50b4ccc3dc58f709a732f69d58fd44
    Loom-Build: unknown 84d11f248d368cae5e04a2255f6897a406c50089 clean
    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
2026-10-15 feat(layout): draw VDD-side pd2nw clamp and Nwell tap on the pad-ring DVDD strap
    Complete DR-0011's DVDD/DVSS continuity for the pad-ring assembly. Each
    output pad gets a 20-finger diode_pd2nw_06v0 clamp in its own Nwell (anode on
    the pad net) plus an Nplus Nwell tap wired through Metal1/Metal2/via2 to the
    DVDD strap, labelled VDD. The LVS reference gains a VDD port and the pd2nw
    cards; the supply ERC keeps its VDD assertion and adds an nwell_vdd_tap tie
    with a VDD-side negative control. Via cuts are now the fixed 0.26 um square
    (via*.width.1), and the substrate-tap landing via coincides with the tap's own
    via instead of merging into a 0.26 x 0.51 um one.
    DRC, extract, LVS, ERC, the parasit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
2026-10-17 feat(signoff): artifact-anchored evidence for T1 items 1, 2, 9, 10 under a --attest-capable klt pin
    Bump the grading pin to klayout-tools 44cc4232 (adds artifact-anchored generic
    envelopes and klt signoff --attest), add versioned inventories and
    tool-produced envelopes for items 1, 9, 10 per partition, artifact-anchored
    GDS envelopes for item 2, cite all of them in the manifest, regenerate the
    record (8/22 -> 16/22), and gate drift in CI with --attest --check.
    Item 1 freshness in CI is a toolchain-free hash tripwire
    (signoff/derived_stamps.py); the digital rows were not regenerated.
    Regenerate design/netlist/cml_driver.spice under xschem 3.4.4 so it matches
    its schematic.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
2026-10-17 docs(spec): correct transposed fd_io pad pitch/depth in new DR-0019
    The gf180mcu_fd_io bi_t cell is 75 um along the ring and 350 um deep
    (LEF SIZE is x BY y), not the reverse. Record the corrected geometry,
    the revision/variant-dependent PAD landing, and the fallout for DR-0011's
    fit claims; append dated pointer notes to the survey and DR-0011.
2026-10-20 refactor: route flow git-provenance helpers through sim.harness.report
    working_tree_dirty gains an ignore pattern (default: evidence paths) and
    reads porcelain without trimming the first line's leading space, so the
    issue #100 fix now covers the sim copy too. flow/synth_tmds_encoder.py
    keeps thin record_id/_git/working_tree_dirty wrappers over it.
    Closes #239
2026-10-20 refactor: share DUT-translator CLI scaffolding in one helper module
    Hoist TranslationError, sha256 and the argparse/stale-check/write driver
    from gen_cml_driver_core_dut and gen_pad_ring_assembly_dut into
    layout/scripts/_dut_translator_cli.py. Both scripts keep their own
    translate() and re-export the names the tests use. Generated DUT
    fragments are unchanged.
    Closes #243
2026-10-20 refactor: share the append-only evidence-record tail across flow drivers
    Add synth.write_flow_record (mkdir, exists-refusal, sha/dirty lookup, write)
    and use it from all five flow/*_tmds_encoder.py drivers; RECORDS_DIR is now
    defined once.
    Part of the #95/#103/#112/#239 dedupe series. Closes #246.
2026-10-22 refactor: import shared pad-fold geometry from pad_pitch_fit_study
    gen_pad_ring_assembly.py now imports the fold constants and pure helpers
    (clamp_rows, _row_span, _row_pitch, _box) instead of carrying a copy.
    Per operator ruling on #242 (option a); the _draw_* near-copies and
    DR-0011 geometry are untouched. Generated GDS is byte-identical.
2026-10-27 refactor: share pad-ring drawing helpers between fit study and assembly
    Move the strap, substrate-tap and production-pad helpers, the fold
    arithmetic and their duplicated constants into pad_ring_cells.py. Both
    generators re-export them. Via-cut half-size stays a per-caller parameter
    (fit study 0.15, assembly 0.13) so the generated geometry is unchanged.
    Closes #262
2026-10-27 chore: pin klayout-tools to the 0.8.0 release and regenerate the signoff record
    CI installs klayout-tools==0.8.0 from PyPI and asserts klt --version.
    Re-attested items 1/9/10 and re-graded the manifest under 0.8.0; item 5
    (digital) now needs both sta and functional-verification evidence, so the
    already-committed zero-delay functional run is cited alongside the sta report.
    Closes #264
2026-10-27 chore(signoff): re-stamp synth driver and regenerate item 1 digital envelope after timing-constant refactor
    The synth driver moved in the behavior-preserving #266 refactor. Yosys was not
    re-run; the basis text says so. signoff.json re-grades byte-identical.
2026-10-28 docs: drop characterization.md lead-in so the item-8 envelope stays fresh
    The qualification lives in README.md; editing measurements/characterization.md
    staled signoff/characterization-envelope.json and the item-8 content_hash pin.
2026-10-28 docs: qualify digital T1 local row 6 against klt item 7 no_evidence
    Regenerate the item 8 envelope, manifest pin and signoff record; 17/22 and per-item statuses unchanged.
2026-10-29 refactor: draw gen_pad_v2 pad and clamp via shared _draw_production_pad
    Replaces the hand-copied finger/bus/via-stack/bond-pad drawing with a call to
    pad_ring_cells._draw_production_pad (n_fingers=20, via_half=0.15), dropping the
    duplicated geometry constants. Substrate tap and --shorted bridge stay local.
    Refs #277
2026-11-01 fix(signoff): regenerate item-10 envelope for edited ci.yml
    klt signoff --attest 10 (klayout-tools==0.8.0) re-run; only the ci.yml
    content_hash moved. Manifest pin unchanged (inventory hash is unchanged).
2026-11-14 feat(sim/harness): emit .options noinit from one shared options builder
    Both netlist-assembly paths now render their `.options` block from a single
    `runner._option_lines`, which appends `.options noinit` so ngspice stops
    printing its operating-point node table ("Initial Transient Solution", one
    line per node) into every per-corner log. On a post-layout-extracted DUT that
    is one line per parasitic node: 76.8 MB of the 92.7 MB of log bytes this repo
    has produced, a table nothing in the tree reads.
    Sharing the builder between `runner.compose_deck` (local) and
    `batch.compose_body` (batch) is what keeps the two backends from drifting
    apart on what a deck asks ngspice for; previously each spelled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
2026-11-14 sim: probe the VDD-side diode_pd2nw_06v0 clamp in esd-diode-clamp-cv
    The C-V testbench measured only the VSS-side diode_nd2ps_06v0 leg, so the
    VDD-side pd2nw clamp issue #210 drew onto each output pad had no measured
    junction capacitance and design/esd-capacitance-budget.md Sec.10.5a could
    only bound it.
    Add two pd2nw branches at the geometry the layout actually draws
    (area=40p pj=120u -- 20 fingers at A=2um^2 P=6um, per the `_draw_vdd_clamp`
    docstring in layout/scripts/gen_pad_ring_assembly.py and corroborated by 20
    `diode_pd2nw_06v0 A=2P P=6U` cards per pad net in the extracted
    gf180_tmds_pad_ring_assembly_shorted.spice), plus a DC-only `vdd` rail for
    their cathodes. The rail is an AC gro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
